snowyfox/Nibbles/wled/README.md

# Nibbles WLED integration

The shark's other lights run stock **WLED**, not a fork. Nibbles adds one
usermod, `usermod_nibbles/`, built into WLED through PlatformIO's
`custom_usermods` from this folder. It uses the same protocol library as the
eyes and base (`shared/nibbles_link`).

## What the usermod does
- **Turns ESP-NOW on** at startup (WLED defaults it off) and acts as the
  **channel anchor**: it broadcasts anchor heartbeats 4 times a second on
  whatever channel WLED is on (a phone hotspot at home, its own AP at a
  festival). The eyes and base scan until they hear one and move to the
  channel it advertises.
- Takes Nibbles **commands aimed at WLED** (`NL_TARGET_WLED`: preset set,
  next, previous; brightness set 0..255 or step by a signed amount) and acks
  them. A retry with the same id is acked but applied once.
  The ack goes out before the preset is applied. Which presets exist is cached
  from `/presets.json` (re-read when WLED saves presets), so next/previous skip
  gaps and wrap, and a missing preset is refused (status 2).
- Plays **bumps** (`NL_MSG_BUMP`, broadcast): flash (all segments solid white),
  blackout, or a preset, held while the sender keeps sending HOLD every 100 ms.
  On STOP, or 300 ms without a message, it restores the state (and current
  preset) saved at the start. A new bump replaces the one playing and keeps the
  original saved state. Preset and brightness commands that arrive during a bump
  are applied when it ends (instead of the saved preset), so the release
  doesn't undo them (verified: preset and brightness sent mid-flash took effect
  on release). With the 2D map, flash and blackout use the bump slot instead
  (see "Layer slots"): nothing is saved, and preset commands apply at once.
- Broadcasts **WLED telemetry** twice a second (on, brightness, preset and its
  name, effect, palette, channel, fps, LED count). Preset names come from the
  same cached read of `/presets.json` as the preset list.
- Shows the radio status and the **eyes' telemetry on WLED's Info page**.
- Leaves other ESP-NOW traffic (e.g. WiZ remotes) to WLED.
- With the `audio` setting on, publishes **AudioReactive's analysis** of the
  controller's mic as Nibbles audio features every 32 ms (`nl_ar_update`), for
  eyes built with `EYES_AUDIO_FROM_WLED 1`. The Info page shows whether it is
  sending. Untested on real music so far.
- **Mirrors the lights to the simulator** (`tools/sim`) on request: a JSON
  state post `{"nibbles":{"mirror":{"ip":"a.b.c.d","port":4050,"s":6}}}`
  starts it for `s` seconds (at most 30; `s: 0` stops it), and `server.py`
  renews it every 2 s while the page shows the live shark. Each shown frame
  goes to `ip:port` as DDP (gamma and brightness applied; the current
  limiter's extra dimming is not), at most 50 a second, and a small JSON
  packet to `port + 1` with WLED's brightness and preset, the audio features
  it last sent the eyes, and the eyes' telemetry. It works even with the
  usermod disabled, and costs nothing when not asked for. Bench-tested on
  the WT32 build: identical to the bench's own network LED output, 44
  frames/s, WLED's frame rate unchanged (43 fps), 10-minute soak clean. On
  the real controller since 2026-09-26 (42 frames/s to the simulator).
- **Battery-aware current limit**: the base broadcasts the pack voltage at the
  pole base (`NL_MSG_BATTERY`, from an INA226 there), and WLED's global
  current limit follows it (`nl_power_limit_ma`): the most power that keeps
  the 5 V converter's input above `floor_mv` (11.2 V) after the pack's sag
  and the pole wiring's drop (`pack_mohm` 100, `wire_mohm` 200, estimates to
  replace with measurements). A lower limit applies at once, a higher one
  rises at 2 A/s; without new readings the last limit holds. The ceiling is
  the usermod's `power_max_ma` (17000), which takes over WLED's own limit
  field while `power` is on; until the first reading the limit is that
  ceiling. Test readings: `{"nibbles":{"battery":{"mv":13000,"ma":7700}}}`
  (`"mv":0` forgets). The Info page shows "Nibbles power". Bench-tested
  (2026-10-02): 14.0 V -> 17000 mA, 13.0 V -> 12096, 12.5 V -> 8735 at once,
  back to 14.0 V in ~5 s; on the bench board (network output only) WLED's
  limiter doesn't dim, so the dimming itself is untested.
- **2D map partners**: with the shark's 2D map (below) it copies each partner
  LED's colour from the LED it pairs with after every frame (the `"copy"`
  list in `/ledmap.json`). The Info page shows how many ("Nibbles 2D map").
- **Fin following on/off**: `NL_OP_FIN_FOLLOW` (the base's FINS switch on its
  preset page, or `fins on|off|toggle` on its serial port; also
  `{"nibbles":{"finfollow":false}}`) switches it off: the fins then stay at
  their modelled angle, ignoring the sensor and any sweep. Saved in WLED's
  config (`fin_follow`). WLED broadcasts `NL_MSG_FIN_STATE` twice a second
  (on/off, the angle in use per fin and where it comes from) for the base.
- **Fins that follow their real angle** (2D): with a fin sensor node sending
  the fin's hinge angle (`NL_MSG_FIN_POSE`, `firmware/fins`), each of that
  fin's LEDs shows the side view's colour at the spot it is really over, so
  a wave across the body sweeps over the fin wherever it points. The fin
  geometry (rest positions, hinge lines, the grid's scale) is the `"fingeo"`
  list in `/ledmap.json`; a fin without a live angle keeps its partner copy.
  On the shark since 2026-10-21 (port fin): 112 of 114 port fin LEDs showed
  exactly the colour of the cell they were over.
- **Streamed pictures** (since 2026-10-23): while this WLED shows another
  WLED's stream instead of its own effects (WLED's realtime mode: DDP,
  E1.31, Art-Net), it times the gaps between incoming packets
  (`nl_stream_gaps`): "slow" gaps of 50 ms or more, "stalls" of 100 ms or
  more, and the longest, over the last minute, plus stalls since boot. A gap
  of 2 s or more is the stream restarting and isn't counted. Shown on the
  Info page ("Nibbles stream") and broadcast once a second
  (`NL_MSG_WLED_STREAM`); the base's WLED card then says "Streamed", where
  from, and the stalls per minute. See "Main board and display" below.
- **ES7210 mic** (builds with `NIBBLES_ES7210`, the 3.49 dev node): sets up
  the board's ES7210 mic chip over I2C (SDA 47, SCL 48) once AudioReactive's
  I2S clocks run, so AudioReactive can use the board's own mic as "Generic
  I2S with MCLK" (SD 6, WS 46, SCK 15, MCLK 7). Mics 1 and 2 at 30 dB; the
  board's mic is input 1, the left channel, so that build also sets
  `I2S_USE_RIGHT_CHANNEL`, which undoes AudioReactive's IDF 4.4 channel-swap
  work-around (meant for the classic ESP32; on the S3 it made AudioReactive
  read the empty input). The Info page shows "Nibbles mic (ES7210)". Checked
  by tapping the board: the level rose from 4-14% to 40-72% with automatic
  gain off. The level from music is low (about 10% before the automatic
  gain); squelch 3 and AGC "vivid" work.
- **Wire link** (`wire_pin`, `wire_baud`): the brain sends every LED down a
  UART wire to the controller, which shows it like a stream; see "Wire link"
  under "Main board and display".
- **Preview stream** (`preview`, default off; `preview_fps`, default 12; or
  state `{"nibbles":{"preview":true}}` until the next reboot): broadcasts the
  LEDs as RGB332 before master brightness for `firmware/preview`
  (`NL_MSG_PREVIEW`, 5 packets a frame for 1064 LEDs, one packet per loop).
  WLED's ESP-IDF only sends 250-byte ESP-NOW packets, so `NL_MAX_PAYLOAD` is now
  232. Tested 2026-11-01 on the bench brain: it stays at 43 fps. Most frames
  were lost there, but the brain was hopping channels looking for the
  controller's network (seen on 1-14 within a minute); not yet measured on a
  stable channel.
- Settings (WLED Usermods page, `Nibbles`): `enabled`, `anchor`, `audio`
  (default off), `wire_pin` (default -1, off), `wire_baud` (default 2000000),
  `preview` and `preview_fps`.

## 2D map
`wled/ledmap/ledmap.json` (made by `tools/sim/make_ledmap.py` from the
simulator's layout; preview in `ledmap_preview.svg`) makes WLED treat the
shark as a 68 x 33 matrix (cells of 11.3 mm; a 55 x 33 side view plus the fin
panel), seen from starboard with the nose to the right, for WLED's 2D effects.
It was 95 x 41 (8.9 mm cells) until 2026-10-29; the coarser grid makes every
effect and segment layer about 1.5x cheaper (`wled/bench/README.md`). Seen from the side, LEDs overlap: the two strips back to
back in the main tube, and the two fins. So only the outward strip (channel 1)
and the starboard fin (channel 5) are mapped where they are (90% within 1.7
cells of their real spot); the inward strip and the port fin sit in spare
cells nearby, and the usermod copies each one's colour from its partner, so
both sides match. The fins stick out sideways, so from the side each is a compact patch.

To use it: upload the file as `/ledmap.json` (WLED's file editor, or
`curl -F "data=@wled/ledmap/ledmap.json;filename=/ledmap.json" http://IP/upload`)
and reboot. **WLED then runs as a 2D matrix for every preset**: 1D presets
(segments by strip position) need redoing for 2D; a 2D segment covering the
body is `{"start":0,"stop":55,"startY":0,"stopY":33}` (the bottom five rows
are where a fin swung down reaches). On 2026-10-29 every 2D preset was
converted from the 95 x 41 grid (body 0-70 x 0-41 to 0-55 x 0-33, fin panel
70-95 x 0-34 to 55-68 x 0-18; backup in `wled/backup/`), and the one-segment
body presets now also remove segments 2-8, so layers left by another preset
don't stay on under them (segment 1, the fins, is left alone).
WLED keeps `presets.json` in memory and, with no clock (NTP off), may not
notice an uploaded file: restart it after uploading presets. Then reload
WLED's web page in every browser that has it open: clicking a preset there
sends the preset's whole content from the page's own copy (kept in the
browser's local storage), so a stale page keeps applying the old presets. Delete the
file and reboot to go back.

Bench (2026-09-26, same firmware and map): the partner copies match exactly
(0 of 531 differ), the eye rings stay dark; most 2D effects run at 43 fps
(Octopus, Noise2D, Waverly, Black Hole), Plasma Ball 40, Distortion Waves 24;
the matrix costs 4-9 KB of RAM. **On the shark's controller since
2026-09-26** (with the lean build): 42 fps, 83 KB free; while the simulator
mirrors it, 33 fps and 25-30 frames/s to the simulator. Its 1D presets don't
work in 2D (see above); to go back to 1D, follow
`wled/backup/20260926-1850-pre-2d/REVERT.md` (delete `/ledmap.json`, reboot;
tested on the bench).

## Fin presets (2026-10-28; tested on the bench as main board)

The fins can run their own effect while the body keeps its preset. The map
(`tools/sim/make_ledmap.py`) has a **fin panel**, 13 x 18 cells of 20 mm, to
the right of the side view (columns 55-67). The body's segment stays on
columns 0-54. (Until 2026-10-29: 25 x 34 cells of 10 mm at columns 70-94.)

- **The panel's first cell is mapped to a real LED** (LED 863 on the 68 x 33
  map, 866 on the old one; its own
  cell comes much later, so it always shows its own colour). WLED works out
  what a segment can do from the LEDs under it: a segment over no LEDs at
  all is on/off only, ignores palettes and draws most effects black (seen
  2026-10-28: Plasma black, `"lc":0`, palette stuck at 0). With the
  anchor, the fin segment shows `"lc":1` and keeps its palette.
- **Body presets should use only segment 0.** Presets 3 and 5 are older
  multi-segment presets from the 1D controller (segments 1-4 are stretches
  of the strip); they barely light the fins, and "follow the body" (80,
  which removes segment 1) takes part of their body away.

- **Fin presets** are WLED presets **81-96** (fin preset 1-16 on the
  base's keypad; `NL_FIN_PRESET_BASE` in `shared/nibbles_link`). Each one
  is a segment on the fin panel, saved with **only that segment checked**
  ("Checked segments only" in WLED's save dialog, segment bounds on,
  brightness off), so it leaves the body alone. Bounds:
  `{"id":1,"start":55,"stop":68,"startY":0,"stopY":18}`.
- **Preset 80** = the fins follow the body: a preset that only switches
  that segment off (`{"seg":[{"id":1,"stop":0}]}`).
- **Body presets** saved the normal way (all segments) switch the fin
  segment off, so they put the fins back to following the body; save them
  with only the body segment checked to keep the fins' preset.
- **Projection**, per fin preset: add `"nibbles":{"finproj":"side"}` or
  `"top"` to the preset's JSON (WLED's preset editor, API mode).
  - **Side:** the panel is the fins seen from starboard, like the side
    view; at equal angles both fins land on the same cells.
  - **Top:** seen from above, nose to the right, port in the upper half and
    starboard in the lower.

  Either way each fin LED's spot moves with the fin's hinge angle (or sits
  at the modelled angle while FIN SENSOR has it locked).
- **The usermod:**
  - reports the body's preset in its telemetry and the fins' in
    `NL_MSG_FIN_STATE` (`fin_preset`, `fin_proj`);
  - runs fin bumps (`NL_TARGET_FINS`) beside body bumps;
  - puts the fins' preset back after a body bump;
  - queues its own preset applies (WLED keeps only one waiting).
- **Where:** on the main board (see "Main board and display"); the display
  stays 1D.

## Layer slots (2026-10-29; tested on the bench as main board)

WLED 16 stacks segments that overlap: each one is blended over the ones with
lower numbers (blend mode `bm`, opacity `bri`). The usermod uses five fixed
segments as layers:

| Slot = segment | Name | Covers | Default blend |
|---|---|---|---|
| 0 | body | the side view (0-55 x 0-33) | top |
| 1 | fins | the fin panel (fin presets) | top |
| 2 | body+ | the side view | screen |
| 3 | fins+ | the fin panel | screen |
| 4 | bump | the whole grid | add (flash and blackout set top) |

Set one with `{"nibbles":{"slot":{...}}}` in a JSON state request (or a list of
them):

- `"id"`: the slot.
- `"look"`: a preset's effect, speed, sliders, palette and colours (its
  main segment) go into the slot. Its position, blend and on/off don't.
- `"fx"`, `"pal"`, `"col"`, `"sx"`, `"ix"`, `"c1"`-`"c3"`, `"o1"`-`"o3"`:
  set directly. These go on top of a `look` in the same request.
- `"bm"` blend mode, `"o"` opacity (1-255), `"tt"` transition (ms),
  `"on"`. Setting a look or effect switches the slot on unless `"on":false`
  says otherwise.
- **A slot that's off is frozen**, so it costs nothing. `"warm":true` keeps
  its effect running while it's off: it then shows at once, already in
  motion, but costs a full render every frame (`wled/bench/README.md`).

Asking for a slot creates any missing slots below it, off and frozen, so slot
n is always segment n. The state reports the slots as
`"nibbles":{"slots":[...]}` (on, effect, palette, blend, opacity, the preset
whose look it took). The Info page shows them under "Nibbles layers", with
the outcome of the last request.

**Presets and slots:**
- A full preset is a scene: it sets the whole stack.
- The one-segment body presets switch slots 2-8 off and leave the fins
  (slot 1) alone, as fin presets need.
- Old 1D presets with several segments use segments 1-7 for stretches of
  the strip, so slots don't fit on top of them.
- Slot changes made by request count as manual changes, so WLED shows no
  current preset after one.

**From the base** (radio, `shared/nibbles_link`):
- **Commands:** `NL_OP_SLOT_LOOK` (`nl_slot_arg(slot, preset)`; preset 0
  switches the slot off) and `NL_OP_SLOT_PALETTE` (`nl_slot_arg(slot,
  palette)`).
- **Bumps:** `NL_BUMP_PALETTE` and `NL_BUMP_LAYER` show a palette or a layer
  look while held. On release the slot goes back exactly as it was: every
  look field, the blend, opacity, on/off, and the look's preset number.
  - Body slots use `NL_TARGET_WLED` bumps, the fin slots `NL_TARGET_FINS`,
    so the two can be held together.
  - A slot command for a slot that a bump holds becomes what the slot goes
    back to. That's how the base's LATCH keeps one: it sends the command,
    then lets the bump go.
  - If a body preset lands during a palette or layer bump, the slot goes
    back to that preset's version instead.
  - `NL_BUMP_SCENE` (2026-10-30; the base's TAKE preview of a Standby with
    a palette or layer look cued): a preset, a palette and a layer look
    together. `arg = nl_scene_arg(preset, layer)` (preset 0 leaves it;
    layer 1-16 a layer look, `NL_SCENE_LAYER_OFF` off), `intensity` =
    palette + 1 (0 leaves it). On `NL_TARGET_WLED` it's the body: saved like
    a preset bump (plus the overlay slot, which a state restore wouldn't
    remove), the preset, then slot 0's palette and slot 2's look. On
    `NL_TARGET_FINS` it's the fins: slots 1 and 3 captured, the fin preset
    (as a preset), then their palette and look; both slots put back
    exactly. Commands during it (LATCH) are what it ends on.
  - Slot requests wait while a preset is queued or still landing, so a
    preset never wipes a palette or layer look sent after it.
- **Report:** `NL_MSG_WLED_LAYERS` reports every slot twice a second (on,
  look, effect, palette, blend, opacity). The mirror to the simulator
  carries the same as `"slots"`.
- **Layer looks** are WLED presets 101-116 (`NL_LAYER_PRESET_BASE` + n).
  Each is saved as one segment, id 2, with `"mainseg":2`. Its effect,
  sliders, palette and colours are the look. The bench has 101-108 (Twinkle,
  Sparkle, Fireworks, Crazy Bees, Lissajous, Drift Rose, Black Hole,
  Lightning): effects that are cheap and start at once (`wled/bench/`),
  each with its default sliders, white on black, blend screen.

**Bumps:**
- **Flash and blackout** use the bump slot: Solid white (or black) on top.
  A flash also raises WLED's master brightness to its intensity while
  held.
- Nothing is saved or restored, and commands during them apply at once. A
  brightness command during a flash takes effect when it ends.
- If a body preset lands during the bump, the bump slot comes straight back.
- **Preset bumps** still save and restore the whole state, as before.
- **Keys swapped quickly** (fixed 2026-11-09, on both brains, bench-tested):
  ending a bump could leave its look behind, as if LATCH had been pressed.
  - A preset bump's preset waits in the usermod's preset queue, and WLED
    applies a preset a loop after it's asked. If the bump ended first, the
    preset landed over the restore. Bump presets are now tagged in the
    queue and dropped when the bump ends. If one is already on its way, the
    restore is applied again once it has landed.
  - A palette or layer bump that replaced another on the same slot captured
    the slot while it still showed the old bump, because the old bump's
    restore was still queued. It now takes over that queued restore instead.
  - A preset bump replacing a palette or layer bump applies that bump's
    queued restore before it saves the state. The same now goes for a flash
    or blackout: holding FLASH, pressing a number, letting go of FLASH and
    then the number left the flash (or blackout) on, because the number's
    snapshot still held it. A flash that ends before it showed is also
    dropped from the slot queue.
  - Bench test (shark off, brains on USB): keys sent through the MIDI
    bridge's `/api/key`, each brain's state read back over its serial
    port with `{"v":true}`, and compared before and after each sequence.
    Fixed overlaps at 250, 100 and 40 ms plus 30 random sequences of 24
    presses over numbers, palettes, layers, flash and blackout: 51 of 51
    came back to the starting state. Opening a brain's USB serial port
    restarts it, so hold the ports open for the whole run.
  - The base's key logic was checked with 5,000 random overlapping key
    sequences (`test_overlapping_keys_never_latch`): it always ends every
    bump and never latches.

## Eye settings in presets (2026-10-28; the usermod part not yet built or tested)

A WLED preset can carry the eyes' settings, so the preset is the one place a
whole look is defined. Add to the preset's JSON (WLED's preset editor, API
mode) either:

- **Level 1**, pick the eyes' own settings:
  `"nibbles":{"eyes":{"preset":5,"react":"beats","auto":false}}`
  - `preset` is 1-based; `react` is `preset`, `beats` or `peaks`.
  - The usermod sends them to the leader eye as commands.
- **Level 2**, the whole eye look:
  `"nibbles":{"eyes":{"look":{"name":"Inferno","palette":[[140,0,0],...],"rings":7,...}}}`
  - The look carries every setting of an eye preset: palette, rings, bands,
    glow, flow, pupil, ripples and spiral.
  - `make -C firmware/eyes/test/host looks` prints all 18 built-in eye
    presets in this form, ready to paste and edit.
  - The usermod broadcasts the look (`NL_MSG_EYE_LOOK`, three times). The
    leader eye shows it behind its usual swap blink and passes it to the port
    eye over the cable.
  - Looks fill two slots after the built-in presets (indices 18 and 19,
    alternating), so the base sees eye presets 19 and 20 with the look's
    name.
  - Spirals snap to the nearest built-in spiral shape (3 or 5 arms), whose
    maps are built at boot.
- `react` and `auto` can go with either level.

When the eye settings apply:
- **Apply:** a preset applied from WLED's own UI, or from the base with
  **ALL** + number (the whole shark).
- **Skipped:**
  - **BODY** + number (the base sends `NL_PRESET_NO_EYES`);
  - bump presets, which the base bumps on the eyes separately;
  - fin presets.

## Main board and display (the plan since 2026-10-28; first tested 2026-10-23)
The controller (a classic ESP32 without PSRAM) renders the 2D map at only
~38 fps with ~70 KB free. So a faster **main board** renders everything and
streams every LED (DDP, physical LED order) to the controller, which only
displays them. **The main board is the brain**: everything Nibbles-specific
runs there; the controller is a display.

- **Main board** (first the bench 3.49: MAC 80:45:6b:35:d0:14,
  `nibbles_dev_s3_349`, at 4.3.2.2 on the controller's network; since
  2026-11-02 that board is the base, its WLED flash saved in
  `wled/backup/20261102-bench349-pre-base/`, and the brains do this job):
  - the shark's config and presets, the 2D map with the fin panel, fin
    presets, and the presets' eye settings;
  - one network LED output of 1064 LEDs (DDP) to 4.3.2.1;
  - its own mic (ES7210 above);
  - the Nibbles usermod **on**, in its normal role: it anchors the radio
    and talks to the base, the eyes and the fin node; telemetry, commands,
    bumps, fin following, fin presets, eye looks, and the simulator mirror.
- **Display** (the real controller, 4.3.2.1, its own AP "Nibbles"):
  - no `/ledmap.json` (1D). WLED writes incoming realtime pixels into its
    frame buffer by cell and then through its own ledmap, so with a ledmap
    the stream comes out scrambled.
  - The usermod has **`display` on** (`{"um":{"Nibbles":{"display":true}}}`):
    it only listens for the base's battery readings, so the battery-aware
    current limit protects the LEDs it drives. It reports how steadily the
    stream arrives (`NL_MSG_WLED_STREAM`, and its Info page). No anchoring,
    telemetry, commands or bumps, so the base sees one WLED, the main board.
  - It falls back to its own effects 2.5 s after the stream stops (WLED's
    realtime timeout).
- **Brightness:** the base and the eyes follow the main board's
  brightness, which is applied before the stream. The display stays at its
  own brightness, with the current limit on top.
- **The base:** its WLED card shows the main board's preset. While the
  display reports a stream, the card's second line shows its stalls per
  minute and longest gap.
- **The simulator:** mirror the main board (4.3.2.2), which has the whole
  picture and the usermod's state.
- **Tested 2026-10-28:** with the bench as main board and the controller as
  display, the base's keys work end to end (fin presets, LATCH, ALL bumps,
  FLASH) and the display streams with 0 stalls a minute.
- **Back to the single board:** set `display` off on the controller, put its
  ledmap back, and stop the main board's stream.
  Backups: `wled/backup/20261028-pre-display-role/`.

Measured: the main renders the controller's preset 33 at 124 fps uncapped
(vs 38), with 194 KB free plus 8 MB PSRAM; the display shows 50-55 fps at a
50 fps cap, with 94 KB free (no ledmap). Over the home Wi-Fi (main -> router
-> controller, two hops): every frame arrived complete, but about 3 stalls
a minute of 100-200 ms, which the user saw as freezes. On the shark's own
network (the controller's AP "Nibbles", channel 1, the main joined to it,
one hop): the user noticed no stutter; the stall counter above gives the
numbers. A wired link (both boards in one box, a short Ethernet cable) would
take the stream off the air entirely; the main board then needs Ethernet
that WLED supports (classic ESP32 with RMII, e.g. Olimex ESP32-POE-ISO-WROVER;
WLED 16 has no W5500 support, so not the ESP32-S3-ETH).

Access point notes:
- The controller's AP is "Nibbles" with WLED's default password `wled1234`
  (to change before a festival). AP only: `ap.behav` 2 (always) and the
  Wi-Fi network set to "Your_Network", WLED's "none" (an empty name is
  ignored). Clients get 4.3.2.2 upwards in join order.
- WLED's captive portal makes phones and Macs treat the AP as a login
  network; choose "use without internet" to stay joined.
- OTA updates over the AP need `ota.same-subnet` off (set on the controller):
  with it on, WLED compares the client with its station address, which is
  empty in AP-only mode, and refuses ("Client is not on local subnet").
  Off, it still only accepts private networks, its AP included.
- Backups and how to go back: `wled/backup/20261023-2153-pre-main-stream/`
  (REVERT.md: ledmap back), `20261023-2323-pre-ap-test/` (both boards'
  Wi-Fi), `20261023-*-pre-stream-gaps/` (before the stall counter build).

### A/B brains (built 2026-11-01; running on real boards the same day)
Two brains each send the controller a full picture; TAKE on the keypad switches
which reaches the LEDs. Settings (`{"um":{"Nibbles":{...}}}`):

Tested on the bench over real wires, with no pull-ups fitted as far as known and
no LEDs confirmed attached: both wires 42-44 fps at once, take, hold, a 1.5 s fade
(accepted; not seen on LEDs), failover when the Live brain stopped (survivor still
42-44 fps), and the stopped brain rejoining as Standby. Lost-frame and CRC counts
(controller Info page): none new in a 9-minute soak, no LEDs attached as far as known.
Both brains send the preview (`NL_MSG_PREVIEW`, 12 fps), whatever `preview` says; the base
sorts them by role into its Live and Standby sharks.

| Board | Settings |
|---|---|
| Controller (`nibbles_shark`) | `display` on, `wire_pin` Right Brain's wire, `wire_pin_b` Left Brain's: 35 (H3) and 34 (H2) as now wired, which must match each brain's `ab_side`; the mic stays on H1 |
| Right Brain (`nibbles_brain_s3`) | `wire_pin` its TX pin, `ab_side` 0 |
| Left Brain (`nibbles_brain_s3`) | `wire_pin` its TX pin, `ab_side` 1 |

- **Wiring:** each brain's TX and a GND to the controller. Never 3.3 V or 5 V between
  boards. GPIO 34 and 35 are input only with no internal pull-up: each needs its own
  10 kOhm pull-up to the Bong69's 3.3 V (H1 has it). Pin order on H2 and H3 isn't
  documented, so measure before connecting; H4 carries 5 V.
- **The presets must match on both brains**, by number: copy `presets.json`, the
  ledmap and the settings across.
- **On the Info page:** "Nibbles wire" shows both wires, which brain is Live, takes and
  failovers on the controller, and "Right Brain, Live" or similar on a brain.
- **Testing without the base:** `{"nibbles":{"abtake":0}}` (a value in ms is a
  crossfade) and `{"nibbles":{"abhold":true}}` to the controller's `/json/state`.
  From the base's USB serial: `ab`, `ab take [MS]`, `ab hold on|off`.
- **Not carried across yet:**
  - eye settings in a preset on the Standby brain (the base sends it with
    `NL_PRESET_NO_EYES`; Standby's eye preset still changes with TAKE);
  - nothing else for now; audio is below.
- **Audio:** the controller's mic on H1 feeds both brains through AudioReactive's sound
  sync over the `Nibbles` Wi-Fi: `um.AudioReactive.sync.mode` 1 (send) on the controller,
  2 (receive) on each brain. The controller's usermod makes its access point lwIP's default
  route (`apDefaultRoute`), or the multicast goes nowhere. Both brains report "receiving";
  delay and reaction to music aren't measured yet.
- **Relay (built 2026-11-01):** each brain passes what the controller needs down its wire,
  between the picture's chunks (`nl_relay_*`): battery readings, A/B bumps, and takes, which
  the base now sends to the Live brain (then Standby, then the controller's own radio) as
  "make that brain Live" (`NL_OP_AB_TAKE_A`/`_B`), so a second route can't undo the first.
  The brain's ack means "on its way"; the result shows in `NL_MSG_AB`. The controller's
  `radio_off` setting ignores its radio input and only takes these. Its radio still sends
  `NL_MSG_AB` and the Wi-Fi network; turning those off needs a wire back to the brains.
- **Return wire (built 2026-11-02):** one wire from the controller's GPIO 17 (H1, freed by
  moving the mic's SD to GPIO 39: `digitalmic.pin` `[39, 32, 33, -1]`) to GPIO 14 on both
  brains, setting `ret_pin` (17 on the controller, 14 on each brain; GPIO 10 until 2026-11-09).
  It runs on the UART of the controller's first input, at the same baud, in the relay
  framing with the controller's MAC: `NL_MSG_AB` (2 Hz and on a change) and
  `NL_MSG_AR_SYNC` every 20 ms, AudioReactive's own v2 sync packet built from its
  analysis. A brain hands that to its own AudioReactive on 127.0.0.1:11988, so its sync
  mode stays 2 (receive). The controller's sync mode must stay 1 (send): in any other mode
  AudioReactive stops listening while the wires drive the LEDs. A `ret_pin` that can't
  start (pin taken, or wire A down) is not retried until the setting changes.
- **Changing settings with `/json/cfg`:** send the whole `um.Nibbles` block too. A POST with
  `um` but no `Nibbles` resets every Nibbles setting to its default, live and on flash.
- **With one brain** leave `wire_pin_b` at -1 and `ab_side` at -1: exactly as before.
- A controller reboot starts with Right Brain Live.
- **Controller radio off, Right Brain hosts `Nibbles` (built and tested 2026-11-02):**
  - **Controller** `wifi_off`: at boot the usermod hides its network to join (in RAM; the
    saved settings keep `Nibbles` and its password) and ESP-NOW stays off, and its own
    access point is "button only" (`ap.behav` 3; the Bong69 has no button), so after WLED's
    ~2 s boot scan the radio never starts. Everything comes through the wires. The base's
    `wled wifi on` (USB serial only), a brain's `{"nibbles":{"ctlwifi":true}}`, or the buttons
    on a brain's Info page send `NL_OP_CTL_WIFI` down a brain's wire: the controller joins
    `Nibbles` (web page, OTA) until it restarts or gets `wled wifi off`. Tested: it joined at
    4.3.2.3 with both wires running, and left again.
  - **Right Brain** hosts `Nibbles` on channel 1 (no network to join, `ap.behav` 2, the network's
    name and password as its access point) and anchors the channel.
  - **Left Brain** joins it; its own access point is `Nibbles` on channel 1 too, `ap.behav` 3, and
    `net_fallback` on: after 6 s without the network it hosts `Nibbles` itself (rather than
    search every channel), and joins again once it hears A's anchor heartbeat (at least
    10 s later). A brain sends the anchor flag only when joined or hosting, never while
    searching. Tested by pausing A: the controller failed over at once, B hosted after
    6 s, the base was off channel 1 for about 10 s in between, and B rejoined A within 10 s
    of A's restart, with A back as Standby.
  - **The brains rebroadcast `NL_MSG_AB`** from the return wire, so the base sees the switch
    without the controller's radio. TAKE, hold and fade tested this way.
  - While B hosts, its WLED settings show no network to join: don't save its Wi-Fi settings
    then.
  - **Network moves** (2026-11-09, on both brains, bench-tested): the base's survey page
    broadcasts `NL_HOP_MOVE` (channel, moment). At that moment the host (no network to join,
    or B standing in) sets `apChannel` and reconnects, so its access point and ESP-NOW restart
    on the new channel; a joined brain sets `apChannel` too and reconnects 1.5 s later. The
    channel is saved (B saves it only once its network to join is back in the settings), and
    for 20 s B doesn't stand in as host. Phones on `Nibbles` drop and rejoin.
    Bench: 1 -> 6 -> 1 with both brains and the base; A hosted on the new channel 1.1 s after
    the tap, the base kept hearing WLED throughout, B (restarted just before by its USB port
    opening, so it missed the hop) found A on the new channel by itself within 5 s.

### Wire link (built 2026-10-30; sending tested, receiving not yet)
The plan (`docs/architecture.md`, "Two brains and the Standby preview") puts
the brains in the controller's box on top of the pole, each wired to the
controller, so the picture never crosses the air.

- **Brain:** set `wire_pin` to its TX pin (`{"um":{"Nibbles":{"wire_pin":13}}}`
  on a `nibbles_brain_s3` board). Every frame WLED shows, the usermod sends
  what its **network LED output** would send (that output's buffer, at the
  brightness it applies) out of the pin, in `nl_pix_*` chunks (256 LEDs each,
  COBS + CRC-16; `shared/nibbles_link`), at 2 Mbaud. 1064 LEDs is 3,257 bytes
  a frame, 16 ms on the wire, so up to ~60 fps. While nothing new is shown
  (off, frozen) it resends every 200 ms, so the controller doesn't time out.
  The network output stays configured (it defines the LEDs): point it at
  `0.0.0.0` to send nothing over Wi-Fi (WLED skips the send), or leave it on
  the controller as a Wi-Fi backup (both arrive; the controller shows
  whichever came last, the same picture).
- **Controller:** with `display` on, `wire_pin` is its RX pin: GPIO 34 on the
  Bong69's H2 (input only, so a 10 kOhm pull-up to its 3.3 V;
  no internal pull-up). Chunks go into WLED's realtime path like DDP
  (`realtimeLock`, `setRealtimePixel`, shown on the last chunk), so the
  realtime timeout, the current limiter and the stall counter keep working.
  A corrupt chunk only costs its own LEDs for one frame.
- **Wiring:** data and GND only, never 3.3 V or 5 V between the boards.
- **Info page** ("Nibbles wire"): on the brain, fps, LEDs and the time
  sending takes; on the controller, fps and, since boot, frames, lost frames,
  partial frames, CRC errors and bad chunks.
- **Measured** on the bench brain (3.49, sending on GPIO 2, 1064 LEDs):
  - **Cost:** 1.0 ms a frame (0.3 gathering, 0.6 encoding, 0.15 handing to
    the UART driver). The frame rate stayed at 43 at the 42 cap, and the
    heavy DreamState Clouds went from 24 to 23 fps. With the bitwise CRC it
    was 1.8 ms, so `nl_crc16` now uses a table (same values; the eyes and base
    use it too).
  - **Receiving:** a temporary loopback test, with a second UART on the brain
    listening on the same pin. With the UART driver's default (an interrupt
    when the 128-byte FIFO holds 120 bytes, 40 us before it overflows at
    2 Mbaud), about 1 chunk in 1500 was lost to Wi-Fi interrupt delays. With
    the receiver emptying it from 32 bytes: 0 lost, partial or corrupt in
    7,200 frames, also at 22 fps on a heavy preset. The receiver uses 32.
  - **Not yet tested:** the controller (classic ESP32) receiving over a real
    wire. Needs a brain board with reachable pins (the DevKits are ordered).

## Lean build
`nibbles_shark` leaves out features the shark doesn't use: Ethernet (it runs
on Wi-Fi; Ethernet was already off in its config), Alexa, Hue sync, MQTT,
infrared, Loxone and the Pixel Forge tool. That saves 82 KB of program space
(1.25 MB of the 1.5 MB app slot used, ~318 KB free) but only ~1.3 KB of static
RAM and 1.5-3 KB of free heap on the bench: most RAM goes to Wi-Fi,
AudioReactive, WLED's JSON buffer and the LED buffers, which these flags
don't touch. The release name stays "ESP32_Ethernet": WLED 16 refuses an
over-the-air update whose release name differs from the installed one.

## Building
Tested with **WLED v16.0.1**, PlatformIO 6.2.0 and Node.js 20 (WLED's web UI
build needs a current Node; the system Node 8 is too old).

```sh
git clone --depth 1 --branch v16.0.1 https://github.com/wled/WLED.git WLED-16
cd WLED-16
ln -s /Volumes/Code/Nibbles/wled/platformio_override.ini platformio_override.ini
npm ci
NIBBLES_ROOT=/Volumes/Code/Nibbles pio run -e nibbles_dev_s3_349            # build
NIBBLES_ROOT=/Volumes/Code/Nibbles pio run -e nibbles_dev_s3_349 -t upload --upload-port /dev/cu.usbmodemNNN
```

`platformio_override.ini` defines:
- `nibbles_dev_s3_349`: a development node on a Waveshare
  ESP32-S3-Touch-LCD-3.49 (16 MB flash, 8 MB octal PSRAM). LED data on GPIO 2,
  button on BOOT (GPIO 0), no relay or IR, `NIBBLES_DEBUG` on (a status line
  over USB serial every 5 s, and one per command). AudioReactive is included
  (WLED's default for this env), with the board's own mic (`NIBBLES_ES7210`).
- `nibbles_brain_s3`: a brain on a Waveshare ESP32-S3-DEV-KIT-N16R8
  (16 MB flash, 8 MB octal PSRAM, on-board antenna): wire link TX on GPIO 13 and the return wire on GPIO 14 (17 and 10 until 2026-11-09),
  an I2S mic (e.g. INMP441) on SD 4, WS 5, SCK 6 as AudioReactive's default,
  the board's RGB LED (GPIO 38) as the default LED output. Built, not yet run
  (the boards are on order).
- `nibbles_shark`: the real controller (below).
- `nibbles_shark_eth`: `nibbles_shark` with Ethernet (the WT32-ETH01's
  LAN8720), for a wired stream from a main board. Built, not installed. WLED
  switches Wi-Fi off, and with it ESP-NOW, when Ethernet connects, unless its
  access point is running (`network.cpp`, `if (!apActive) WiFi.disconnect(true)`).

Build notes:
- The usermod's library name must start with `wled-` (`wled-nibbles`) or be
  given as `wled-nibbles = symlink://…`, or WLED's build script won't treat it
  as a usermod and `wled.h` won't be found.
- `shared/nibbles_link/library.json` makes the protocol a PlatformIO library;
  WLED builds with `lib_compat_mode = strict`, so it declares all frameworks
  and platforms.

## The shark's real controller
A **Bong69 8 Port LED Distro v3** (https://github.com/bobko69/8PortLEDDistro):
an ESP32 module soldered flat to the board, not a plug-in WT32-ETH01 as first assumed (seen in photos 2026-11-01; WLED's WT32-ETH01 Ethernet setting still applies. Classic ESP32, 4 MB flash, no PSRAM; LAN8720 clocked by an
external oscillator on GPIO 0, so ESP-NOW is safe; Ethernet is off in its
config anyway). Read on 2026-09-24 at 10.7.200.253: WLED 0.15.1
"ESP32_Ethernet" release, 1194 LEDs on 5 WS281x outputs (config pins 1-5, matching the board's silkscreen: channels 1-5 = GPIO 1-5, channels 6-8 = GPIO 12, 14, 15 (unused); all working;
**outputs changed 2026-09-27, see "LED outputs now" below**),
button on GPIO 0, AudioReactive with an I2S mic (SD 17, WS 32, SCK 33),
ESP-NOW on with a linked WiZmote, 42 presets (`presets.json` is 87 KB, so the
usermod reads it with a names-only filter), Wi-Fi channel 11 at home, AP
"Nibbles" on channel 1. A backup of its `cfg.json`, `presets.json` and the
0.15.1 release image for rolling back is in `wled/backup/` (not committed).

**LED outputs now (2026-09-27).** The fins moved from channels 3/4 to 4/5,
and last year's eye lights (130 LEDs, behind the new eye screens) were
removed, so channel 3 (GPIO 3, driven by the board's USB chip) is free and
the controller's USB can stay connected, e.g. to a hub in the box:

| Output | Pin | LEDs | What |
|---|---|---|---|
| 1 | GPIO 1 | 0-417 | main tube, outward strip |
| 2 | GPIO 2 | 418-834 | main tube, inward strip |
| 3 | - | - | unused (the CH340 drives GPIO 3) |
| 4 | GPIO 4 | 835-948 | port fin |
| 5 | GPIO 5 | 949-1063 | starboard fin |

1064 LEDs; the LED numbers didn't change, so presets, the 2D map and the
simulator layout still match. Of the spare channels 6-8, use 7 (GPIO 14) or
8 (GPIO 15) first: GPIO 12 (channel 6) sets the flash voltage at boot and
must not be pulled high then. Backup from before the change:
`wled/backup/20260927-0851-pre-channel-move/`.

**The shark's 24-pin connector** (from the build notebook, p. 36; photo
2026-11-09). The shark's LEDs plug into the top enclosure through one
24-pin connector: 8 LED channels of 3 pins each, in the order ground (−),
data (D), +5 V (+). The cable has 8 wire colours (the same cable as the
8-pin LEMO's, which uses the same order: pin 1 white to pin 8 orange), and they repeat every 8 pins in this order:
**white, brown, green, blue, red, yellow, black, orange**. So a wire's
colour alone doesn't say which pin it is: check its neighbours.

| Cable ch | Pin: − | Pin: D | Pin: + | Wired to now |
|---|---|---|---|---|
| 1 | 1 white | 2 brown | 3 green | output 1, main tube outward |
| 2 | 4 blue | 5 red | 6 yellow | output 2, main tube inward |
| 3 | 7 black | 8 orange | 9 white | output 4, port fin |
| 4 | 10 brown | 11 green | 12 blue | output 5, starboard fin |
| 5 | 13 red | 14 yellow | 15 black | spare |
| 6 | 16 orange | 17 white | 18 brown | spare |
| 7 | 19 green | 20 blue | 21 red | spare |
| 8 | 22 yellow | 23 black | 24 orange | spare |

Only cable channels 1-4 (pins 1-12) are in use. The controller's outputs
1, 2, 4 and 5 feed them because output 3 (GPIO 3) clashes with the board's
USB chip (above), so cable channel 3 is *not* controller output 3
(confirmed 2026-11-09).

**`nibbles_shark`** env: WLED 16's `esp32_eth` plus the usermod. It builds and
fits: 1.33 MB of the 1.5 MB app partition.

**First upgrade attempt, 2026-09-24: WLED 16 hung on boot. Rolled back.**
OTA to 16.0.1 + usermod went through, but on every boot the controller joined
Wi-Fi (answered pings) and then stalled: no web server, LEDs dark, no Nibbles
heartbeat. The release build prints nothing, and GPIO 1 (serial TX) carries
LED channel 1, so there is no log. Recovered over the board's own USB port
(CH340; `/dev/cu.wchusbserial*`, auto-reset into the bootloader works):
- full flash image saved first (`wled/backup/.../flash_after_wled16.bin`);
- app0 still held the official 0.15.1 image byte for byte (WLED 16 was in
  app1), so erasing `otadata` (0xe000, 8 KB) made it boot 0.15.1 again;
- WLED 16 had rewritten `cfg.json` on first boot (kept the old one as
  `bkp.cfg.json`): `linked_remote` became a list, `hw.led.prl` (parallel I2S
  output) and some transition keys were dropped. The original `cfg.json` was
  uploaded back through `/upload` and the controller rebooted: 0.15.1, 1194
  LEDs, 42 presets, remote linked.
- Power the board from its LED supply while USB is connected: with the LEDs
  attached, USB power alone tripped the Mac's port over-current protection.
- DHCP gave it a new address afterwards (10.7.200.136).
- While the USB cable is connected, LED channel 3 (GPIO 3, the UART RX pin
  that the CH340 drives) goes dark; it comes back when USB is unplugged.
  (Since 2026-09-27 nothing is on channel 3, so USB can stay connected.)

**Cause, found on a bench ESP32 (same chip, the controller's config and
storage image, joined to the same Wi-Fi): the usermod.** Stock WLED 16 and the
build with the usermod disabled both ran fine. WLED starts QuickEspNow in
synchronous mode, where `quickEspNow.send()` busy-waits in WLED's main loop for
the "sent" callback. A send that fails, as the usermod's first heartbeats do
while Wi-Fi is still connecting in station mode, never gets one, so the loop
spun forever. (The dev node always ran as an access point, where sends
succeed, so it never showed.) Fixed in commit 581aaeb: the usermod sends with
`esp_now_send()` directly. On the bench it then boots, anchors channel 11 and
the leader eye locks on. `nibbles_shark_debug` sends WLED's debug log over UDP
to `NIBBLES_DEBUG_HOST` port 7868 for this kind of bench work.

**Upgraded 2026-09-25 (second attempt, with the fix): working.** After a
clean 15-minute bench soak, OTA to 16.0.1 + usermod (image from commit
581aaeb). It came back at 10.7.200.253 with 1194 LEDs at 49 fps,
AudioReactive running, anchoring channel 11 and hearing the leader eye.
Presets, LED outputs, WiZmote, mic pins and Wi-Fi all survived. The boot preset
(230) applies about 15 s after boot, but WLED then reports `ps: -1` instead of
230 (cosmetic). Pre-upgrade backup: `wled/backup/*-pre-retry/`.
After the upgrade the lights toggled on/off every 0.5-3 s (dimming and coming
back over the 0.7 s transition). Cause: the pushbutton configured on GPIO 0.
On the WT32-ETH01, GPIO 0 is the Ethernet chip's 50 MHz clock input, and
WLED 16 read the noise there as button presses (0.15 didn't). The button was
removed from the config (`hw.btn.ins` now empty; nothing on the board uses
it) and the toggling stopped. Don't put a button on GPIO 0 on this board.

**Power and the flash bump.** A flash bump turns every LED (2020-size
WS281x) full white. The LEDs run from a 100 W 12-24 V to 5 V converter (rated
20 A; an older 50 W one was replaced in 2025), fed from the pole base: 20 V from a USB-PD trigger board (3-5 A) or a
4S 21700 pack. The bench board handled flash, blackout and preset bumps fine.

*Measured 2026-10-02* on a bench supply at the pole base (in place of the
PD/battery input), full white at full brightness with the limiter off:
**about 100 W in**. After the converter's losses (~85-92%) that is about
16.5-18 A at 5 V, or **15.5-17 mA per LED at full white**, not WLED's
default estimate of 55 mA. That is 85-90% of the converter's 20 A, so it can
run full white, but it is more than a 60 W (20 V x 3 A) PD source can give.

*WLED's limiter now* (since 2026-10-02): every output estimates **17 mA per
LED** (`ledma`, the top of the measured range, so it errs safe) and the
global limit (`hw.led.maxpwr`) is **17000 mA**, now in real milliamps: 85%
of the converter's 20 A, so full white runs at about 95%. That needs a
supply that can give ~100 W into the converter (the bench supply, the 4S
pack); 9000 mA (full white at about half) was the setting before.

*Earlier brownouts*: with the old 55 mA estimate, "8000" (~2.5 A real)
browned out the controller on a flash and "5000" (~1.5 A real) survived.
The USB-PD trigger board is rated 5 A (100 W at 20 V), so the limit was the
PD source it was plugged into: on a V-mount battery with 100 W USB-PD
output the shark runs full white without trouble, as on the bench supply.
**Match the limit to the source**: 17000 mA for a 100 W PD source (with a
5 A cable), about 9000 mA for a 60 W one, lower for anything weaker (test
with a flash bump). Keep the limiter on, and retest
flashes whenever the power hardware changes. Backups from before these
changes: `wled/backup/20261002-0731-pre-ledma/`, `20261002-0736-pre-17000/`.

Upgrade plan (for later upgrades):
1. Back up its config and presets (WLED → Config → Security & Updates →
   Backup). LED and mic pins are in that config, not in the build.
2. Build `nibbles_shark`; the image is `.pio/build/nibbles_shark/firmware.bin`.
3. Upload it on WLED's Update page (OTA; GPIO 1 and 3 drive LEDs, so there is
   no USB serial). 0.15 and 16.0.1 use the same partition table
   (`tools/WLED_ESP32_4MB_1MB_FS.csv`; its filesystem shows 983 KB), so the
   saved config and presets stay. To roll back, upload the 0.15.1 image.
4. Check the Info page for "Nibbles radio", then on the base screen that WLED
   is heard and anchors the channel.

Known WLED issue to watch (fixed only in 17.0.0-dev): "ESP-NOW remote with no
Wi-Fi reboots every 15–20 min". Soak test 2026-09-24: the dev node (16.0.1 +
usermod, no Wi-Fi network configured so on its own AP, ESP-NOW anchoring and
receiving eye telemetry) ran 35 min with no reboot. Repeat on the real
controller after upgrading.

## The time

Nothing in the shark has a network clock. Open `http://<brain>/time` on a phone
once after power-up (a bookmark; `http://4.3.2.2/time` on the bench): the page
tells that WLED the phone's time. A main board then broadcasts it every 10 s
(`NL_MSG_TIME`) and the base sets its clock from it, for its logs and charge graph.
Any change in WLED's own UI sends the time too. A controller in the `display`
role doesn't pass it on, so use the brain's address.
