snowyfox/Nibbles/docs/architecture.md

# Nibbles system architecture

How the boards in the shark work together, and the order they're being built
in. Agreed 2026-09-24; update this file as decisions change.

## Pieces
- **Two eyes**: Waveshare ESP32-S3-Touch-AMOLED-1.75, mounted back to back
  120 mm forward of the pole, screens facing out to each side. They are linked
  by a cable between their 8-pin headers.
- **WLED controller**: an existing ESP32 running WLED, which drives all the
  other lights and has an external digital mic. It joins a phone hotspot when
  testing (at home or in a hotel) and falls back to its own AP at a festival,
  so **its Wi-Fi channel varies**.
- **Base station** (prototype on an ESP32-S3-Touch-LCD-3.49): an ESP32 in the pole base with battery
  management, status screen(s), and buttons to change eye and WLED presets;
  later, DMX-style bump buttons for momentary effects. Its power system
  (internal pack, power board, battery dock) is designed in
  [power.md](power.md).
- **Pole**: a K-Tek **K-123** (Klassic series, six-section graphite boom
  pole; discontinued). Its bottom section is 551 mm long; the upper keypad
  goes near the top of that section, within arm's reach. The base enclosure
  attaches through a **modified K-Tek KFT** flow-through foot
  ([listing](https://wilcoxsound.com/product/k-tek-k-ft-straight-cable-flow-through-base-unit-with-standard-pole-base/),
  discontinued). The KFT was cut in two through its cable slot, and the
  side dimples were drilled and tapped for the enclosure's screws.
  Dimensions measured from the Fusion 360 STEP exports are in
  [pole.md](pole.md).

## Repository
One monorepo: a single shared protocol, used by every firmware, changes in one
commit with all its users. WLED is **not forked**: WLED 16.x builds usermods
as PlatformIO libraries through `custom_usermods`, and they can live outside
its tree (`symlink:///path`). A stock WLED checkout pinned to a release tag,
plus the `platformio_override.ini` from this repo, builds WLED with our usermod.

```
CLAUDE.md                 system overview and conventions
docs/                     this file; power.md (power system design); later protocol.md, wiring.md
shared/nibbles_link/      pure-C protocol, framing and CRC; ESP-IDF component and
                          PlatformIO library; host tests            (Phase 1)
firmware/eyes/            eye firmware (ESP-IDF)
firmware/base/            base station firmware (ESP-IDF)           (Phase 4)
wled/usermod_nibbles/     WLED usermod                              (Phase 3)
wled/platformio_override.ini                                        (Phase 3)
tools/                    capture, recording and replay helpers
```

## Roles
- **Starboard eye = leader.** It is the eyes' radio gateway (ESP-NOW) and runs
  the shared "brain": preset choice and timing, swap and random blinks,
  sleep/wake, hype, colour drift and tempo.
- **Port eye = ears.** It runs the mic and the audio analysis and sends the
  results to the leader. It does no radio work.
- Each eye renders its own screen and uses **its own IMU** for pupil look and
  twist (the mounts are mirror images). Roles come from the board's MAC, as the
  side does today.
- If the link is silent for more than 250 ms (`LINK_STATE_MAX_AGE_MS`), each
  eye runs standalone, so a broken cable never blanks an eye.

Spreading the jobs this way keeps each eye's frame budget: the render path
has only ~3–7 ms of slack per frame.

## Eye link (wired)
UART1 at 1 Mbaud on header GPIO 17 (TX) and GPIO 18 (RX), crossed between the
eyes, plus GND. That leaves GPIO 16, 43 and 44 free (UART0 is unused because
the console is on USB-JTAG), exactly enough for an optional I2S mic on one
eye. Framing: COBS with CRC-16, a message type and a sequence number.

| Direction | Rate | Content |
|---|---|---|
| port → starboard | ~31 Hz | audio features: level, average, loudness, warmth, beat count, beat period, rhythm, noise floor, gain (~32 B) |
| starboard → port | every frame | shared eye state: state, lid, blink/swap phase, swap + preset index, hype, hue, intensity, wobble, ring phase, tempo, ripples (~40 B) |
| both ways | 2 Hz | heartbeat: role, firmware version, fps, late frames, temperature |

## Radio (ESP-NOW)
- **WLED is the channel anchor.** Its usermod broadcasts a Nibbles heartbeat
  on whatever channel WLED is on. The leader eye and the base scan channels
  until they hear it, lock on, and rescan after ~3 s of silence. The same code
  works at home (hotspot) and at a festival (WLED's AP).
- **Searching together** (2026-11-09; replaced the fallback anchor): if the
  base hears no anchor for 12 s (brains off or restarting), it leads a search.
  It sweeps the channels at 0.8 s each (a little more, by MAC), sends
  `NL_HB_GROUP` heartbeats at 4 Hz and announces each move 120 ms ahead with
  `NL_MSG_HOP` (`NL_HOP_SEARCH`). The eyes and the preview screen sweep twice
  as fast, so they catch up with it and then move with it. The boards keep
  talking while they search, and all lock onto a brain as soon as the group
  reaches its channel (about 10 s for a full sweep). Of two leaders, the
  higher MAC follows. The old fallback anchor parked the base on channel 6,
  and its peeks at other channels were put off by every send the base made,
  so with the brains back on another channel it stayed on 6 for good.
- **Moving the network** (`NL_HOP_MOVE`): the base's survey page listens to
  every channel (other networks' airtime and access points, ours left out),
  scores each channel with its neighbours' overlap, and a held button sends
  the move 5 times over 0.6 s, naming a moment 1 s ahead. Everyone moves then;
  the brains restart their access point on the new channel and save it, a
  joined brain reconnects 1.5 s later and doesn't stand in as host for 20 s.
  Scanners keep their lock for 8 s more while the brain comes back, and for
  6 s ignore anchors still advertising another channel. A board that missed
  the move loses the brain and finds it on the new channel by scanning.
- State that can be sent again safely (heartbeats, telemetry, audio features)
  is broadcast at a fixed rate.
- Commands are unicast to known peers with an ack and retries.
- Momentary "bump" actions send start, then a keepalive every 100 ms, then
  stop. The receiver releases automatically after 300 ms without keepalives,
  so a lost stop can't leave an effect stuck on.
- Every message carries a network ID, protocol version and sequence number.
  ESP-NOW encryption can be added later.
- Messages (`shared/nibbles_link/include/nibbles_link.h`, protocol version 3):

  | Message | From → to | When |
  |---|---|---|
  | `HEARTBEAT` | everyone → broadcast | 2 Hz; anchors 4 Hz with `NL_HB_ANCHOR` and their channel |
  | `EYE_TELEMETRY` | leader eye → broadcast | 2 Hz: preset and name, state, link, both fps, bpm, brightness, auto-cycle |
  | `WLED_TELEMETRY` | WLED → broadcast | 2 Hz: on, brightness, preset and name, effect, palette, fps, LEDs |
  | `CMD` / `ACK` | base → eyes or WLED, unicast | on demand: preset set/next/prev, brightness set/step, eyes' auto-cycle; up to 3 tries of 60 ms |
  | `BUMP` | base → broadcast (target mask) | START, HOLD every 100 ms, STOP: flash, blackout, preset while held |
  | `AUDIO` | WLED → broadcast | every 32 ms when its `audio` setting is on |
- The WLED usermod receives messages through
  `Usermod::onEspNowMessage(sender, payload, len)`, so WLED's own ESP-NOW
  handling is untouched.

## Audio source ("the system's ears")
A single "audio features" message, whatever the source. Later, the WLED usermod
can publish WLED AudioReactive's analysis of its external mic (through AR's
`um_data`), and the eyes can use that instead of their own mics if it detects
beats better. Raw audio over ESP-NOW isn't worth it.

Built (not yet tried on real music): the usermod's `audio` setting broadcasts
`nl_audio_t` every 32 ms from AudioReactive's smoothed volume, FFT bands and
beat peaks (`nl_ar_update`: warmth from bass vs treble bands, tempo from the
median peak interval, folded to 100–200 bpm like the eyes'). The leader eye
uses it instead of the eyes' mics when built with `EYES_AUDIO_FROM_WLED 1`,
falling back to the port eye, then its own mic, when it stops. First live run (2026-09-25):
the leader switched to "audio from WLED" with 0 late frames, but
AudioReactive's peak flag fired about 9 times a second. The converter now
counts at most one beat per 250 ms, and needs 75% of intervals within 8% of
the median before it reports a tempo. Loudness reads 0.6-0.8 after
AudioReactive's gain control; still to be compared on real music. The raw
peaks looked great on the eyes, so `nl_audio_t` (protocol version 4) carries
both `beat_count` (steady beats) and `peak_count` (every peak), and each eye
preset picks which one it reacts to (`peak_beats`).

## Roadmap
| Phase | Work | Status |
|---|---|---|
| 0 | Restructure into this layout | done |
| 1 | Eye-to-eye link: protocol + framing with host tests; UART link task; leader/ears roles; shared-state vs local-state split; standalone fallback; link stats in the status log | done: both boards linked (0 CRC errors, 0 late frames); visual sync confirmed; unplugging either data wire falls back to standalone at once and re-links on reconnect |
| 2 | ESP-NOW on the leader eye: channel scan and lock, heartbeat, telemetry; measure Wi-Fi's cost to the frame rate (keep Wi-Fi on core 0) | done: `shared/nibbles_espnow`; leader eye locks onto the anchor, sends telemetry, takes preset commands (acked in ~2 ms); 0 late frames with Wi-Fi on. Base prototype (`firmware/base` on an ESP32-S3-Touch-LCD-3.49) anchors channel 6 until the WLED usermod exists |
| 3 | WLED 16.x upgrade (back up config and presets first) + usermod: channel-anchor heartbeat, preset commands, bump effects, optional AudioReactive features. Watch for: "ESP-NOW remote with no Wi-Fi reboots every 15–20 min" (fixed only in 17.0.0-dev) | in progress: `wled/usermod_nibbles` builds into WLED 16.0.1 (see `wled/README.md`); on a 3.49 dev node it anchors the channel, the eyes lock onto it and their telemetry reaches WLED. Scanners now jump to the anchor's advertised channel (channels overlap). WLED preset and brightness commands verified from the base (acked in 3–15 ms; next/previous wrap over existing presets; a missing preset is refused; preset names reach the base screen; commands during a bump apply on release). The base hands the channel over to WLED's anchor. Real controller not upgraded; AudioReactive features not started |
| 4 | Base station: choose hardware (display, battery chemistry/BMS, how battery state is read, buttons); firmware for status screens and preset buttons | prototype firmware on a 3.49: scans for WLED, logs eye and WLED telemetry, eye and WLED preset commands from buttons and USB serial, LVGL status screen (eyes, WLED, radio, events). Power system designed in [power.md](power.md), not built; BMS/gauge and buttons still open |
| 5 | Bump / DMX-style control: momentary effects, preset while held, flashes; under 20 ms from button to light | protocol (`nl_bump.c`, host tested) and WLED side done: flash, blackout and preset-while-held with state restore, verified from the base. Eyes: flash (startle: full glow, small pupil, ripple), blackout (lids shut, master level 0, outline included) and preset while held, verified on both linked eyes. Latency (leader eye, radio arrival → frame sent; the log prints it per bump): 35–68 ms, median 54 ms over 12 flashes; the radio adds ~1–2 ms (command round trips are 2–4 ms). The eyes can't meet 20 ms: a frame is 34 ms at 29.5 fps and takes ~26 ms to send over QSPI, and the eye task takes input once per frame. WLED not measured yet |

## Open decisions
- Base station hardware and battery system (Phase 4): see [power.md](power.md)
  and its own open decisions.
- WLED controller board type (sets the PlatformIO env) and LED count (Phase 3).
- Whether the eyes switch to WLED's mic features (after Phase 3, compared on
  real music).
- Eye cable: GND, TX and RX. Power stays separate unless the boards share a
  supply.
- **Main board + display controller** (tested 2026-10-23, see
  `wled/README.md`, "Main board and display"): a faster WLED with PSRAM
  renders and streams every LED to the Bong69 controller, which only
  displays them. Clearly smoother (124 fps of rendering headroom vs 38) and
  much more memory. Decided since: the main board ("brain") is an ESP32-S3
  in the controller's box, wired to the controller, and a second brain is planned (see
  "Two brains and the Standby preview" below). Still open: which board runs
  the access point and the radio anchor.

## Two brains and the Standby preview (agreed 2026-10-30)
The brain (an S3 at 42 fps on the 68 x 33 grid) is near its limit, and the
base's Standby only shows names. Plan:
- **Two identical brains, both in the controller's box** on top of the
  pole, each wired to it (the one-way UART link: controller RX on GPIO 39 for Right Brain,
  32 or 33 for Left Brain once the mic moves to a brain). Live frames never
  cross the radio. The pole cable can't take a data pair (only room for the
  two power conductors), so the brains can't sit in the base: Live would
  have to go up the pole over Wi-Fi.
- **Left Brain renders Standby.** The base sends Standby preset, palette and
  layer commands to it the same way it sends Live ones to Right Brain.
- **The preview comes down over the radio, reduced**: one byte per LED
  (8-bit colour, ~1 KB a frame), 10-15 fps, about 15 KB/s; dropped frames
  don't matter for a preview. WLED's ESP-IDF only has ESP-NOW v1, so 5 packets
  of 250 bytes a frame. A separate preview screen draws it
  (`firmware/preview`, a 1.91 AMOLED, about 446 x 224 px for the shark). The
  base's Standby panel could draw the same stream at about 172 x 85 px. A live
  side view isn't wanted (look up).
- **Later, A/B handover**: TAKE makes the controller switch (or crossfade)
  from one brain's stream to the other's, and the roles swap. The next look
  is already running, so effects that grow from black (fire) start warm, and
  each brain runs one look instead of WLED running both during a transition.
  The controller mixes two 1,064-LED streams, which is cheap. Presets must
  stay in sync on both brains. Audio: one brain has the mic and sends WLED's
  audio sync to the other (or each has its own mic).
- **Built 2026-11-01, not yet on real boards** (`wled/README.md`, "A/B brains"):
  the controller takes both wires and keeps each brain's latest frame (`nl_ab_*`):
  a cut or crossfade on a take, Standby shown while TAKE is held, and failover if
  the Live brain's stream stops for 500 ms. The brain not on the LEDs sends as
  `NL_ROLE_WLED_STANDBY`, so the eyes (which filter on `NL_ROLE_WLED`) need no
  change. It keeps its eye settings until taken and ignores bumps. Both brains
  send the preview, and the base shows **Live on the top shark and Standby on a
  second one under the eyes**. The base keeps the Standby
  brain matching its Standby scene (`ctl_standby_sync`, once a second). With one
  brain up, everything works as before.
- **Order**: (1) the wired brain-to-controller link (usermod and protocol
  built 2026-10-30, `wled/README.md` "Wire link"; sending and decoding tested
  on the bench, the controller receiving over a real wire not yet),
  (2) Left Brain in the controller's box with the radio preview and the Standby
  side view, (3) the A/B handover, probably after the festival.
- **Brain board**: an ESP32-S3 with 16 MB flash and 8 MB octal PSRAM
  (S3R8 or N16R8), the same memory as the 3.49, so the same WLED build runs
  with only pin changes. They sit with the controller in the 3D-printed box
  at the top of the pole (the shark plugs into it with a 24-pin connector; pinout and wire colours in `wled/README.md`),
  about 3 m from the base through plastic, so an on-board antenna is enough
  (the controller's is, today); keep its end clear of wires and metal.
  Ordered 2026-10-30: 3 Waveshare ESP32-S3-DEV-KIT-N16R8 (no headers),
  WLED env `nibbles_brain_s3`. Not the ESP32-P4: no radio of its own, and
  WLED 16.0.1 doesn't build for it (assessed 2026-10-29).

## Top-of-pole wiring (planned 2026-09-27)
The WLED controller sits in a weatherproof box on top of the pole; the eyes
are sealed in small weatherproof domes on the shark, with no access to their
boards or ports once installed. Plan for programming and powering them:
- **USB hub in the controller box**, powered from the box's 5 V (not from
  the computer). Its upstream USB-C socket sits inside the box (the box is
  weatherproof and opens easily, so the socket needs no sealing of its own);
  add 5.1 kOhm from CC1 and CC2 to GND if the hub board lacks them, and a
  small USB TVS array. One cable from a computer then reaches every board:
  - **each eye**: a 4-wire harness (5 V, GND, D+, D-; under 1 m; twist the
    data pair) ending in a USB-C plug in the eye's own port, inside its
    dome (no cable gland: the plug and the harness end are sealed in the
    dome). Flashing and the once-a-second status logs work as over a
    normal USB cable, and even a crashing build can be re-flashed (the
    ESP32-S3's USB programming is in hardware). The eyes are told apart by
    their serial numbers (MACs);
  - **the WLED controller's own USB port** (CH340), permanently: nothing is
    on its channel 3 any more (see the WLED outputs in `wled/README.md`), so
    the USB chip driving GPIO 3 no longer blanks LEDs. Opening its serial
    port may reset WLED; only done deliberately at the bench;
  - a spare port for later (the base station, a fin-sensor board).
- **Eye power**: a separate 5 V feed from the box's supply, not from the LED
  distribution (full-white flashes sag that rail; it browned out the
  controller before), with a few hundred uF at the eyes or the hub outputs.
  Both eyes are loads on one supply here; the old "never link VBUS" rule was
  about two eyes each on their own USB supply being joined, so never also
  plug an eye into a separate supply while it is wired in.
- **Hub hardware**: start with an off-the-shelf FE1.1s or CH334/CH335 USB 2.0
  hub module (a few dollars; one whose downstream ports take their 5 V from
  a supply input you feed). Fold it into a custom box PCB later (hub, USB-C
  with ESD, locking harness connectors, per-eye fuse and bulk capacitors),
  alongside the planned custom base boards.
- Over-the-air updates for the eyes (below) become optional with this.

## Ideas for later
- **Over-the-air updates for the eyes** (2026-09-26; not started). Today each
  eye has one 8 MB app partition (`firmware/eyes/partitions.csv`) and no
  update code, so every update needs USB; the base is the same. Plan:
  1. One last USB flash per eye to a partition table with `otadata` and two
     OTA app slots (16 MB flash, the image is ~0.8 MB, so e.g. 2 x 4 MB);
     NVS stays where it is.
  2. Leader eye: only when asked (a base command or a button), join the same
     Wi-Fi as WLED (hotspot or its AP; same channel as ESP-NOW, so the radio
     keeps working) and take an upload from the Mac over HTTP, like WLED's
     update page. Off the network otherwise, so the frame rate is untouched;
     measure it while connected.
  3. Port eye: the leader passes the image on over the eye cable (1 Mbaud,
     roughly 10-20 s), so the port eye needs no radio.
  4. Rollback: a new image is marked good only after it boots and renders
     normally; otherwise the bootloader goes back to the previous one, so a
     bad update can't leave an eye dead on the pole.
  The base has it now (2026-11-02, `firmware/base/CLAUDE.md`, "Updates
  without USB"): two slots, rollback, Wi-Fi upload, and a mirror board fed
  over a cable, with the same text protocol the eyes could reuse.
- **Fins: independent effects and following the real fin angle** (2026-09-26;
  not started). The shark's WLED is a 2D matrix (side view, `wled/README.md`
  "2D map"); the usermod already copies partner LEDs each frame.
  - *Fins on their own matrix for some presets*: grow the grid (70 x 35 side
    view plus fin panels below it, each fin face-on, ~20 x 12 cells, and
    optionally a one-row strip per fin, 115 cells, for 1D effects along a
    fin). The fin LEDs live in the fin panels; their spots in the side view
    become empty cells. Every frame the usermod picks each fin's source from
    which segments the preset has switched on: only the side view on ->
    fins take the side view's colour at their spot (as now); a fin panel or
    strip segment on -> the fins show that effect; port and starboard can be
    separate segments or copy each other. Plain WLED presets, no special flag.
    Cost ~7 KB more RAM (~3,100 cells). The body could get the same one-row
    treatment (channel 1 as two rows of ~209; rows max 255) so 1D-style
    presets work in 2D.
  - *Fins that follow their real position*: each fin hangs on one hinge (the
    FinMount, axis along the fin root, tilted ~44 degrees nose-up), so one angle per
    fin says where it is. Sense it with a magnetic angle sensor on the hinge
    (AS5600 + magnet; absolute, no drift, analog out) rather than an IMU (an
    IMU needs the body's own motion subtracted, e.g. from the eyes' IMUs). A
    small ESP32-C3 near the fins, powered from the fin LEDs' 5 V, broadcasts
    the angles over ESP-NOW (a new "fin pose" message in the shared
    protocol) at 50-100 Hz; the Bong69's spare outputs are probably
    output-only buffers, so wiring into the controller is unlikely (unchecked).
    The usermod rotates each fin LED's rest position about the hinge axis by
    the angle, projects it onto the side view and samples the colour there
    (~0.2 ms/frame, ~3 KB for the rest positions, written into the map file
    by `make_ledmap.py` from the Fusion geometry). In fin-panel mode the angle
    could drive the fin effect instead (e.g. flap strength -> brightness).
  - *Range* (the user, 2026-09-30): close to 180 degrees, from straight up
    to straight down. The model's fin rests drooping down and out, not
    level, and the hinge axis is tilted ~44 degrees nose-up, so "up" is
    up-and-back and "down" down-and-forward. A rough rotation of the model
    suggests the fin reaches 30-40 mm below the belly, past the 2D grid's
    bottom edge, in the lower part of the swing: add ~5 rows to the grid
    (~3.5 KB RAM) or let fin LEDs outside the grid go dark. The simulator
    sliders should show the real sweep before any hardware.
  - *Sensor choice*: either an AS5600 (12-bit; I2C at a fixed address 0x36,
    analog and PWM outputs; everywhere, lots of examples; the AS5600L has a
    settable address) or an MT6701 (14-bit; SSI with a chip-select per
    sensor, plus I2C, analog, PWM; less noisy; fewer examples) is far finer
    than needed. With one small board reading both fins, prefer the MT6701
    over SSI (two sensors share clock and data; robust digital next to the
    LED wiring); the ESP32-C3 has one I2C bus, so two AS5600s would need the
    analog outputs (with an RC filter) or an AS5600L. With a board per fin,
    the AS5600 over I2C is simplest. Mount the sensor on the body side and
    the magnet (diametric disc) on the fin side of the hinge so no wires
    flex; centre it on the axis within ~0.5 mm, 1-3 mm gap; keep steel and
    LED power wires away. Keep the 0/360 wrap in the unreachable half or
    unwrap in software; calibrate both limits (straight up and down) in
    software rather than burning a zero into the chip.
  - Order: simulator first (per-fin hinge sliders; the 3D view rotates the
    fins), then the usermod on the bench fed a test angle through JSON, then
    hardware. Unknowns: room at the hinge for a magnet and sensor, whether a
    wire can reach the fins.
