snowyfox/Nibbles/hardware/inventory/inventory.csv

LCSC | MPN | Maker | Description | Package | Kind | Ordered | Received | Reserved for Nibbles | Free | Unit USD | Supplier | Order date | Status | Notes
C133062 | BM08B-GHS-TBT(LF)(SN) | JST | CONN HEADER SMD 8POS 1.25mm | SMD,P=1.25mm | connector | 60 | 0 | 40 | 20 | 0.2487 | LCSC | 2026-11-01 | Ordered
C133065 | SM06B-GHS-TB(LF)(SN) | JST | CONN HEADER SMD R/A 6POS 1.25mm | SMD,P=1.25mm,Surface Mount,Right Angle | connector | 5 | 0 | 0 | 5 | 0.3599 | LCSC | 2026-11-01 | Ordered | side-entry option, not on a board yet; see hardware/fab/README.md for the pin order
C161690 | BM02B-GHS-TBT(LF)(SN) | JST | CONN HEADER SMD 2POS 1.25mm | SMD,P=1.25mm | connector | 25 | 0 | 15 | 10 | 0.1748 | LCSC | 2026-11-01 | Ordered
C189892 | BM06B-GHS-TBT(LF)(SN) | JST | CONN HEADER SMD 6POS 1.25mm | SMD,P=1.25mm | connector | 15 | 0 | 10 | 5 | 0.7799 | LCSC | 2026-11-01 | Ordered
C189893 | SM02B-GHS-TB(LF)(SN) | JST | CONN HEADER SMD R/A 2POS 1.25mm | SMD,P=1.25mm,Surface Mount,Right Angle | connector | 10 | 0 | 0 | 10 | 0.5110 | LCSC | 2026-11-01 | Ordered | side-entry option, not on a board yet; see hardware/fab/README.md for the pin order
C265111 | SM08B-GHS-TB(LF)(SN) | JST | CONN HEADER SMD R/A 8POS 1.25mm | SMD,P=1.25mm,Surface Mount,Right Angle | connector | 10 | 0 | 0 | 10 | 0.2979 | LCSC | 2026-11-01 | Ordered | side-entry option, not on a board yet; see hardware/fab/README.md for the pin order
C2932674 | KH-2.54FH-1X11P-H8.5 | kinghelm | CONN SOCKET 11POS 2.54mm SINGLE ROW TH | Through Hole,P=2.54mm | connector | 15 | 0 | 10 | 5 | 0.1486 | LCSC | 2026-11-01 | Ordered
C431092 | XT30PW-M30.G.Y | Changzhou Amass Elec | Connector XT30PW30-M.G.* Male Plug Right Angle for RC ESC | - | connector | 23 | 0 | 15 | 8 | 0.3281 | LCSC | 2026-11-01 | Ordered
C206010 | TCA9534APWR | TI | Low Voltage 8-Bit I²C and SMBUS Low-Power I/O Expander With Interrupt Output and Configuration Registers | TSSOP-16 | ic | 13 | 0 | 10 | 3 | 1.0466 | LCSC | 2026-11-01 | Ordered
C2155765 | TPS259827ONRGET | TI | TPS259827ONRGET | VQFN-24(4x4) | ic | 7 | 0 | 5 | 2 | 4.8936 | LCSC | 2026-11-01 | Ordered
C2876593 | BQ25798RQMR | TI | IC control with dual-input selector, 1-cell to 4-cell, buck/boost battery charger for MPPT of solar panels and fast backup mode | QFN-29(4x4) | ic | 7 | 0 | 5 | 2 | 2.8553 | LCSC | 2026-11-01 | Ordered
C2941042 | LM74700QDBVRQ1 | TI | Low IQ Battery Reverse Protection Ideal Diode Controller | SOT-23-6 | ic | 20 | 0 | 15 | 5 | 2.2795 | LCSC | 2026-11-01 | Ordered
C3200405 | TPS62933DRLR | TI | 3.8V to 30V, 2A/3A synchronous buck converters | SOT-583 | ic | 7 | 0 | 5 | 2 | 0.4828 | LCSC | 2026-11-01 | Ordered
C49851 | INA226AIDGSR | TI | High-or Low-Side Measurement, Bi-Directional CURRENT/POWER MONITOR with I2C Interface | VSSOP-10 | ic | 7 | 0 | 5 | 2 | 0.6650 | LCSC | 2026-11-01 | Ordered
C7484 | SN74AHCT1G125DBVR | TI | Single Bus Buffer Gate with 3-State Output | SOT-23-5 | ic | 10 | 0 | 5 | 5 | 0.1011 | LCSC | 2026-11-01 | Ordered
C783615 | TCA9534PWR | TI | Low-voltage 8-bit I²C and SMBUS low-power I/O expander with interrupt output and configuration register | TSSOP-16 | ic | 7 | 0 | 5 | 2 | 0.9384 | LCSC | 2026-11-01 | Ordered
C5149201 | SK6812MINI-E | OPSCO Optoelectronics | 3.2x2.8x1.78 mm, 0.2 W intelligent externally controlled surface-mount device (SMD) LED | SMD | led | 85 | 0 | 55 | 30 | 0.0651 | LCSC | 2026-11-01 | Ordered
C106205 | CC0402KRX7R9BB102 | YAGEO | CAP CER 1nF 50V X7R 0402 | 0402 | passive | 100 | 0 | 5 | 95 | 0.0024 | LCSC | 2026-11-01 | Ordered
C131394 | CC0402KRX7R9BB104 | YAGEO | CAP CER 100nF 50V X7R 0402 | 0402 | passive | 50 | 0 | 15 | 35 | 0.0107 | LCSC | 2026-11-01 | Ordered
C14663 | CC0603KRX7R9BB104 | YAGEO | CAP CER 100nF 50V X7R 0603 | 0603 | passive | 200 | 0 | 110 | 90 | 0.0068 | LCSC | 2026-11-01 | Ordered | free count includes 10 for eFuse timing trials
C154685 | LR2512-23R002F4 | RALEC | RES 2mΩ ±1% 3W 2512 | 2512 | passive | 15 | 0 | 5 | 10 | 0.1898 | LCSC | 2026-11-01 | Ordered
C15850 | CL21A106KAYNNNE | Samsung Electro-Mechanics | CAP CER 10uF 25V X5R 0805 | 0805 | passive | 120 | 0 | 75 | 45 | 0.0441 | LCSC | 2026-11-01 | Ordered
C1589 | CL10B103KB8NNNC | Samsung Electro-Mechanics | CAP CER 10nF 50V X7R 0603 | 0603 | passive | 50 | 0 | 5 | 45 | 0.0075 | LCSC | 2026-11-01 | Ordered | free count includes 10 for eFuse timing trials
C1622 | CL10B473KB8NNNC | Samsung Electro-Mechanics | CAP CER 47nF 50V X7R 0603 | 0603 | passive | 100 | 0 | 15 | 85 | 0.0058 | LCSC | 2026-11-01 | Ordered | free count includes 10 for eFuse timing trials
C19666 | CL10A475KO8NNNC | Samsung Electro-Mechanics | CAP CER 4.7uF 16V X5R 0603 | 0603 | passive | 20 | 0 | 5 | 15 | 0.0171 | LCSC | 2026-11-01 | Ordered
C21122 | CL10B223KB8NNNC | Samsung Electro-Mechanics | CAP CER 22nF 50V X7R 0603 | 0603 | passive | 50 | 0 | 10 | 40 | 0.0058 | LCSC | 2026-11-01 | Ordered | free count includes 10 for eFuse timing trials
C21190 | 0603WAF1001T5E | UNI-ROYAL | RES 1kΩ ±1% 100mW 0603 | 0603 | passive | 100 | 0 | 15 | 85 | 0.0017 | LCSC | 2026-11-01 | Ordered
C22775 | 0603WAF1000T5E | UNI-ROYAL | RES 100Ω ±1% 100mW 0603 | 0603 | passive | 100 | 0 | 15 | 85 | 0.0024 | LCSC | 2026-11-01 | Ordered
C22796 | 0603WAF1300T5E | UNI-ROYAL | RES 130Ω ±1% 100mW 0603 | 0603 | passive | 100 | 0 | 5 | 95 | 0.0014 | LCSC | 2026-11-01 | Ordered
C22857 | 0603WAF1072T5E | UNI-ROYAL | RES 10.7kΩ ±1% 100mW 0603 | 0603 | passive | 100 | 0 | 5 | 95 | 0.0017 | LCSC | 2026-11-01 | Ordered
C22935 | 0603WAF1004T5E | UNI-ROYAL | RES 1MΩ ±1% 100mW 0603 | 0603 | passive | 100 | 0 | 15 | 85 | 0.0018 | LCSC | 2026-11-01 | Ordered
C22977 | 0603WAF200KT5E | UNI-ROYAL | RES 2Ω ±1% 100mW 0603 | 0603 | passive | 100 | 0 | 5 | 95 | 0.0022 | LCSC | 2026-11-01 | Ordered
C23121 | 0603WAF8662T5E | UNI-ROYAL | RES 86.6kΩ ±1% 100mW 0603 | 0603 | passive | 100 | 0 | 5 | 95 | 0.0028 | LCSC | 2026-11-01 | Ordered
C23162 | 0603WAF4701T5E | UNI-ROYAL | RES 4.7kΩ ±1% 100mW 0603 | 0603 | passive | 100 | 0 | 10 | 90 | 0.0028 | LCSC | 2026-11-01 | Ordered
C23234 | 0603WAF7501T5E | UNI-ROYAL | RES 7.5kΩ ±1% 100mW 0603 | 0603 | passive | 100 | 0 | 5 | 95 | 0.0018 | LCSC | 2026-11-01 | Ordered
C25076 | 0402WGF1000TCE | UNI-ROYAL | RES 100Ω ±1% 62.5mW 0402 | 0402 | passive | 100 | 0 | 5 | 95 | 0.0013 | LCSC | 2026-11-01 | Ordered
C25771 | 0402WGF2702TCE | UNI-ROYAL | RES 27kΩ ±1% 62.5mW 0402 | 0402 | passive | 100 | 0 | 5 | 95 | 0.0010 | LCSC | 2026-11-01 | Ordered
C25803 | 0603WAF1003T5E | UNI-ROYAL | RES 100kΩ ±1% 100mW 0603 | 0603 | passive | 100 | 0 | 20 | 80 | 0.0030 | LCSC | 2026-11-01 | Ordered
C2933105 | FRC0402F5231TS | FOJAN | RES 5.23kΩ ±1% 62.5mW 0402 | 0402 | passive | 100 | 0 | 5 | 95 | 0.0014 | LCSC | 2026-11-01 | Ordered
C2933235 | FRC0603F5232TS | FOJAN | RES 52.3kΩ ±1% 100mW 0603 | 0603 | passive | 100 | 0 | 5 | 95 | 0.0021 | LCSC | 2026-11-01 | Ordered
C29718 | 4D03WGJ0103T5E | UNI-ROYAL | RES ARRAY 4 RES 10kΩ 0603x4 | 0603x4 | passive | 100 | 0 | 20 | 80 | 0.0076 | LCSC | 2026-11-01 | Ordered
C2981459 | KNM2220UF25V149EC0051 | KNSCHA | CAP ALUM POLY 220uF ±20% 25V SMD | SMD,D6.3xL9mm | passive | 20 | 0 | 10 | 10 | 0.2730 | LCSC | 2026-11-01 | Ordered
C2998131 | FRC0402F3012TS | FOJAN | RES 30.1kΩ ±1% 62.5mW 0402 | 0402 | passive | 100 | 0 | 5 | 95 | 0.0013 | LCSC | 2026-11-01 | Ordered
C4190 | 0603WAF2201T5E | UNI-ROYAL | RES 2.2kΩ ±1% 100mW 0603 | 0603 | passive | 100 | 0 | 5 | 95 | 0.0018 | LCSC | 2026-11-01 | Ordered
C45783 | CL21A226MAQNNNE | Samsung Electro-Mechanics | CAP CER 22uF 25V X5R 0805 | 0805 | passive | 40 | 0 | 20 | 20 | 0.1915 | LCSC | 2026-11-01 | Ordered
C77386 | GRM188R61H105KAALD | muRata | CAP CER 1uF 50V X5R 0603 | 0603 | passive | 20 | 0 | 10 | 10 | 0.0764 | LCSC | 2026-11-01 | Ordered | substitute for C15849 on the power board (C49, C50)
C89632 | CL31B106KBHNNNE | Samsung Electro-Mechanics | CAP CER 10uF 50V X7R 1206 | 1206 | passive | 20 | 0 | 10 | 10 | 0.2556 | LCSC | 2026-11-01 | Ordered
C98220 | RC0603FR-0710KL | YAGEO | RES 10kΩ ±1% 100mW 0603 | 0603 | passive | 100 | 0 | 30 | 70 | 0.0027 | LCSC | 2026-11-01 | Ordered
C10212 | SMBJ18A | RUILON | TVS DIODE 18VWM 29.2VC DO-214AA(SMB) | DO-214AA(SMB) | power | 10 | 0 | 5 | 5 | 0.0760 | LCSC | 2026-11-01 | Ordered
C179623 | NTMFS4C022NT1G | onsemi | MOSFET N-CH 30V 136A SO-8FL | SO-8FL | power | 23 | 0 | 15 | 8 | 0.3376 | LCSC | 2026-11-01 | Ordered
C2286 | KT-0603R | Hubei KENTO Elec | LED RED WATER CLEAR 0603 SMD | 0603 | power | 100 | 0 | 5 | 95 | 0.0077 | LCSC | 2026-11-01 | Ordered
C2443310 | CC12H15A-TR | EATON | 15A | 1206 | power | 10 | 0 | 5 | 5 | 0.1153 | LCSC | 2026-11-01 | Ordered
C285805 | MHCB06030-6R8M-C1 | Chilisin | FIXED IND 6.8uH 4.5A 60mΩ SMD | SMD,7x6.6mm | power | 10 | 0 | 5 | 5 | 0.2323 | LCSC | 2026-11-01 | Ordered
C285810 | MHCB06030-2R2M-C1 | Chilisin | FIXED IND 2.2uH 8A 20mΩ SMD | SMD,7x6.6mm | power | 10 | 0 | 5 | 5 | 0.1657 | LCSC | 2026-11-01 | Ordered
C48260 | TPD1E10B06DPYR | TI | TPD1E10B06DPYR | X1-SON-2(0.6x1) | power | 20 | 0 | 10 | 10 | 0.0451 | LCSC | 2026-11-01 | Ordered
C8545 | 2N7002 | JSCJ | MOSFET N-CH 60V 115mA SOT-23 | SOT-23 | power | 50 | 0 | 10 | 40 | 0.0167 | LCSC | 2026-11-01 | Ordered
C8678 | SS34 | MDD(Microdiode Semiconductor) | DIODE SCHOTTKY 40V SMA(DO-214AC) | SMA(DO-214AC) | power | 20 | 0 | 5 | 15 | 0.0354 | LCSC | 2026-11-01 | Ordered
C41430893 | CPG151101S11-16 | HanElectricity | Kailh CPG151101S11 hotswap socket (for the Box Navy switches) | SMD,14.5x5.9mm | socket | 90 | 0 | 55 | 35 | 0.0450 | LCSC | 2026-11-01 | Ordered
 | NC191AX50 | Chip Quik | Solder paste Sn63/Pb37 no-clean (ROL0), T4, 90% metal, 50 g jar | 50 g jar | consumable | 1 | 0 | 1 | 0 |  | Amazon | 2026-11-04 | Ordered | Top side of every board (stencil, hot plate); melts 183 C. Fridge 3-8 C, don't freeze, 4 h to warm before use; >12 months refrigerated, >6 months not
 | SMDLTLFPT4 | Chip Quik | Low-temp solder paste Sn42/Bi57.6/Ag0.4 no-clean (REL0), T4, 87% metal, 15 g syringe | 5 cc syringe | consumable | 1 | 0 | 1 | 0 |  | Amazon | 2026-11-04 | Ordered | Power board underside small passives (hot air, after the top); melts 138 C; never mix with leaded joints. Fridge 3-8 C, 4 h to warm; >6 months refrigerated, only >2 months not
 | SMBJ22A | (kit) | TVS diode 22 V standoff, unidirectional (breakdown 24.4 V min, clamp 35.5 V) | DO-214AA(SMB) | power | 10 | 0 | 5 | 5 |  | Amazon | 2026-11-04 | Ordered | D2 on DOCK_RAW in place of the SMBJ18A, for a 20 V dongle; from a TVS kit
 | NTC 10k B3435 | (kit) | NTC thermistor 10k 1% B3435, epoxy bead, 50 mm leads | bead | sensor | 5 | 0 | 5 | 0 |  | Amazon | 2026-11-04 | Ordered | Pack temperature on J4 (1 per pack), matches the 103AT-2 the TS divider was sized for; solder to half a GH lead and heat-shrink
 | NTC 100k B3950 | (kit) | NTC thermistor 100k 1% B3950, epoxy bead, 60 mm leads | bead | sensor | 5 | 0 | 0 | 5 |  | Amazon | 2026-11-04 | Ordered | Same kit as the 10k; not usable on J4 (wrong value for the TS divider)
