snowyfox/Nibbles/hardware/power_charger_board/fab/nibbles_power_charger-DigiKey-order.csv

Manufacturer Part Number | Manufacturer | Quantity | Customer Reference | Description | Note
KGM21AR51E106KU | KYOCERA AVX | 26 | C10,C11,C13,C14,C15,C17,C18,C19,C20,C21,C23,C24,C34 | 10uF 25V | 10uF 25V X5R 0805 (Samsung CL21A106KAYNNNE: backordered, 61 wk)
CC0402KRX7R9BB104 | YAGEO | 6 | C12,C16,C22 | 0.1uF 25V
CL10A475KO8NNNC | Samsung Electro-Mechanics | 2 | C25 | 4.7uF 10V
CL10B473KB8NNNC | Samsung Electro-Mechanics | 16 | C26,C27,C37 | 47nF 25V + trial: ITIMER 22 ms, RETRY_DLY 2.2 s
CC0402KRX7R9BB102 | YAGEO | 2 | C28 | 1nF 50V
CC0603KRX7R9BB104 | YAGEO | 24 | C30,C31,C38,C42,C43,C47,C48 | 0.1uF + trial: dVdt 365 ms, RETRY_DLY 4.7 s
EEH-ZK1E151XP | Panasonic | 4 | C32,C33 | 220uF 25V polymer | 150uF 25V hybrid polymer 6.3 x 8 mm, fits the 6.3 mm footprint (no 220uF 25V 6.3 mm in stock); 300 uF on EFUSE_OUT instead of 440
CL10B223KB8NNNC | Samsung Electro-Mechanics | 14 | C35,C36 | 22nF + trial: dVdt 80 ms ramp
CL10B103KB8NNNC | Samsung Electro-Mechanics | 12 | C46 | 10nF + trial: ITIMER 4.7 ms
CC0603KRX5R9BB105 | YAGEO | 4 | C49,C50 | 1uF 50V | 1uF 50V X5R 0603 (Samsung CL10A105KB8NNNC: backordered)
SMBJ18A | Littelfuse | 2 | D2 | SMBJ18A
TPD1E10B06DPYR | Texas Instruments | 4 | D3,D4 | TPD1E10B06DPYR
SS34-E3/57T | Vishay | 2 | D5 | SS34
CC12H15A-TR | Eaton | 2 | F1 | 15A
BM02B-GHS-TBT | JST | 6 | J4,J7,J8 | NTC 103AT on the cells (JST-GH 2, vertical)
PPTC111LFBN-RC | Sullins | 4 | J6 | To the 3.49 (stacked headers) | 1x11 female, 8.5 mm (same height as the Kinghelm)
BM06B-GHS-TBT | JST | 4 | J9,J11 | JST-GH 6 vertical (keypad port: I2C)
BM08B-GHS-TBT | JST | 2 | J10 | JST-GH 8 vertical (cable to the 3.49, instead of J6)
HCM0703-2R2-R | Eaton | 2 | L1 | 2.2uH Isat>=7A | 7.1 x 6.6 x 3.0 mm, Isat 14 A, 20 mohm (same specs as the Chilisin)
HCM0703-6R8-R | Eaton | 2 | L2 | 6.8uH Isat>=4A | 7.1 x 6.6 x 3.0 mm, Isat 8 A, 60 mohm
LTST-C191KRKT | Lite-On | 2 | LED1 | LED (charging) | red 0603
2N7002LT1G | onsemi | 4 | Q7,Q8 | 2N7002
RC0603FR-071KL | YAGEO | 6 | R3,R4,R27 | 1k
RC0603FR-07100KL | YAGEO | 6 | R5,R22,R25 | 100k
RC0402FR-0727KL | YAGEO | 2 | R10 | 27.0k 1%
RC0402FR-07100RL | YAGEO | 2 | R11 | 100
RC0402FR-075K23L | YAGEO | 2 | R12 | 5.23k 1%
RC0402FR-0730K1L | YAGEO | 2 | R13 | 30.1k 1%
RC0603FR-0710KL | YAGEO | 12 | R14,R16,R24,R28,R31,R37 | 10k
RC0603FR-072K2L | YAGEO | 2 | R15 | 2.2k
RC0603FR-071ML | YAGEO | 6 | R20,R21,R35 | 1M
RC0603FR-0786K6L | YAGEO | 2 | R23 | 86.6k 1%
RC0603FR-07130RL | YAGEO | 2 | R26 | 130 1%
WSL25122L000FEA | Vishay Dale | 2 | R29 | 2 mOhm 2512 3W | 2 mohm 2512, 1 W (0.26 W at the 11.3 A limit)
RC0603FR-0752K3L | YAGEO | 2 | R30 | 52.3k 1%
RC0603FR-074K7L | YAGEO | 4 | R32,R33 | 4.7k
RC0603FR-077K5L | YAGEO | 2 | R36 | 7.5k
RC0603FR-0710K7L | YAGEO | 2 | R38 | 10.7k 1%
RC0603FR-072RL | YAGEO | 2 | R39 | 2 (input snubber)
BQ25798RQMR | Texas Instruments | 2 | U2 | BQ25798RQMR
INA226AIDGSR | Texas Instruments | 2 | U6 | INA226AIDGSR
TPS62933DRLR | Texas Instruments | 2 | U7 | TPS62933DRLR
TCA9534PWR | Texas Instruments | 2 | U8 | TCA9534PWR
