snowyfox/Nibbles/hardware/keypad/fab/key_hub/key_hub-BOM-JLCPCB.csv

Comment | Designator | Footprint | LCSC Part #
100nF | C1,C4 | C_0603_1608Metric | C14663
22uF | C2,C3 | C_0805_2012Metric | C45783
From the power board (J9 + GPIO 43) | J1,J2,J3,J4,J5 | JST_GH_BM08B-GHS-TBT_1x08-1MP_P1.25mm_Vertical | C133062
100k | R1 | R_0603_1608Metric | C25803
100R | R2 | R_0603_1608Metric | C22775
SN74AHCT1G125DBVR | U1 | SOT-23-5 | C7484
