snowyfox/Nibbles/hardware/pole/K-Tek K123 Boompole.step

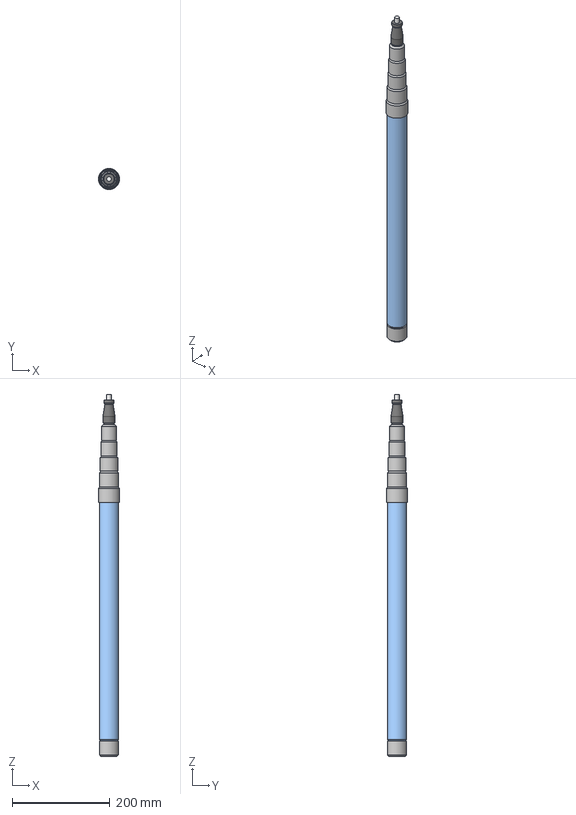
[picture p1: CAD file, 2026-10-30]
hardware/pole/K-Tek K123 Boompole.step
43.3 x 43.3 x 739.2 mm
Section 5
Section 4
Section 3
Section 2
Section 1
