snowyfox/Nibbles/tools/sim/web/shark.obj

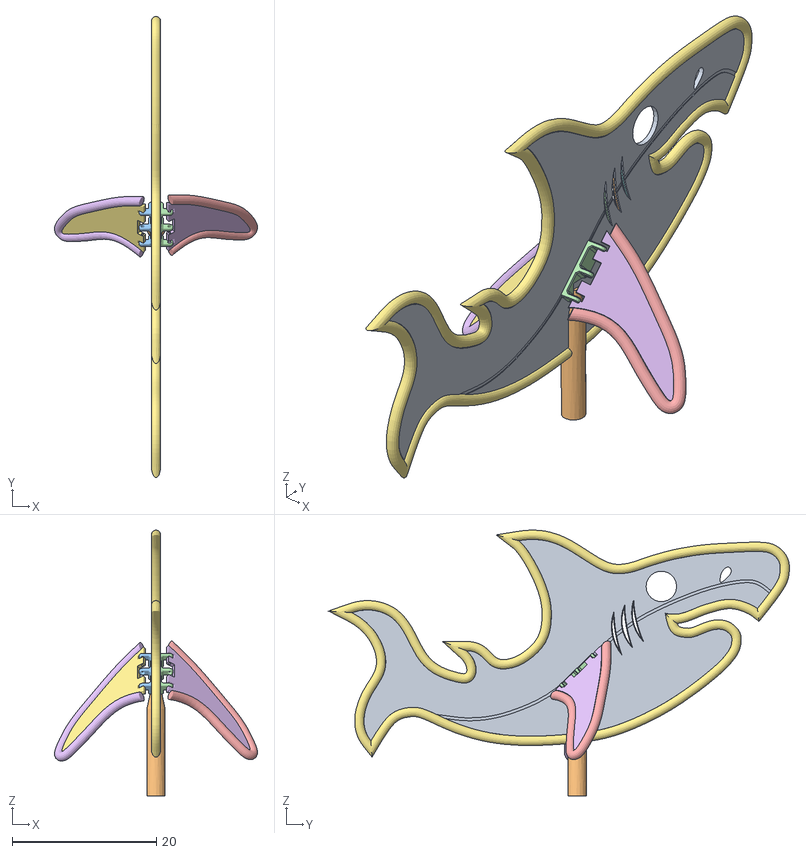
[picture p2: CAD file, 2026-09-26]
tools/sim/web/shark.obj
28.1 x 63.8 x 36.8
