snowyfox/Nibbles/hardware/pole/KFT.step

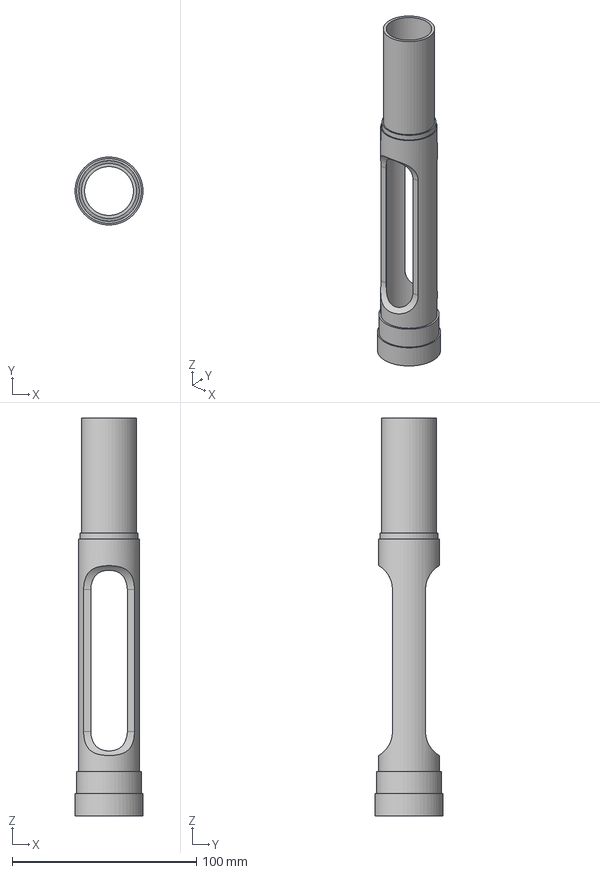
[picture p3: CAD file, 2026-10-30]
hardware/pole/KFT.step
36.9 x 36.9 x 215.9 mm
