snowyfox/Nibbles/hardware/pole/KTEKFT Lower.step

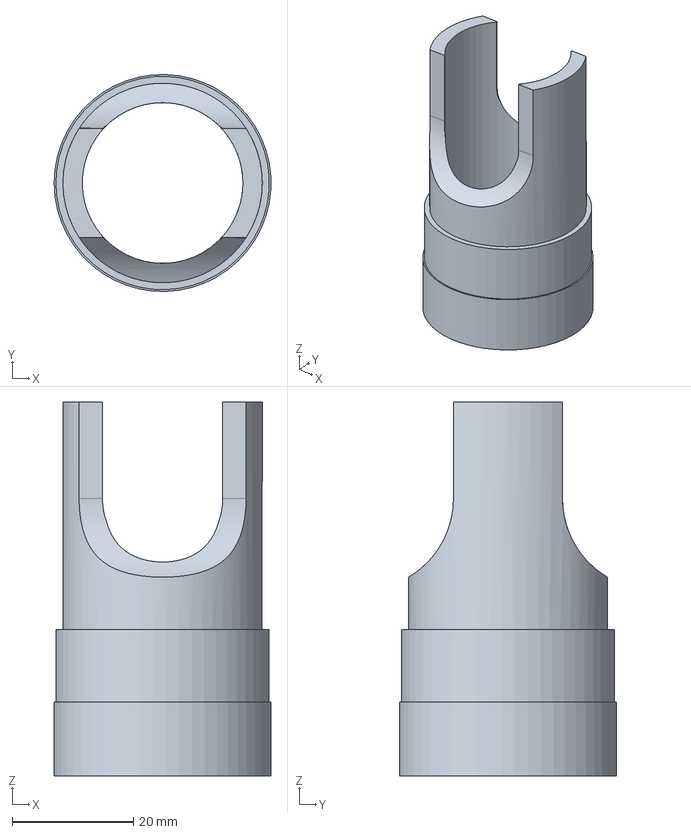
[picture p4: CAD file, 2026-10-30]
hardware/pole/KTEKFT Lower.step
35.8 x 35.8 x 61.7 mm
