snowyfox/Nibbles/hardware/pole/KTEKFT Upper.step

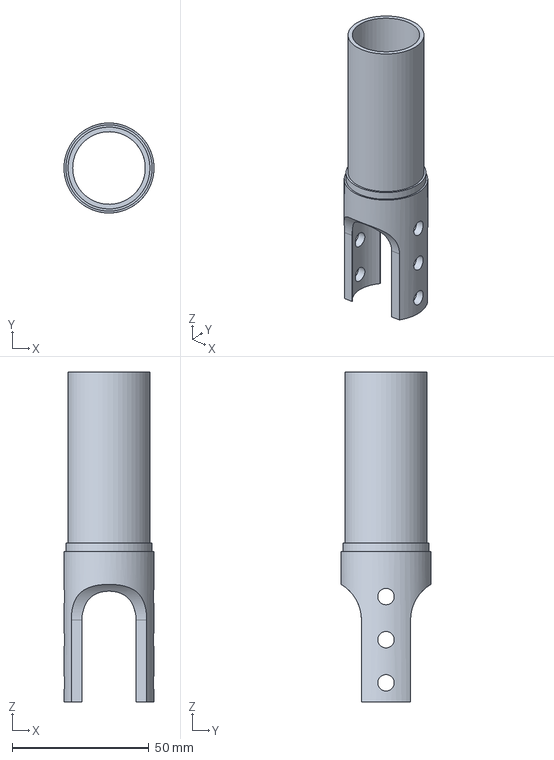
[picture p5: CAD file, 2026-10-30]
hardware/pole/KTEKFT Upper.step
32.9 x 32.9 x 120.5 mm
