snowyfox/Nibbles/hardware/keypad/key_dual2/key_dual2.kicad_pcb

## KiCad design hardware/keypad/key_dual2/key_dual2.kicad_pcb (2026-11-09)

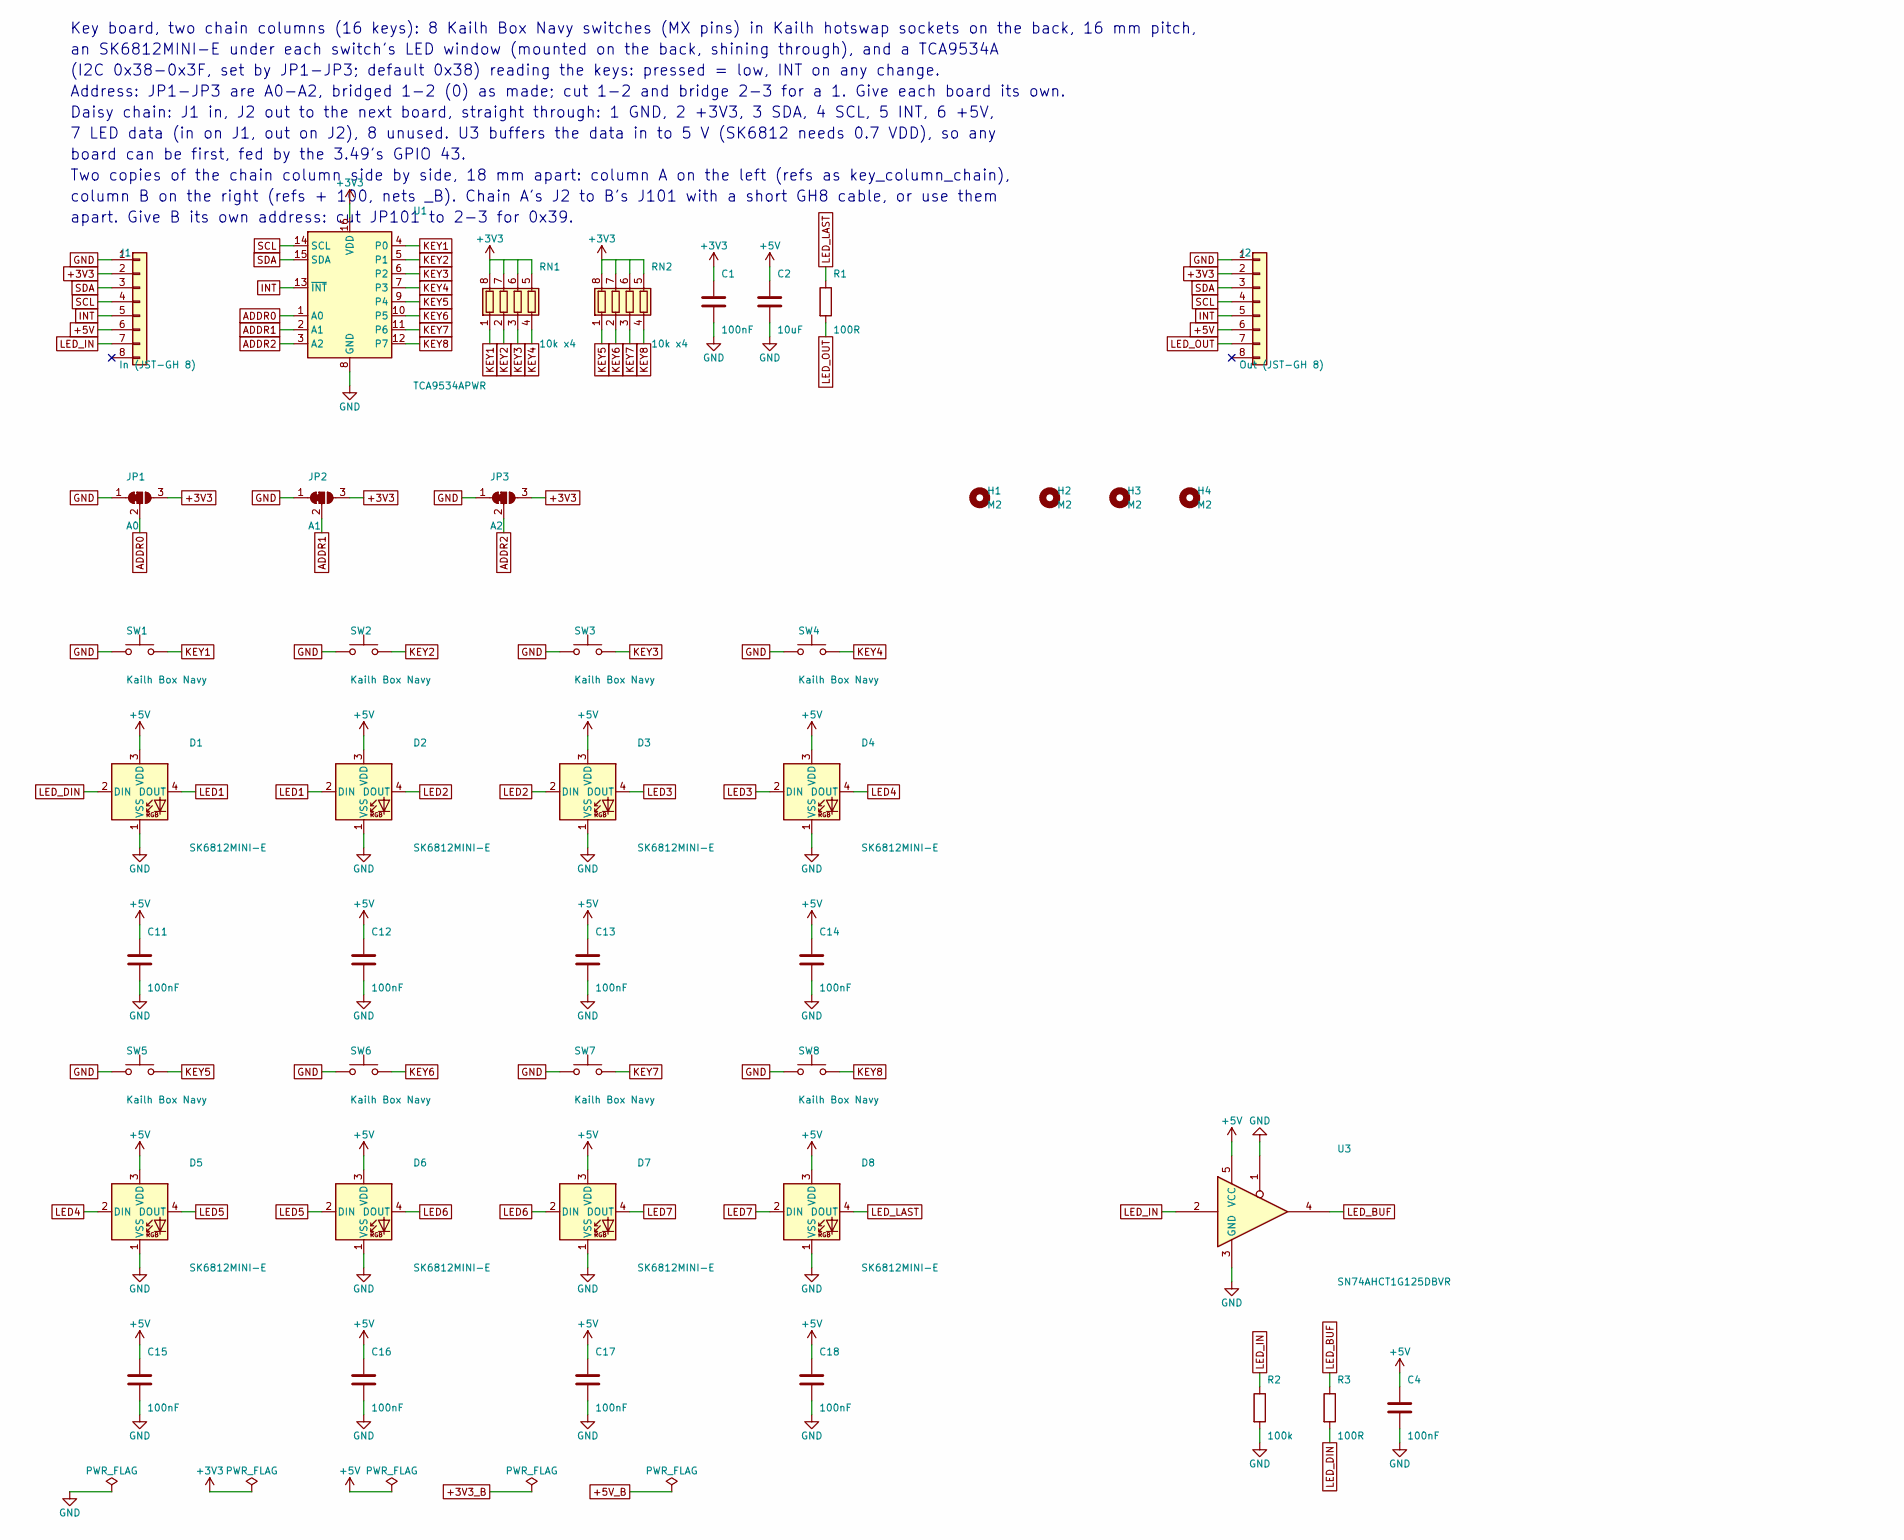
[picture p6: schematic key_dual2.kicad_sch, Key board, two chain columns (16 keys), part in row 1, column 1]

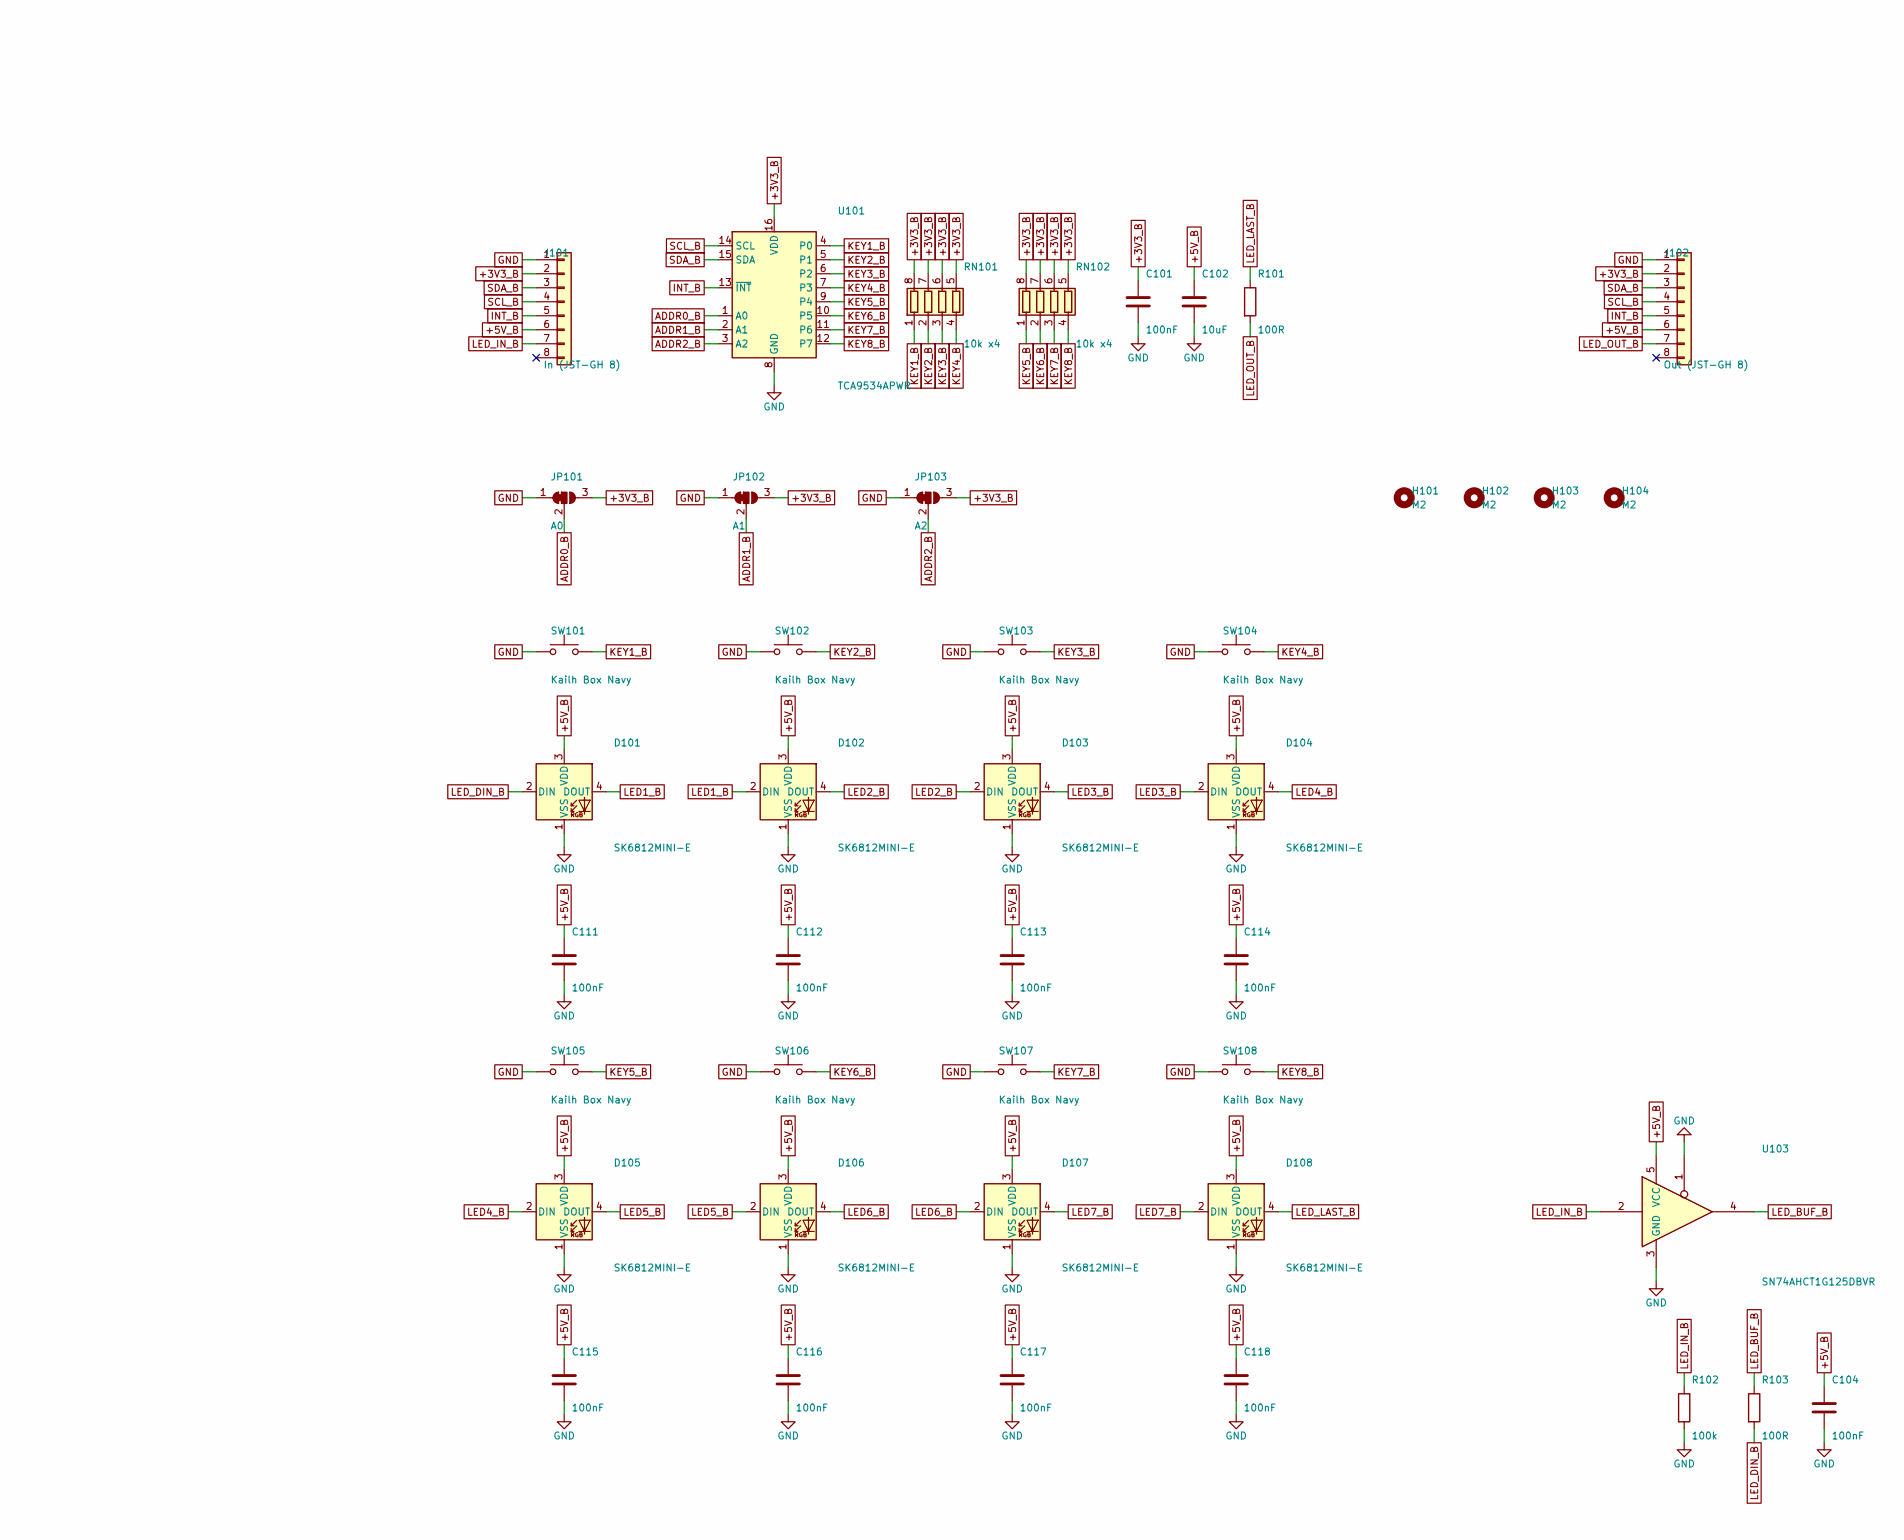
[picture p7: schematic key_dual2.kicad_sch, Key board, two chain columns (16 keys), part in row 1, column 2]

Parts:
C1, C4, C11, C12, C13, C14, C15, C16, C17, C18, C101, C104, C111, C112, C113, C114, C115, C116, C117, C118: 100nF; C_0603_1608Metric; LCSC C14663
C2, C102: 10uF; C_0805_2012Metric; LCSC C15850
D1, D2, D3, D4, D5, D6, D7, D8, D101, D102, D103, D104, D105, D106, D107, D108: SK6812MINI-E; LED_SK6812MINI-E_3.2x2.8mm_P1.5mm_ReverseMount; MPN SK6812MINI-E; LCSC C5149201
H1, H2, H3, H4, H101, H102, H103, H104: M2; MountingHole_2.2mm_M2
J1, J101: In (JST-GH 8); JST_GH_BM08B-GHS-TBT_1x08-1MP_P1.25mm_Vertical; MPN BM08B-GHS-TBT; LCSC C133062
J2, J102: Out (JST-GH 8); JST_GH_BM08B-GHS-TBT_1x08-1MP_P1.25mm_Vertical; MPN BM08B-GHS-TBT; LCSC C133062
JP1, JP101: A0; SolderJumper-3_P1.3mm_Bridged12_RoundedPad1.0x1.5mm_NumberL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
JP2, JP102: A1; SolderJumper-3_P1.3mm_Bridged12_RoundedPad1.0x1.5mm_NumberL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
JP3, JP103: A2; SolderJumper-3_P1.3mm_Bridged12_RoundedPad1.0x1.5mm_NumberL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
R1, R3, R101, R103: 100R; R_0603_1608Metric; LCSC C22775
R2, R102: 100k; R_0603_1608Metric; LCSC C25803
RN1, RN2, RN101, RN102: 10k x4; R_Array_Convex_4x0603; MPN 4D03WGJ0103T5E; LCSC C29718
SW1, SW2, SW3, SW4, SW5, SW6, SW7, SW8, SW101, SW102, SW103, SW104, SW105, SW106, SW107, SW108: Kailh Box Navy; SW_Kailh_MX_Hotswap; MPN Kailh CPG151101S11 socket; LCSC C41430893
U1, U101: TCA9534APWR; TSSOP-16_4.4x5mm_P0.65mm; MPN TCA9534APWR; LCSC C206010
U3, U103: SN74AHCT1G125DBVR; SOT-23-5; MPN SN74AHCT1G125DBVR; LCSC C7484

Connections:
+3V3: C1.1, J1.2, J2.2, JP1.3 (B), JP2.3 (B), JP3.3 (B), RN1.5 (R4.2), RN1.6 (R3.2), RN1.7 (R2.2), RN1.8 (R1.2), RN2.5 (R4.2), RN2.6 (R3.2), RN2.7 (R2.2), RN2.8 (R1.2), U1.16 (VDD)
+3V3_B: C101.1, J101.2, J102.2, JP101.3 (B), JP102.3 (B), JP103.3 (B), RN101.5 (R4.2), RN101.6 (R3.2), RN101.7 (R2.2), RN101.8 (R1.2), RN102.5 (R4.2), RN102.6 (R3.2), RN102.7 (R2.2), RN102.8 (R1.2), U101.16 (VDD)
+5V: C2.1, C4.1, C11.1, C12.1, C13.1, C14.1, C15.1, C16.1, C17.1, C18.1, D1.3 (VDD), D2.3 (VDD), D3.3 (VDD), D4.3 (VDD), D5.3 (VDD), D6.3 (VDD), D7.3 (VDD), D8.3 (VDD), J1.6, J2.6, U3.5 (VCC)
+5V_B: C102.1, C104.1, C111.1, C112.1, C113.1, C114.1, C115.1, C116.1, C117.1, C118.1, D101.3 (VDD), D102.3 (VDD), D103.3 (VDD), D104.3 (VDD), D105.3 (VDD), D106.3 (VDD), D107.3 (VDD), D108.3 (VDD), J101.6, J102.6, U103.5 (VCC)
ADDR0: JP1.2 (C), U1.1 (A0)
ADDR0_B: JP101.2 (C), U101.1 (A0)
ADDR1: JP2.2 (C), U1.2 (A1)
ADDR1_B: JP102.2 (C), U101.2 (A1)
ADDR2: JP3.2 (C), U1.3 (A2)
ADDR2_B: JP103.2 (C), U101.3 (A2)
GND: C1.2, C2.2, C4.2, C11.2, C12.2, C13.2, C14.2, C15.2, C16.2, C17.2, C18.2, C101.2, C102.2, C104.2, C111.2, C112.2, C113.2, C114.2, C115.2, C116.2, C117.2, C118.2, D1.1 (VSS), D2.1 (VSS), D3.1 (VSS), D4.1 (VSS), D5.1 (VSS), D6.1 (VSS), D7.1 (VSS), D8.1 (VSS), D101.1 (VSS), D102.1 (VSS), D103.1 (VSS), D104.1 (VSS), D105.1 (VSS), D106.1 (VSS), D107.1 (VSS), D108.1 (VSS), J1.1, J2.1, J101.1, J102.1, JP1.1 (A), JP2.1 (A), JP3.1 (A), JP101.1 (A), JP102.1 (A), JP103.1 (A), R2.2, R102.2, SW1.1, SW2.1, SW3.1, SW4.1, SW5.1, SW6.1, SW7.1, SW8.1, SW101.1, SW102.1, SW103.1, SW104.1, SW105.1, SW106.1, SW107.1, SW108.1, U1.8 (GND), U3.1, U3.3 (GND), U101.8 (GND), U103.1, U103.3 (GND)
INT: J1.5, J2.5, U1.13 (~INT)
INT_B: J101.5, J102.5, U101.13 (~INT)
KEY1: RN1.1 (R1.1), SW1.2, U1.4 (P0)
KEY1_B: RN101.1 (R1.1), SW101.2, U101.4 (P0)
KEY2: RN1.2 (R2.1), SW2.2, U1.5 (P1)
KEY2_B: RN101.2 (R2.1), SW102.2, U101.5 (P1)
KEY3: RN1.3 (R3.1), SW3.2, U1.6 (P2)
KEY3_B: RN101.3 (R3.1), SW103.2, U101.6 (P2)
KEY4: RN1.4 (R4.1), SW4.2, U1.7 (P3)
KEY4_B: RN101.4 (R4.1), SW104.2, U101.7 (P3)
KEY5: RN2.1 (R1.1), SW5.2, U1.9 (P4)
KEY5_B: RN102.1 (R1.1), SW105.2, U101.9 (P4)
KEY6: RN2.2 (R2.1), SW6.2, U1.10 (P5)
KEY6_B: RN102.2 (R2.1), SW106.2, U101.10 (P5)
KEY7: RN2.3 (R3.1), SW7.2, U1.11 (P6)
KEY7_B: RN102.3 (R3.1), SW107.2, U101.11 (P6)
KEY8: RN2.4 (R4.1), SW8.2, U1.12 (P7)
KEY8_B: RN102.4 (R4.1), SW108.2, U101.12 (P7)
LED1: D1.4 (DOUT), D2.2 (DIN)
LED1_B: D101.4 (DOUT), D102.2 (DIN)
LED2: D2.4 (DOUT), D3.2 (DIN)
LED2_B: D102.4 (DOUT), D103.2 (DIN)
LED3: D3.4 (DOUT), D4.2 (DIN)
LED3_B: D103.4 (DOUT), D104.2 (DIN)
LED4: D4.4 (DOUT), D5.2 (DIN)
LED4_B: D104.4 (DOUT), D105.2 (DIN)
LED5: D5.4 (DOUT), D6.2 (DIN)
LED5_B: D105.4 (DOUT), D106.2 (DIN)
LED6: D6.4 (DOUT), D7.2 (DIN)
LED6_B: D106.4 (DOUT), D107.2 (DIN)
LED7: D7.4 (DOUT), D8.2 (DIN)
LED7_B: D107.4 (DOUT), D108.2 (DIN)
LED_BUF: R3.1, U3.4
LED_BUF_B: R103.1, U103.4
LED_DIN: D1.2 (DIN), R3.2
LED_DIN_B: D101.2 (DIN), R103.2
LED_IN: J1.7, R2.1, U3.2
LED_IN_B: J101.7, R102.1, U103.2
LED_LAST: D8.4 (DOUT), R1.1
LED_LAST_B: D108.4 (DOUT), R101.1
LED_OUT: J2.7, R1.2
LED_OUT_B: J102.7, R101.2
SCL: J1.4, J2.4, U1.14 (SCL)
SCL_B: J101.4, J102.4, U101.14 (SCL)
SDA: J1.3, J2.3, U1.15 (SDA)
SDA_B: J101.3, J102.3, U101.15 (SDA)

Notes on the sheet:
Key board, two chain columns (16 keys): 8 Kailh Box Navy switches (MX pins) in Kailh hotswap sockets on the back, 16 mm pitch,
an SK6812MINI-E under each switch's LED window (mounted on the back, shining through), and a TCA9534A
(I2C 0x38-0x3F, set by JP1-JP3; default 0x38) reading the keys: pressed = low, INT on any change.
Address: JP1-JP3 are A0-A2, bridged 1-2 (0) as made; cut 1-2 and bridge 2-3 for a 1. Give each board its own.
Daisy chain: J1 in, J2 out to the next board, straight through: 1 GND, 2 +3V3, 3 SDA, 4 SCL, 5 INT, 6 +5V,
7 LED data (in on J1, out on J2), 8 unused. U3 buffers the data in to 5 V (SK6812 needs 0.7 VDD), so any
board can be first, fed by the 3.49's GPIO 43.
Two copies of the chain column side by side, 18 mm apart: column A on the left (refs as key_column_chain),
column B on the right (refs + 100, nets _B). Chain A's J2 to B's J101 with a short GH8 cable, or use them
apart. Give B its own address: cut JP101 to 2-3 for 0x39.

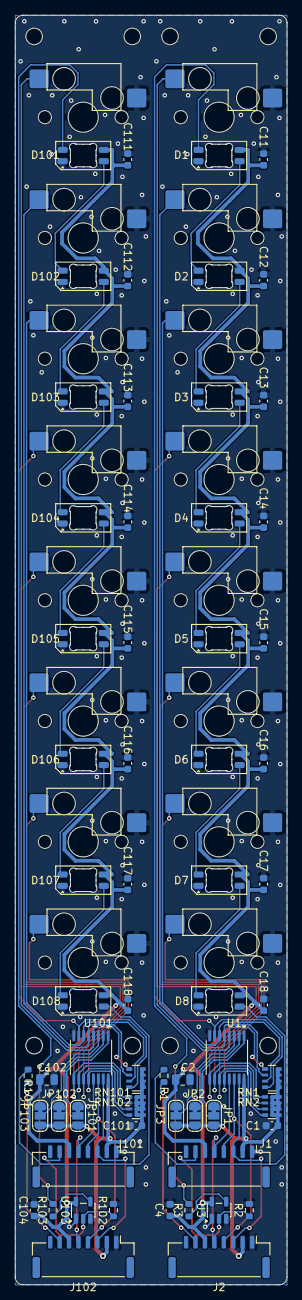
[picture p8: board key_dual2.kicad_pcb from below]

Board: 2 copper layers, 36.0 x 168.2 mm, 86 parts (62 on the bottom side), 57 nets.
