snowyfox/Nibbles/hardware/keypad/key_hub/key_hub.kicad_pcb

## KiCad design hardware/keypad/key_hub/key_hub.kicad_pcb (2026-11-04)

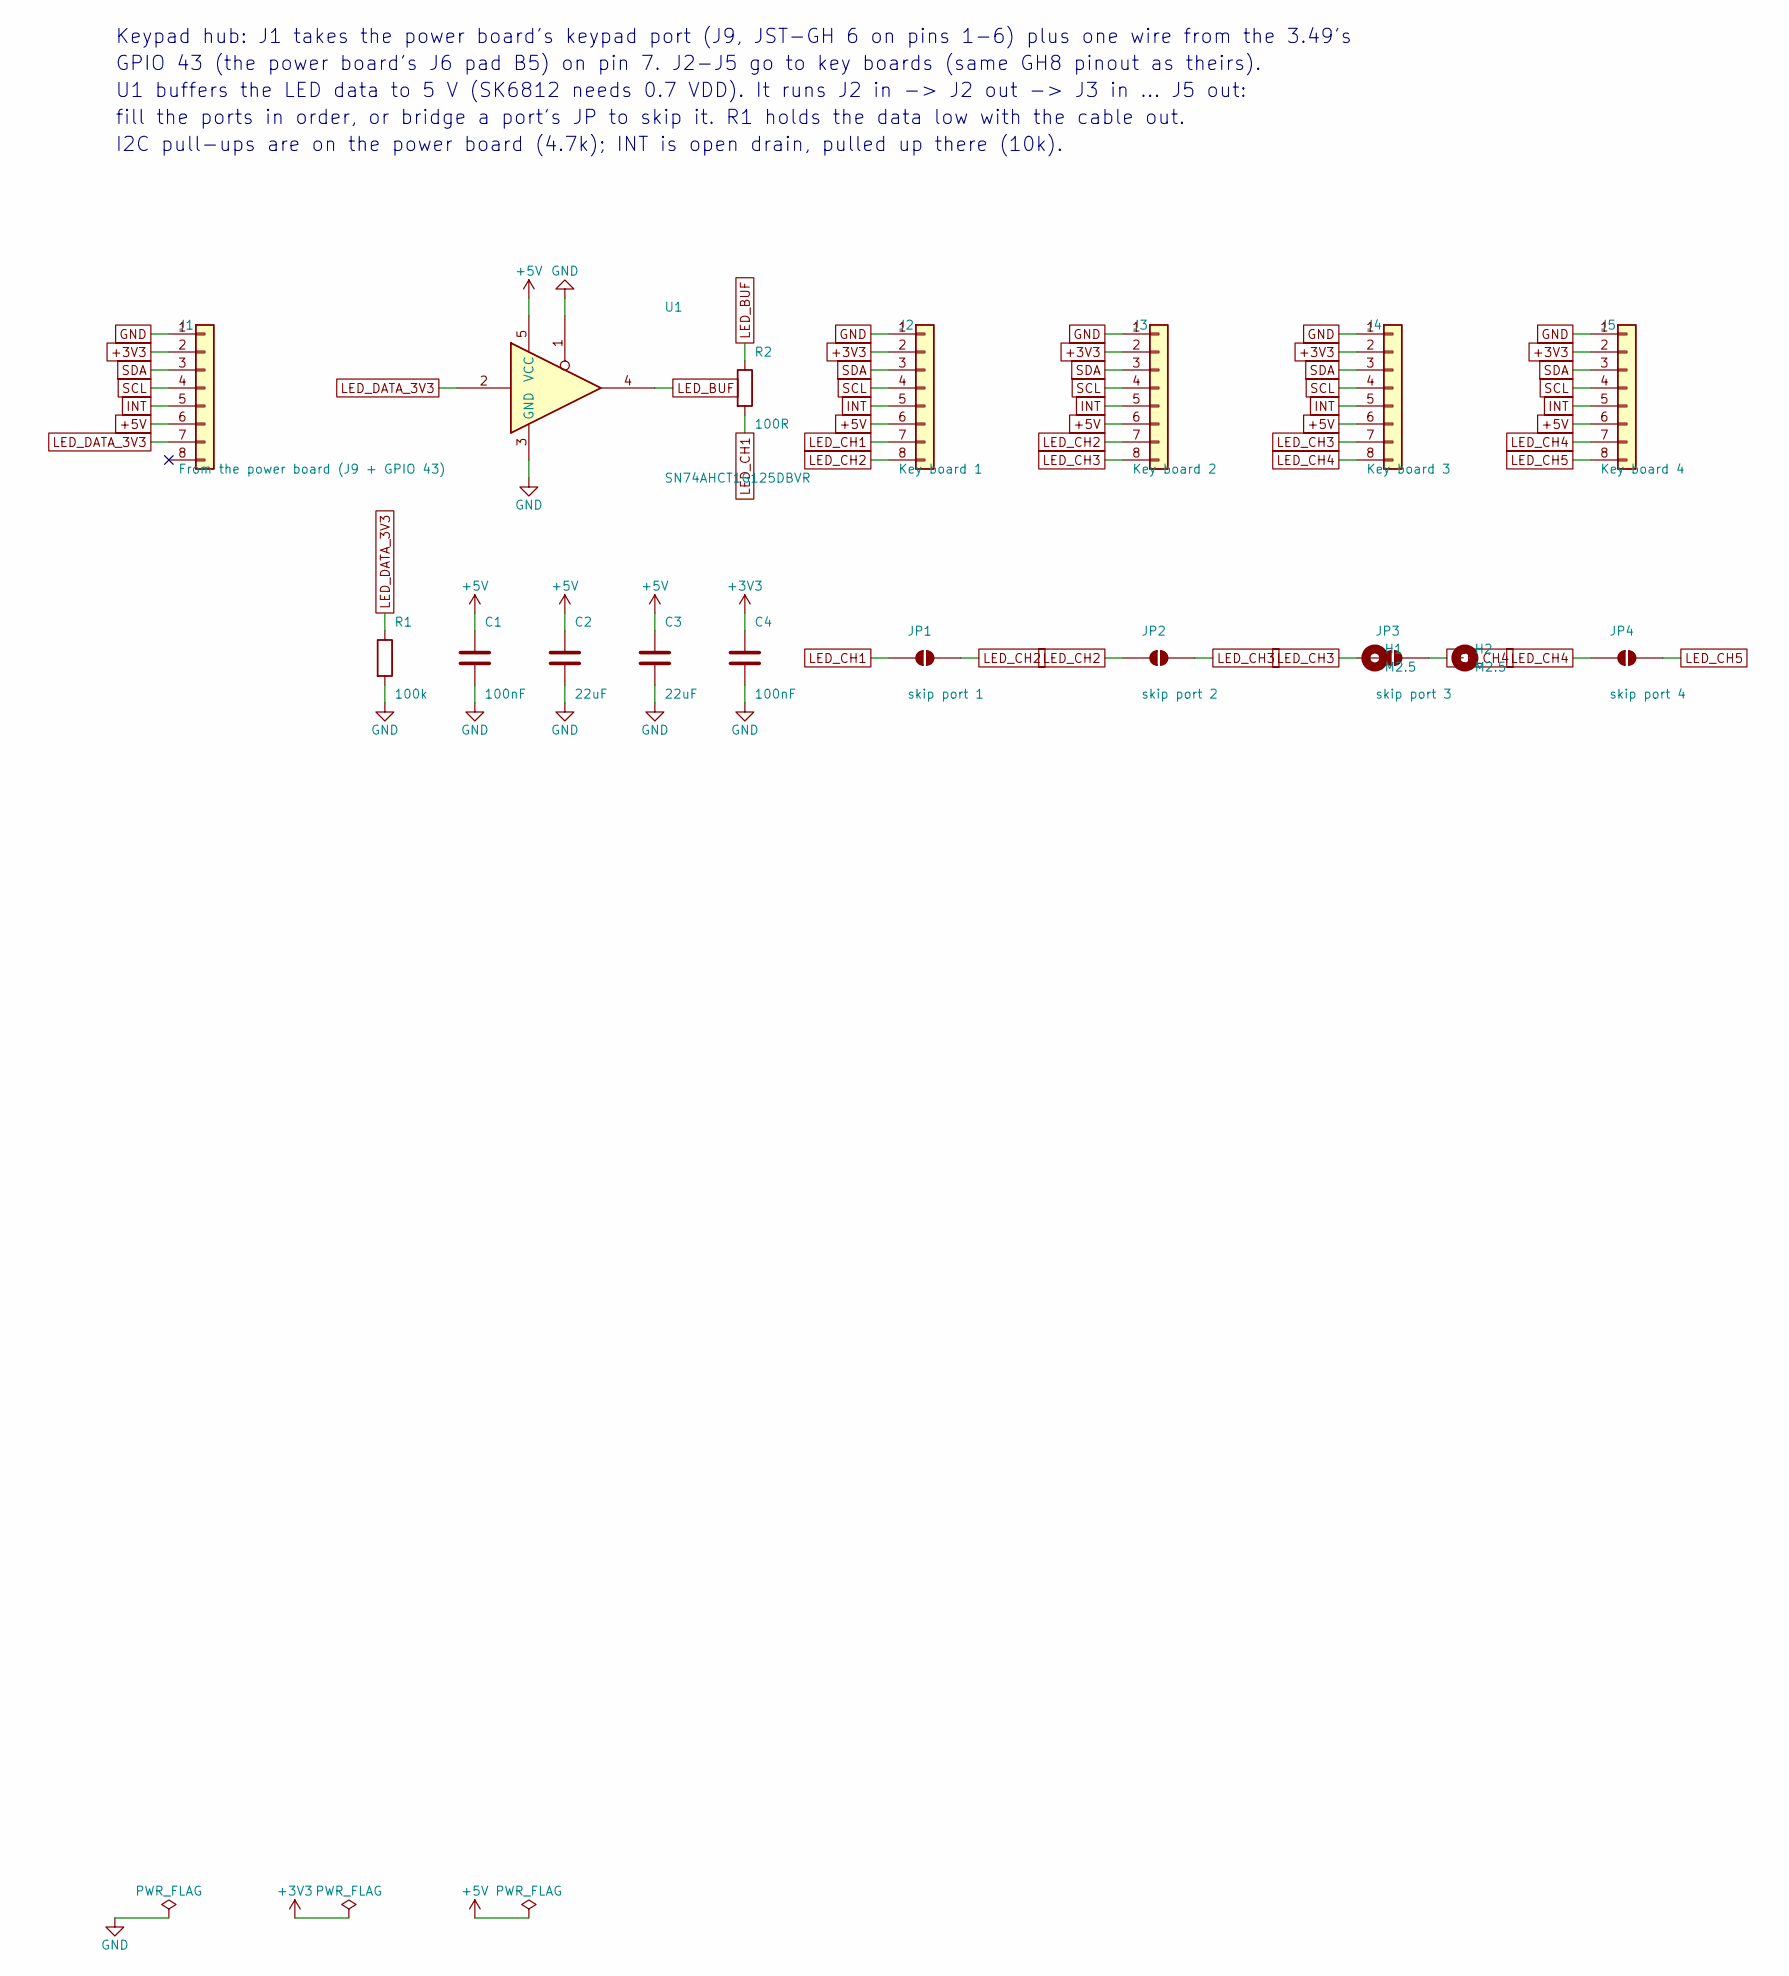
[picture p9: schematic key_hub.kicad_sch, Keypad hub]

Parts:
C1, C4: 100nF; C_0603_1608Metric; LCSC C14663
C2, C3: 22uF; C_0805_2012Metric; LCSC C45783
H1, H2: M2.5; MountingHole_2.7mm_M2.5
J1: From the power board (J9 + GPIO 43); JST_GH_BM08B-GHS-TBT_1x08-1MP_P1.25mm_Vertical; MPN BM08B-GHS-TBT; LCSC C133062
J2: Key board 1; JST_GH_BM08B-GHS-TBT_1x08-1MP_P1.25mm_Vertical; MPN BM08B-GHS-TBT; LCSC C133062
J3: Key board 2; JST_GH_BM08B-GHS-TBT_1x08-1MP_P1.25mm_Vertical; MPN BM08B-GHS-TBT; LCSC C133062
J4: Key board 3; JST_GH_BM08B-GHS-TBT_1x08-1MP_P1.25mm_Vertical; MPN BM08B-GHS-TBT; LCSC C133062
J5: Key board 4; JST_GH_BM08B-GHS-TBT_1x08-1MP_P1.25mm_Vertical; MPN BM08B-GHS-TBT; LCSC C133062
JP1: skip port 1; SolderJumper-2_P1.3mm_Open_RoundedPad1.0x1.5mm
JP2: skip port 2; SolderJumper-2_P1.3mm_Open_RoundedPad1.0x1.5mm
JP3: skip port 3; SolderJumper-2_P1.3mm_Open_RoundedPad1.0x1.5mm
JP4: skip port 4; SolderJumper-2_P1.3mm_Open_RoundedPad1.0x1.5mm
R1: 100k; R_0603_1608Metric; LCSC C25803
R2: 100R; R_0603_1608Metric; LCSC C22775
U1: SN74AHCT1G125DBVR; SOT-23-5; MPN SN74AHCT1G125DBVR; LCSC C7484

Connections:
+3V3: C4.1, J1.2, J2.2, J3.2, J4.2, J5.2
+5V: C1.1, C2.1, C3.1, J1.6, J2.6, J3.6, J4.6, J5.6, U1.5 (VCC)
GND: C1.2, C2.2, C3.2, C4.2, J1.1, J2.1, J3.1, J4.1, J5.1, R1.2, U1.1, U1.3 (GND)
INT: J1.5, J2.5, J3.5, J4.5, J5.5
LED_BUF: R2.1, U1.4
LED_CH1: J2.7, JP1.1 (A), R2.2
LED_CH2: J2.8, J3.7, JP1.2 (B), JP2.1 (A)
LED_CH3: J3.8, J4.7, JP2.2 (B), JP3.1 (A)
LED_CH4: J4.8, J5.7, JP3.2 (B), JP4.1 (A)
LED_CH5: J5.8, JP4.2 (B)
LED_DATA_3V3: J1.7, R1.1, U1.2
SCL: J1.4, J2.4, J3.4, J4.4, J5.4
SDA: J1.3, J2.3, J3.3, J4.3, J5.3

Notes on the sheet:
Keypad hub: J1 takes the power board's keypad port (J9, JST-GH 6 on pins 1-6) plus one wire from the 3.49's
GPIO 43 (the power board's J6 pad B5) on pin 7. J2-J5 go to key boards (same GH8 pinout as theirs).
U1 buffers the LED data to 5 V (SK6812 needs 0.7 VDD). It runs J2 in -> J2 out -> J3 in ... J5 out:
fill the ports in order, or bridge a port's JP to skip it. R1 holds the data low with the cable out.
I2C pull-ups are on the power board (4.7k); INT is open drain, pulled up there (10k).

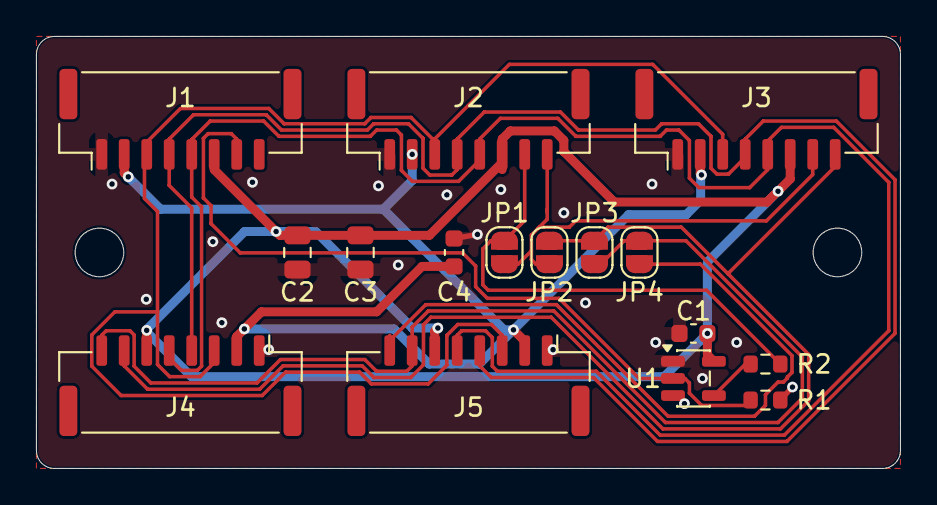
[picture p10: board key_hub.kicad_pcb from above]

Board: 2 copper layers, 48.0 x 24.0 mm, 18 parts (0 on the bottom side), 13 nets.
