snowyfox/Nibbles/hardware/power_charger_board/kicad/nibbles_power_charger.kicad_pcb

## KiCad design hardware/power_charger_board/kicad/nibbles_power_charger.kicad_pcb (2026-10-28)

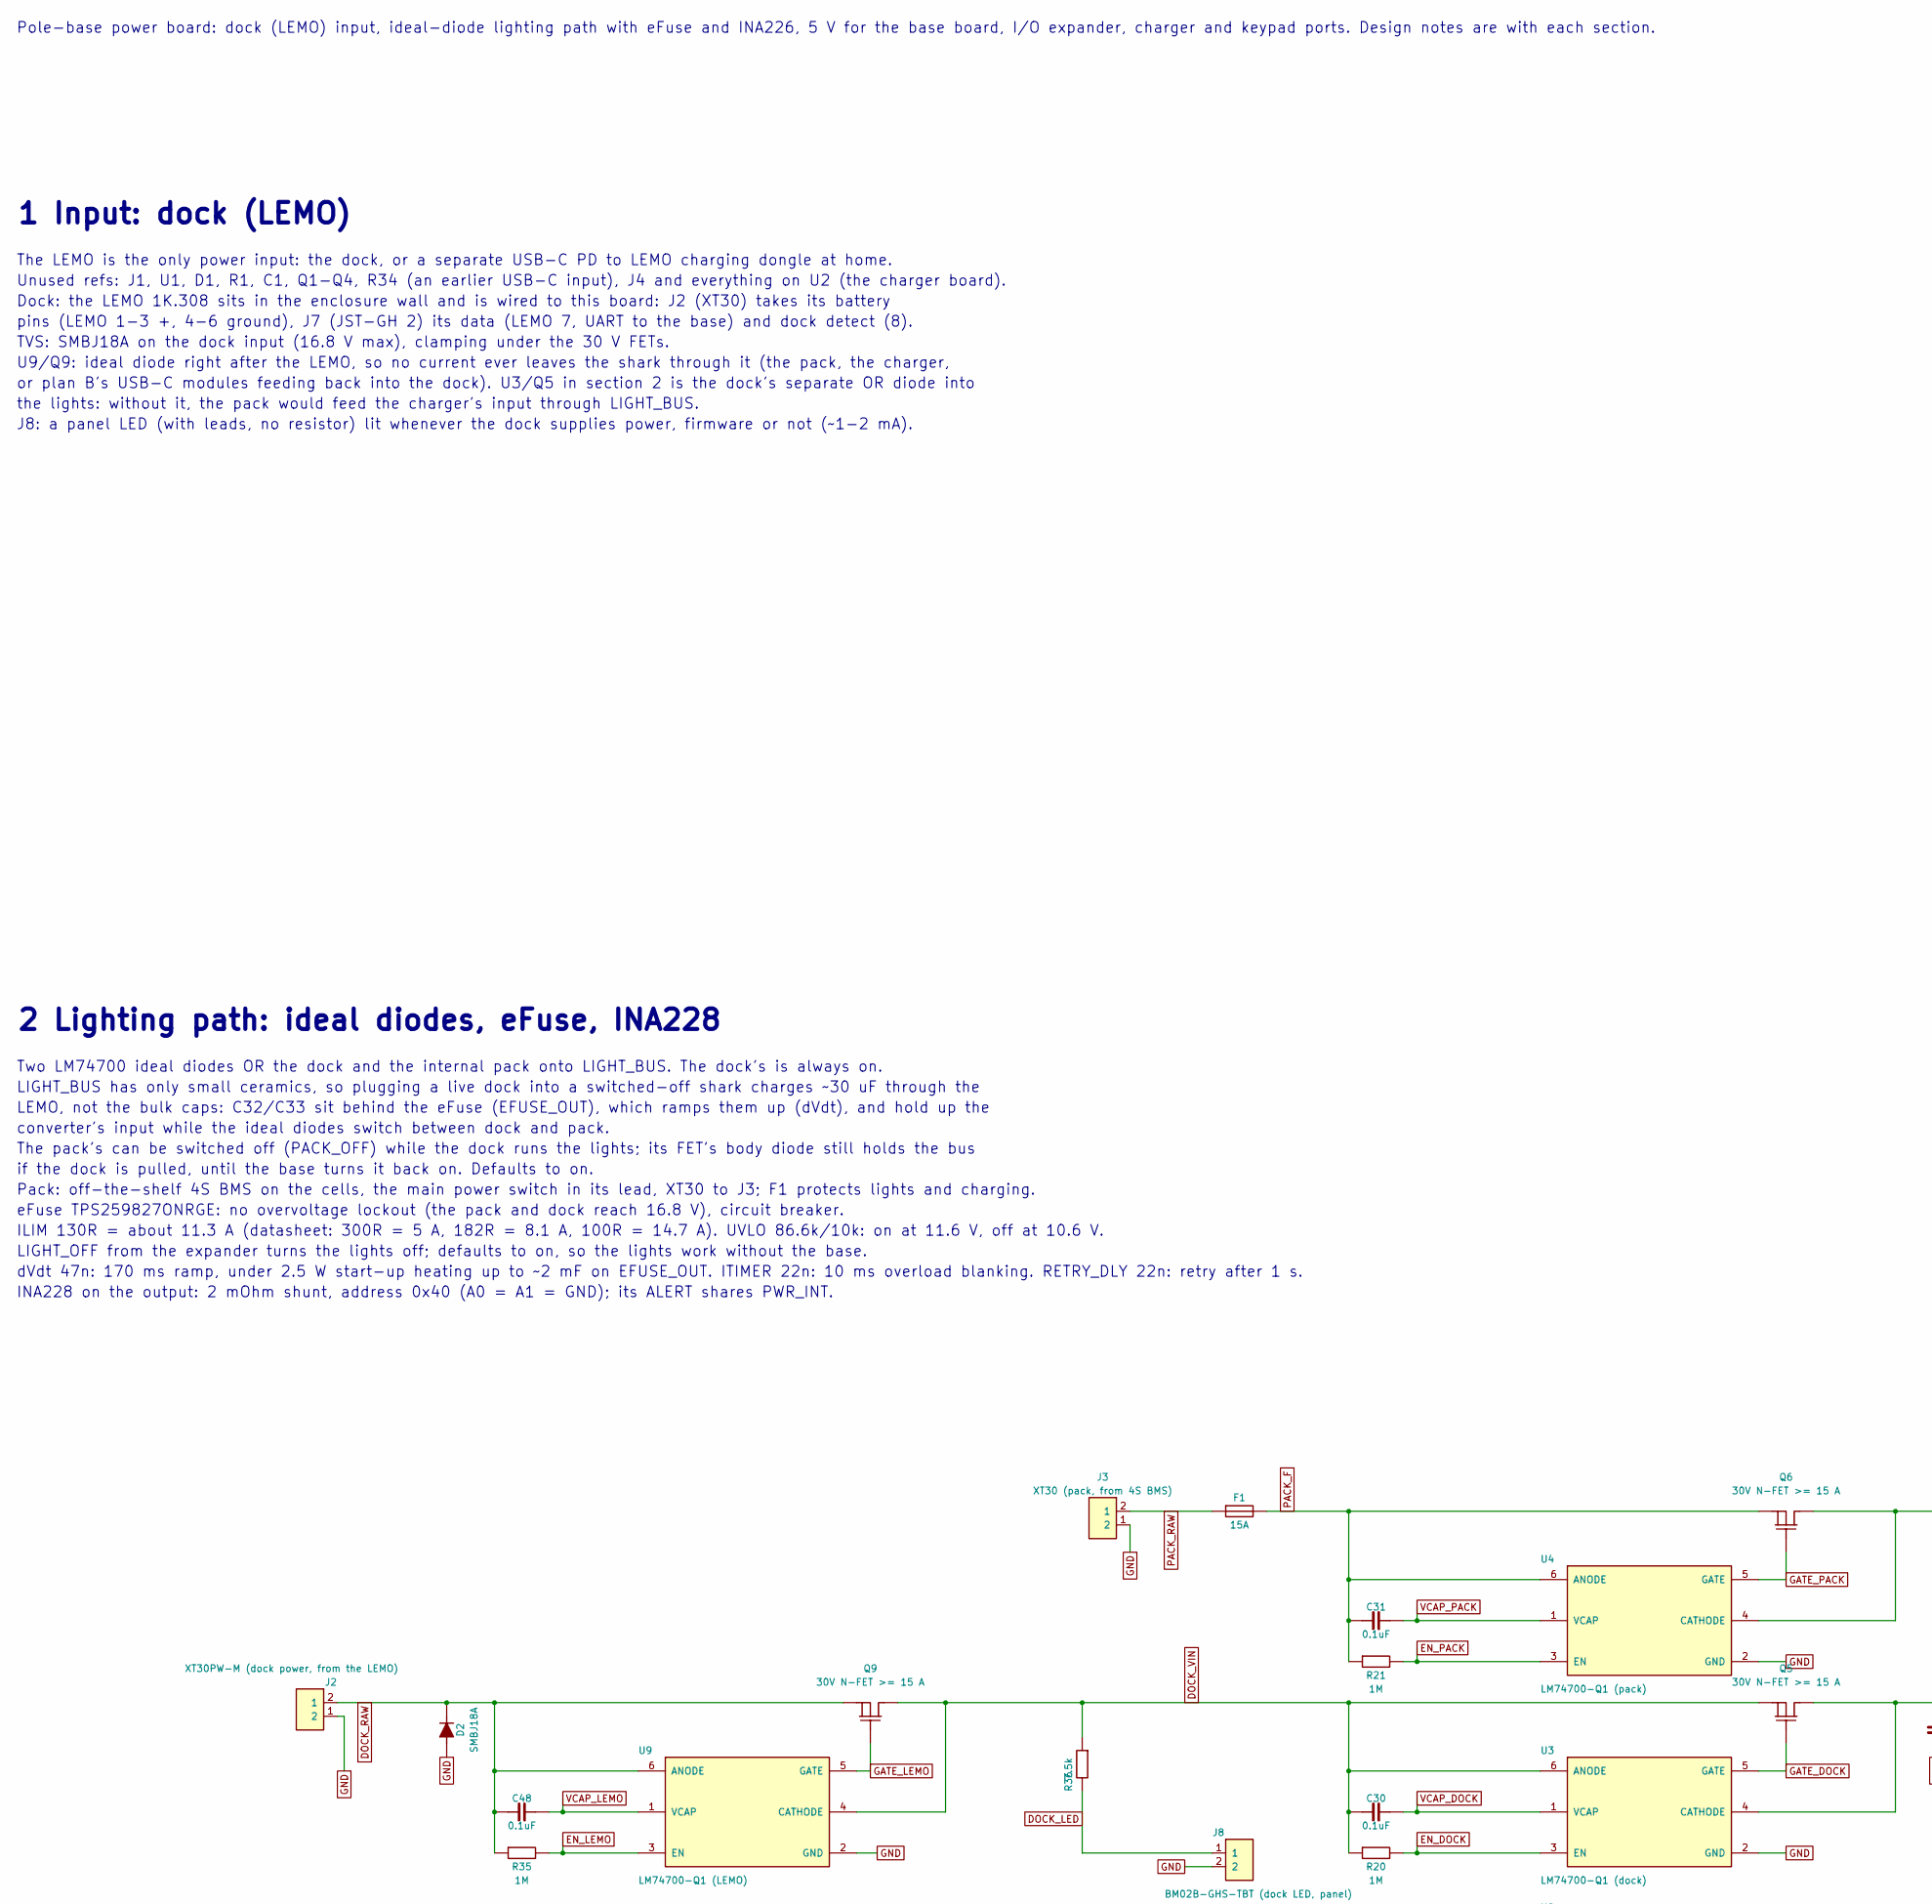
[picture p11: schematic nibbles_power_charger.kicad_sch, Nibbles power board + charger, part in row 1, column 1]

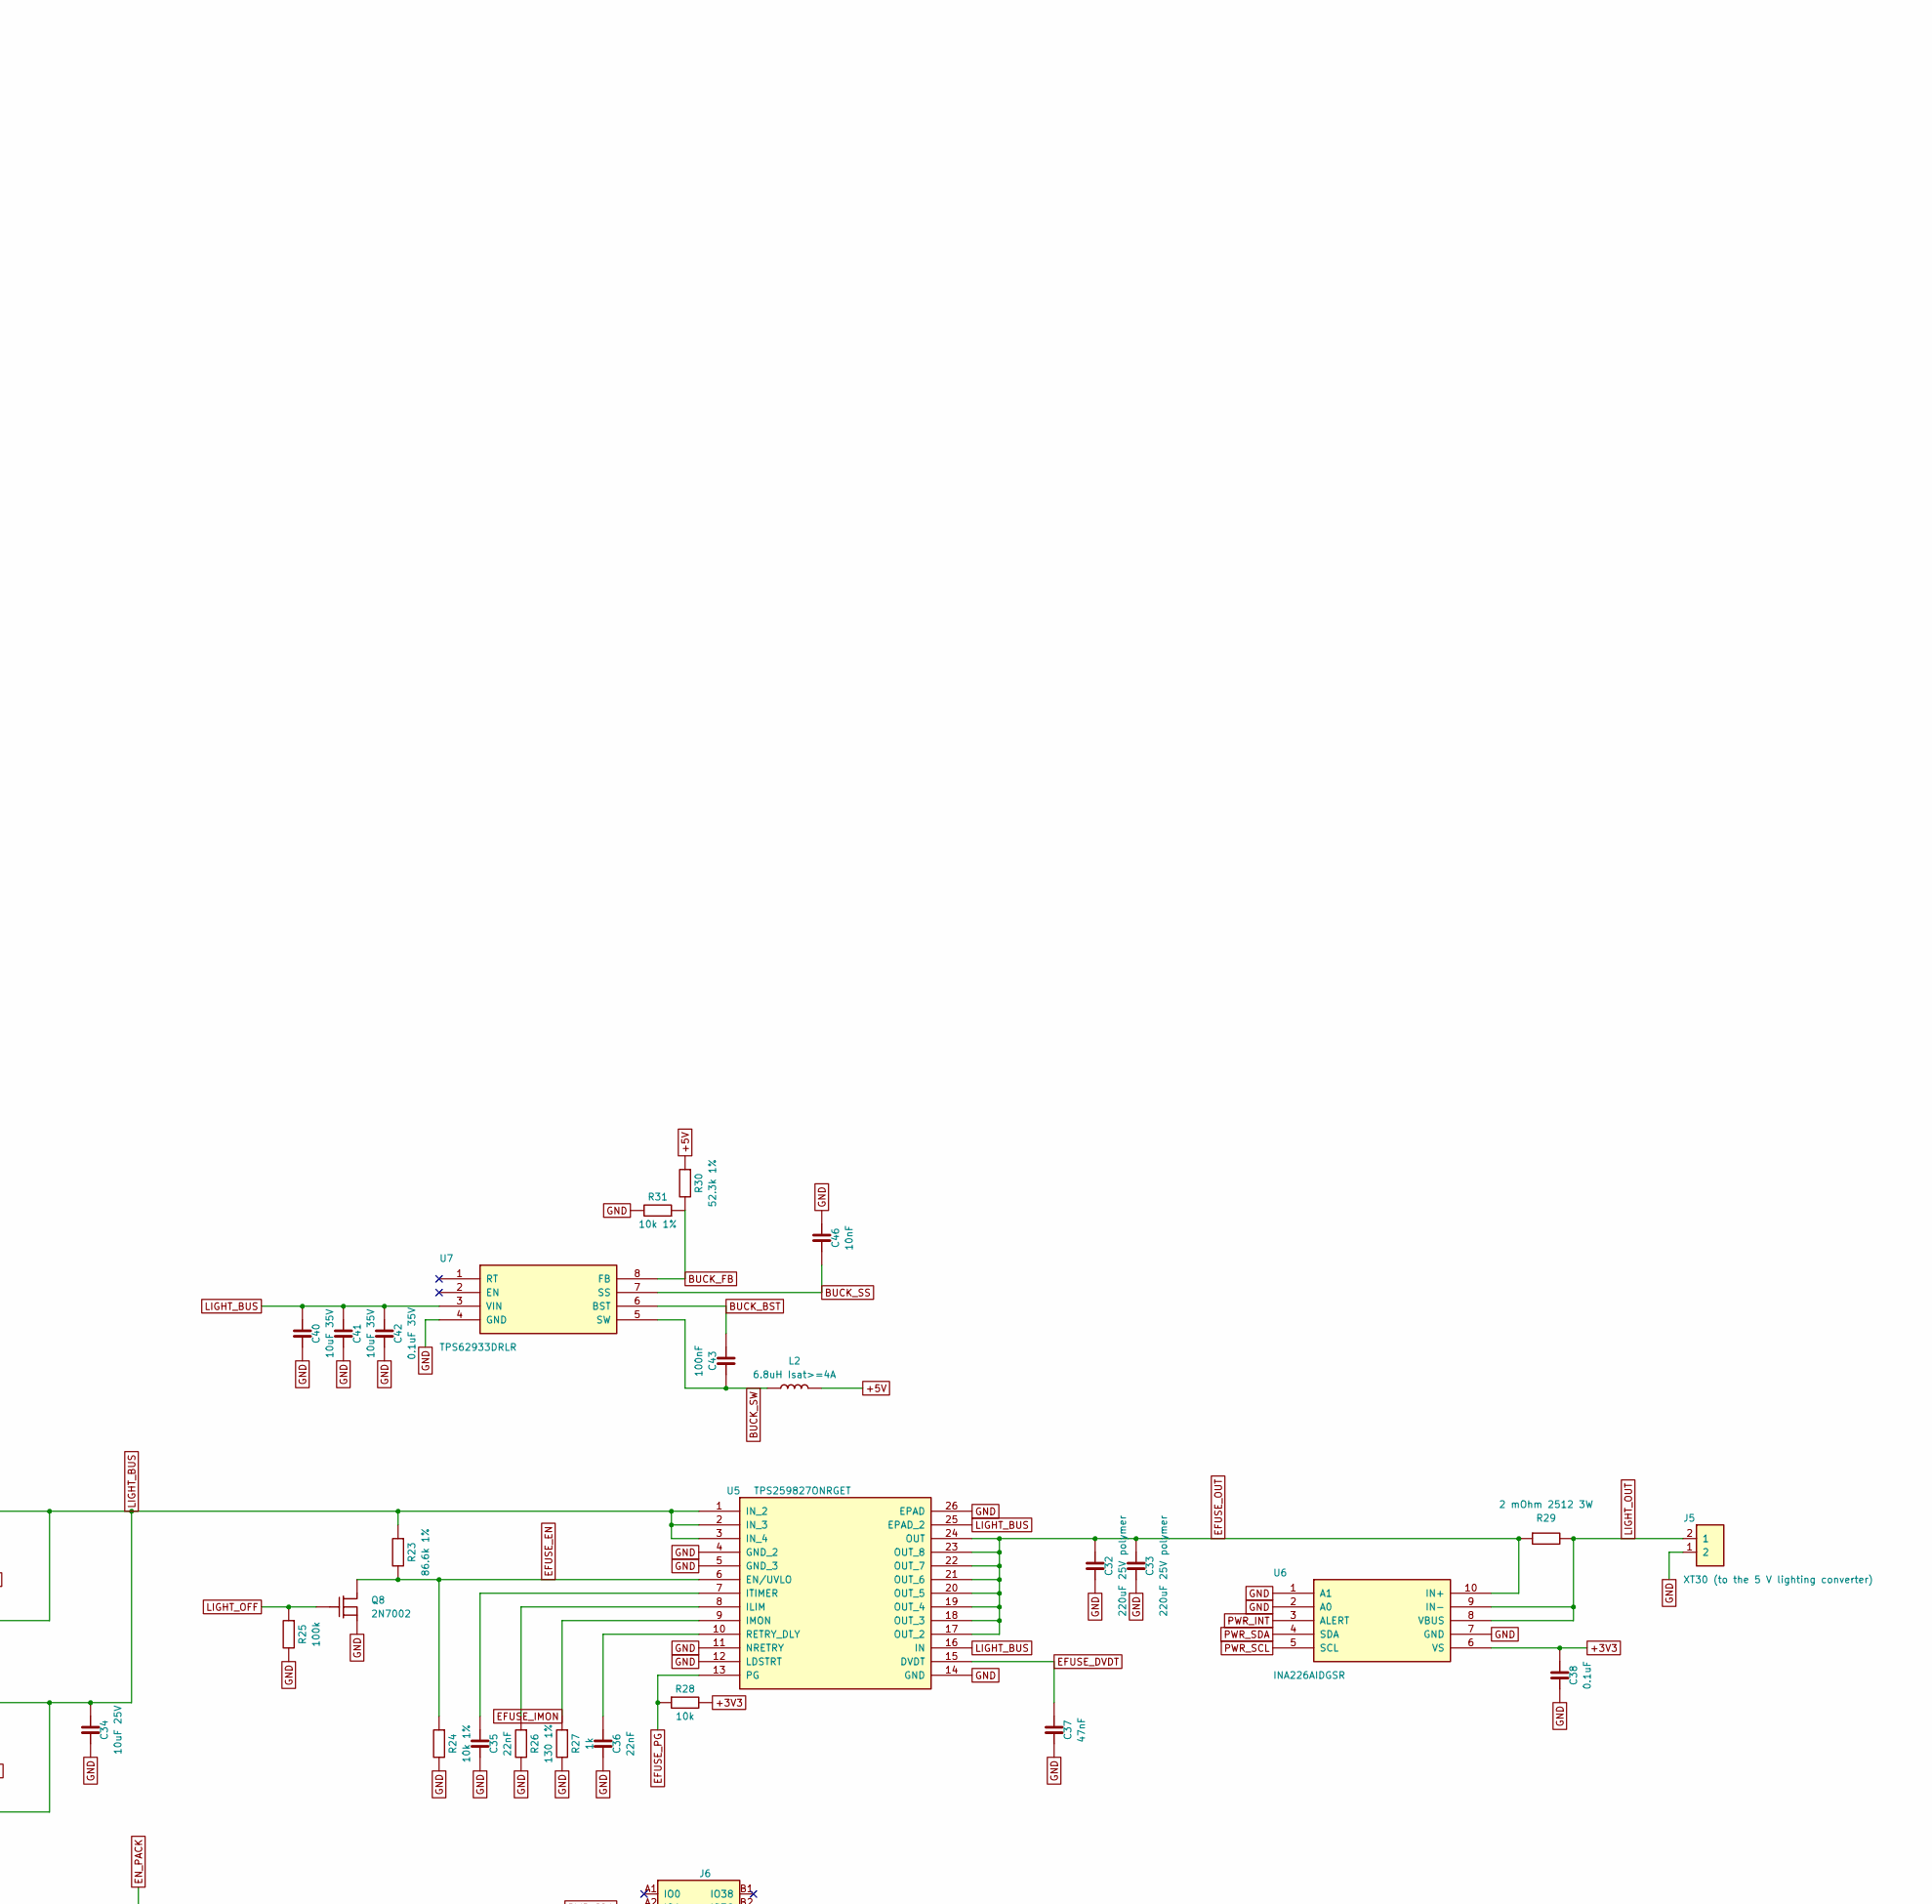
[picture p12: schematic nibbles_power_charger.kicad_sch, Nibbles power board + charger, part in row 1, column 2]

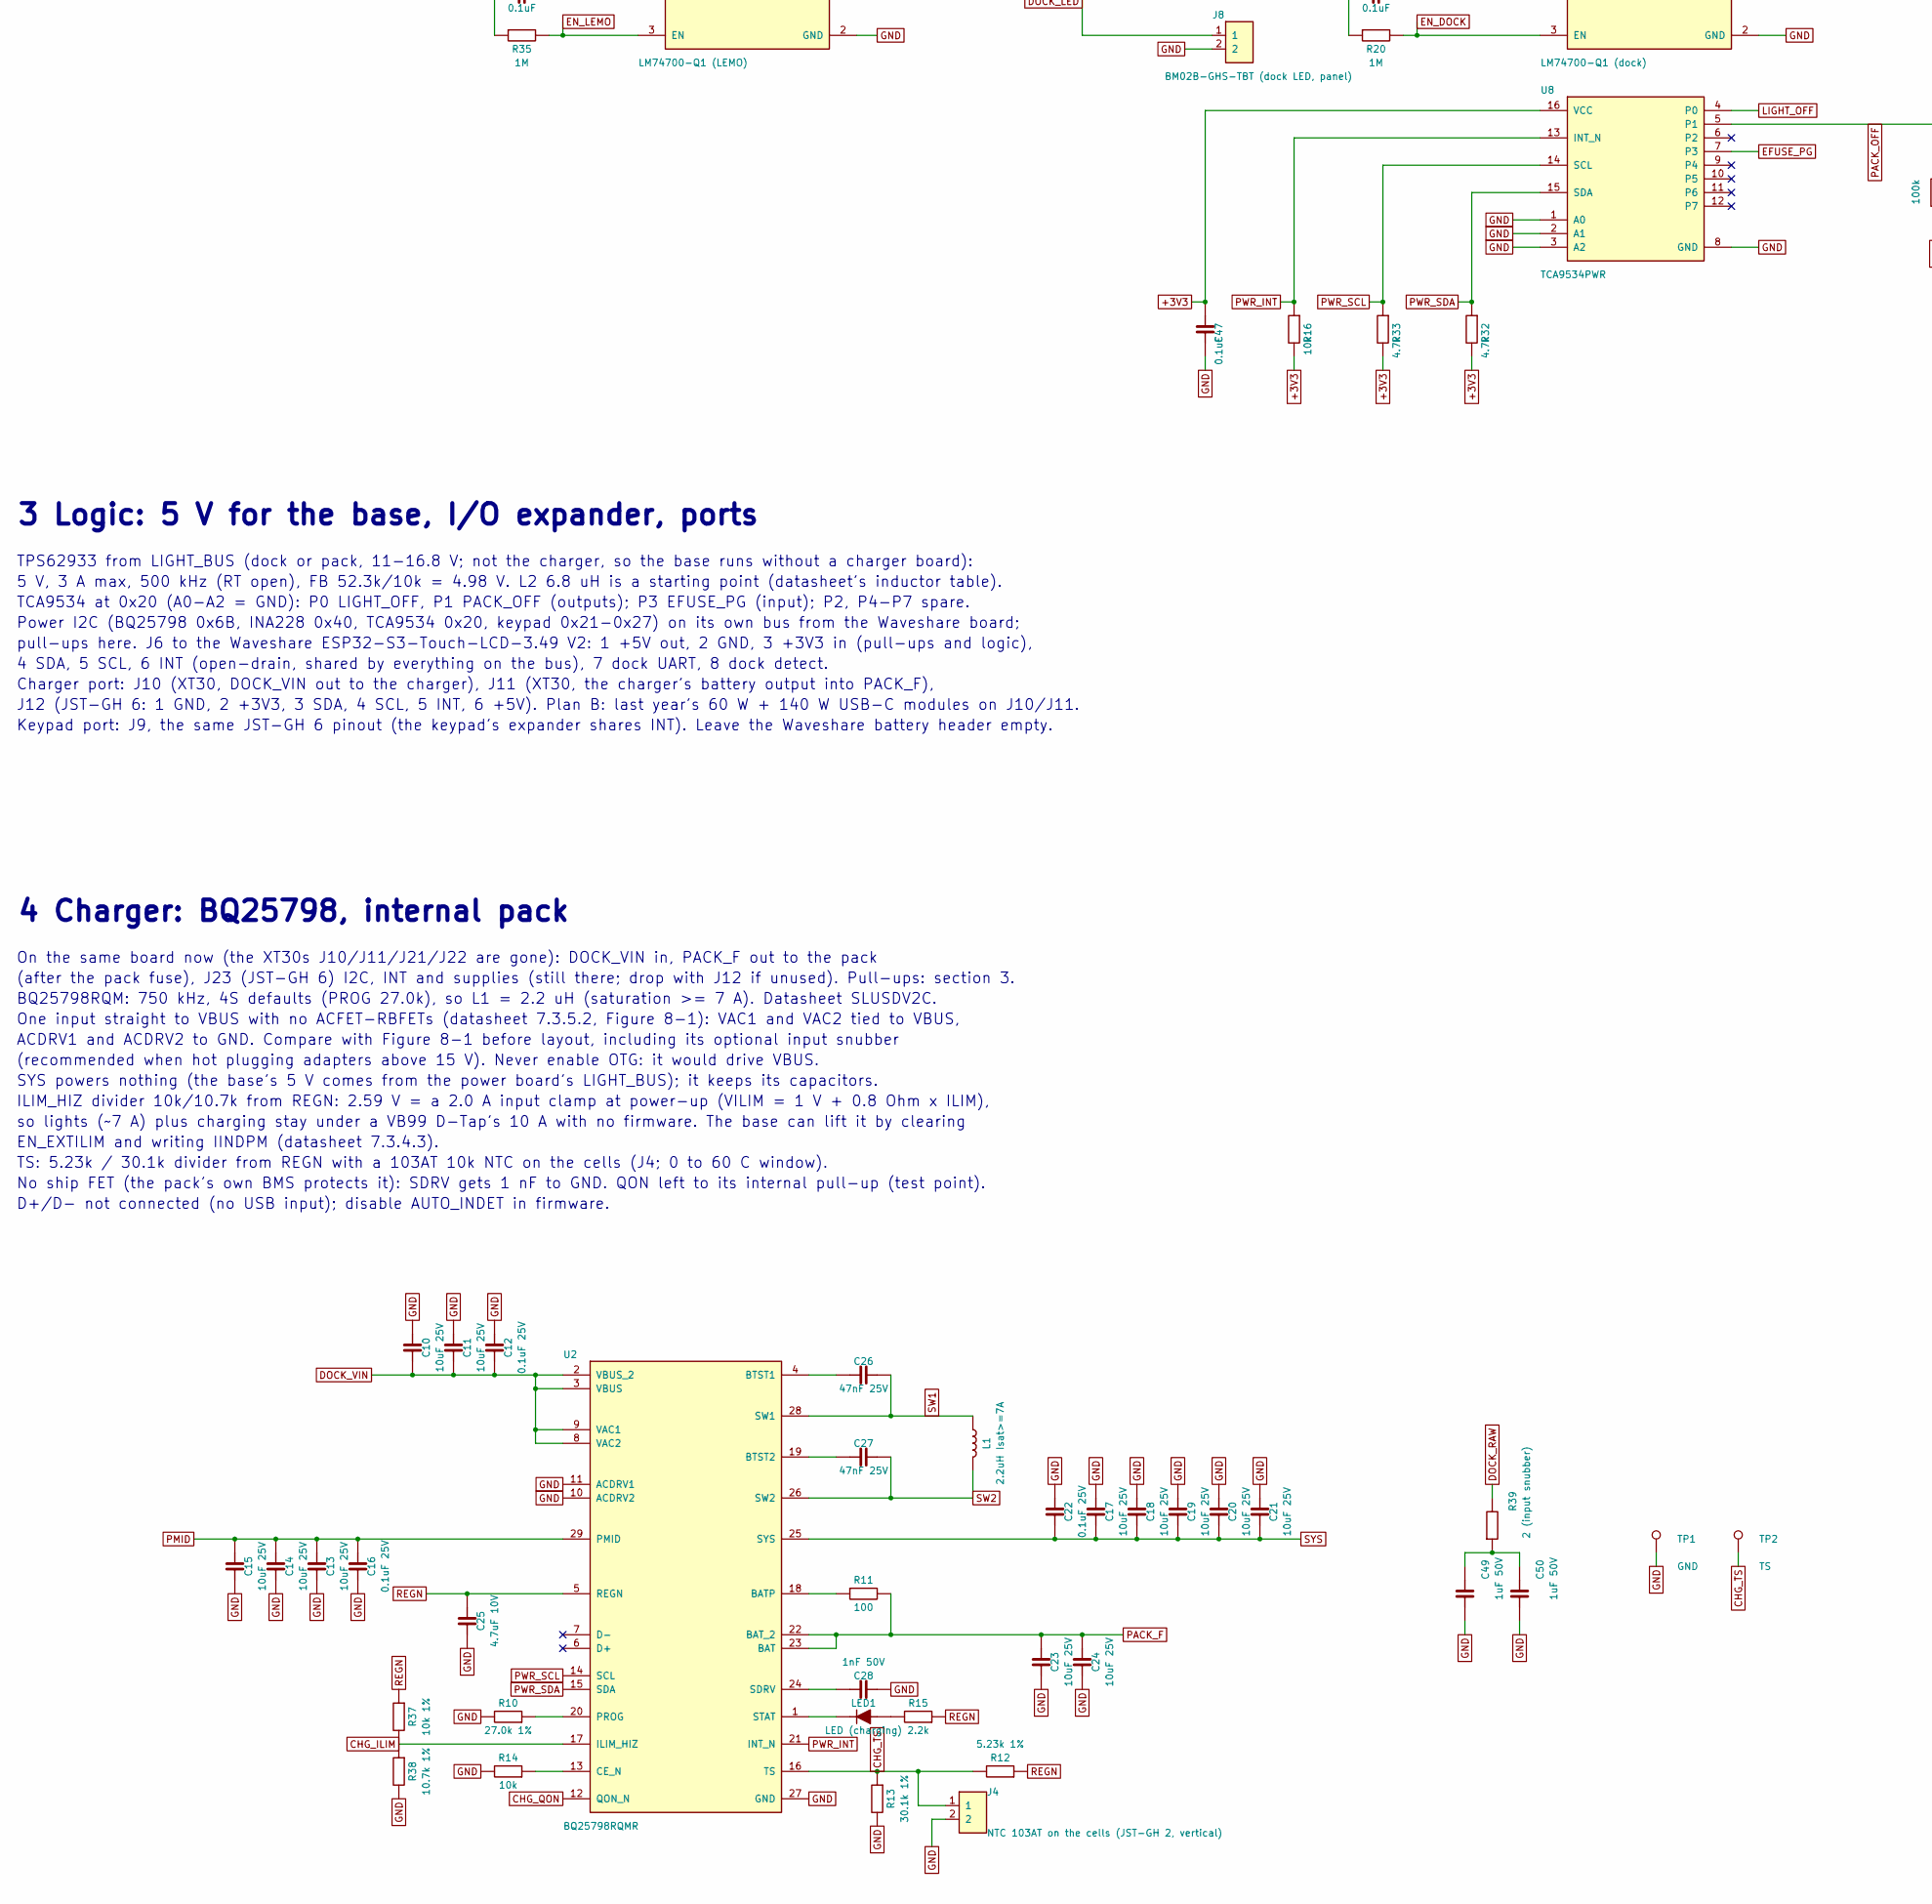
[picture p13: schematic nibbles_power_charger.kicad_sch, Nibbles power board + charger, part in row 2, column 1]

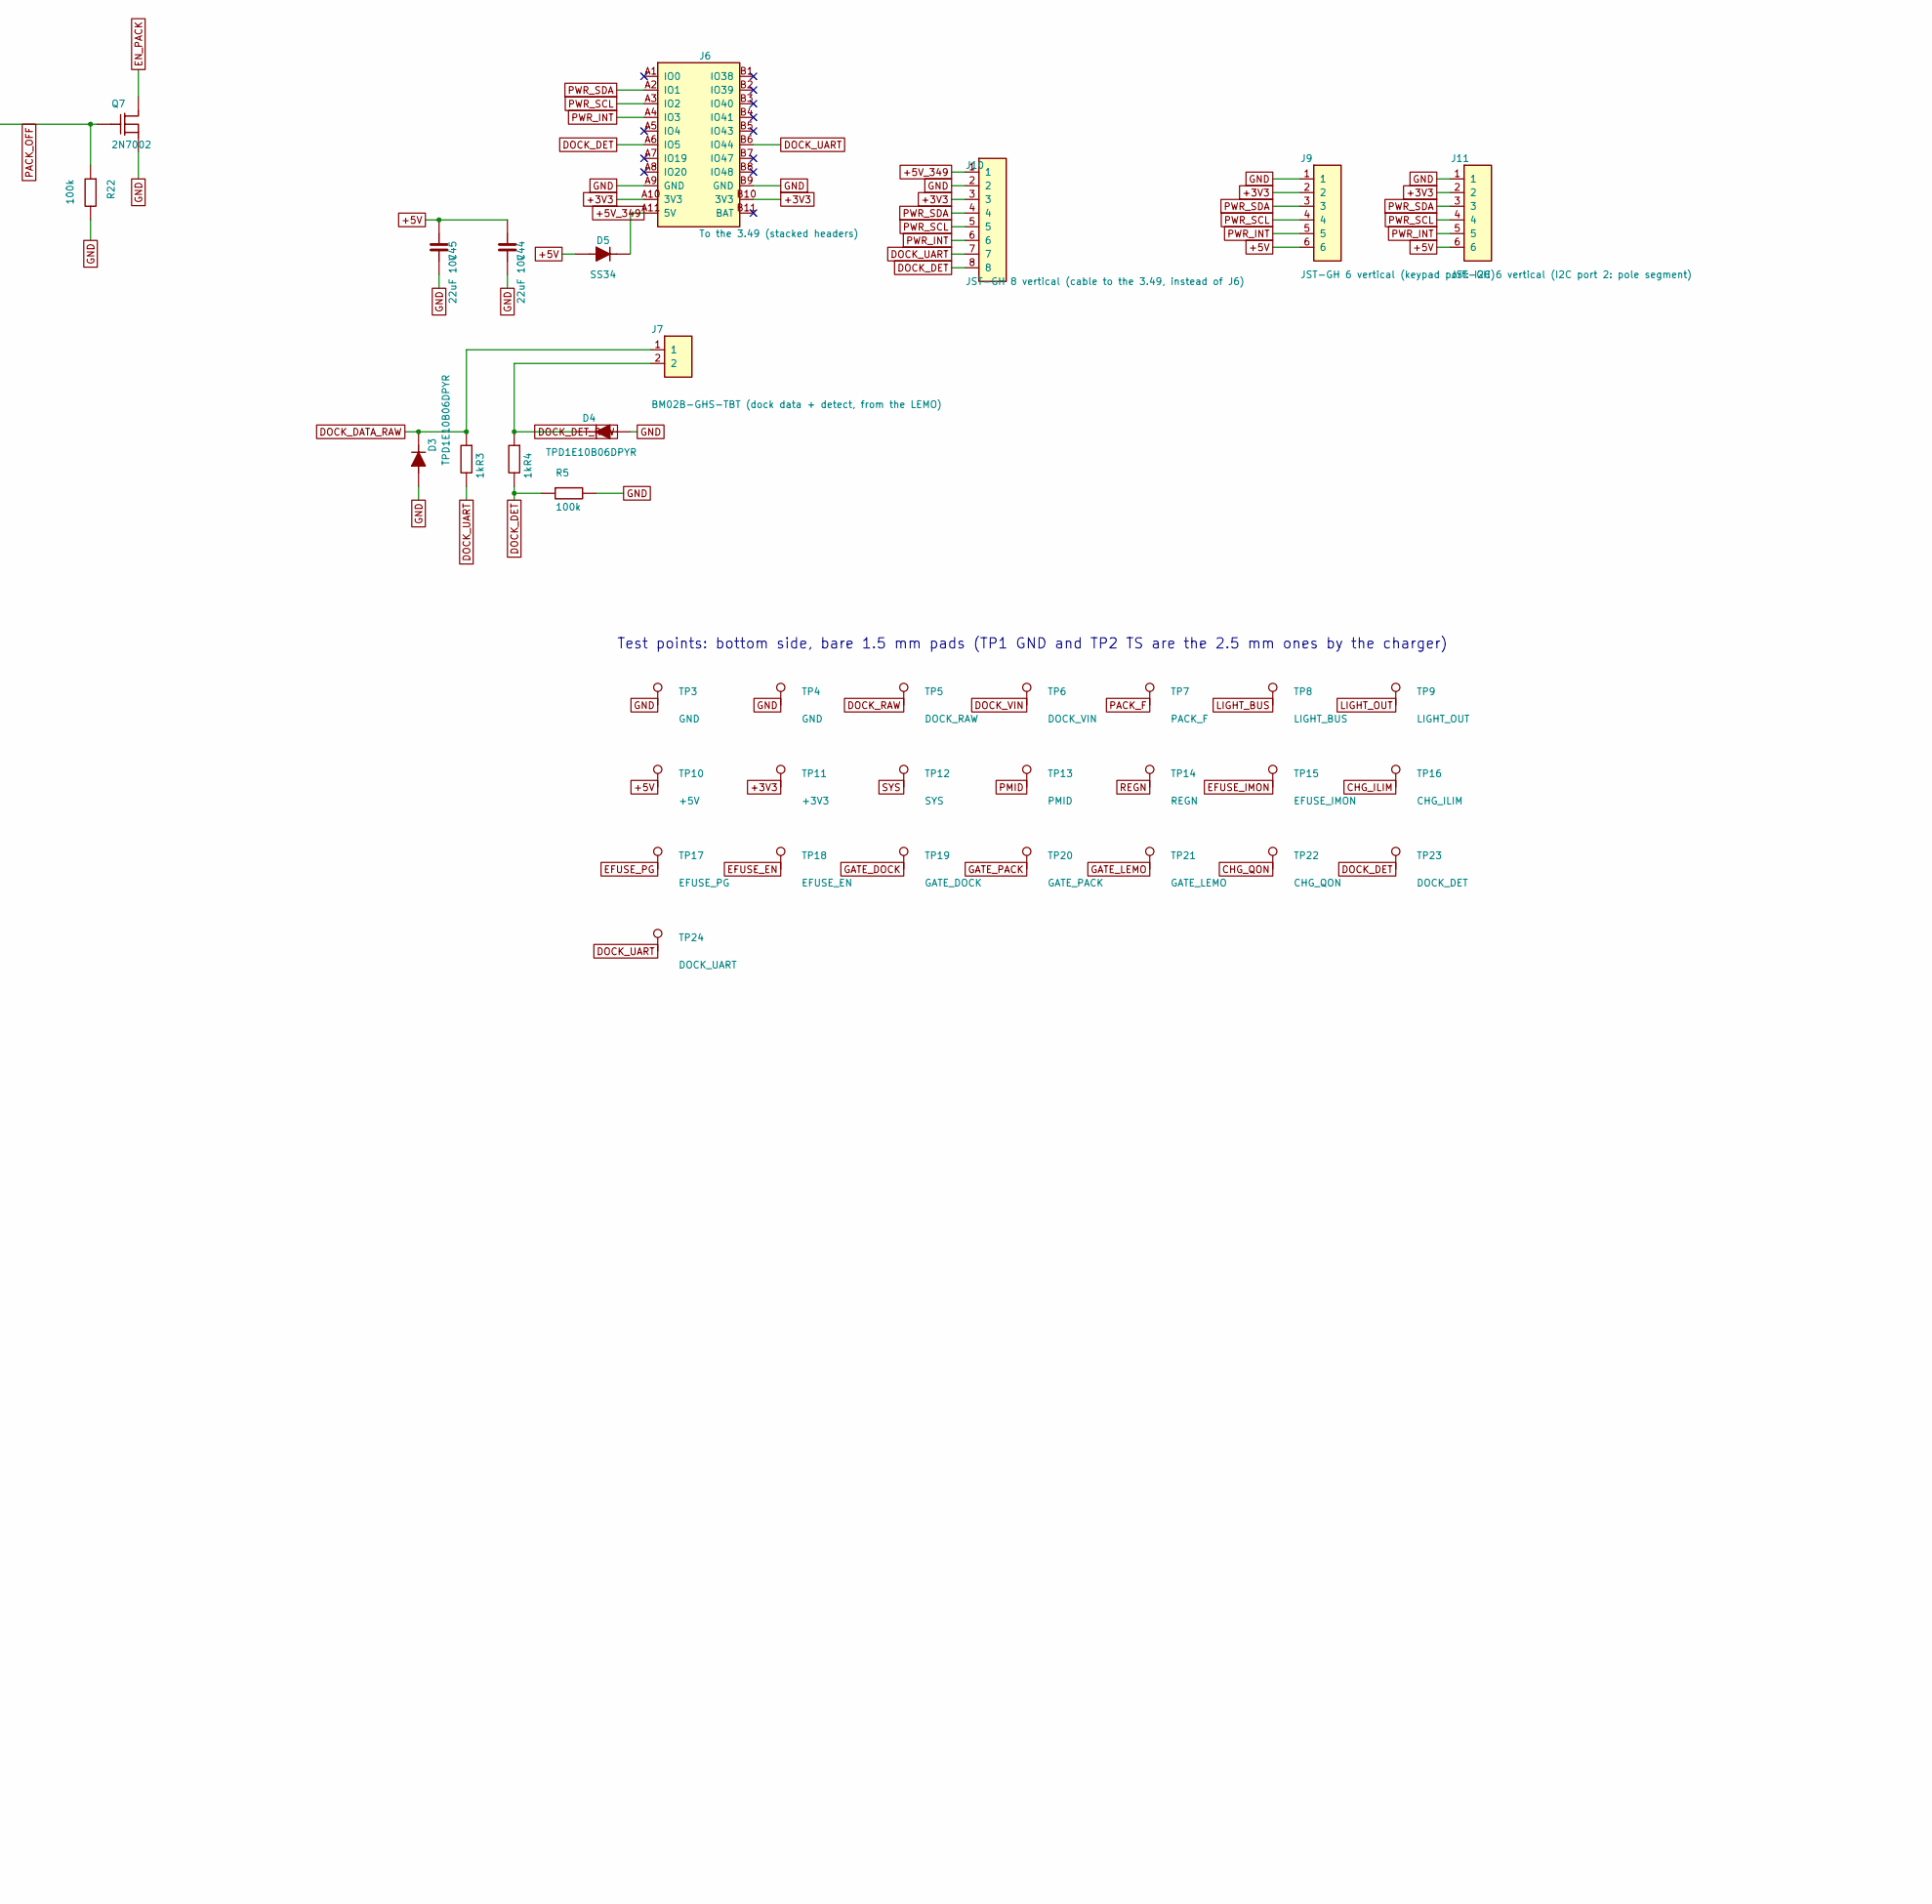
[picture p14: schematic nibbles_power_charger.kicad_sch, Nibbles power board + charger, part in row 2, column 2]

Parts:
C10, C11, C13, C14, C15, C17, C18, C19, C20, C21, C23, C24, C34: 10uF 25V; C_0805_2012Metric; MPN CL21A106KAYNNNE; LCSC C15850
C12, C16, C22: 0.1uF 25V; C_0402_1005Metric; LCSC C131394
C25: 4.7uF 10V; C_0603_1608Metric; LCSC C19666
C26, C27: 47nF 25V; C_0603_1608Metric; LCSC C1622
C28: 1nF 50V; C_0402_1005Metric; LCSC C106205
C30, C31, C38, C47, C48: 0.1uF; C_0603_1608Metric; LCSC C14663
C32, C33: 220uF 25V polymer; CP_Elec_6.3x9.9; MPN KNM2220UF149EC0051; LCSC C2981459
C35, C36: 22nF; C_0603_1608Metric; LCSC C21122
C37: 47nF; C_0603_1608Metric; LCSC C1622
C40, C41: 10uF 35V; C_1206_3216Metric; LCSC C89632
C42: 0.1uF 35V; C_0603_1608Metric; LCSC C14663
C43: 100nF; C_0603_1608Metric; LCSC C14663
C44, C45: 22uF 10V; C_0805_2012Metric; LCSC C45783
C46: 10nF; C_0603_1608Metric; LCSC C1589
C49, C50: 1uF 50V; C_0603_1608Metric; LCSC C15849
D2: SMBJ18A; D_SMB; MPN SMBJ18A; LCSC C10212
D3, D4: TPD1E10B06DPYR; D_0402_1005Metric; MPN TPD1E10B06DPYR; LCSC C48260
D5: SS34; D_SMA; MPN SS34; LCSC C8678
F1: 15A; Fuse_1206_3216Metric; MPN CC12H15A-TR; LCSC C2443310
J2: XT30PW-M (dock power, from the LEMO); AMASS_XT30PW-M_1x02_P2.50mm_Horizontal; MPN XT30PW-M; LCSC C431092
J3: XT30 (pack, from 4S BMS); AMASS_XT30PW-M_1x02_P2.50mm_Horizontal; MPN XT30PW-M; LCSC C431092
J4: NTC 103AT on the cells (JST-GH 2, vertical); JST_GH_BM02B-GHS-TBT_1x02-1MP_P1.25mm_Vertical; MPN BM02B-GHS-TBT; LCSC C161690
J5: XT30 (to the 5 V lighting converter); AMASS_XT30PW-M_1x02_P2.50mm_Horizontal; MPN XT30PW-M; LCSC C431092
J6: To the 3.49 (stacked headers); Waveshare_ESP32-S3-Touch-LCD-3.49_Headers; MPN 2x 1x11 female header, 2.54 mm; LCSC C2932674
J7: BM02B-GHS-TBT (dock data + detect, from the LEMO); JST_GH_BM02B-GHS-TBT_1x02-1MP_P1.25mm_Vertical; MPN BM02B-GHS-TBT; LCSC C161690
J8: BM02B-GHS-TBT (dock LED, panel); JST_GH_BM02B-GHS-TBT_1x02-1MP_P1.25mm_Vertical; MPN BM02B-GHS-TBT; LCSC C161690
J9: JST-GH 6 vertical (keypad port: I2C); JST_GH_BM06B-GHS-TBT_1x06-1MP_P1.25mm_Vertical; MPN BM06B-GHS-TBT; LCSC C189892
J10: JST-GH 8 vertical (cable to the 3.49, instead of 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; JST_GH_BM08B-GHS-TBT_1x08-1MP_P1.25mm_Vertical; MPN BM08B-GHS-TBT; LCSC C133062
J11: JST-GH 6 vertical (I2C port 2: pole segment); JST_GH_BM06B-GHS-TBT_1x06-1MP_P1.25mm_Vertical; MPN BM06B-GHS-TBT; LCSC C189892
L1: 2.2uH Isat>=7A; L_Sunlord_MWSA0603S; MPN MWSA0603S-2R2MT; LCSC C285810
L2: 6.8uH Isat>=4A; L_Sunlord_MWSA0603S; MPN MWSA0603S-6R8MT; LCSC C285805
LED1: LED (charging); LED_0603_1608Metric; MPN KT-0603R; LCSC C2286
Q5, Q6, Q9: 30V N-FET >= 15 A; ONSemi_SO-8FL_488AA; MPN NTMFS4C022NT1G; LCSC C179623
Q7, Q8: 2N7002; SOT-23; MPN 2N7002; LCSC C8545
R3, R4, R27: 1k; R_0603_1608Metric; LCSC C21190
R5, R22, R25: 100k; R_0603_1608Metric; LCSC C25803
R10: 27.0k 1%; R_0402_1005Metric; LCSC C25771
R11: 100; R_0402_1005Metric; LCSC C25076
R12: 5.23k 1%; R_0402_1005Metric; LCSC C2933105
R13: 30.1k 1%; R_0402_1005Metric; LCSC C2998131
R14, R16, R28: 10k; R_0603_1608Metric; LCSC C98220
R15: 2.2k; R_0603_1608Metric; LCSC C4190
R20, R21, R35: 1M; R_0603_1608Metric; LCSC C22935
R23: 86.6k 1%; R_0603_1608Metric; LCSC C23121
R24, R31, R37: 10k 1%; R_0603_1608Metric; LCSC C98220
R26: 130 1%; R_0603_1608Metric; LCSC C22796
R29: 2 mOhm 2512 3W; R_2512_6332Metric; MPN LR2512-23R002F4; LCSC C154685
R30: 52.3k 1%; R_0603_1608Metric; LCSC C2933235
R32, R33: 4.7k; R_0603_1608Metric; LCSC C23162
R36: 7.5k; R_0603_1608Metric; LCSC C23234
R38: 10.7k 1%; R_0603_1608Metric; LCSC C22857
R39: 2 (input snubber); R_0603_1608Metric; LCSC C22977
TP1: GND; TestPoint_Pad_2.5x2.5mm
TP2: TS; TestPoint_Pad_2.5x2.5mm
TP3, TP4: GND; TestPoint_Pad_D1.5mm
TP5: DOCK_RAW; TestPoint_Pad_D1.5mm
TP6: DOCK_VIN; TestPoint_Pad_D1.5mm
TP7: PACK_F; TestPoint_Pad_D1.5mm
TP8: LIGHT_BUS; TestPoint_Pad_D1.5mm
TP9: LIGHT_OUT; TestPoint_Pad_D1.5mm
TP10: +5V; TestPoint_Pad_D1.5mm
TP11: +3V3; TestPoint_Pad_D1.5mm
TP12: SYS; TestPoint_Pad_D1.5mm
TP13: PMID; TestPoint_Pad_D1.5mm
TP14: REGN; TestPoint_Pad_D1.5mm
TP15: EFUSE_IMON; TestPoint_Pad_D1.5mm
TP16: CHG_ILIM; TestPoint_Pad_D1.5mm
TP17: EFUSE_PG; TestPoint_Pad_D1.5mm
TP18: EFUSE_EN; TestPoint_Pad_D1.5mm
TP19: GATE_DOCK; TestPoint_Pad_D1.5mm
TP20: GATE_PACK; TestPoint_Pad_D1.5mm
TP21: GATE_LEMO; TestPoint_Pad_D1.5mm
TP22: CHG_QON; TestPoint_Pad_D1.5mm
TP23: DOCK_DET; TestPoint_Pad_D1.5mm
TP24: DOCK_UART; TestPoint_Pad_D1.5mm
U2: BQ25798RQMR; RQM0029A-MFG; MPN BQ25798RQMR; LCSC C2876593
U3: LM74700-Q1 (dock); DBV0006A_N; MPN LM74700QDBVRQ1; LCSC C2941042
U4: LM74700-Q1 (pack); DBV0006A_N; MPN LM74700QDBVRQ1; LCSC C2941042
U5: TPS259827ONRGET; RGE24_2P5XP85X1P45_TEX; MPN TPS259827ONRGET; LCSC C2155765
U6: INA226AIDGSR; VSSOP10_DGS_TEX; MPN INA226AIDGSR; LCSC C49851
U7: TPS62933DRLR; SOT_33DRLR_TEX; MPN TPS62933DRLR; LCSC C3200405
U8: TCA9534PWR; PW0016A-MFG; MPN TCA9534PWR; LCSC C783615
U9: LM74700-Q1 (LEMO); DBV0006A_N; MPN LM74700QDBVRQ1; LCSC C2941042

Connections:
+3V3: C38.1, C47.1, J6.A10 (3V3), J6.B10 (3V3), J9.2, J10.3, J11.2, R16.2, R28.2, R32.2, R33.2, TP11.1, U6.6 (VS), U8.16 (VCC)
+5V: C44.1, C45.1, D5.2 (A), J9.6, J11.6, L2.2, R30.1, TP10.1
+5V_349: D5.1 (C), J6.A11 (5V), J10.1
BUCK_BST: C43.1, U7.6 (BST)
BUCK_FB: R30.2, R31.1, U7.8 (FB)
BUCK_SS: C46.1, U7.7 (SS)
BUCK_SW: C43.2, L2.1, U7.5 (SW)
CHG_ILIM: R37.2, R38.1, TP16.1, U2.17 (ILIM_HIZ)
CHG_QON: TP22.1, U2.12 (QON_N)
CHG_TS: J4.1, R12.2, R13.1, TP2.1, U2.16 (TS)
DOCK_DATA_RAW: D3.1 (C), J7.1, R3.1
DOCK_DET: J6.A6 (IO5), J10.8, R4.2, R5.1, TP23.1
DOCK_DET_RAW: D4.1 (C), J7.2, R4.1
DOCK_LED: J8.1, R36.2
DOCK_RAW: C48.2, D2.1 (C), J2.2 (1), Q9.1 (S), Q9.2 (S), Q9.3 (S), R35.1, R39.2, TP5.1, U9.6 (ANODE)
DOCK_UART: J6.B6 (IO44), J10.7, R3.2, TP24.1
DOCK_VIN: C10.1, C11.1, C12.1, C30.2, Q5.1 (S), Q5.2 (S), Q5.3 (S), Q9.5 (D), R20.1, R36.1, TP6.1, U2.2 (VBUS_2), U2.3 (VBUS), U2.8 (VAC2), U2.9 (VAC1), U3.6 (ANODE), U9.4 (CATHODE)
EFUSE_DVDT: C37.1, U5.15 (DVDT)
EFUSE_EN: Q8.3 (D), R23.2, R24.1, TP18.1, U5.6 (EN/UVLO)
EFUSE_IMON: R27.1, TP15.1, U5.9 (IMON)
EFUSE_OUT: C32.1, C33.1, R29.1, U5.17 (OUT_2), U5.18 (OUT_3), U5.19 (OUT_4), U5.20 (OUT_5), U5.21 (OUT_6), U5.22 (OUT_7), U5.23 (OUT_8), U5.24 (OUT), U6.10 (IN+)
EFUSE_PG: R28.1, TP17.1, U5.13 (PG), U8.7 (P3)
EN_DOCK: R20.2, U3.3 (EN)
EN_LEMO: R35.2, U9.3 (EN)
EN_PACK: Q7.3 (D), R21.2, U4.3 (EN)
GATE_DOCK: Q5.4 (G), TP19.1, U3.5 (GATE)
GATE_LEMO: Q9.4 (G), TP21.1, U9.5 (GATE)
GATE_PACK: Q6.4 (G), TP20.1, U4.5 (GATE)
GND: C10.2, C11.2, C12.2, C13.2, C14.2, C15.2, C16.2, C17.2, C18.2, C19.2, C20.2, C21.2, C22.2, C23.2, C24.2, C25.2, C28.2, C32.2, C33.2, C34.2, C35.2, C36.2, C37.2, C38.2, C40.2, C41.2, C42.2, C44.2, C45.2, C46.2, C47.2, C49.1, C50.1, D2.2 (A), D3.2 (A), D4.2 (A), J2.1 (2), J3.1 (2), J4.2, J5.1 (2), J6.A9 (GND), J6.B9 (GND), J8.2, J9.1, J10.2, J11.1, Q7.2 (S), Q8.2 (S), R5.2, R10.2, R13.2, R14.2, R22.2, R24.2, R25.2, R26.2, R27.2, R31.2, R38.2, TP1.1, TP3.1, TP4.1, U2.10 (ACDRV2), U2.11 (ACDRV1), U2.27 (GND), U3.2 (GND), U4.2 (GND), U5.4 (GND_2), U5.5 (GND_3), U5.11 (NRETRY), U5.12 (LDSTRT), U5.14 (GND), U5.26 (EPAD), U6.1 (A1), U6.2 (A0), U6.7 (GND), U7.4 (GND), U8.1 (A0), U8.2 (A1), U8.3 (A2), U8.8 (GND), U9.2 (GND)
LIGHT_BUS: C34.1, C40.1, C41.1, C42.1, Q5.5 (D), Q6.5 (D), R23.1, TP8.1, U3.4 (CATHODE), U4.4 (CATHODE), U5.1 (IN_2), U5.2 (IN_3), U5.3 (IN_4), U5.16 (IN), U5.25 (EPAD_2), U7.3 (VIN)
LIGHT_OFF: Q8.1 (G), R25.1, U8.4 (P0)
LIGHT_OUT: J5.2 (1), R29.2, TP9.1, U6.8 (VBUS), U6.9 (IN-)
unnamed: C49.2, C50.2, R39.1
unnamed: LED1.2 (A), R15.2
unnamed: LED1.1 (C), U2.1 (STAT)
unnamed: R11.1, U2.18 (BATP)
unnamed: C26.1, U2.4 (BTST1)
unnamed: C27.1, U2.19 (BTST2)
unnamed: R14.1, U2.13 (CE_N)
unnamed: R10.1, U2.20 (PROG)
unnamed: C28.1, U2.24 (SDRV)
unnamed: R26.1, U5.8 (ILIM)
unnamed: C35.1, U5.7 (ITIMER)
unnamed: C36.1, U5.10 (RETRY_DLY)
PACK_F: C23.1, C24.1, C31.2, F1.2, Q6.1 (S), Q6.2 (S), Q6.3 (S), R11.2, R21.1, TP7.1, U2.22 (BAT_2), U2.23 (BAT), U4.6 (ANODE)
PACK_OFF: Q7.1 (G), R22.1, U8.5 (P1)
PACK_RAW: F1.1, J3.2 (1)
PMID: C13.1, C14.1, C15.1, C16.1, TP13.1, U2.29 (PMID)
PWR_INT: J6.A4 (IO3), J9.5, J10.6, J11.5, R16.1, U2.21 (INT_N), U6.3 (ALERT), U8.13 (INT_N)
PWR_SCL: J6.A3 (IO2), J9.4, J10.5, J11.4, R33.1, U2.14 (SCL), U6.5 (SCL), U8.14 (SCL)
PWR_SDA: J6.A2 (IO1), J9.3, J10.4, J11.3, R32.1, U2.15 (SDA), U6.4 (SDA), U8.15 (SDA)
REGN: C25.1, R12.1, R15.1, R37.1, TP14.1, U2.5 (REGN)
SW1: C26.2, L1.1, U2.28 (SW1)
SW2: C27.2, L1.2, U2.26 (SW2)
SYS: C17.1, C18.1, C19.1, C20.1, C21.1, C22.1, TP12.1, U2.25 (SYS)
VCAP_DOCK: C30.1, U3.1 (VCAP)
VCAP_LEMO: C48.1, U9.1 (VCAP)
VCAP_PACK: C31.1, U4.1 (VCAP)

Notes on the sheet:
LEMO, not the bulk caps: C32/C33 sit behind the eFuse (EFUSE_OUT), which ramps them up (dVdt), and hold up the
Pack: off-the-shelf 4S BMS on the cells, the main power switch in its lead, XT30 to J3; F1 protects lights and charging.
Pole-base power board: dock (LEMO) input, ideal-diode lighting path with eFuse and INA226, 5 V for the base board, I/O expander, charger and keypad ports. Design notes are with each section.
EN_EXTILIM and writing IINDPM (datasheet 7.3.4.3).
Power I2C (BQ25798 0x6B, INA228 0x40, TCA9534 0x20, keypad 0x21-0x27) on its own bus from the Waveshare board;
TS: 5.23k / 30.1k divider from REGN with a 103AT 10k NTC on the cells (J4; 0 to 60 C window).
eFuse TPS259827ONRGE: no overvoltage lockout (the pack and dock reach 16.8 V), circuit breaker.
or plan B's USB-C modules feeding back into the dock). U3/Q5 in section 2 is the dock's separate OR diode into
SYS powers nothing (the base's 5 V comes from the power board's LIGHT_BUS); it keeps its capacitors.
TPS62933 from LIGHT_BUS (dock or pack, 11-16.8 V; not the charger, so the base runs without a charger board):
if the dock is pulled, until the base turns it back on. Defaults to on.
U9/Q9: ideal diode right after the LEMO, so no current ever leaves the shark through it (the pack, the charger,
(recommended when hot plugging adapters above 15 V). Never enable OTG: it would drive VBUS.
5 V, 3 A max, 500 kHz (RT open), FB 52.3k/10k = 4.98 V. L2 6.8 uH is a starting point (datasheet's inductor table).
LIGHT_OFF from the expander turns the lights off; defaults to on, so the lights work without the base.
LIGHT_BUS has only small ceramics, so plugging a live dock into a switched-off shark charges ~30 uF through the
INA228 on the output: 2 mOhm shunt, address 0x40 (A0 = A1 = GND); its ALERT shares PWR_INT.
pull-ups here. J6 to the Waveshare ESP32-S3-Touch-LCD-3.49 V2: 1 +5V out, 2 GND, 3 +3V3 in (pull-ups and logic),
Test points: bottom side, bare 1.5 mm pads (TP1 GND and TP2 TS are the 2.5 mm ones by the charger)
D+/D- not connected (no USB input); disable AUTO_INDET in firmware.
2 Lighting path: ideal diodes, eFuse, INA228
1 Input: dock (LEMO)
4 Charger: BQ25798, internal pack
The LEMO is the only power input: the dock, or a separate USB-C PD to LEMO charging dongle at home.
On the same board now (the XT30s J10/J11/J21/J22 are gone): DOCK_VIN in, PACK_F out to the pack
Unused refs: J1, U1, D1, R1, C1, Q1-Q4, R34 (an earlier USB-C input), J4 and everything on U2 (the charger board).
(after the pack fuse), J23 (JST-GH 6) I2C, INT and supplies (still there; drop with J12 if unused). Pull-ups: section 3.
Two LM74700 ideal diodes OR the dock and the internal pack onto LIGHT_BUS. The dock's is always on.
J12 (JST-GH 6: 1 GND, 2 +3V3, 3 SDA, 4 SCL, 5 INT, 6 +5V). Plan B: last year's 60 W + 140 W USB-C modules on J10/J11.
Keypad port: J9, the same JST-GH 6 pinout (the keypad's expander shares INT). Leave the Waveshare battery header empty.
TVS: SMBJ18A on the dock input (16.8 V max), clamping under the 30 V FETs.
ACDRV1 and ACDRV2 to GND. Compare with Figure 8-1 before layout, including its optional input snubber
dVdt 47n: 170 ms ramp, under 2.5 W start-up heating up to ~2 mF on EFUSE_OUT. ITIMER 22n: 10 ms overload blanking. RETRY_DLY 22n: retry after 1 s.
J8: a panel LED (with leads, no resistor) lit whenever the dock supplies power, firmware or not (~1-2 mA).
so lights (~7 A) plus charging stay under a VB99 D-Tap's 10 A with no firmware. The base can lift it by clearing
3 Logic: 5 V for the base, I/O expander, ports
4 SDA, 5 SCL, 6 INT (open-drain, shared by everything on the bus), 7 dock UART, 8 dock detect.
Dock: the LEMO 1K.308 sits in the enclosure wall and is wired to this board: J2 (XT30) takes its battery
BQ25798RQM: 750 kHz, 4S defaults (PROG 27.0k), so L1 = 2.2 uH (saturation >= 7 A). Datasheet SLUSDV2C.
ILIM 130R = about 11.3 A (datasheet: 300R = 5 A, 182R = 8.1 A, 100R = 14.7 A). UVLO 86.6k/10k: on at 11.6 V, off at 10.6 V.
pins (LEMO 1-3 +, 4-6 ground), J7 (JST-GH 2) its data (LEMO 7, UART to the base) and dock detect (8).
One input straight to VBUS with no ACFET-RBFETs (datasheet 7.3.5.2, Figure 8-1): VAC1 and VAC2 tied to VBUS,
The pack's can be switched off (PACK_OFF) while the dock runs the lights; its FET's body diode still holds the bus
Charger port: J10 (XT30, DOCK_VIN out to the charger), J11 (XT30, the charger's battery output into PACK_F),
TCA9534 at 0x20 (A0-A2 = GND): P0 LIGHT_OFF, P1 PACK_OFF (outputs); P3 EFUSE_PG (input); P2, P4-P7 spare.
the lights: without it, the pack would feed the charger's input through LIGHT_BUS.
ILIM_HIZ divider 10k/10.7k from REGN: 2.59 V = a 2.0 A input clamp at power-up (VILIM = 1 V + 0.8 Ohm x ILIM),
No ship FET (the pack's own BMS protects it): SDRV gets 1 nF to GND. QON left to its internal pull-up (test point).
converter's input while the ideal diodes switch between dock and pack.

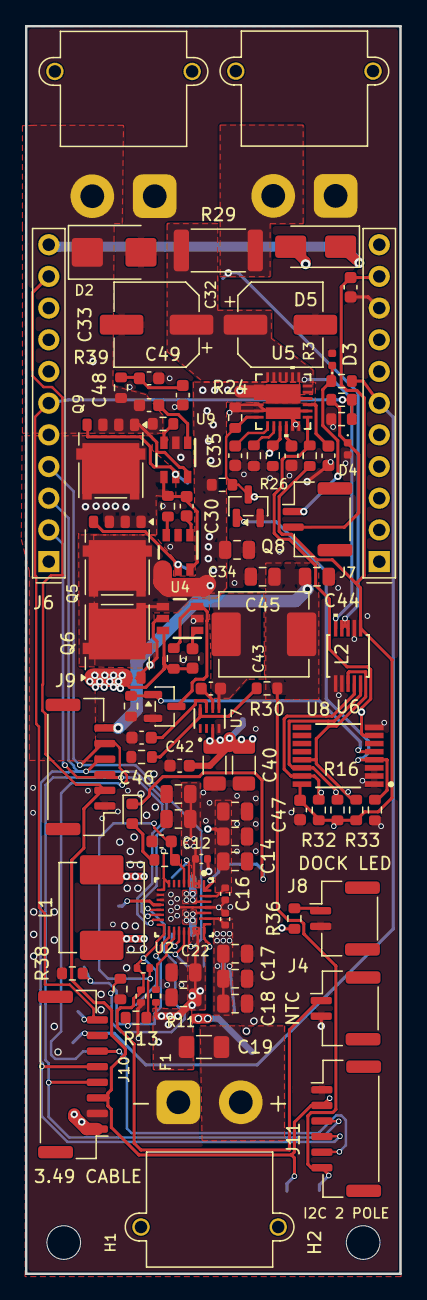
[picture p15: board nibbles_power_charger.kicad_pcb from above]

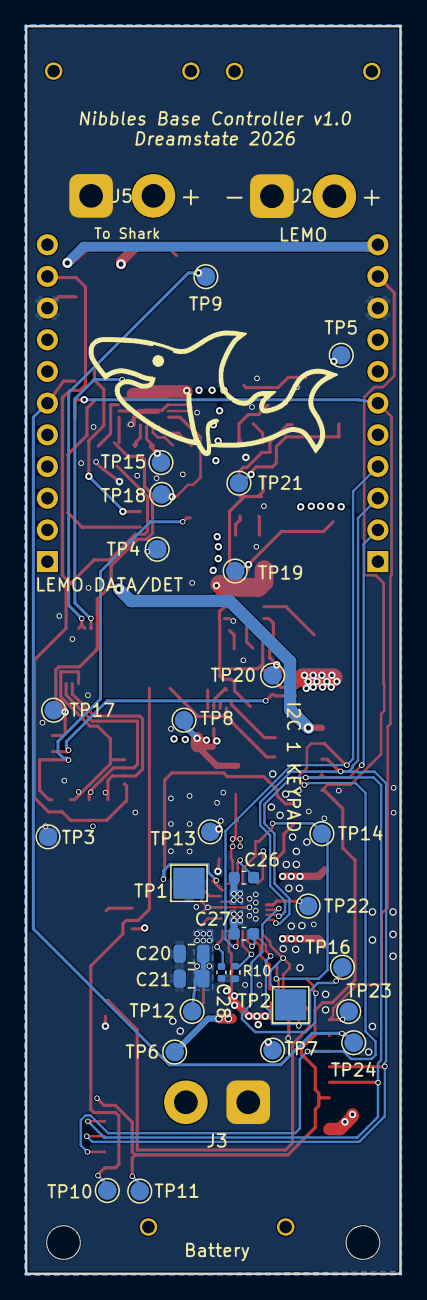
[picture p16: board nibbles_power_charger.kicad_pcb from below]

Board: 4 copper layers, 30.0 x 100.0 mm, 126 parts (31 on the bottom side), 58 nets.

Other parts of the board:
H1, H2: M2.5; MountingHole_2.7mm_M2.5
LOGO: Nibbles_Shark_Logo_20mm
