snowyfox/Nibbles/wled/usermod_nibbles/usermod_nibbles.cpp

// Nibbles usermod for WLED: ties the shark's lights into the Nibbles system.
//
// - Turns ESP-NOW on and acts as the channel anchor: broadcasts anchor
//   heartbeats on whatever channel WLED is on (a phone hotspot at home, its own
//   AP at a festival). The eyes and base station scan until they hear one.
// - Takes Nibbles commands aimed at WLED (preset set / next / previous) and
//   acks them.
// - Broadcasts WLED telemetry, and shows the eyes' telemetry on the Info page.
// - Bumps: momentary effects (flash, blackout, preset) while a base-station
//   button is held; WLED's previous state is restored exactly afterwards.
// - 2D map partners: with the shark's 2D map (/ledmap.json, made by
//   tools/sim/make_ledmap.py) only one of each overlapping pair is mapped
//   (the outward body strip, the starboard fin); after every frame the LEDs
//   in the file's "copy" list take the colour of the LED they pair with.
// - Battery-aware current limit: the base broadcasts the pack voltage at the
//   pole base (NL_MSG_BATTERY); WLED's global current limit follows it so a
//   full-white flash can't pull the 5 V converter's input below the voltage
//   where it stutters (nl_power_limit_ma; docs/power.md). The ceiling is this
//   usermod's power_max_ma setting, which takes over WLED's own limit field.
// - Fin following can be switched off (NL_OP_FIN_FOLLOW from the base, or
//   {"nibbles":{"finfollow":false}}; saved in the config): the fins then stay
//   at their modelled angle, as before following existed. NL_MSG_FIN_STATE
//   (2 Hz) tells the base whether it is on and which angles are in use.
// - Fin sweep for testing (the simulator asks, {"nibbles":{"finsweep":{"port":
//   period_s,"starboard":period_s,"s":seconds}}}): the fin's angle swings
//   smoothly through -90..+90 deg, in place of the sensor, until the request
//   runs out (renewed every 2 s while the simulator wants it).
// - Fin hinge angles from the fin sensor node (NL_MSG_FIN_POSE): shown on the
//   Info page and passed to the simulator. With the 2D map, a fin whose angle
//   is known follows it: each of its LEDs shows the side view's colour at the
//   spot it is really over ("fingeo" in /ledmap.json, from make_ledmap.py).
// - Fin presets (the fins' own segment): the 2D map has a fin panel beside the
//   side view ("finpanel" in /ledmap.json). While a segment is on there, each
//   fin LED shows the panel's colour where it sits by its hinge angle (or the
//   modelled angle), seen from the side or from above ({"nibbles":{"finproj":
//   "side"|"top"}}, usually stored in the fin preset). WLED presets
//   NL_FIN_PRESET_BASE + n are fin presets (saved with only the fin segment);
//   NL_FIN_PRESET_BASE switches the segment off. The body's preset and the
//   fins' are tracked apart: telemetry reports the body's, NL_MSG_FIN_STATE
//   the fins'. Fin bumps (NL_TARGET_FINS) run beside body bumps, and this
//   usermod's preset applies go through a queue (WLED keeps one waiting).
// - Eye settings in presets: a preset's "nibbles":{"eyes":{...}} goes to the
//   eyes when the preset is applied: "preset" (1-based), "react"
//   ("preset"|"beats"|"peaks") and "auto" as commands to the leader eye, or a
//   whole "look" (every preset_t setting; nl_eye_look_t) broadcast as
//   NL_MSG_EYE_LOOK. Skipped for presets applied with NL_PRESET_NO_EYES (the
//   base's BODY target), bump presets and fin presets.
// - Segment layer slots (2D map only): fixed segments that WLED 16 stacks by
//   segment number, slot n being segment n: 0 body, 1 fins (the fin panel; fin
//   presets use it), 2 body overlay, 3 fin overlay, 4 bump (the whole grid).
//   {"nibbles":{"slot":{"id":2,"look":7,"bm":10,"o":200,"on":true}}} (or an
//   array of them): "look" takes a preset's effect, speed, sliders, palette and
//   colours (its main segment, without its position) into the slot; "fx",
//   "pal", "col" etc. set them directly; "bm" blend mode, "o" opacity, "tt"
//   transition. A slot that's off is frozen (it costs nothing) unless "warm":
//   true keeps its effect running. Slots below a new one are created off, so
//   the numbering holds. Requests run from loop() (WLED's JSON buffer is busy
//   while it hands them to us). The state reports them as "nibbles":{"slots"}.
//   Flash and blackout bumps use the bump slot, so nothing is saved or
//   restored and commands during them apply at once. Radio: NL_OP_SLOT_LOOK
//   and NL_OP_SLOT_PALETTE set a slot; NL_BUMP_PALETTE and NL_BUMP_LAYER show a
//   palette or a layer look while held and put the slot back exactly after (a
//   slot command for that slot meanwhile becomes what it goes back to, which is
//   how the base's LATCH keeps one); NL_BUMP_SCENE shows a preset, a palette
//   and a layer look together (TAKE's preview of Standby) and puts all of it
//   back; NL_MSG_WLED_LAYERS (2 Hz) reports them.
// - Mirror for the lighting simulator (tools/sim): while asked to (JSON state
//   {"nibbles":{"mirror":{"ip":..,"port":..,"s":..}}}, renewed every few
//   seconds), streams every LED as it is shown (DDP, to port) and the eyes'
//   audio features and telemetry (JSON text, to port + 1).
// - Streamed pictures: while this WLED shows another WLED's stream (DDP etc.,
//   e.g. from a faster main board), it times the gaps between packets and
//   reports stalls on the Info page and to the base (NL_MSG_WLED_STREAM, 1 Hz).
// - Wire link (setting "wire_pin"): the brain sends every LED, as its network
//   LED output would send it, out of a UART pin (nl_pix_* chunks, 2 Mbaud);
//   the display receives on its pin and shows the frames as a realtime
//   stream, so the picture doesn't cross the air. The brain's network output
//   can point at 0.0.0.0 (nothing sent) or stay on the display as a Wi-Fi
//   backup. Counters on the Info page ("Nibbles wire").
// - Preview stream (setting "preview", or state {"nibbles":{"preview":true}}):
// - A/B brains (settings "wire_pin_b" on the display, "ab_side" on each brain): the
//   display has a wire from each and switches between them (shared nl_ab_*). The
//   brain not on the LEDs sends as NL_ROLE_WLED_STANDBY, so the eyes ignore it, keeps
//   its eye settings until it's taken and ignores bumps. Both send the preview.
// - The time: /time on a phone sets WLED's clock; it broadcasts that every 10 s
//   (NL_MSG_TIME) for the base's logs.
//   broadcasts a reduced copy of the LEDs for a preview screen (NL_MSG_PREVIEW,
//   firmware/preview), RGB332 before master brightness, "preview_fps" a second,
//   one packet per loop so it doesn't hold up rendering.
// - ES7210 mic chip (builds with NIBBLES_ES7210, e.g. the Waveshare 3.49 dev
//   node): AudioReactive can't set this chip up, so the usermod does, over
//   I2C, once AudioReactive's I2S clocks run. Then AudioReactive reads it as
//   "Generic I2S with MCLK" (see wled/README.md for the pins).
//
// Main board and display (two WLEDs, the main one streaming every LED to the
// controller that drives them; wled/README.md): the main board runs all of the
// above. The display sets "display" in this usermod's settings: it only
// listens for the base's battery readings (its current limit protects the
// LEDs it drives) and reports how steadily the stream arrives. No anchoring,
// telemetry, commands or bumps, so the base, eyes and fin node only ever see
// the main board.
//
// Messages come from shared/nibbles_link (the same protocol code as the eyes
// and base). See docs/architecture.md in the Nibbles repo.
#include "wled.h"
#include "nibbles_link.h"
#include <esp_now.h>
#include <driver/uart.h>
#include <driver/gpio.h>
#include <lwip/netif.h>
#include <lwip/sockets.h>
#include <map>
#ifdef NIBBLES_ES7210
#include <Wire.h>
#endif

#ifdef WLED_DISABLE_ESPNOW
#error "usermod_nibbles needs ESP-NOW"
#endif

#define NIBBLES_WLED_FW        1
#define ANCHOR_HEARTBEAT_MS    250   // 4 Hz: a scanning node dwells 400 ms per channel
#define TELEMETRY_MS           500
#define AUDIO_MS               32     // audio features, like the port eye sends them
#define RX_QUEUE               8
#define JSON_LOCK_NIBBLES      240
#define MIRROR_MIN_MS          20     // at most 50 frames a second to the simulator
#define MIRROR_MAX_S           30     // a mirror request lasts at most this long
#define DDP_MAX_LEDS           480    // LEDs per DDP packet (1440 bytes of RGB)
#define WIRE_UART              UART_NUM_1
#define WIRE_UART_B            UART_NUM_2   // the display's second brain
#define WIRE_TX_BUF            8192   // a whole frame of 1064 LEDs is ~3.3 KB encoded
#define WIRE_RX_BUF            8192   // ~40 ms at 2 Mbaud, for loop() hiccups
#define WIRE_READ              512
#define RET_TX_BUF             2048   // the return wire: A/B state and sound sync, ~3 KB/s
#define NET_FALLBACK_MS        6000   // a brain without its network this long hosts it
#define NET_REJOIN_MS          10000  // and hosts at least this long before trying the host again
#define RET_RX_BUF             4096   // on a brain: ~20 ms of the return wire at 2 Mbaud
#define WIRE_KEEPALIVE_MS      200    // resend while WLED shows nothing new (off, frozen)

#ifdef NIBBLES_ES7210
// The ES7210 4-channel mic ADC, as a slave to the ESP32's I2S clocks (MCLK =
// 256 x sample rate), 32-bit standard I2S, mics 1 and 2 on SDOUT1 (left and
// right), 30 dB gain. The register sequence is Espressif's esp_codec_dev
// driver's (es7210_open, es7210_set_fs, es7210_start), as the eyes use it.
#ifndef NIBBLES_ES7210_ADDR
#define NIBBLES_ES7210_ADDR 0x40
#endif
#ifndef NIBBLES_ES7210_SDA
#define NIBBLES_ES7210_SDA 47
#endif
#ifndef NIBBLES_ES7210_SCL
#define NIBBLES_ES7210_SCL 48
#endif
#ifndef NIBBLES_ES7210_GAIN
#define NIBBLES_ES7210_GAIN 10   // 3 dB steps: 10 = 30 dB
#endif
static bool es7210Write(uint8_t reg, uint8_t val) {
  Wire.beginTransmission(NIBBLES_ES7210_ADDR);
  Wire.write(reg);
  Wire.write(val);
  return Wire.endTransmission() == 0;
}
static int es7210Read(uint8_t reg) {
  Wire.beginTransmission(NIBBLES_ES7210_ADDR);
  Wire.write(reg);
  if (Wire.endTransmission(false) != 0 || Wire.requestFrom((uint8_t)NIBBLES_ES7210_ADDR, (uint8_t)1) != 1) return -1;
  return Wire.read();
}
static bool es7210Setup() {
  static const uint8_t seq[][2] = {
    // es7210_open: reset, clocks off, state cycles, high-pass filters, slave mode
    {0x00, 0xff}, {0x00, 0x41}, {0x01, 0x3f}, {0x09, 0x30}, {0x0a, 0x30},
    {0x23, 0x2a}, {0x22, 0x0a}, {0x20, 0x0a}, {0x21, 0x2a}, {0x08, 0x00},
    {0x40, 0x43}, {0x41, 0x70}, {0x42, 0x70}, {0x07, 0x20}, {0x02, 0xc1},
    // mics 1 and 2 on, 3 and 4 off; gain; no TDM
    {0x43, 0x10 | NIBBLES_ES7210_GAIN}, {0x44, 0x10 | NIBBLES_ES7210_GAIN}, {0x45, 0x00}, {0x46, 0x00},
    {0x4b, 0x00}, {0x4c, 0xff}, {0x12, 0x00},
    // es7210_set_fs: 32-bit words, standard I2S
    {0x11, 0x80},
    // es7210_start (clock register: mics 1 and 2's clocks on)
    {0x01, 0x34}, {0x06, 0x00}, {0x40, 0x43},
    {0x47, 0x08}, {0x48, 0x08}, {0x49, 0x08}, {0x4a, 0x08},
    {0x40, 0x43}, {0x00, 0x71}, {0x00, 0x41},
  };
  for (const auto &w : seq)
    if (!es7210Write(w[0], w[1])) return false;
  return true;
}
#endif

// The segment fields that make a look (not where it is, how it blends or whether it's on).
static const char *const LOOK_KEYS[] = { "fx", "sx", "ix", "c1", "c2", "c3", "o1", "o2", "o3", "pal", "col",
                                         "si", "m12", "rev", "mi", "rY", "mY", "tp", "cct", "set" };

class NibblesUsermod : public Usermod {
  private:
    bool enabled = true;
    bool anchor = true;
    bool display = false;   // the display of a main board / display pair: battery readings in, stream reports out
    bool audio = false;  // publish AudioReactive's analysis for the eyes
    unsigned long lastTime = 0;
    unsigned long lastHeartbeat = 0, lastTelemetry = 0, lastDebug = 0, lastAudio = 0, lastStream = 0;
    nl_stream_gaps_t streamGaps;
    unsigned long seenRealtimeTimeout = 0;  // WLED moves realtimeTimeout on every stream packet
    nl_ar_state_t arState;
    uint32_t audioSent = 0;
    uint16_t seq = 0;

    // Packets arrive on the ESP-NOW callback; handle them in loop().
    struct RxItem { uint8_t mac[6]; uint8_t len; uint8_t data[NL_RADIO_MAX]; };
    RxItem rx[RX_QUEUE];
    volatile uint8_t rxHead = 0, rxTail = 0;
    portMUX_TYPE rxLock = portMUX_INITIALIZER_UNLOCKED;

    // Last command, so a retry (same id) is acked but applied once.
    uint16_t lastCmdId = 0;
    uint8_t lastCmdMac[6] = { 0 };

    // What we know about the eyes.
    nl_eye_telemetry_t eyes = {};
    unsigned long eyesAt = 0;
    bool haveEyes = false;
    uint32_t rxCount = 0, cmdCount = 0, bumpCount = 0;

    // Which preset ids exist, read from presets.json once and again only when
    // presets change (reading the file per id is far too slow for a command).
    uint8_t presetBits[32] = { 0 };
    std::map<uint8_t, String> presetNames;  // for telemetry, filled with presetBits
    bool presetBitsValid = false;
    unsigned long presetBitsTime = 0;

    // Bumps: WLED's state is saved as JSON when one begins and put back when it ends.
    nl_bump_rx_t bumps;
    String savedState;
    bool haveSaved = false;
    // Fin presets and fin bumps (NL_TARGET_FINS), beside the body's.
    nl_bump_rx_t finBumps;
    bool finBumpOn = false;
    uint8_t finBumpRestore = 0;   // the fin preset to go back to (NL_FIN_PRESET_BASE: following the body)
    uint8_t finPreset = 0;        // 1..16 showing, 0 = following the body
    uint8_t finAtBump = 0;        // finPreset when the body bump began
    uint8_t bodyPreset = 0;       // the last preset outside the fin presets
    int lastSeenPreset = -1;
    unsigned long panelOffSince = 0;
    // WLED holds one waiting preset; ours queue here, the next once the last has landed.
    // Entries with bit 8 set apply without their eye settings; bit 9 marks a body
    // bump's own preset (a bump that ends drops those still queued, see bumpEnd).
    uint16_t presetQueue[4] = { 0 };
    uint8_t presetQueueLen = 0;
    uint8_t presetWaiting = 0;
    bool presetWaitingBump = false;   // the preset on its way is a bump's
    unsigned long presetIssuedAt = 0;
    // A bump that ended while its preset was still on its way: WLED applies a
    // preset a loop later, so it would land over the restore. Restored again once
    // it has (2026-11-09: keys swapped quickly left a bump's preset behind).
    String lateRestore;
    uint8_t lateRestorePreset = 0;
    bool eyesMuted = false;       // the preset being applied mustn't touch the eyes
    bool cmdNoEyes = false;       // the command being resolved had NL_PRESET_NO_EYES
    // Eye settings from a preset, on their way to the eyes.
    uint8_t eyesMac[6] = { 0 };
    bool haveEyesMac = false;
    nl_eye_look_t eyeLook = {};
    uint8_t eyeLookSends = 0;
    nl_cmd_t eyeCmds[3] = {};
    uint8_t eyeCmdCount = 0, eyeCmdSends = 0;
    uint16_t eyeCmdId = 0x8000;   // apart from the base's ids
    unsigned long eyeSendNext = 0;
    char eyeNote[64] = "";        // the last preset's eye settings, for the Info page
    static bool isFinPreset(int id) { return id >= NL_FIN_PRESET_BASE && id <= NL_FIN_PRESET_BASE + NL_FIN_PRESET_COUNT; }
    uint8_t savedPreset = 0;
    int pendingPreset = 0, pendingBri = -1;  // commands received during a bump
    bool pendingNoEyes = false;

    // Mirror to the simulator.
    WiFiUDP mirrorUdp;
    IPAddress mirrorIp;
    uint16_t mirrorPort = 0;
    unsigned long mirrorUntil = 0, lastMirror = 0;
    uint8_t ddpSeq = 0;
    uint32_t mirrorFrames = 0;
    nl_audio_t lastAudioOut = {};
    unsigned long lastAudioOutAt = 0;
    uint8_t ddpBuf[10 + DDP_MAX_LEDS * 3];
    uint8_t *mirrorRgb = nullptr;  // one frame by physical LED (in 2D, cells are not LEDs)
    unsigned mirrorRgbLeds = 0;

    // Preview stream for a preview screen.
    bool previewOn = false;              // setting
    uint8_t previewFps = 12;             // setting
    uint8_t previewFrame = 0;
    unsigned previewNext = 0, previewChunks = 0;
    unsigned long previewFrameAt = 0, previewChunkAt = 0;
    uint32_t previewFrames = 0;

    // Wire link: TX on the brain, RX on the display (wireRx), on one UART.
    int8_t wirePin = -1;                 // setting; -1 = off
    int8_t wirePinB = -1;                // setting, on the display: the second brain's wire
    struct WireIn {                      // one wire coming in, on the display
      int8_t pinUp = -1;
      uart_port_t uart = WIRE_UART;
      const char *note = "off";
      nl_pix_parser_t *parser = nullptr;
      uint8_t *frame = nullptr;          // with two wires: the latest frame from this brain
      int prevFrame = -1, curFrame = -1;
      unsigned curLeds = 0, leds = 0;
      uint32_t frames = 0, lost = 0, partial = 0, fpsCount = 0;
      uint16_t fps = 0;
      unsigned long lastAt = 0;
    };
    WireIn wireIn[2];
    unsigned long wireRetryAt = 0;
    // A/B: the display's switch between two brains, and a brain's side of it
    bool abOn = false, abDirty = false;
    nl_ab_t ab;
    nl_bump_rx_t abBumps;
    unsigned abLeds = 0;
    unsigned long lastAbState = 0;
    int8_t abSide = -1;                  // setting, on a brain: 0 Right Brain, 1 Left Brain, -1 no A/B
    nl_ab_state_t abHeard = {};
    bool abHeardAny = false;
    uint32_t wireBaud = NL_PIX_BAUD;     // setting
    int8_t wirePinUp = -1;               // the pin the UART runs on now
    uint32_t wireBaudUp = 0;
    bool wireRx = false, wireRecheck = true;
    bool radioOff = false;               // setting, on the display: take nothing from the radio, only from the wires
    uint32_t relayRx = 0, relayTx = 0;
    // Return wire (setting "ret_pin"): TX on the display, on the first wire's UART;
    // RX on a brain, on its wire UART. Carries NL_MSG_AB and the sound sync.
    int8_t retPin = -1;                  // setting; -1 = off
    int8_t retPinUp = -1;
    int8_t retPinSet = -1;               // the setting when the wires last started (a pin that fails is not retried)
    nl_pix_parser_t *retParser = nullptr;
    uint32_t retTx = 0, retRx = 0, arOut = 0, arIn = 0;
    unsigned long lastArAt = 0, abWireAt = 0, retRxAt = 0;
    bool lastArPeak = false;
    float arLevel = 0, arLevelMax = 0;   // on a brain: the sound from the wire, for the Info page
    uint32_t arBeats = 0;
    int arSock = -1;
    // Network without the controller: one brain hosts "Nibbles" (WLED: no network to join, its own
    // network always on), the other joins it. The controller's radio stays off ("wifi_off").
    bool wifiOff = false;                // setting, on the display: no radio; NL_OP_CTL_WIFI joins the network until restart
    bool netFallback = false;            // setting, on a brain that joins the network: host it while the host is gone
    bool ssidHidden = false, fallbackOn = false, ctlWifiOn = false;
    char savedSsid[33] = "";
    uint8_t savedApBehavior = AP_BEHAVIOR_BOOT_NO_CONN;
    unsigned long netLostAt = 0, fallbackAt = 0, hostHeardAt = 0;
    // A network move from the base (NL_HOP_MOVE, 2026-11-09): at hopAt the access point
    // (the host's, or the stand-in's) restarts on hopChannel and a joined brain reconnects
    // a moment later; the channel is saved. No hosting in its place for a while meanwhile.
    uint8_t hopChannel = 0;
    unsigned long hopAt = 0, hopReconnectAt = 0, hopGraceUntil = 0;
    bool hopPersist = false;      // saved once the network to join is back in the settings
    uint32_t hopsDone = 0;
    uint32_t fallbacks = 0;
    uint8_t ownMac[6] = {};
    const char *wireNote = "";           // why it isn't running, for the Info page
    volatile bool frameShown = false;    // WLED showed a frame since we last sent one
    uint8_t *wireBuf = nullptr;          // one encoded chunk (TX) or a read block (RX)
    uint8_t wireFrame = 0;
    unsigned wireLeds = 0;
    uint32_t wireFrames = 0, wireFpsCount = 0;
    uint16_t wireFps = 0;
    uint32_t wireUs = 0, wireUsN = 0;    // time spent sending, for the Info page
    unsigned long wireLastAt = 0, wireFpsAt = 0;

    // 2D map partners: "copy" ranges from /ledmap.json ([dst, dst count,
    // src, src count], physical LED numbers), turned into matrix cell pairs.
    struct CopyRange { uint16_t dst, dstN, src, srcN; };
    CopyRange copyRanges[4];
    uint8_t copyRangeCount = 0;
    bool copyRead = false;
#ifdef NIBBLES_ES7210
    int es7210State = 0;            // 0 not yet, 1 set up, -1 no answer (retried every 5 s)
    unsigned long es7210TriedAt = 0;
#endif
    uint16_t *copyPairs = nullptr;  // cell to paint, cell to copy from, ...
    uint16_t copyPairCount = 0, copyBuiltFor = 0;
    int copyBuiltMap = -1;
    bool copyBuiltMatrix = false;
    unsigned long copyBuiltAt = 0;

    // Fin hinge angles, as last heard.
    nl_fin_pose_t fins = { { NL_FIN_NONE, NL_FIN_NONE }, { NL_FIN_RAW_NONE, NL_FIN_RAW_NONE } };
    unsigned long finsAt[2] = { 0, 0 };
    uint32_t finRx = 0;

    // Battery-aware current limit.
    bool powerEnabled = true;
    nl_power_model_t powerModel = NL_POWER_MODEL_DEFAULT;
    nl_power_limiter_t power;
    uint32_t powerApplied = 0;    // limit we last set, 0 = not yet (WLED's own until then)
    unsigned long lastPowerTick = 0;
    uint32_t batteryRx = 0;

    static const char _name[];

    // Keep WLED's global limit at the limiter's value (or the ceiling while no
    // battery reading has arrived). Leaves WLED alone when its limiter is off.
    void powerLoop(unsigned long now) {
      if (now - lastPowerTick < 100) return;
      lastPowerTick = now;
      const uint32_t lim = nl_power_limiter_tick(&power, now);
      if (!powerEnabled || BusManager::ablMilliampsMax() == 0) return;
      const uint32_t want = lim ? lim : powerModel.max_ma;
      if (want != powerApplied || BusManager::ablMilliampsMax() != want) {
        BusManager::setMilliampsMax(want > 65535 ? 65535 : want);
        powerApplied = want;
      }
    }

    void batteryReading(const nl_battery_t &b) {
      batteryRx++;
      nl_power_limiter_reading(&power, &b, millis());
    }

    // Fin LEDs follow the fins' angle (off: they stay at the modelled angle).
    bool finFollowOn = true;
    static constexpr int NO_ACTION = INT32_MIN;  // a command with nothing for applyCommand to do

    void setFinFollow(bool on) {
      if (on == finFollowOn) return;
      finFollowOn = on;
      configNeedsWrite = true;  // remembered across restarts
    }

    // Test sweep of the fins (from the simulator), in place of the sensor.
    float finSweepPeriod[2] = { 0, 0 };   // seconds per full swing, 0 = off
    unsigned long finSweepUntil = 0, finSweepStart = 0;

    bool finSweeping(int side, unsigned long now) const {
      return finSweepPeriod[side] > 0 && (long)(finSweepUntil - now) > 0;
    }

    // The angle a fin has now: the test sweep, else a fresh calibrated sensor reading.
    bool finAngle(int side, unsigned long now, float &deg) const {
      if (!finFollowOn) return false;  // locked: the fins keep their modelled angle (the static map)
      if (finSweeping(side, now)) {
        deg = 90.0f * sinf(2.0f * (float)M_PI * ((now - finSweepStart) / 1000.0f) / finSweepPeriod[side]);
        return true;
      }
      if (!finsAt[side] || now - finsAt[side] > 2000 || fins.angle_cdeg[side] == NL_FIN_NONE) return false;
      deg = fins.angle_cdeg[side] / 100.0f;
      return true;
    }

    // Fins following their real angle in 2D ("fingeo" in /ledmap.json).
    struct FinFollow {
      uint8_t side;               // NL_FIN_PORT / NL_FIN_STARBOARD
      uint16_t start, count;      // physical LEDs
      float hinge[3], turn[3], modelDeg;
      float *rest;                // count x (x, y, z), design mm
      uint16_t *dst;              // the matrix cell that drives each LED
      uint16_t *src;              // the cell each LED is over at srcDeg
      float srcDeg;               // NAN: not worked out yet
      uint8_t srcMode;            // 0 the side view, 1 + nl_fin_proj_t the fin panel
    };
    FinFollow finFollow[2] = {};
    uint8_t finFollowCount = 0;
    float finGrid[5] = { 0 };     // cell size, u0, v1, ox, oy (see make_ledmap.py)
    uint32_t *finColors = nullptr;
    uint16_t finColorsLen = 0;
    uint8_t finFollowing = 0;     // bit per fin following its angle on the last frame
    // The fin panel: px, py, pw, ph, mm per cell, side_y0, side_z1, top_y0, top_x0 (see make_ledmap.py).
    float finPanel[9] = { 0 };
    bool haveFinPanel = false;
    bool finPanelOn = false;      // a segment is on in the panel
    uint8_t finProj = NL_FIN_PROJ_SIDE;

    // Segment layer slots (see the header): slot n is segment n.
    enum : uint8_t { AREA_BODY, AREA_FINS, AREA_ALL };
    struct SlotDef { uint8_t area, bm; const char *name; };
    static constexpr unsigned SLOT_COUNT = 5;
    static constexpr unsigned SLOT_BUMP = 4;
    static const SlotDef slotDefs[SLOT_COUNT];
    uint16_t slotLook[SLOT_COUNT] = { 0 };   // the preset whose look a slot took last (0: none, or set directly)
    String slotQueue[12];
    uint8_t slotQueueLen = 0;
    uint32_t slotApplied = 0;
    char slotNote[80] = "";                  // the last request's outcome, for the Info page
    // Bumps shown in a slot (flash, blackout, palette, layer): the request that
    // shows one and the one that puts its slot back. One for the body's bumps
    // (NL_TARGET_WLED), one for the fins' (NL_TARGET_FINS).
    struct SlotBump { bool on = false; uint8_t action = 0, slot = 0; String apply, restore; };
    // A slot bump's restore that's queued but not applied yet: a bump that
    // replaces it on the same slot goes back to that, not to the slot as it is
    // now (still the old bump's look; 2026-11-09).
    String slotRestoreQueued[SLOT_COUNT];
    SlotBump bodySlotBump, finSlotBump;
    uint8_t bumpBri = 0;                     // the master brightness to go back to after a flash
    String pendingSlots[4];                  // slot commands during a preset bump, for its end
    uint8_t pendingSlotCount = 0;
    // Scene bumps (NL_BUMP_SCENE): the body's is saved like a preset bump, plus
    // its overlay slot and the slots' looks; the fins' as their two slots.
    bool sceneOn = false, finSceneOn = false;
    String sceneOverRestore, finSceneRestore[2];
    String sceneQueued[2], finSceneQueued[2];   // its palette and look requests, until they apply
    uint16_t sceneLooks[SLOT_COUNT] = { 0 };
    uint8_t finScenePreset = 0;              // a fin preset command during the fins' scene, for its end
    String finScenePending[4];               // fin slot commands during it
    uint8_t finScenePendingCount = 0;

    // A slot's cells: [x0, x1) x [y0, y1). The body is the side view, left of the fin panel.
    bool slotArea(unsigned slot, unsigned &x0, unsigned &x1, unsigned &y0, unsigned &y1) const {
      if (!strip.isMatrix || slot >= SLOT_COUNT) return false;
      const unsigned W = Segment::maxWidth, H = Segment::maxHeight;
      x0 = 0; x1 = W; y0 = 0; y1 = H;
      switch (slotDefs[slot].area) {
        case AREA_BODY:
          if (haveFinPanel) x1 = min((unsigned)finPanel[0], W);
          break;
        case AREA_FINS:
          if (!haveFinPanel) return false;
          x0 = (unsigned)finPanel[0]; x1 = min(x0 + (unsigned)finPanel[2], W);
          y0 = (unsigned)finPanel[1]; y1 = min(y0 + (unsigned)finPanel[3], H);
          break;
        default: break;
      }
      return x1 > x0 && y1 > y0;
    }

    void queueSlot(JsonVariant v) {
      if (!v.is<JsonObject>() || slotQueueLen >= sizeof(slotQueue) / sizeof(slotQueue[0])) return;
      String s;
      serializeJson(v, s);
      if (s.length() < 600) slotQueue[slotQueueLen++] = s;
    }

    // One slot request; false if WLED's JSON buffer was busy (try again next loop).
    bool applySlot(const String &req) {
      StaticJsonDocument<768> rq;
      if (deserializeJson(rq, req)) { snprintf(slotNote, sizeof(slotNote), "bad request"); return true; }
      const int slot = rq[F("id")] | -1;
      unsigned x0, x1, y0, y1;
      if (slot < 0 || slot >= (int)SLOT_COUNT || !slotArea(slot, x0, x1, y0, y1)) {
        snprintf(slotNote, sizeof(slotNote), "slot %d: no such slot here%s", slot, strip.isMatrix ? "" : " (needs the 2D map)");
        return true;
      }
      JSONBufferGuard guard(JSON_LOCK_NIBBLES);
      if (!guard) return false;
      StaticJsonDocument<1024> look;
      const int lookId = rq[F("look")] | 0;
      if (lookId) {
        StaticJsonDocument<64> filter;
        filter[F("seg")] = true;
        filter[F("mainseg")] = true;
        pDoc->clear();
        if (!readObjectFromFileUsingId(getPresetsFileName(), lookId, pDoc, &filter)) {
          snprintf(slotNote, sizeof(slotNote), "slot %d: preset %d not found", slot, lookId);
          return true;
        }
        JsonVariant sg = (*pDoc)[F("seg")];
        JsonObject src;
        if (sg.is<JsonObject>()) src = sg.as<JsonObject>();
        else if (sg.is<JsonArray>()) {
          const int main = (*pDoc)[F("mainseg")] | 0;
          for (JsonObject s : sg.as<JsonArray>()) {
            if ((s[F("stop")] | 1) == 0) continue;   // a "delete this segment" entry
            if (src.isNull() || (s[F("id")] | -1) == main) src = s;
            if ((s[F("id")] | -1) == main) break;
          }
        }
        if (src.isNull()) {
          snprintf(slotNote, sizeof(slotNote), "slot %d: preset %d has no segment", slot, lookId);
          return true;
        }
        for (const char *k : LOOK_KEYS)
          if (!src[k].isNull()) look[k] = src[k];
      }
      const unsigned have = strip.getSegmentsNum();
      const bool fresh = (unsigned)slot >= have || !strip.getSegment(slot).isActive();
      bool setsLook = lookId != 0;
      for (const char *k : LOOK_KEYS) if (!rq[k].isNull()) setsLook = true;
      const bool wasOn = !fresh && strip.getSegment(slot).on;
      const bool turnsOn = lookId != 0 || !rq[F("fx")].isNull();   // a new effect shows; a new palette alone doesn't
      const bool on = rq[F("on")].isNull() ? (turnsOn || wasOn) : rq[F("on")].as<bool>();

      pDoc->clear();
      JsonObject st = pDoc->to<JsonObject>();
      if (!rq[F("tt")].isNull()) st[F("tt")] = rq[F("tt")];
      if (!rq[F("master")].isNull()) st[F("bri")] = rq[F("master")];   // WLED's master brightness (flash bumps)
      JsonArray segs = st.createNestedArray(F("seg"));
      for (unsigned s = have; s < (unsigned)slot; s++) {   // fill the stack below: those slots off and frozen
        unsigned a0 = 0, a1 = 1, b0 = 0, b1 = 1;
        if (!slotArea(s, a0, a1, b0, b1)) slotArea(0, a0, a1, b0, b1);
        JsonObject p = segs.createNestedObject();
        p[F("id")] = s; p[F("start")] = a0; p[F("stop")] = a1; p[F("startY")] = b0; p[F("stopY")] = b1;
        p[F("on")] = false; p[F("frz")] = true; p[F("bm")] = slotDefs[s].bm; p[F("n")] = slotDefs[s].name;
      }
      JsonObject o = segs.createNestedObject();
      o[F("id")] = slot; o[F("start")] = x0; o[F("stop")] = x1; o[F("startY")] = y0; o[F("stopY")] = y1;
      for (JsonPair kv : look.as<JsonObject>()) o[kv.key()] = kv.value();
      for (const char *k : LOOK_KEYS) if (!rq[k].isNull()) o[k] = rq[k];
      if (!rq[F("bm")].isNull()) o[F("bm")] = rq[F("bm")];
      else if (fresh) o[F("bm")] = slotDefs[slot].bm;
      if (!rq[F("o")].isNull()) o[F("bri")] = constrain(rq[F("o")].as<int>(), 1, 255);   // opacity; 0 would switch it off
      if (fresh) o[F("n")] = slotDefs[slot].name;
      o[F("on")] = on;
      o[F("frz")] = !on && !(rq[F("warm")] | false);
      const auto keepPreset = currentPreset;
      deserializeState(st, CALL_MODE_DIRECT_CHANGE);
      if (rq[F("bump")] | false) currentPreset = keepPreset;   // a bump is momentary: the preset is still the one showing
      if (lookId) slotLook[slot] = lookId;
      else if (!rq[F("lookid")].isNull()) slotLook[slot] = rq[F("lookid")] | 0;   // a restore puts the look's preset back too
      else if (turnsOn) slotLook[slot] = 0;
      if (slot == 1 && isFinPreset(lookId) && !finBumpOn && !finSceneOn) finPreset = lookId - NL_FIN_PRESET_BASE;   // the base sees it as that fin preset
      slotApplied++;
      snprintf(slotNote, sizeof(slotNote), "slot %d (%s): %s%s%s", slot, slotDefs[slot].name, on ? "on" : "off",
               lookId ? ", look of preset " : "", lookId ? String(lookId).c_str() : "");
#ifdef NIBBLES_DEBUG
      Serial.printf("nibbles: %s\n", slotNote);
#endif
      return true;
    }

    void slotLoop() {
      if (!slotQueueLen) return;
      // A preset still on its way would replace what the slot request sets
      // (a scene bump, or slot commands after a preset), so it goes first.
      if (presetQueueLen || presetWaiting) return;
      if (!applySlot(slotQueue[0])) return;   // JSON buffer busy: next time
      for (unsigned i = 0; i < SLOT_COUNT; i++)
        if (slotRestoreQueued[i].length() && slotRestoreQueued[i] == slotQueue[0]) slotRestoreQueued[i] = String();
      for (unsigned i = 1; i < slotQueueLen; i++) slotQueue[i - 1] = slotQueue[i];
      slotQueue[--slotQueueLen] = String();
    }

    void queueSlotString(const String &r) {
      if (slotQueueLen < sizeof(slotQueue) / sizeof(slotQueue[0])) slotQueue[slotQueueLen++] = r;
    }

    // A slot as it is now, as a request that puts it back (the end of a bump).
    String captureSlot(unsigned sl) const {
      StaticJsonDocument<768> d;
      d[F("id")] = sl; d[F("tt")] = 0; d[F("bump")] = true;
      if (sl >= strip.getSegmentsNum() || !strip.getSegment(sl).isActive()) {
        d[F("on")] = false;
      } else {
        const Segment &g = strip.getSegment(sl);
        d[F("fx")] = g.mode; d[F("sx")] = g.speed; d[F("ix")] = g.intensity;
        d[F("c1")] = g.custom1; d[F("c2")] = g.custom2; d[F("c3")] = g.custom3;
        d[F("o1")] = g.check1; d[F("o2")] = g.check2; d[F("o3")] = g.check3;
        d[F("pal")] = g.palette; d[F("si")] = g.soundSim; d[F("m12")] = g.map1D2D;
        d[F("rev")] = g.reverse; d[F("mi")] = g.mirror; d[F("rY")] = g.reverse_y; d[F("mY")] = g.mirror_y; d[F("tp")] = g.transpose;
        JsonArray col = d.createNestedArray(F("col"));
        for (int i = 0; i < 3; i++) {
          JsonArray c = col.createNestedArray();
          c.add(R(g.colors[i])); c.add(G(g.colors[i])); c.add(B(g.colors[i]));
          if (W(g.colors[i])) c.add(W(g.colors[i]));
        }
        d[F("bm")] = g.blendMode; d[F("o")] = g.opacity ? g.opacity : 1;
        d[F("on")] = g.on;
        if (!g.on && !g.freeze) d[F("warm")] = true;
        d[F("lookid")] = slotLook[sl];
      }
      String r;
      serializeJson(d, r);
      return r;
    }

    // Starts a bump that lives in a slot: false if it doesn't apply here (no
    // 2D map, no such slot or preset). Flash and blackout: the bump slot over
    // everything; a palette on a slot; a layer look in a slot.
    bool slotBumpStart(const nl_bump_t &b, SlotBump &sb) {
      StaticJsonDocument<384> d;
      unsigned a0, a1, b0, b1;
      if (b.action == NL_BUMP_FLASH || b.action == NL_BUMP_BLACKOUT) {
        if (!slotArea(SLOT_BUMP, a0, a1, b0, b1)) return false;
        const bool flash = b.action == NL_BUMP_FLASH;
        const uint8_t c = flash ? 255 : 0;
        sb.slot = SLOT_BUMP;
        d[F("fx")] = 0;
        JsonArray col = d.createNestedArray(F("col")).createNestedArray();
        col.add(c); col.add(c); col.add(c);
        d[F("bm")] = 0;                                 // top: covers everything below
        d[F("on")] = true;
        if (flash) d[F("master")] = b.intensity ? b.intensity : 255;   // as bright as asked, whatever the master is
        sb.restore = String();                          // made at the end (the master brightness may change meanwhile)
      } else if (b.action == NL_BUMP_PALETTE || b.action == NL_BUMP_LAYER) {
        const unsigned sl = nl_slot_arg_slot(b.arg), v = nl_slot_arg_value(b.arg);
        if (!slotArea(sl, a0, a1, b0, b1)) return false;
        if (b.action == NL_BUMP_PALETTE) {
          if (sl >= strip.getSegmentsNum() || !strip.getSegment(sl).isActive()) return false;   // nothing showing to recolour
          d[F("pal")] = v;
        } else if (v) {
          refreshPresets();
          if (!presetExists(v)) return false;
          d[F("look")] = v;
          d[F("on")] = true;
        } else {
          d[F("on")] = false;
        }
        sb.slot = sl;
        sb.restore = slotRestoreQueued[sl].length() ? slotRestoreQueued[sl] : captureSlot(sl);
      } else {
        return false;
      }
      d[F("id")] = sb.slot; d[F("tt")] = 0; d[F("bump")] = true;
      sb.apply = String();
      serializeJson(d, sb.apply);
      sb.action = b.action;
      sb.on = true;
      queueSlotString(sb.apply);
      return true;
    }

    void slotBumpEnd(SlotBump &sb) {
      if (!sb.on) return;
      sb.on = false;
      if (sb.action == NL_BUMP_FLASH || sb.action == NL_BUMP_BLACKOUT) {
        String r = String(F("{\"id\":")) + SLOT_BUMP + F(",\"tt\":0,\"bump\":true,\"on\":false");
        if (sb.action == NL_BUMP_FLASH) r += String(F(",\"master\":")) + bumpBri;
        r += "}";
        unqueueSlotString(sb.apply);   // it never showed: only the off (and master) is left to do
        queueSlotString(r);
        // Marked like a slot restore, so a preset bump starting next applies it
        // before its snapshot: else the snapshot holds the flash or blackout and
        // the preset bump's release brings it back (stuck on; 2026-11-09 bench).
        slotRestoreQueued[SLOT_BUMP] = r;
      } else {
        unqueueSlotString(sb.apply);   // it never showed: nothing to undo but the restore
        queueSlotString(sb.restore);
        if (sb.slot < SLOT_COUNT) slotRestoreQueued[sb.slot] = sb.restore;
      }
    }

    // Applies, now, the slot restores still queued (slot bumps that ended), so a
    // state snapshot taken next doesn't keep their look (a palette bump replaced
    // by a preset bump would otherwise come back on its release; 2026-11-09).
    void flushSlotRestores() {
      for (unsigned sl = 0; sl < SLOT_COUNT; sl++) {
        if (!slotRestoreQueued[sl].length()) continue;
        const String r = slotRestoreQueued[sl];
        if (!applySlot(r)) continue;   // JSON buffer busy: it stays queued
        unqueueSlotString(r);
        slotRestoreQueued[sl] = String();
      }
    }

    void unqueueSlotString(const String &r) {
      if (!r.length()) return;
      for (unsigned i = 0; i < slotQueueLen; i++) {
        if (slotQueue[i] != r) continue;
        for (unsigned j = i + 1; j < slotQueueLen; j++) slotQueue[j - 1] = slotQueue[j];
        slotQueue[--slotQueueLen] = String();
        return;
      }
    }

    // A slot command while a bump holds that slot: what the slot goes back to.
    bool slotCommandUnderBump(unsigned sl, const String &r) {
      for (SlotBump *sb : { &bodySlotBump, &finSlotBump })
        if (sb->on && sb->slot == sl && sb->action != NL_BUMP_FLASH && sb->action != NL_BUMP_BLACKOUT) {
          sb->restore = r;
          return true;
        }
      return false;
    }

    // WLED's layer slots, for the base (NL_MSG_WLED_LAYERS).
    void sendLayers() {
      nl_wled_layers_t m = {};
      if (strip.isMatrix) {
        m.count = NL_SLOT_COUNT;
        for (unsigned i = 0; i < NL_SLOT_COUNT && i < SLOT_COUNT; i++) {
          nl_slot_state_t &st = m.slot[i];
          if (i >= strip.getSegmentsNum() || !strip.getSegment(i).isActive()) continue;
          const Segment &g = strip.getSegment(i);
          st.on = g.on; st.look = (uint8_t)slotLook[i]; st.fx = g.mode; st.palette = g.palette;
          st.blend = g.blendMode; st.opacity = g.opacity;
        }
      }
      send(ESPNOW_BROADCAST_ADDRESS, NL_MSG_WLED_LAYERS, &m, sizeof(m));
    }

    // One number from a JSON array; false at its closing bracket or the end.
    static bool nextNumber(File &f, float &out) {
      char buf[24];
      int n = 0;
      while (f.available()) {
        const char c = f.read();
        if ((c >= '0' && c <= '9') || c == '-' || c == '.' || c == 'e' || c == 'E' || c == '+') {
          if (n < (int)sizeof(buf) - 1) buf[n++] = c;
          continue;
        }
        if (n) { buf[n] = 0; out = strtof(buf, nullptr); return true; }
        if (c == ']') return false;
      }
      return false;
    }

    void freeFinFollow() {
      for (int k = 0; k < 2; k++) {
        free(finFollow[k].rest); free(finFollow[k].dst); free(finFollow[k].src);
        finFollow[k] = {};
      }
      finFollowCount = 0;
      free(finColors); finColors = nullptr; finColorsLen = 0;
    }

    void readFinGeo() {
      freeFinFollow();
      File f = WLED_FS.open(F("/ledmap.json"), "r");
      if (!f) return;
      if (f.find("\"fingeo\":[")) {
        bool ok = true;
        for (int i = 0; i < 5 && ok; i++) ok = nextNumber(f, finGrid[i]);
        float nf = 0;
        ok = ok && nextNumber(f, nf) && nf >= 0 && nf <= 2;
        const int n = ok ? (int)nf : 0;
        for (int k = 0; k < n && ok; k++) {
          FinFollow &ff = finFollow[k];
          float side = 0, start = 0, count = 0;
          ok = nextNumber(f, side) && nextNumber(f, start) && nextNumber(f, count);
          for (int j = 0; j < 3 && ok; j++) ok = nextNumber(f, ff.hinge[j]);
          for (int j = 0; j < 3 && ok; j++) ok = nextNumber(f, ff.turn[j]);
          ok = ok && nextNumber(f, ff.modelDeg) && count > 0 && count < 1000;
          ff.side = (uint8_t)side; ff.start = (uint16_t)start; ff.count = (uint16_t)count;
          ff.srcDeg = NAN;
        }
        for (int k = 0; k < n && ok; k++) {
          FinFollow &ff = finFollow[k];
          ff.rest = (float *)malloc(ff.count * 3 * sizeof(float));
          ok = ff.rest != nullptr;
          for (unsigned i = 0; i < ff.count * 3u && ok; i++) ok = nextNumber(f, ff.rest[i]);
        }
        if (ok) finFollowCount = n;
        else freeFinFollow();
      }
      f.close();
      haveFinPanel = false;
      f = WLED_FS.open(F("/ledmap.json"), "r");
      if (!f) return;
      if (f.find("\"finpanel\":[")) {
        bool ok = true;
        for (int i = 0; i < 9 && ok; i++) ok = nextNumber(f, finPanel[i]);
        haveFinPanel = ok && finPanel[2] >= 1 && finPanel[3] >= 1 && finPanel[4] > 0;
      }
      f.close();
    }

    // Whether a segment is on in the fin panel (the fins then show it).
    bool panelSegmentOn() const {
      if (!haveFinPanel) return false;
      for (unsigned i = 0; i < strip.getSegmentsNum(); i++) {
        const Segment &sg = strip.getSegment(i);
        if (sg.isActive() && sg.on && sg.start >= (unsigned)finPanel[0]) return true;
      }
      return false;
    }

    // Swing a fin to deg and find the cell each of its LEDs is over now: in the
    // side view (mode 0), or in the fin panel seen from the side or from above.
    void placeFin(FinFollow &f, float deg, unsigned W, unsigned H, uint8_t mode) {
      const float a = (f.modelDeg - deg) * (float)M_PI / 180.0f, cs = cosf(a), sn = sinf(a);
      const float *k = f.turn, *c = f.hinge;
      const float cell = finGrid[0], u0 = finGrid[1], v1 = finGrid[2], ox = finGrid[3], oy = finGrid[4];
      for (unsigned i = 0; i < f.count; i++) {
        const float *p = f.rest + i * 3;
        const float v[3] = { p[0] - c[0], p[1] - c[1], p[2] - c[2] };
        const float kv = k[0] * v[0] + k[1] * v[1] + k[2] * v[2];
        const float kx[3] = { k[1] * v[2] - k[2] * v[1], k[2] * v[0] - k[0] * v[2], k[0] * v[1] - k[1] * v[0] };
        float q[3];
        for (int j = 0; j < 3; j++) q[j] = c[j] + v[j] * cs + kx[j] * sn + k[j] * kv * (1 - cs);
        long x, y, x0 = 0, y0 = 0, x1 = W - 1, y1 = H - 1;
        if (mode == 0) {
          x = lroundf((q[1] - u0 + ox) / cell - 0.5f);
          y = lroundf((v1 - q[2] + oy) / cell - 0.5f);
        } else {
          const float *P = finPanel;
          x0 = (long)P[0]; y0 = (long)P[1]; x1 = x0 + (long)P[2] - 1; y1 = y0 + (long)P[3] - 1;
          if (mode == 1 + NL_FIN_PROJ_TOP) {   // from above, nose right, starboard down
            x = x0 + lroundf((q[1] - P[7]) / P[4] - 0.5f);
            y = y0 + lroundf((q[0] - P[8]) / P[4] - 0.5f);
          } else {                             // from starboard, like the side view
            x = x0 + lroundf((q[1] - P[5]) / P[4] - 0.5f);
            y = y0 + lroundf((P[6] - q[2]) / P[4] - 0.5f);
          }
        }
        x = x < x0 ? x0 : x > x1 ? x1 : x;
        y = y < y0 ? y0 : y > y1 ? y1 : y;
        x = x >= (long)W ? (long)W - 1 : x;
        y = y >= (long)H ? (long)H - 1 : y;
        f.src[i] = (uint16_t)(y * W + x);
      }
      f.srcDeg = deg;
      f.srcMode = mode;
    }

    // Fins whose angle is known: gather the colours under each LED (from the
    // effect's own picture, before anything is copied over it).
    void gatherFinColors() {
      finFollowing = 0;
      if (!finFollowCount || !finColors) return;
      const unsigned long now = millis();
      const unsigned W = Segment::maxWidth, H = Segment::maxHeight;
      unsigned n = 0;
      const uint8_t mode = finPanelOn ? 1 + finProj : 0;
      for (int k = 0; k < finFollowCount; k++) {
        FinFollow &f = finFollow[k];
        float deg;
        if (!f.dst || !f.src || f.side > 1) continue;
        if (!finAngle(f.side, now, deg)) {
          if (!mode) continue;    // the side view: the static map already has the fin at its modelled angle
          deg = f.modelDeg;       // the panel: locked, or no sensor
        }
        if (isnan(f.srcDeg) || f.srcMode != mode || fabsf(deg - f.srcDeg) >= 0.2f) placeFin(f, deg, W, H, mode);
        // NoMap: most cells have no LED of their own, and getPixelColor() reads those as black.
        for (unsigned i = 0; i < f.count && n < finColorsLen; i++) finColors[n++] = strip.getPixelColorNoMap(f.src[i]);
        finFollowing |= 1 << k;
      }
    }

    void writeFinColors() {
      unsigned n = 0;
      for (int k = 0; k < finFollowCount; k++) {
        if (!(finFollowing & (1 << k))) continue;
        const FinFollow &f = finFollow[k];
        for (unsigned i = 0; i < f.count && n < finColorsLen; i++, n++)
          if (f.dst[i] != 0xFFFF) strip.setPixelColor(f.dst[i], finColors[n]);
      }
    }

    void readCopyRanges() {
      copyRangeCount = 0;
      File f = WLED_FS.open(F("/ledmap.json"), "r");
      if (!f) return;
      if (f.find("\"copy\":[")) {
        uint32_t vals[16];
        int n = 0, depth = 1;
        long num = -1;
        while (f.available() && depth > 0 && n < 16) {
          const char c = f.read();
          if (c >= '0' && c <= '9') { num = (num < 0 ? 0 : num * 10) + (c - '0'); continue; }
          if (num >= 0) { vals[n++] = num; num = -1; }
          if (c == '[') depth++;
          else if (c == ']') depth--;
        }
        for (int i = 0; i + 3 < n && copyRangeCount < 4; i += 4)
          if (vals[i + 1] && vals[i + 3]) copyRanges[copyRangeCount++] = { (uint16_t)vals[i], (uint16_t)vals[i + 1], (uint16_t)vals[i + 2], (uint16_t)vals[i + 3] };
      }
      f.close();
    }

    // Matrix cell of each physical LED, from WLED's map; then the pairs.
    void buildCopyPairs() {
      free(copyPairs);
      copyPairs = nullptr;
      copyPairCount = 0;
      copyBuiltFor = strip.getLengthTotal();
      copyBuiltMap = currentLedmap;
      copyBuiltMatrix = strip.isMatrix;
      copyBuiltAt = millis();
      // every output, network ones included (the simulator bench sends its LEDs over the network)
      const unsigned phys = BusManager::getTotalLength(false), total = strip.getLengthTotal();
      if (!strip.isMatrix || (!copyRangeCount && !finFollowCount) || !phys) return;
      uint16_t *cellOf = (uint16_t *)malloc(phys * sizeof(uint16_t));
      if (!cellOf) return;
      for (unsigned p = 0; p < phys; p++) cellOf[p] = 0xFFFF;
      for (unsigned i = 0; i < total; i++) {
        const uint16_t p = strip.getMappedPixelIndex(i);
        if (p < phys) cellOf[p] = i;
      }
      unsigned count = 0;
      for (int r = 0; r < copyRangeCount; r++) count += copyRanges[r].dstN;
      copyPairs = (uint16_t *)malloc(count * 2 * sizeof(uint16_t));
      if (copyPairs) {
        for (int r = 0; r < copyRangeCount; r++) {
          const CopyRange &c = copyRanges[r];
          for (unsigned k = 0; k < c.dstN; k++) {
            // the partner at the same fraction along its own range
            const unsigned d = c.dst + k, sidx = c.src + (c.dstN > 1 ? (k * (c.srcN - 1) + (c.dstN - 1) / 2) / (c.dstN - 1) : 0);
            if (d >= phys || sidx >= phys || cellOf[d] == 0xFFFF || cellOf[sidx] == 0xFFFF) continue;
            copyPairs[copyPairCount * 2] = cellOf[d];
            copyPairs[copyPairCount * 2 + 1] = cellOf[sidx];
            copyPairCount++;
          }
        }
      }
      // The cells that drive each fin LED, for following the fins' angle.
      unsigned finLeds = 0;
      for (int k = 0; k < finFollowCount; k++) {
        FinFollow &f = finFollow[k];
        free(f.dst); free(f.src);
        f.dst = (uint16_t *)malloc(f.count * sizeof(uint16_t));
        f.src = (uint16_t *)malloc(f.count * sizeof(uint16_t));
        f.srcDeg = NAN;
        if (!f.dst || !f.src) { free(f.dst); free(f.src); f.dst = f.src = nullptr; continue; }
        for (unsigned i = 0; i < f.count; i++) f.dst[i] = f.start + i < phys ? cellOf[f.start + i] : 0xFFFF;
        finLeds += f.count;
      }
      free(finColors);
      finColors = finLeds ? (uint32_t *)malloc(finLeds * sizeof(uint32_t)) : nullptr;
      finColorsLen = finColors ? finLeds : 0;
      free(cellOf);
    }

    bool mirroring(unsigned long now) const { return mirrorPort && (long)(mirrorUntil - now) > 0; }

    // One frame as the LEDs show it (gamma and brightness applied; the
    // current limiter's extra dimming is not included), as DDP packets.
    void sendMirrorFrame() {
      // Every LED's colour, put where WLED sends it (through the LED map, so
      // 2D matrix cells land on their LEDs), with gamma and brightness.
      const unsigned phys = BusManager::getTotalLength(false), total = strip.getLengthTotal();
      if (mirrorRgbLeds != phys) {
        free(mirrorRgb);
        mirrorRgb = (uint8_t *)malloc(phys * 3);
        mirrorRgbLeds = mirrorRgb ? phys : 0;
        if (!mirrorRgb) return;
      }
      memset(mirrorRgb, 0, phys * 3);
      const uint8_t bri = strip.getBrightness();
      if (bri) {
        for (unsigned i = 0; i < total; i++) {
          const unsigned p = strip.getMappedPixelIndex(i);
          if (p >= phys) continue;
          uint32_t c = strip.getPixelColor(i);
          if (!c) continue;
          c = gamma32(c);
          const uint8_t w = W(c);
          uint8_t *d = mirrorRgb + p * 3;
          d[0] = scale8(qadd8(w, R(c)), bri);  // white folded into RGB, like the live view
          d[1] = scale8(qadd8(w, G(c)), bri);
          d[2] = scale8(qadd8(w, B(c)), bri);
        }
      }
      for (unsigned start = 0; start < phys; start += DDP_MAX_LEDS) {
        const unsigned n = min((unsigned)DDP_MAX_LEDS, phys - start);
        const bool last = start + n >= phys;
        const uint32_t offset = start * 3;
        ddpBuf[0] = 0x40 | (last ? 0x01 : 0x00);  // version 1, push on the last packet
        ddpBuf[1] = ddpSeq & 0x0f;
        ddpBuf[2] = 0x0b;                          // RGB, 8 bits per channel
        ddpBuf[3] = 1;                             // output device
        ddpBuf[4] = offset >> 24; ddpBuf[5] = offset >> 16; ddpBuf[6] = offset >> 8; ddpBuf[7] = offset;
        ddpBuf[8] = (n * 3) >> 8; ddpBuf[9] = (n * 3) & 0xff;
        memcpy(ddpBuf + 10, mirrorRgb + offset, n * 3);
        mirrorUdp.beginPacket(mirrorIp, mirrorPort);
        mirrorUdp.write(ddpBuf, 10 + n * 3);
        mirrorUdp.endPacket();
      }
      ddpSeq++;
      mirrorFrames++;
    }

    // What the eyes get from us (audio features) and tell us (telemetry), so
    // the simulator's eyes can follow the real ones.
    void sendMirrorState(unsigned long now) {
      char buf[640];
      const nl_audio_t &a = lastAudioOut;
      const nl_eye_telemetry_t &e = eyes;
      int len = snprintf(buf, sizeof(buf),
        "{\"wled\":{\"bri\":%u,\"ps\":%d,\"finps\":%d,\"finproj\":%d,\"on\":%s,\"limit_ma\":%u,\"pack_mv\":%u", bri, bodyPreset, finPreset, finProj,
        bri ? "true" : "false", (unsigned)BusManager::ablMilliampsMax(), power.heard ? (unsigned)power.pack_mv : 0u);
      if (strip.isMatrix) {   // the layer slots: [on, look, fx, palette, blend, opacity] each
        len += snprintf(buf + len, sizeof(buf) - len, ",\"slots\":[");
        for (unsigned i = 0; i < SLOT_COUNT; i++) {
          const bool exists = i < strip.getSegmentsNum() && strip.getSegment(i).isActive();
          const Segment &g = strip.getSegment(exists ? i : 0);
          len += snprintf(buf + len, sizeof(buf) - len, "%s[%d,%u,%u,%u,%u,%u]", i ? "," : "", exists && g.on ? 1 : 0, slotLook[i],
                          exists ? g.mode : 0, exists ? g.palette : 0, exists ? g.blendMode : 0, exists ? g.opacity : 0);
        }
        len += snprintf(buf + len, sizeof(buf) - len, "]");
      }
      len += snprintf(buf + len, sizeof(buf) - len, "}");
      if (lastAudioOutAt && now - lastAudioOutAt < 1000)
        len += snprintf(buf + len, sizeof(buf) - len,
          ",\"audio\":[%.2f,%.2f,%.2f,%.2f,%.3f,%.3f,%.4f,%.3f,%lu,%lu]",
          a.level_db, a.avg_db, a.noise_floor_db, a.gain_db, a.loudness, a.warmth, a.beat_period_s,
          a.beat_confidence, (unsigned long)a.beat_count, (unsigned long)a.peak_count);
      {
        char fbuf[96];
        int fn = 0;
        for (int f = 0; f < 2; f++) {
          const bool fresh = finsAt[f] && now - finsAt[f] < 2000;
          float deg;
          if (finSweeping(f, now) && finAngle(f, now, deg))
            fn += snprintf(fbuf + fn, sizeof(fbuf) - fn, "%s{\"deg\":%.2f,\"sweep\":%.1f}", f ? "," : "", deg, finSweepPeriod[f]);
          else if (!fresh) fn += snprintf(fbuf + fn, sizeof(fbuf) - fn, "%snull", f ? "," : "");
          else if (fins.angle_cdeg[f] == NL_FIN_NONE) fn += snprintf(fbuf + fn, sizeof(fbuf) - fn, "%s{\"raw\":%u}", f ? "," : "", fins.raw[f]);
          else fn += snprintf(fbuf + fn, sizeof(fbuf) - fn, "%s{\"deg\":%.2f,\"raw\":%u}", f ? "," : "", fins.angle_cdeg[f] / 100.0f, fins.raw[f]);
        }
        len += snprintf(buf + len, sizeof(buf) - len, ",\"fins\":[%s],\"finfollow\":%s", fbuf, finFollowOn ? "true" : "false");
      }
      if (haveEyes && now - eyesAt < 2000) {
        char name[NL_NAME_LEN + 1] = { 0 };
        for (int i = 0; i < NL_NAME_LEN && e.name[i]; i++) name[i] = (e.name[i] == '"' || e.name[i] == '\\') ? ' ' : e.name[i];
        len += snprintf(buf + len, sizeof(buf) - len,
          ",\"eyes\":{\"preset\":%u,\"count\":%u,\"state\":%u,\"linked\":%u,\"bri\":%u,\"flags\":%u,"
          "\"tempo\":%.1f,\"hype\":%.2f,\"name\":\"%s\"}",
          e.preset, e.preset_count, e.state, e.linked, e.brightness, e.flags, e.tempo_bpm, e.hype, name);
      }
      if (len > 0 && len < (int)sizeof(buf) - 1) {
        buf[len++] = '}';
        mirrorUdp.beginPacket(mirrorIp, mirrorPort + 1);
        mirrorUdp.write((const uint8_t *)buf, len);
        mirrorUdp.endPacket();
      }
    }

    void mirrorLoop() {
      const unsigned long now = millis();
      if (!mirroring(now)) {
        if (mirrorRgb) { free(mirrorRgb); mirrorRgb = nullptr; mirrorRgbLeds = 0; }  // only while streaming
        return;
      }
      if (now - lastMirror < MIRROR_MIN_MS) return;
      lastMirror = now;
      sendMirrorFrame();
      sendMirrorState(now);
    }

    // ---- preview stream
    void previewLoop(unsigned long now) {
      if (display || (abSide < 0 && !previewOn)) return;   // two brains: always, for the base's Live and Standby sharks
      Bus *bus = wireSourceBus();
      if (!bus) return;
      const unsigned total = bus->getLength();
      if (previewNext == 0 && now - previewFrameAt < 1000UL / max((uint8_t)1, previewFps)) return;
      if (now - previewChunkAt < 2) return;
      nl_preview_t m;
      const unsigned n = min((unsigned)NL_PREVIEW_CHUNK_LEDS, total - previewNext);
      const bool last = previewNext + n >= total;
      if (previewNext == 0) previewFrameAt = now;
      m.frame = previewFrame;
      m.flags = last ? NL_PREVIEW_LAST : 0;
      m.start = previewNext;
      m.total = total;
      for (unsigned i = 0; i < n; i++) {
        const uint32_t c = bus->getPixelColor(previewNext + i);
        m.rgb332[i] = (R(c) & 0xE0) | ((G(c) & 0xE0) >> 3) | (B(c) >> 6);
      }
      send(ESPNOW_BROADCAST_ADDRESS, NL_MSG_PREVIEW, &m, NL_PREVIEW_HEADER_LEN + n);
      previewChunkAt = now;
      previewChunks++;
      previewNext = last ? 0 : previewNext + n;
      if (last) { previewFrame++; previewFrames++; }
    }

    // ---- wire link
    void wireStop() {
      if (wirePinUp >= 0) {
        uart_driver_delete(WIRE_UART);
        PinManager::deallocatePin(wirePinUp, PinOwner::UM_Unspecified);
      }
      if (retPinUp >= 0) PinManager::deallocatePin(retPinUp, PinOwner::UM_Unspecified);
      retPinUp = -1;
      free(retParser); retParser = nullptr;
      free(wireBuf); wireBuf = nullptr;
      wirePinUp = -1;
      for (int i = 0; i < 2; i++) {
        WireIn &w = wireIn[i];
        if (w.pinUp >= 0) {
          uart_driver_delete(w.uart);
          PinManager::deallocatePin(w.pinUp, PinOwner::UM_Unspecified);
        }
        free(w.parser); w.parser = nullptr;
        free(w.frame); w.frame = nullptr;
        w.pinUp = -1;
      }
    }

    void wireStartTx() {
      wireNote = "";
      if (wirePin < 0) { wireNote = "off"; return; }
      if (!PinManager::allocatePin(wirePin, true, PinOwner::UM_Unspecified)) { wireNote = "pin in use or not usable"; return; }
      uart_config_t cfg = {};
      cfg.baud_rate = (int)wireBaud;
      cfg.data_bits = UART_DATA_8_BITS;
      cfg.parity = UART_PARITY_DISABLE;
      cfg.stop_bits = UART_STOP_BITS_1;
      cfg.flow_ctrl = UART_HW_FLOWCTRL_DISABLE;
      cfg.source_clk = UART_SCLK_APB;
      wireBuf = (uint8_t *)malloc(NL_PIX_FRAME_MAX);
      if (!wireBuf || uart_driver_install(WIRE_UART, retPin >= 0 ? RET_RX_BUF : 256, WIRE_TX_BUF, 0, nullptr, 0) != ESP_OK) {
        PinManager::deallocatePin(wirePin, PinOwner::UM_Unspecified);
        free(wireBuf); wireBuf = nullptr;
        wireNote = "no memory or UART";
        return;
      }
      uart_param_config(WIRE_UART, &cfg);
      uart_set_pin(WIRE_UART, wirePin, UART_PIN_NO_CHANGE, UART_PIN_NO_CHANGE, UART_PIN_NO_CHANGE);
      wirePinUp = wirePin;
      wireBaudUp = wireBaud;
      wireLastAt = 0;
      retStartRx();
    }

    // On a brain: the return wire comes in on the same UART as the picture goes out.
    void retStartRx() {
      if (retPin < 0 || wirePinUp < 0) return;
      if (!PinManager::allocatePin(retPin, false, PinOwner::UM_Unspecified)) return;
      retParser = (nl_pix_parser_t *)malloc(sizeof(nl_pix_parser_t));
      if (!retParser) { PinManager::deallocatePin(retPin, PinOwner::UM_Unspecified); return; }
      nl_pix_parser_init(retParser);
      uart_set_pin(WIRE_UART, UART_PIN_NO_CHANGE, retPin, UART_PIN_NO_CHANGE, UART_PIN_NO_CHANGE);
      uart_set_rx_full_threshold(WIRE_UART, 32);
      if (GPIO_IS_VALID_OUTPUT_GPIO(retPin)) gpio_pullup_en((gpio_num_t)retPin);  // idle high with the controller off
      retPinUp = retPin;
    }

    // On the display: out on the first wire's UART, which was installed with a TX buffer for it.
    void retStartTx() {
      if (retPin < 0 || wireIn[0].pinUp < 0) return;
      if (!PinManager::allocatePin(retPin, true, PinOwner::UM_Unspecified)) return;
      uart_set_pin(WIRE_UART, retPin, UART_PIN_NO_CHANGE, UART_PIN_NO_CHANGE, UART_PIN_NO_CHANGE);
      esp_read_mac(ownMac, ESP_MAC_WIFI_STA);
      retPinUp = retPin;
    }

    // Input i on the display: wire_pin (Right Brain) or wire_pin_b (Left Brain).
    void wireStartRx(int i, int8_t pin, bool ab_on) {
      WireIn &w = wireIn[i];
      w.uart = i ? WIRE_UART_B : WIRE_UART;
      w.note = "";
      w.prevFrame = w.curFrame = -1;
      w.curLeds = 0;
      w.lastAt = 0;
      if (pin < 0) { w.note = "off"; return; }
      if (!PinManager::allocatePin(pin, false, PinOwner::UM_Unspecified)) { w.note = "pin in use or not usable"; return; }
      uart_config_t cfg = {};
      cfg.baud_rate = (int)wireBaud;
      cfg.data_bits = UART_DATA_8_BITS;
      cfg.parity = UART_PARITY_DISABLE;
      cfg.stop_bits = UART_STOP_BITS_1;
      cfg.flow_ctrl = UART_HW_FLOWCTRL_DISABLE;
      cfg.source_clk = UART_SCLK_APB;
      if (!wireBuf) wireBuf = (uint8_t *)malloc(WIRE_READ);
      w.parser = (nl_pix_parser_t *)malloc(sizeof(nl_pix_parser_t));
      if (ab_on) w.frame = (uint8_t *)calloc(abLeds, 3);
      if (!wireBuf || !w.parser || (ab_on && !w.frame) ||
          uart_driver_install(w.uart, WIRE_RX_BUF, (i == 0 && retPin >= 0) ? RET_TX_BUF : 0, 0, nullptr, 0) != ESP_OK) {
        PinManager::deallocatePin(pin, PinOwner::UM_Unspecified);
        free(w.parser); w.parser = nullptr;
        free(w.frame); w.frame = nullptr;
        w.note = "no memory or UART";
        return;
      }
      uart_param_config(w.uart, &cfg);
      uart_set_pin(w.uart, UART_PIN_NO_CHANGE, pin, UART_PIN_NO_CHANGE, UART_PIN_NO_CHANGE);
      // Empty the 128-byte FIFO from 32 bytes, not the driver's 120: at 2 Mbaud
      // 8 bytes is 40 us, and Wi-Fi interrupts held it up longer than that
      // (~1 chunk in 1500 lost on a bench loopback; none at 32).
      uart_set_rx_full_threshold(w.uart, 32);
      // An idle line is high; hold it there while the brain is unplugged
      // (input-only pins like the controller's GPIO 39 need a resistor instead).
      if (GPIO_IS_VALID_OUTPUT_GPIO(pin)) gpio_pullup_en((gpio_num_t)pin);
      nl_pix_parser_init(w.parser);
      w.pinUp = pin;
      wireBaudUp = wireBaud;
    }

    void wireStart() {
      retPinSet = retPin;
      wireRx = display;
      if (!wireRx) { wireStartTx(); return; }
      abOn = wirePin >= 0 && wirePinB >= 0;
      abLeds = max(1u, (unsigned)strip.getLengthTotal());
      nl_ab_init(&ab);
      nl_bump_rx_init(&abBumps);
      wireStartRx(0, wirePin, abOn);
      wireStartRx(1, wirePinB, abOn);
      retStartTx();
      if (abOn && (wireIn[0].pinUp < 0 || wireIn[1].pinUp < 0)) abOn = false;  // the note says why
    }

    // The LEDs as WLED's network output sends them: its buffer, scaled by
    // the brightness it applies when sending.
    Bus *wireSourceBus() {
      for (size_t i = 0; i < BusManager::getNumBusses(); i++) {
        Bus *b = BusManager::getBus(i);
        if (b && b->isOk() && b->isVirtual()) return b;
      }
      return nullptr;
    }

    void wireSend(unsigned long now) {
      if (!frameShown && now - wireLastAt < WIRE_KEEPALIVE_MS) return;
      if (uart_wait_tx_done(WIRE_UART, 0) != ESP_OK) return;  // the last frame is still going out; send the newest when it's free
      Bus *bus = wireSourceBus();
      if (!bus) { wireNote = "no network LED output to copy"; wireLeds = 0; return; }
      wireNote = "";
      frameShown = false;
      wireLastAt = now;
      const uint32_t t0 = micros();
      const unsigned total = min((unsigned)bus->getLength(), 65535u);
      const uint8_t b = scaledBri(strip.getBrightness());
      uint8_t rgb[NL_PIX_CHUNK_LEDS * 3];
      for (unsigned start = 0; start < total; start += NL_PIX_CHUNK_LEDS) {
        const unsigned n = min((unsigned)NL_PIX_CHUNK_LEDS, total - start);
        for (unsigned i = 0; i < n; i++) {
          const uint32_t c = bus->getPixelColor(start + i);
          rgb[i * 3] = scale8(R(c), b);
          rgb[i * 3 + 1] = scale8(G(c), b);
          rgb[i * 3 + 2] = scale8(B(c), b);
        }
        const size_t len = nl_pix_encode(wireFrame, start, total, start + n >= total, rgb, n, wireBuf, NL_PIX_FRAME_MAX);
        if (len) uart_write_bytes(WIRE_UART, (const char *)wireBuf, len);
      }
      wireUs += micros() - t0;
      wireUsN++;
      wireFrame++;
      wireFrames++;
      wireFpsCount++;
      wireLeds = total;
    }

    // Both brains' latest frames are kept; what reaches the LEDs is the A/B switch's choice.
    void abDraw(const nl_ab_output_t &o, unsigned total) {
      realtimeLock(realtimeTimeoutMs, REALTIME_MODE_DDP);
      if (!realtimeOverride) {
        const unsigned n = min(total, abLeds);
        const uint8_t *to = wireIn[o.show].frame, *from = wireIn[o.from].frame;
        if (o.weight == 255) {
          for (unsigned i = 0; i < n; i++) setRealtimePixel(i, to[i * 3], to[i * 3 + 1], to[i * 3 + 2], 0);
        } else {
          for (unsigned i = 0; i < n; i++) {
            uint8_t c[3];
            nl_ab_mix(c, from + i * 3, to + i * 3, 3, o.weight);
            setRealtimePixel(i, c[0], c[1], c[2], 0);
          }
        }
      }
      e131NewData = true;  // WLED shows it from handleNotifications(), as for a DDP push
    }

    void wireChunk(int input, const nl_pix_chunk_t &ch, unsigned long now) {
      WireIn &w = wireIn[input];
      if (w.lastAt && now - w.lastAt > 1000) w.prevFrame = -1;  // the brain restarted or was unplugged: start counting
      w.lastAt = now;
      if (ch.frame != w.curFrame) { w.curFrame = ch.frame; w.curLeds = 0; }
      w.curLeds += ch.count;
      if (abOn) {
        if (ch.start < abLeds) memcpy(w.frame + ch.start * 3, ch.rgb, min((unsigned)ch.count, abLeds - ch.start) * 3);
      } else {
        realtimeLock(realtimeTimeoutMs, REALTIME_MODE_DDP);
        if (!realtimeOverride)
          for (unsigned i = 0; i < ch.count; i++)
            setRealtimePixel(ch.start + i, ch.rgb[i * 3], ch.rgb[i * 3 + 1], ch.rgb[i * 3 + 2], 0);
      }
      if (!(ch.flags & NL_PIX_LAST)) return;
      if (w.curLeds < ch.total) w.partial++;
      if (w.prevFrame >= 0) w.lost += (uint8_t)(ch.frame - w.prevFrame - 1);
      w.prevFrame = ch.frame;
      w.curFrame = -1;
      w.leds = ch.total;
      w.frames++;
      w.fpsCount++;
      if (abOn) {
        nl_ab_frame(&ab, input, now);
        const nl_ab_output_t o = nl_ab_output(&ab, now);
        if (input == o.show) abDraw(o, ch.total);
      } else {
        e131NewData = true;  // WLED shows it from handleNotifications(), as for a DDP push
      }
    }

    void wireReceive(int input, unsigned long now) {
      WireIn &w = wireIn[input];
      size_t avail = 0;
      uart_get_buffered_data_len(w.uart, &avail);
      while (avail) {
        const int n = uart_read_bytes(w.uart, wireBuf, min(avail, (size_t)WIRE_READ), 0);
        if (n <= 0) break;
        avail -= min(avail, (size_t)n);
        for (int i = 0; i < n; i++) {
          nl_pix_chunk_t ch;
          nl_relay_t relay;
          const nl_wire_event_t ev = nl_wire_parse_byte(w.parser, wireBuf[i], &ch, &relay);
          if (ev == NL_WIRE_CHUNK) wireChunk(input, ch, now);
          else if (ev == NL_WIRE_RELAY && relay.len <= sizeof(RxItem::data)) {
            RxItem it;
            memcpy(it.mac, relay.mac, 6);
            it.len = relay.len;
            memcpy(it.data, relay.pkt, relay.len);
            relayRx++;
            handleFrom(it, true);
          }
        }
      }
    }

    void wireLoop() {
      if (wireRecheck || display != wireRx || retPin != retPinSet || (display ? wirePin != wireIn[0].pinUp || wirePinB != wireIn[1].pinUp : wirePin != wirePinUp) ||
          ((wirePinUp >= 0 || wireIn[0].pinUp >= 0 || wireIn[1].pinUp >= 0) && wireBaud != wireBaudUp)) {
        if (!wireRetryAt || millis() >= wireRetryAt) {   // a pin that won't start is only retried now and then
          wireRecheck = false;
          wireStop();
          wireStart();
          wireRetryAt = millis() + 5000;
        }
      }
      const unsigned long now = millis();
      if (now - wireFpsAt >= 1000) {
        const unsigned long dt = max(1UL, now - wireFpsAt);
        wireFps = wireFpsCount * 1000 / dt;
        wireFpsCount = 0;
        for (int i = 0; i < 2; i++) {
          wireIn[i].fps = wireIn[i].fpsCount * 1000 / dt;
          wireIn[i].fpsCount = 0;
        }
        wireFpsAt = now;
      }
      if (wireRx) {
        for (int i = 0; i < 2; i++) if (wireIn[i].pinUp >= 0) wireReceive(i, now);
      } else if (wirePinUp >= 0) {
        retReceive(now);
        wireSend(now);
      }
    }

    // ---- return wire
    // On the display: a packet as if broadcast, in the relay framing with our own MAC.
    void retSend(uint8_t type, const void *payload, size_t len) {
      if (retPinUp < 0) return;
      uint8_t pkt[NL_RADIO_MAX];
      const size_t n = nl_radio_build(pkt, sizeof(pkt), type, seq++, NL_ROLE_WLED, NL_SIDE_NONE, payload, len);
      if (!n) return;
      uint8_t out[NL_RELAY_FRAME_MAX];
      const size_t k = nl_relay_encode(ownMac, pkt, n, out, sizeof(out));
      if (k && uart_write_bytes(WIRE_UART, (const char *)out, k) == (int)k) retTx++;
    }

    // On the display: AudioReactive's analysis of the controller's mic, as its own sync packet.
    // Its sync mode stays "send": in any other mode it stops listening while the wires drive the LEDs.
    void retAudio(unsigned long now) {
      if (retPinUp < 0 || now - lastArAt < NL_AR_SYNC_MS) return;
      lastArAt = now;
      um_data_t *um = nullptr;
      if (!UsermodManager::getUMData(&um, USERMOD_ID_AUDIOREACTIVE) || !um) return;
      nl_ar_sync_t a = {};
      memcpy(a.header, NL_AR_SYNC_HEADER, sizeof(NL_AR_SYNC_HEADER));
      a.sample_smooth = *(float *)um->u_data[0];
      a.sample_raw = *(int16_t *)um->u_data[1];
      memcpy(a.fft, um->u_data[2], sizeof(a.fft));
      const bool peak = *(bool *)um->u_data[3];
      a.sample_peak = peak && !lastArPeak;   // once per beat: AudioReactive holds it a while
      lastArPeak = peak;
      a.fft_major_peak = *(float *)um->u_data[4];
      a.fft_magnitude = *(float *)um->u_data[5];
      retSend(NL_MSG_AR_SYNC, &a, sizeof(a));
      arOut++;
    }

    // On a brain.
    void retReceive(unsigned long now) {
      if (retPinUp < 0) return;
      size_t avail = 0;
      uart_get_buffered_data_len(WIRE_UART, &avail);
      uint8_t buf[256];
      while (avail) {
        const int n = uart_read_bytes(WIRE_UART, buf, min(avail, sizeof(buf)), 0);
        if (n <= 0) break;
        avail -= min(avail, (size_t)n);
        for (int i = 0; i < n; i++) {
          nl_pix_chunk_t ch;
          nl_relay_t relay;
          if (nl_wire_parse_byte(retParser, buf[i], &ch, &relay) != NL_WIRE_RELAY || relay.len > sizeof(RxItem::data)) continue;
          RxItem it;
          memcpy(it.mac, relay.mac, 6);
          it.len = relay.len;
          memcpy(it.data, relay.pkt, relay.len);
          retRx++;
          retRxAt = now;
          handleFrom(it, true);
        }
      }
    }

    // On a brain: the controller's sound, handed to our AudioReactive as if it came over the network.
    void arInject(const uint8_t *pl, size_t len) {
      if (arSock < 0) {
        arSock = socket(AF_INET, SOCK_DGRAM, 0);
        if (arSock < 0) return;
        fcntl(arSock, F_SETFL, O_NONBLOCK);
      }
      sockaddr_in to = {};
      to.sin_family = AF_INET;
      to.sin_port = htons(NL_AR_SYNC_PORT);
      to.sin_addr.s_addr = htonl(INADDR_LOOPBACK);
      if (sendto(arSock, pl, len, 0, (const sockaddr *)&to, sizeof(to)) == (int)len) arIn++;
      nl_ar_sync_t a;
      memcpy(&a, pl, sizeof(a));
      arLevel = a.sample_smooth;
      arLevelMax = max(arLevelMax, a.sample_smooth);
      if (a.sample_peak) arBeats++;
    }

    // On a brain: what the controller needs goes down the wire too, so it can do without its radio.
    void wireRelay(const RxItem &it) {
      if (wirePinUp < 0) return;
      uint8_t out[NL_RELAY_FRAME_MAX];
      const size_t n = nl_relay_encode(it.mac, it.data, it.len, out, sizeof(out));
      if (n) {
        uart_write_bytes(WIRE_UART, (const char *)out, n);
        relayTx++;
      }
    }

    // On a brain: NL_OP_CTL_WIFI down our wire, as if relayed from the base.
    void sendCtlWifi(bool on) {
      if (wirePinUp < 0) return;
      nl_cmd_t cmd = {};
      cmd.id = (uint16_t)(esp_random() | 1);
      cmd.target = NL_TARGET_AB;
      cmd.op = NL_OP_CTL_WIFI;
      cmd.arg = on ? 1 : 0;
      RxItem it;
      esp_read_mac(it.mac, ESP_MAC_WIFI_STA);
      it.len = nl_radio_build(it.data, sizeof(it.data), NL_MSG_CMD, seq++, NL_ROLE_WLED, NL_SIDE_NONE, &cmd, sizeof(cmd));
      if (it.len) wireRelay(it);
    }

    // ---- A/B brains
    bool abStandby() const { return abSide >= 0 && nl_ab_is_standby(abSide, abHeardAny, &abHeard); }

    void abSendState() {
      const uint8_t fps[2] = { (uint8_t)min(wireIn[0].fps, (uint16_t)255), (uint8_t)min(wireIn[1].fps, (uint16_t)255) };
      nl_ab_state_t st;
      nl_ab_state(&ab, millis(), fps, &st);
      send(ESPNOW_BROADCAST_ADDRESS, NL_MSG_AB, &st, sizeof(st));
      retSend(NL_MSG_AB, &st, sizeof(st));
    }

    // With only its access point up, lwIP has no route for multicast, so AudioReactive's
    // sound sync to the brains goes nowhere. Make the access point the default.
    void apDefaultRoute() {
      static unsigned long lastCheck = 0;
      if (millis() - lastCheck < 5000) return;
      lastCheck = millis();
      if (!apActive || WLED_CONNECTED) return;
      const uint32_t ip = (uint32_t)WiFi.softAPIP();
      for (netif *n = netif_list; n; n = n->next) {
        if (netif_ip4_addr(n)->addr == ip) {
          if (netif_default != n) netif_set_default(n);
          return;
        }
      }
    }

    // On the display, with both wires up.
    void abLoop() {
      if (!abOn) return;
      const unsigned long now = millis();
      const nl_bump_event_t ev = nl_bump_rx_tick(&abBumps, now);
      if (ev == NL_BUMP_EV_END) { nl_ab_hold(&ab, false, now); abDirty = true; }
      if (nl_ab_tick(&ab, now)) abDirty = true;
      if (abDirty || now - lastAbState >= NL_AB_STATE_MS) {
        abDirty = false;
        lastAbState = now;
        abSendState();
      }
    }

    void abBump(const nl_bump_t &b) {
      const nl_bump_event_t ev = nl_bump_rx_message(&abBumps, &b, millis());
      if (ev == NL_BUMP_EV_BEGIN || ev == NL_BUMP_EV_REPLACE) nl_ab_hold(&ab, true, millis());
      else if (ev == NL_BUMP_EV_END) nl_ab_hold(&ab, false, millis());
      if (ev != NL_BUMP_EV_NONE) abDirty = true;
    }

    uint8_t abTake(int fade_ms) {
      if (!abOn) return NL_ACK_UNSUPPORTED;
      if (!nl_ab_take(&ab, fade_ms > 0 ? (uint32_t)fade_ms : 0, millis())) return NL_ACK_BUSY;
      abDirty = true;
      return NL_ACK_OK;
    }

    uint8_t abTakeTo(int brain, int fade_ms) {
      if (!abOn) return NL_ACK_UNSUPPORTED;
      const bool was = ab.live;
      if (!nl_ab_take_to(&ab, brain, fade_ms > 0 ? (uint32_t)fade_ms : 0, millis())) return NL_ACK_BUSY;
      if ((bool)ab.live != was) abDirty = true;
      return NL_ACK_OK;
    }

    void wireInfoIn(JsonArray &wa, int i) {
      const WireIn &w = wireIn[i];
      char buf[170];
      const int8_t pin = i ? wirePinB : wirePin;
      if (w.pinUp < 0) {
        if (pin < 0) return;
        snprintf(buf, sizeof(buf), "%s's wire, GPIO %d: %s", brainName(i), pin, w.note);
      } else {
        const unsigned long ago = w.lastAt ? millis() - w.lastAt : 0;
        int n = snprintf(buf, sizeof(buf), "%s in on GPIO %d at %lu baud: ", brainName(i), w.pinUp, (unsigned long)wireBaudUp);
        if (!w.lastAt) n += snprintf(buf + n, sizeof(buf) - n, "nothing yet; ");
        else if (ago > 1000) n += snprintf(buf + n, sizeof(buf) - n, "nothing for %lu s; ", ago / 1000);
        else n += snprintf(buf + n, sizeof(buf) - n, "%u fps, %u LEDs; ", w.fps, w.leds);
        snprintf(buf + n, sizeof(buf) - n, "since boot %lu frames, %lu lost, %lu partial, %lu CRC errors, %lu bad",
                 (unsigned long)w.frames, (unsigned long)w.lost, (unsigned long)w.partial,
                 (unsigned long)w.parser->crc_errors, (unsigned long)w.parser->bad_chunks);
      }
      wa.add(buf);
    }

    // The brains by side: 0 (ab_side 0, wire_pin) is the Right Brain, 1 (wire_pin_b) the Left.
    static const char *brainName(int side) { return side ? "Left Brain" : "Right Brain"; }

    void wireInfo(JsonObject &user) {
      if (wirePin < 0 && wirePinUp < 0 && wirePinB < 0 && abSide < 0) return;
      JsonArray wa = user.createNestedArray(F("Nibbles wire"));
      char buf[220];
      if (wireRx) {
        wireInfoIn(wa, 0);
        wireInfoIn(wa, 1);
        if (abOn) {
          snprintf(buf, sizeof(buf), "A/B: %s Live, %s on the LEDs; %u takes, %u failovers", brainName(ab.live), brainName(ab.hold ? !ab.live : ab.live),
                   ab.takes, ab.failovers);
          wa.add(buf);
        }
        {
          snprintf(buf, sizeof(buf), "relayed from the brains: %lu messages%s", (unsigned long)relayRx, radioOff ? "; radio input off" : "");
          wa.add(buf);
        }
        if (wifiOff) {
          snprintf(buf, sizeof(buf), "radio %s", ctlWifiOn ? (WLED_CONNECTED ? "on until restart: joined the network" : "on until restart: joining the network") : "off");
          wa.add(buf);
        }
        if (retPin >= 0) {
          if (retPinUp < 0) snprintf(buf, sizeof(buf), "return wire GPIO %d: not running (pin in use, or the Right Brain's wire not up)", retPin);
          else snprintf(buf, sizeof(buf), "return wire out on GPIO %d: %lu messages, %lu of them sound", retPinUp, (unsigned long)retTx, (unsigned long)arOut);
          wa.add(buf);
        }
        return;
      }
      if (abSide >= 0) {
        snprintf(buf, sizeof(buf), "%s, %s%s; %lu messages relayed", brainName(abSide), abStandby() ? "Standby" : "Live", abHeardAny ? "" : " (the controller not heard yet)", (unsigned long)relayTx);
        wa.add(buf);
      }
      if (netFallback) {
        snprintf(buf, sizeof(buf), "network: %s; hosted it %lu times", fallbackOn ? "hosting it (the host is gone)" : WLED_CONNECTED ? "joined" : "joining",
                 (unsigned long)fallbacks);
        wa.add(buf);
      }
      if (wirePinUp >= 0 && retPinUp >= 0)
        wa.add(F("controller's radio: <button class=\"btn btn-xs\" onclick=\"requestJson({nibbles:{ctlwifi:true}});\">join the network</button> "
                 "<button class=\"btn btn-xs\" onclick=\"requestJson({nibbles:{ctlwifi:false}});\">off</button> (until it restarts)"));
      if (retPin >= 0) {
        if (retPinUp < 0) snprintf(buf, sizeof(buf), "return wire GPIO %d: not running", retPin);
        else {
          const unsigned long ago = retRxAt ? millis() - retRxAt : 0;
          snprintf(buf, sizeof(buf), "return wire in on GPIO %d: %s; %lu messages, %lu sound (level %.0f, highest %.0f since last look, %lu beats), %lu CRC errors, %lu bad", retPinUp,
                   !retRxAt ? "nothing yet" : ago > 1000 ? "silent" : "receiving",
                   (unsigned long)retRx, (unsigned long)arIn, arLevel, arLevelMax, (unsigned long)arBeats,
                   (unsigned long)retParser->crc_errors, (unsigned long)retParser->bad_chunks);
          arLevelMax = 0;
        }
        wa.add(buf);
      }
      if (wirePinUp < 0) {
        snprintf(buf, sizeof(buf), "GPIO %d: %s", wirePin, wireNote);
      } else if (wireNote[0]) {
        snprintf(buf, sizeof(buf), "out on GPIO %d: %s", wirePinUp, wireNote);
      } else {
        snprintf(buf, sizeof(buf), "out on GPIO %d at %lu baud: %u fps, %u LEDs, %.2f ms a frame (%lu frames since boot)", wirePinUp,
                 (unsigned long)wireBaudUp, wireFps, wireLeds, wireUsN ? wireUs / 1000.0f / wireUsN : 0.0f, (unsigned long)wireFrames);
        wireUs = wireUsN = 0;
      }
      wa.add(buf);
    }

    bool radioUp() const { return enabled && enableESPNow && statusESPNow == ESP_NOW_STATE_ON; }

    // Sent straight through ESP-IDF, not quickEspNow.send(): WLED starts
    // QuickEspNow in synchronous mode, where send() spins in WLED's loop until
    // the "sent" callback, and a send that fails (e.g. while Wi-Fi is still
    // connecting in station mode) never gets one. That hung WLED on the shark.
    void send(const uint8_t *mac, uint8_t type, const void *payload, size_t len) {
      if (!radioUp()) return;
      uint8_t pkt[NL_RADIO_MAX];
      const size_t n = nl_radio_build(pkt, sizeof(pkt), type, seq++, abStandby() ? NL_ROLE_WLED_STANDBY : NL_ROLE_WLED, NL_SIDE_NONE, payload, len);
      if (!n) return;
      esp_now_peer_info_t peer = {};
      memcpy(peer.peer_addr, mac, 6);
      peer.channel = 0;  // the current channel
      peer.ifidx = (apActive && !WLED_CONNECTED) ? WIFI_IF_AP : WIFI_IF_STA;
      esp_now_peer_info_t have;
      if (esp_now_get_peer(mac, &have) != ESP_OK) esp_now_add_peer(&peer);
      else if (have.ifidx != peer.ifidx) esp_now_mod_peer(&peer);
      esp_now_send(mac, pkt, n);  // returns at once; failures are simply dropped
    }

    void sendHeartbeat() {
      nl_heartbeat_t hb = {};
      hb.role = NL_ROLE_WLED;
      hb.side = NL_SIDE_NONE;
      hb.fw = NIBBLES_WLED_FW;
      hb.uptime_ms = millis();
      hb.fps_x10 = strip.getFps() * 10;
      // Not while searching for a network: that moves the radio across channels, and the
      // base and eyes would follow it.
      hb.flags = anchor && (WLED_CONNECTED || !isWiFiConfigured()) ? NL_HB_ANCHOR : 0;
      hb.channel = WiFi.channel();
      send(ESPNOW_BROADCAST_ADDRESS, NL_MSG_HEARTBEAT, &hb, sizeof(hb));
    }

    // AudioReactive's analysis as Nibbles audio features (see nl_ar_update).
    void sendAudio() {
      um_data_t *um = nullptr;
      if (!UsermodManager::getUMData(&um, USERMOD_ID_AUDIOREACTIVE) || !um) return;
      const float volume = *(float *)um->u_data[0];
      const uint8_t *fft = (const uint8_t *)um->u_data[2];
      const bool peak = *(uint8_t *)um->u_data[3];
      nl_audio_t a;
      nl_ar_update(&arState, volume, fft, peak, millis(), &a);
      lastAudioOut = a;
      lastAudioOutAt = millis();
      send(ESPNOW_BROADCAST_ADDRESS, NL_MSG_AUDIO, &a, sizeof(a));
      audioSent++;
    }

    // A new stream packet moves WLED's realtime timeout on.
    void streamLoop() {
      if (realtimeMode == REALTIME_MODE_INACTIVE || realtimeTimeout == seenRealtimeTimeout) return;
      seenRealtimeTimeout = realtimeTimeout;
      nl_stream_gaps_packet(&streamGaps, millis());
    }

    void streamSummary(nl_wled_stream_t &st) {
      st = {};
      st.active = realtimeMode != REALTIME_MODE_INACTIVE;
      if (st.active)
        for (int i = 0; i < 4; i++) st.source_ip[i] = realtimeIP[i];
      nl_stream_gaps_summary(&streamGaps, millis(), &st);
    }

    void sendStream() {
      nl_wled_stream_t st;
      streamSummary(st);
      send(ESPNOW_BROADCAST_ADDRESS, NL_MSG_WLED_STREAM, &st, sizeof(st));
    }

    // Whether the fins are followed, and the angle in use per fin, for the base.
    void sendFinState() {
      const unsigned long now = millis();
      nl_fin_state_t st = {};
      st.follow = finFollowOn;
      for (int f = 0; f < 2; f++) {
        float deg;
        if (!finFollowOn) {
          st.source[f] = NL_FIN_SRC_LOCKED;
          st.angle_cdeg[f] = NL_FIN_NONE;
          for (int k = 0; k < finFollowCount; k++)
            if (finFollow[k].side == f) st.angle_cdeg[f] = (int16_t)lroundf(finFollow[k].modelDeg * 100);
        } else if (finAngle(f, now, deg)) {
          st.source[f] = finSweeping(f, now) ? NL_FIN_SRC_SWEEP : NL_FIN_SRC_SENSOR;
          st.angle_cdeg[f] = (int16_t)lroundf(deg * 100);
        } else {
          st.source[f] = NL_FIN_SRC_NONE;
          st.angle_cdeg[f] = NL_FIN_NONE;
        }
      }
      st.fin_preset = finPreset;
      st.fin_proj = finProj;
      send(ESPNOW_BROADCAST_ADDRESS, NL_MSG_FIN_STATE, &st, sizeof(st));
    }

    void sendTelemetry() {
      nl_wled_telemetry_t t = {};
      t.on = bri > 0;
      t.bri = bri ? bri : briLast;
      t.preset = bodyPreset;   // the fins' preset goes in NL_MSG_FIN_STATE
      t.fx = strip.getMainSegment().mode;
      t.palette = strip.getMainSegment().palette;
      t.channel = WiFi.channel();
      t.fps = strip.getFps();
      t.leds = strip.getLengthTotal();
      refreshPresets();  // only reads the file after presets change
      auto it = presetNames.find(bodyPreset);
      if (bodyPreset && it != presetNames.end()) strlcpy(t.name, it->second.c_str(), sizeof(t.name));
      send(ESPNOW_BROADCAST_ADDRESS, NL_MSG_WLED_TELEMETRY, &t, sizeof(t));
    }

    void refreshPresets() {
      if (presetBitsValid && presetBitsTime == presetsModifiedTime) return;
      JSONBufferGuard guard(JSON_LOCK_NIBBLES);
      if (!guard) return;
      memset(presetBits, 0, sizeof(presetBits));
      presetNames.clear();
      File f = WLED_FS.open(F("/presets.json"), "r");
      if (!f) {
        presetBitsValid = true;  // no presets file: no presets
        presetBitsTime = presetsModifiedTime;
        return;
      }
      // Only the ids and names: a real presets.json (87 KB on the shark) is
      // far bigger than WLED's JSON buffer.
      StaticJsonDocument<64> filter;
      filter["*"]["n"] = true;
      pDoc->clear();
      const DeserializationError err = deserializeJson(*pDoc, f, DeserializationOption::Filter(filter));
      f.close();
      if (err) return;  // leave invalid; try again next time
      for (JsonPair kv : pDoc->as<JsonObject>()) {
        const int id = atoi(kv.key().c_str());
        if (id < 1 || id > 250) continue;
        presetBits[id / 8] |= 1 << (id % 8);
        const char *name = kv.value()["n"] | "";
        if (*name) presetNames[id] = name;
      }
      presetBitsValid = true;
      presetBitsTime = presetsModifiedTime;
    }

    bool presetExists(int id) const {
      return id >= 1 && id <= 250 && (presetBits[id / 8] & (1 << (id % 8)));
    }

    // The next (or previous) preset id that exists, wrapping around; 0 if none.
    int stepPreset(int from, int dir) const {
      for (int i = 1; i <= 250; i++) {
        int id = from + dir * i;
        while (id < 1) id += 250;
        while (id > 250) id -= 250;
        if (presetExists(id)) return id;
      }
      return 0;
    }

    // Work out what a command means without doing it (fast, so the ack goes out at once).
    // Works out what a command will do: a preset id, or a brightness (id < 0
    // means -brightness). Returns the ack status.
    uint8_t resolveCommand(const nl_cmd_t &cmd, int &id) {
      if (cmd.target != NL_TARGET_WLED) return NL_ACK_UNSUPPORTED;
      switch (cmd.op) {
        case NL_OP_BRIGHTNESS_SET:
          if (cmd.arg < 0 || cmd.arg > 255) return NL_ACK_BAD_ARG;
          id = -cmd.arg;
          return NL_ACK_OK;
        case NL_OP_BRIGHTNESS_STEP:
          id = -constrain((int)bri + cmd.arg, 1, 255);
          return NL_ACK_OK;
        case NL_OP_SLOT_LOOK:
        case NL_OP_SLOT_PALETTE: {
          const unsigned sl = nl_slot_arg_slot(cmd.arg), v = nl_slot_arg_value(cmd.arg);
          unsigned a0, a1, b0, b1;
          if (!slotArea(sl, a0, a1, b0, b1)) return NL_ACK_UNSUPPORTED;
          if (cmd.op == NL_OP_SLOT_LOOK && v) { refreshPresets(); if (!presetExists(v)) return NL_ACK_BAD_ARG; }
          String r = String(F("{\"id\":")) + sl;
          if (cmd.op == NL_OP_SLOT_PALETTE) r += String(F(",\"pal\":")) + v;
          else if (v) r += String(F(",\"look\":")) + v + F(",\"on\":true");
          else r += F(",\"on\":false");
          r += "}";
          if (!slotCommandUnderBump(sl, r)) {
            if (finSceneOn && (sl == 1 || sl == 3)) { if (finScenePendingCount < 4) finScenePending[finScenePendingCount++] = r; }
            else if (haveSaved) { if (pendingSlotCount < 4) pendingSlots[pendingSlotCount++] = r; }   // a preset bump would undo it
            else queueSlotString(r);
          }
          id = NO_ACTION;
          return NL_ACK_OK;
        }
        case NL_OP_FIN_FOLLOW:
          if (cmd.arg < 0 || cmd.arg > 2) return NL_ACK_BAD_ARG;
          setFinFollow(cmd.arg == 2 ? !finFollowOn : cmd.arg == 1);
          id = NO_ACTION;
          return NL_ACK_OK;
        default: break;
      }
      refreshPresets();
      cmdNoEyes = false;
      switch (cmd.op) {
        case NL_OP_PRESET_SET:  id = cmd.arg & 0xFF; cmdNoEyes = cmd.arg & NL_PRESET_NO_EYES; break;
        case NL_OP_PRESET_NEXT: id = stepPreset(bodyPreset, +1); break;
        case NL_OP_PRESET_PREV: id = stepPreset(bodyPreset, -1); break;
        default: return NL_ACK_UNSUPPORTED;
      }
      return presetExists(id) ? NL_ACK_OK : NL_ACK_BAD_ARG;
    }

    void applyCommand(int id) {
      if (id > 0 && isFinPreset(id)) {   // the fins: their own bump, else at once
        // Record it now: under a fin bump the same preset may already be on
        // screen, and re-applying it doesn't change currentPreset for trackPresets.
        finPreset = id - NL_FIN_PRESET_BASE;
        if (finBumpOn) finBumpRestore = id;
        else if (finSceneOn) finScenePreset = id;
        else queuePreset(id);
        return;
      }
      // A flash puts the master brightness back when it ends: a new brightness is for then.
      if (bodySlotBump.on && id < 0 && bodySlotBump.action == NL_BUMP_FLASH) { bumpBri = -id; return; }
      // During a bump the saved state comes back on release, which would undo
      // the command: keep it for then instead.
      if (haveSaved) {
        if (id > 0) { pendingPreset = id; pendingNoEyes = cmdNoEyes; }
        else pendingBri = -id;
        return;
      }
      if (id > 0) {
        queuePreset(id, cmdNoEyes);
        bodyPreset = id;   // also when it's already showing (see bumpEnd)
      } else {
        bri = -id;
        stateUpdated(CALL_MODE_DIRECT_CHANGE);
      }
    }

    bool saveState() {
      JSONBufferGuard guard(JSON_LOCK_NIBBLES);
      if (!guard) return false;
      pDoc->clear();
      JsonObject st = pDoc->to<JsonObject>();
      serializeState(st, true);
      savedState = "";
      serializeJson(*pDoc, savedState);
      return true;
    }

    bool applyJson(const String &json) {
      JSONBufferGuard guard(JSON_LOCK_NIBBLES);
      if (!guard) return false;
      pDoc->clear();
      if (deserializeJson(*pDoc, json)) return false;
      deserializeState(pDoc->as<JsonObject>(), CALL_MODE_DIRECT_CHANGE);
      return true;
    }

    // A scene bump's palette and layer look, on top of its preset (slotLoop
    // waits for the preset to land).
    void sceneSlots(const nl_bump_t &b, unsigned palSlot, unsigned overSlot, String queued[2]) {
      const uint8_t layer = nl_scene_arg_layer(b.arg);
      queued[0] = queued[1] = String();
      if (b.intensity)
        queued[0] = String(F("{\"id\":")) + palSlot + F(",\"pal\":") + (b.intensity - 1) + F(",\"tt\":0,\"bump\":true}");
      if (layer == NL_SCENE_LAYER_OFF)
        queued[1] = String(F("{\"id\":")) + overSlot + F(",\"on\":false,\"tt\":0,\"bump\":true}");
      else if (layer && presetExists(NL_LAYER_PRESET_BASE + layer))
        queued[1] = String(F("{\"id\":")) + overSlot + F(",\"look\":") + (NL_LAYER_PRESET_BASE + layer) + F(",\"on\":true,\"tt\":0,\"bump\":true}");
      for (int i = 0; i < 2; i++) if (queued[i].length()) queueSlotString(queued[i]);
    }

    // A scene that ends before its requests applied (a quick tap of TAKE,
    // its preset still on the way) mustn't apply them after the restore.
    void unqueueSlots(const String queued[2]) {
      for (int k = 0; k < 2; k++) {
        if (!queued[k].length()) continue;
        for (unsigned i = 0; i < slotQueueLen; i++) {
          if (slotQueue[i] != queued[k]) continue;
          for (unsigned j = i + 1; j < slotQueueLen; j++) slotQueue[j - 1] = slotQueue[j];
          slotQueue[--slotQueueLen] = String();
          break;
        }
      }
    }

    // TAKE's preview of the body's Standby: saved like a preset bump (the
    // overlay slot too: a state restore doesn't remove a segment it added).
    void sceneBegin(const nl_bump_t &b) {
      if (!strip.isMatrix) return;   // no slots without the 2D map
      flushSlotRestores();
      haveSaved = saveState();
      savedPreset = currentPreset;
      finAtBump = finPreset;
      sceneOn = true;
      memcpy(sceneLooks, slotLook, sizeof(sceneLooks));
      sceneOverRestore = captureSlot(2);
      bumpCount++;
      refreshPresets();
      const uint8_t ps = nl_scene_arg_preset(b.arg);
      if (ps && presetExists(ps)) queuePreset(ps, true, true);
      sceneSlots(b, 0, 2, sceneQueued);
    }

    // The fins' Standby: their preset (a slot look of the fin panel), palette
    // and overlay; both slots go back exactly on release.
    void finSceneBegin(const nl_bump_t &b) {
      if (!strip.isMatrix || !haveFinPanel) return;
      finSceneOn = true;
      finScenePreset = 0;
      finScenePendingCount = 0;
      finSceneRestore[0] = captureSlot(1);
      finSceneRestore[1] = captureSlot(3);
      bumpCount++;
      refreshPresets();
      const uint8_t ps = nl_scene_arg_preset(b.arg);
      if (ps && (isFinPreset(ps) || ps == NL_FIN_PRESET_BASE) && presetExists(ps)) queuePreset(ps);
      sceneSlots(b, 1, 3, finSceneQueued);
    }

    void finSceneEnd() {
      if (!finSceneOn) return;
      finSceneOn = false;
      unqueueSlots(finSceneQueued);
      if (finScenePreset) queuePreset(finScenePreset);   // LATCH: the new fin preset, not the old slot
      else queueSlotString(finSceneRestore[0]);
      queueSlotString(finSceneRestore[1]);
      for (unsigned i = 0; i < finScenePendingCount; i++) queueSlotString(finScenePending[i]);
      finScenePendingCount = 0;
      finScenePreset = 0;
    }

    void bumpBegin(const nl_bump_t &b) {
      if (b.action == NL_BUMP_SCENE) { sceneBegin(b); return; }
      if (b.action != NL_BUMP_PRESET) {   // flash, blackout, palette, layer: in a slot, nothing to save
        if (b.action == NL_BUMP_FLASH) bumpBri = bri;
        if (slotBumpStart(b, bodySlotBump)) { bumpCount++; return; }
        if (b.action == NL_BUMP_PALETTE || b.action == NL_BUMP_LAYER) return;   // no slots here (1D)
      }
      flushSlotRestores();   // the snapshot mustn't hold a slot bump that just ended
      haveSaved = saveState();
      savedPreset = currentPreset;
      finAtBump = finPreset;
      bumpCount++;
      if (b.action == NL_BUMP_PRESET) {
        refreshPresets();
        if (presetExists(b.arg)) queuePreset(b.arg, true, true);
        return;
      }
      // Instant change (tt = transition 0 for this call only), every segment.
      String json = "{\"tt\":0,";
      if (b.action == NL_BUMP_BLACKOUT) {
        json += "\"on\":false}";
      } else {  // NL_BUMP_FLASH
        json += "\"on\":true,\"bri\":" + String(b.intensity ? b.intensity : 255) + ",\"seg\":[";
        for (unsigned i = 0; i < strip.getSegmentsNum(); i++) {
          if (i) json += ",";
          json += "{\"id\":" + String(i) + ",\"fx\":0,\"col\":[[255,255,255]]}";
        }
        json += "]}";
      }
      applyJson(json);
    }

    void bumpEnd() {
      if (bodySlotBump.on) {
        slotBumpEnd(bodySlotBump);
        return;
      }
      if (sceneOn) unqueueSlots(sceneQueued);
      dropBumpPresets();   // a bump's preset that never got to apply mustn't after the restore
      if (!haveSaved) { sceneOn = false; return; }
      haveSaved = false;
      bool refin = finPreset != finAtBump;   // the fins changed preset during the bump
      if (pendingPreset) {
        refin = true;                // the body's new preset leaves the fin segment as the bump left it
        queuePreset(pendingPreset, pendingNoEyes);  // a preset command came in during the bump
        if (sceneOn) {               // re-applying the scene's own preset doesn't land as a change: reset the looks here
          slotLook[0] = pendingPreset;
          for (unsigned i = 2; i < SLOT_COUNT; i++) slotLook[i] = 0;
        }
        // Record it now: a preset bump may already show this preset (LATCH
        // while holding its number), and re-applying it doesn't change
        // currentPreset for trackPresets.
        bodyPreset = pendingPreset;
      } else {
        // Put everything back instantly.
        String json = savedState;
        if (json.startsWith("{")) json = "{\"tt\":0," + json.substring(1);
        applyJson(json);
        currentPreset = savedPreset;  // restoring the state clears it; it's the same look
        lastSeenPreset = currentPreset;
        if (presetWaiting && presetWaitingBump) {   // the bump's preset may still land over this
          lateRestore = json;
          lateRestorePreset = savedPreset;
        }
        if (sceneOn) {
          memcpy(slotLook, sceneLooks, sizeof(sceneLooks));
          queueSlotString(sceneOverRestore);
        }
      }
      sceneOn = false;
      // Put the fins' own preset back over the restored state (not under a fin bump: that restores itself).
      if (haveFinPanel && refin && !finBumpOn && !finSceneOn) queuePreset(finPreset ? NL_FIN_PRESET_BASE + finPreset : NL_FIN_PRESET_BASE);
      if (pendingBri >= 0) {
        bri = pendingBri;
        stateUpdated(CALL_MODE_DIRECT_CHANGE);
      }
      pendingPreset = 0;
      pendingBri = -1;
      for (unsigned i = 0; i < pendingSlotCount; i++) queueSlotString(pendingSlots[i]);   // slot commands during it
      pendingSlotCount = 0;
    }

    void bumpEvent(nl_bump_event_t ev) {
      if (ev == NL_BUMP_EV_BEGIN) bumpBegin(bumps.bump);
      else if (ev == NL_BUMP_EV_END) bumpEnd();
      else if (ev == NL_BUMP_EV_REPLACE) {
        bumpEnd();
        bumpBegin(bumps.bump);
      }
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
    void loop() override {
#ifdef NIBBLES_ES7210
      // After AudioReactive has started I2S (its MCLK clocks the chip).
      if (es7210State != 1 && millis() > 2000 && millis() - es7210TriedAt > 5000) {
        es7210TriedAt = millis();
        if (i2c_sda < 0 || i2c_scl < 0) Wire.begin(NIBBLES_ES7210_SDA, NIBBLES_ES7210_SCL);  // WLED has no I2C pins set
        es7210State = es7210Setup() ? 1 : -1;
      }
#endif
      if (!copyRead) { readCopyRanges(); readFinGeo(); copyRead = true; }
      // (Re)build when the map changes; WLED loads it after we first run, so
      // also retry every 5 s while nothing pairs up.
      if ((copyRangeCount || finFollowCount) && (strip.getLengthTotal() != copyBuiltFor || currentLedmap != copyBuiltMap ||
                             strip.isMatrix != copyBuiltMatrix || (!copyPairCount && millis() - copyBuiltAt > 5000)))
        buildCopyPairs();
      streamLoop();  // also without the radio, for the Info page
      wireLoop();    // likewise
      mirrorLoop();  // on request only, and independent of the radio (works with the usermod disabled)
      powerLoop(millis());  // also without the radio, so it can be tried with test readings
      presetQueueLoop(millis());
      trackPresets(millis());
      if (!display) slotLoop();
      netLoop(millis());
      if (!display) hopLoop(millis());
      for (;;) {
        if (!radioUp()) break;
        RxItem it;
        bool got = false;
        portENTER_CRITICAL(&rxLock);
        if (rxTail != rxHead) {
          it = rx[rxTail];
          rxTail = (rxTail + 1) % RX_QUEUE;
          got = true;
        }
        portEXIT_CRITICAL(&rxLock);
        if (!got) break;
        handle(it);
      }
      if (display) {   // listening only (battery readings, in handle()); just the stream reports out
        abLoop();      // with the radio off too: the wires and the return wire carry it all
        retAudio(millis());
        if (!radioUp()) return;
        apDefaultRoute();
        if (millis() - lastStream >= 1000) {
          lastStream = millis();
          sendStream();
        }
        return;
      }
      if (!radioUp()) return;
      bumpEvent(nl_bump_rx_tick(&bumps, millis()));  // a lost STOP still releases
      finBumpEvent(nl_bump_rx_tick(&finBumps, millis()));
      eyeSendLoop(millis());
      previewLoop(millis());
      const unsigned long now = millis();
      if (now - lastHeartbeat >= ANCHOR_HEARTBEAT_MS) {
        lastHeartbeat = now;
        sendHeartbeat();
      }
      // The real time, for the base's logs, once a phone has told us (the /time page).
      if (now - lastTime >= NL_TIME_MS) {
        lastTime = now;
        const uint32_t t = toki.second();
        if (toki.getTimeSource() >= TOKI_TS_SEC && nl_time_valid(t)) {
          const nl_time_t m = { t };
          send(ESPNOW_BROADCAST_ADDRESS, NL_MSG_TIME, &m, sizeof(m));
        }
      }
      if (now - lastTelemetry >= TELEMETRY_MS) {
        lastTelemetry = now;
        sendTelemetry();
        sendFinState();
        sendLayers();
      }
      if (now - lastStream >= 1000) {
        lastStream = now;
        sendStream();
      }
      if (audio && !abStandby() && now - lastAudio >= AUDIO_MS) {
        lastAudio = now;
        sendAudio();
      }
#ifdef NIBBLES_DEBUG
      if (now - lastDebug >= 5000) {
        lastDebug = now;
        Serial.printf("nibbles: ch %d%s, rx %lu, cmds %lu, preset %d, fps %u | eyes %s preset %d/%d %s %.1f/%.1f fps\n",
                      WiFi.channel(), anchor ? " anchor" : "", (unsigned long)rxCount, (unsigned long)cmdCount,
                      currentPreset, strip.getFps(), haveEyes && now - eyesAt < 2000 ? "heard" : "NOT heard",
                      eyes.preset, eyes.preset_count, eyes.linked ? "linked" : "unlinked",
                      eyes.fps_x10[0] / 10.0f, eyes.fps_x10[1] / 10.0f);
      }
#endif
    }

    // Called by WLED after the frame is put together, before it goes to the LEDs.
    void handleOverlayDraw() override {
      frameShown = true;  // for the wire link
      if (!strip.isMatrix) return;
      finPanelOn = panelSegmentOn();
      gatherFinColors();
      if (copyPairs)
        for (unsigned i = 0; i < copyPairCount; i++)
          strip.setPixelColor(copyPairs[i * 2], strip.getPixelColor(copyPairs[i * 2 + 1]));
      writeFinColors();  // fins following their angle override the partner copies
    }

    bool onEspNowMessage(uint8_t *sender, uint8_t *payload, uint8_t len) override {
      if (!enabled || len < sizeof(nl_radio_hdr_t) || payload[0] != NL_RADIO_MAGIC0 || payload[1] != NL_RADIO_MAGIC1)
        return false;  // not ours: let WLED handle it (e.g. WiZ remotes)
      portENTER_CRITICAL(&rxLock);
      const uint8_t next = (rxHead + 1) % RX_QUEUE;
      if (next != rxTail && len <= NL_RADIO_MAX) {
        memcpy(rx[rxHead].mac, sender, 6);
        rx[rxHead].len = len;
        memcpy(rx[rxHead].data, payload, len);
        rxHead = next;
      }
      portEXIT_CRITICAL(&rxLock);
      return true;
    }

    void addToJsonInfo(JsonObject &root) override {
      JsonObject user = root["u"];
      if (user.isNull()) user = root.createNestedObject("u");
      if (eyeNote[0]) user.createNestedArray(F("Nibbles eye settings")).add(eyeNote);
      JsonArray radio = user.createNestedArray(F("Nibbles radio"));
      if (!radioUp()) {
        radio.add(F("off"));
      } else if (display) {
        char buf[80];
        snprintf(buf, sizeof(buf), "display: ch %d, battery readings only (rx %lu)", WiFi.channel(), (unsigned long)rxCount);
        radio.add(buf);
      } else {
        char buf[80];
        snprintf(buf, sizeof(buf), "ch %d%s, rx %lu, cmds %lu, bumps %lu, audio %s", WiFi.channel(),
                 anchor ? " (anchor)" : "", (unsigned long)rxCount, (unsigned long)cmdCount, (unsigned long)bumpCount,
                 !audio ? "off" : audioSent ? "sending" : "no AudioReactive");
        radio.add(buf);
      }
      {
        nl_wled_stream_t st;
        streamSummary(st);
        if (st.active || st.stalls_total || streamGaps.last_ms) {
          JsonArray sa = user.createNestedArray(F("Nibbles stream"));
          char buf[128];
          int n = st.active ? snprintf(buf, sizeof(buf), "from %u.%u.%u.%u; ", st.source_ip[0], st.source_ip[1], st.source_ip[2], st.source_ip[3])
                            : snprintf(buf, sizeof(buf), "not streaming; ");
          snprintf(buf + n, sizeof(buf) - n, "last minute: %u stalls (>= %d ms), %u slow (>= %d ms), longest %u ms; %lu stalls since boot",
                   st.stalls, NL_STREAM_STALL_MS, st.slow, NL_STREAM_SLOW_MS, st.max_gap_ms, (unsigned long)st.stalls_total);
          sa.add(buf);
        }
      }
      wireInfo(user);
      if (previewOn) {
        char buf[64];
        snprintf(buf, sizeof(buf), "sending at %u fps: %lu frames", previewFps, (unsigned long)previewFrames);
        user.createNestedArray(F("Nibbles preview")).add(buf);
      }
#ifdef NIBBLES_ES7210
      {
        JsonArray mic = user.createNestedArray(F("Nibbles mic (ES7210)"));
        int gain = es7210State == 1 ? es7210Read(0x43) : -1;
        if (es7210State == 1 && gain >= 0) {
          char buf[48];
          snprintf(buf, sizeof(buf), "set up, mics 1+2, %d dB", (gain & 0x0f) * 3);
          mic.add(buf);
        } else mic.add(es7210State == 0 ? F("starting") : F("no answer on I2C"));
      }
#endif
      {
        JsonArray fa = user.createNestedArray(F("Nibbles fins"));
        char buf[96];
        int n = 0;
        static const char *names[2] = { "port", "starboard" };
        for (int f = 0; f < 2; f++) {
          if (!finFollowOn) { if (!f) n += snprintf(buf + n, sizeof(buf) - n, "following off (fins locked at the modelled angle)"); }
          else if (finSweeping(f, millis())) n += snprintf(buf + n, sizeof(buf) - n, "%s%s sweeping (%.1f s)", f ? "; " : "", names[f], finSweepPeriod[f]);
          else if (!finsAt[f] || millis() - finsAt[f] > 2000) n += snprintf(buf + n, sizeof(buf) - n, "%s%s not heard", f ? "; " : "", names[f]);
          else if (fins.angle_cdeg[f] == NL_FIN_NONE) n += snprintf(buf + n, sizeof(buf) - n, "%s%s raw %u (uncalibrated)", f ? "; " : "", names[f], fins.raw[f]);
          else n += snprintf(buf + n, sizeof(buf) - n, "%s%s %+.1f deg", f ? "; " : "", names[f], fins.angle_cdeg[f] / 100.0f);
        }
        fa.add(buf);
      }
      {
        JsonArray pw = user.createNestedArray(F("Nibbles power"));
        char buf[80];
        if (!powerEnabled) snprintf(buf, sizeof(buf), "off");
        else if (BusManager::ablMilliampsMax() == 0) snprintf(buf, sizeof(buf), "WLED's current limiter is off");
        else if (!power.heard) snprintf(buf, sizeof(buf), "no battery readings; limit %u mA", (unsigned)BusManager::ablMilliampsMax());
        else snprintf(buf, sizeof(buf), "pack %.2f V; limit %u of %u mA (%lu readings)", power.pack_mv / 1000.0f,
                      (unsigned)BusManager::ablMilliampsMax(), (unsigned)powerModel.max_ma, (unsigned long)batteryRx);
        pw.add(buf);
      }
      if (strip.isMatrix && (copyRangeCount || finFollowCount)) {
        JsonArray m2 = user.createNestedArray(F("Nibbles 2D map"));
        char buf[96];
        snprintf(buf, sizeof(buf), "%u partner LEDs copied; fins following their angle: %s%s%s", copyPairCount,
                 !finFollowCount ? "no fin geometry" : finFollowing ? "" : "none",
                 finFollowing & 1 ? (finFollow[0].side == NL_FIN_PORT ? "port " : "starboard ") : "",
                 finFollowing & 2 ? (finFollow[1].side == NL_FIN_PORT ? "port" : "starboard") : "");
        m2.add(buf);
      }
      if (strip.isMatrix && !display) {
        JsonArray la = user.createNestedArray(F("Nibbles layers"));
        char buf[160];
        int n = 0;
        for (unsigned i = 0; i < SLOT_COUNT && n < (int)sizeof(buf) - 24; i++) {
          unsigned a, b, c, d;
          if (!slotArea(i, a, b, c, d)) continue;
          const bool on = i < strip.getSegmentsNum() && strip.getSegment(i).isActive() && strip.getSegment(i).on;
          if (on) n += snprintf(buf + n, sizeof(buf) - n, "%s%s fx %u bm %u", n ? "; " : "", slotDefs[i].name, strip.getSegment(i).mode, strip.getSegment(i).blendMode);
          else n += snprintf(buf + n, sizeof(buf) - n, "%s%s off", n ? "; " : "", slotDefs[i].name);
        }
        la.add(buf);
        if (slotNote[0]) la.add(slotNote);
      }
      if (mirroring(millis())) {
        JsonArray m = user.createNestedArray(F("Nibbles mirror"));
        char buf[48];
        snprintf(buf, sizeof(buf), "to %s:%u, %lu frames", mirrorIp.toString().c_str(), mirrorPort, (unsigned long)mirrorFrames);
        m.add(buf);
      }
      JsonArray e = user.createNestedArray(F("Nibbles eyes"));
      if (!haveEyes || millis() - eyesAt > 2000) {
        e.add(F("not heard"));
      } else {
        char buf[80];
        snprintf(buf, sizeof(buf), "preset %d/%d, %s, %.1f/%.1f fps, %.0f bpm", eyes.preset, eyes.preset_count,
                 eyes.linked ? "linked" : "not linked", eyes.fps_x10[0] / 10.0f, eyes.fps_x10[1] / 10.0f, eyes.tempo_bpm);
        e.add(buf);
      }
    }

    // The slots, in the state: {"nibbles":{"slots":[{"id":2,"name":"body+","on":true,"fx":17,"pal":0,"bm":10,"o":255,"look":7}, ...]}}
    void addToJsonState(JsonObject &root) override {
      if (display || !strip.isMatrix) return;
      JsonObject nb = root[F("nibbles")];
      if (nb.isNull()) nb = root.createNestedObject(F("nibbles"));
      JsonArray arr = nb.createNestedArray(F("slots"));
      for (unsigned i = 0; i < SLOT_COUNT; i++) {
        unsigned a, b, c, d;
        if (!slotArea(i, a, b, c, d)) continue;
        JsonObject o = arr.createNestedObject();
        o[F("id")] = i;
        o[F("name")] = slotDefs[i].name;
        const bool exists = i < strip.getSegmentsNum() && strip.getSegment(i).isActive();
        o[F("on")] = exists && strip.getSegment(i).on;
        if (!exists) continue;
        const Segment &sg = strip.getSegment(i);
        o[F("fx")] = sg.mode; o[F("pal")] = sg.palette; o[F("bm")] = sg.blendMode; o[F("o")] = sg.opacity;
        o[F("frz")] = sg.freeze;
        if (slotLook[i]) o[F("look")] = slotLook[i];
      }
    }

    // {"nibbles":{"mirror":{"ip":"a.b.c.d","port":4050,"s":5}}}: stream to the
    // simulator for s seconds (0 stops).
    void readFromJsonState(JsonObject &root) override {
      // {"nibbles":{"slot":{...}}} or a list of them: segment layer slots (see the header)
      JsonVariant sl = root[F("nibbles")][F("slot")];
      if (sl.is<JsonArray>()) { for (JsonVariant v : sl.as<JsonArray>()) queueSlot(v); }
      else if (!sl.isNull()) queueSlot(sl);
      // {"nibbles":{"battery":{"mv":13000,"ma":7700}}}: a test reading, as if
      // from the base ("mv":0 forgets: back to the ceiling).
      // {"nibbles":{"finfollow":true|false}}: fin LEDs follow the fins, or stay put
      if (!root[F("nibbles")][F("finfollow")].isNull()) setFinFollow(root[F("nibbles")][F("finfollow")].as<bool>());
      // {"nibbles":{"finproj":"side"|"top"}}: how the fin panel is laid over the fins (stored in fin presets)
      const char *proj = root[F("nibbles")][F("finproj")] | (const char *)nullptr;
      if (proj) finProj = !strcmp(proj, "top") ? NL_FIN_PROJ_TOP : NL_FIN_PROJ_SIDE;
      readEyeSettings(root[F("nibbles")][F("eyes")]);
      // {"nibbles":{"abtake":ms}}, {"nibbles":{"abhold":true|false}}: the A/B switch, on the display (tests)
      if (!root[F("nibbles")][F("abtake")].isNull()) abTake(root[F("nibbles")][F("abtake")].as<int>());
      if (!root[F("nibbles")][F("abhold")].isNull() && abOn) { nl_ab_hold(&ab, root[F("nibbles")][F("abhold")].as<bool>(), millis()); abDirty = true; }
      // {"nibbles":{"ctlwifi":true|false}}: on a brain, tell the controller (down our wire) to join the
      // network until it restarts, or to switch its radio off again; on the controller, directly.
      if (!root[F("nibbles")][F("ctlwifi")].isNull()) {
        const bool on = root[F("nibbles")][F("ctlwifi")].as<bool>();
        if (display) ctlWifi(on);
        else sendCtlWifi(on);
      }
      // {"nibbles":{"preview":true|false}}: the preview stream, until the next reboot
      if (!root[F("nibbles")][F("preview")].isNull()) previewOn = root[F("nibbles")][F("preview")].as<bool>();
      // {"nibbles":{"finsweep":{"port":4,"starboard":0,"s":6}}}: sweep test
      JsonObject sw = root[F("nibbles")][F("finsweep")];
      if (!sw.isNull()) {
        const float p0 = sw[F("port")] | 0.0f, p1 = sw[F("starboard")] | 0.0f;
        const int secs = sw[F("s")] | 6;
        if (!finSweeping(0, millis()) && !finSweeping(1, millis())) finSweepStart = millis();  // a fresh sweep starts level
        finSweepPeriod[0] = p0 > 0.2f ? p0 : 0;
        finSweepPeriod[1] = p1 > 0.2f ? p1 : 0;
        finSweepUntil = millis() + (unsigned long)min(max(secs, 0), 30) * 1000UL;
      }
      JsonObject bat = root[F("nibbles")][F("battery")];
      if (!bat.isNull()) {
        nl_battery_t b = {};
        b.pack_mv = bat[F("mv")] | 0;
        if (!bat[F("ma")].isNull()) { b.current_ma = bat[F("ma")] | 0; b.flags = NL_BATT_CURRENT; }
        batteryReading(b);
      }
      JsonObject m = root[F("nibbles")][F("mirror")];
      if (m.isNull()) return;
      IPAddress ip;
      const int secs = m[F("s")] | 0;
      const int port = m[F("port")] | 0;
      if (secs <= 0 || port <= 0 || port > 65534 || !ip.fromString((const char *)(m[F("ip")] | ""))) {
        mirrorPort = 0;
        return;
      }
      mirrorIp = ip;
      mirrorPort = port;
      mirrorUntil = millis() + min(secs, MIRROR_MAX_S) * 1000UL;
    }

    void addToConfig(JsonObject &root) override {
      JsonObject top = root.createNestedObject(FPSTR(_name));
      top[F("enabled")] = enabled;
      top[F("anchor")] = anchor;
      top[F("display")] = display;                 // the display of a main board / display pair
      top[F("audio")] = audio;
      top[F("power")] = powerEnabled;            // battery-aware current limit
      top[F("power_max_ma")] = powerModel.max_ma;  // its ceiling (replaces WLED's own limit field)
      top[F("power_min_ma")] = powerModel.min_ma;
      top[F("floor_mv")] = powerModel.floor_mv;    // lowest input the 5 V converter may see
      top[F("pack_mohm")] = powerModel.pack_mohm;  // pack, BMS, fuse
      top[F("wire_mohm")] = powerModel.wire_mohm;  // pole wiring, there and back
      top[F("conv_eff")] = powerModel.efficiency_pct;
      top[F("fin_follow")] = finFollowOn;          // fin LEDs follow the fins' angle
      top[F("wire_pin")] = wirePin;                // wire link: TX on the brain, RX on the display; -1 = off
      top[F("wire_baud")] = wireBaud;
      top[F("radio_off")] = radioOff;              // on the display: commands and battery only through the brains' wires
      top[F("wire_pin_b")] = wirePinB;             // on the display: the second brain's wire; -1 = one brain
      top[F("ab_side")] = abSide;                  // on a brain: 0 Right Brain, 1 Left Brain; -1 = no A/B
      top[F("ret_pin")] = retPin;
      top[F("wifi_off")] = wifiOff;                // on the display: radio off; NL_OP_CTL_WIFI joins the network until restart
      top[F("net_fallback")] = netFallback;        // on a brain that joins the network: host it while the host is gone                  // return wire: TX on the display (A/B state, sound), RX on a brain; -1 = off
      top[F("preview")] = previewOn;               // preview stream for a preview screen
      top[F("preview_fps")] = previewFps;
    }

    bool readFromConfig(JsonObject &root) override {
      JsonObject top = root[FPSTR(_name)];
      bool complete = !top.isNull();
      complete &= getJsonValue(top[F("enabled")], enabled, true);
      complete &= getJsonValue(top[F("anchor")], anchor, true);
      complete &= getJsonValue(top[F("display")], display, false);
      complete &= getJsonValue(top[F("audio")], audio, false);
      const nl_power_model_t def = NL_POWER_MODEL_DEFAULT;
      complete &= getJsonValue(top[F("power")], powerEnabled, true);
      complete &= getJsonValue(top[F("power_max_ma")], powerModel.max_ma, def.max_ma);
      complete &= getJsonValue(top[F("power_min_ma")], powerModel.min_ma, def.min_ma);
      complete &= getJsonValue(top[F("floor_mv")], powerModel.floor_mv, def.floor_mv);
      complete &= getJsonValue(top[F("pack_mohm")], powerModel.pack_mohm, def.pack_mohm);
      complete &= getJsonValue(top[F("wire_mohm")], powerModel.wire_mohm, def.wire_mohm);
      complete &= getJsonValue(top[F("conv_eff")], powerModel.efficiency_pct, def.efficiency_pct);
      complete &= getJsonValue(top[F("fin_follow")], finFollowOn, true);
      complete &= getJsonValue(top[F("wire_pin")], wirePin, (int8_t)-1);
      complete &= getJsonValue(top[F("wire_baud")], wireBaud, (uint32_t)NL_PIX_BAUD);
      complete &= getJsonValue(top[F("radio_off")], radioOff, false);
      complete &= getJsonValue(top[F("wire_pin_b")], wirePinB, (int8_t)-1);
      complete &= getJsonValue(top[F("ab_side")], abSide, (int8_t)-1);
      complete &= getJsonValue(top[F("ret_pin")], retPin, (int8_t)-1);
      complete &= getJsonValue(top[F("wifi_off")], wifiOff, false);
      complete &= getJsonValue(top[F("net_fallback")], netFallback, false);
      if (wireBaud < 9600 || wireBaud > 5000000) wireBaud = NL_PIX_BAUD;
      wireRecheck = true;
      complete &= getJsonValue(top[F("preview")], previewOn, false);
      complete &= getJsonValue(top[F("preview_fps")], previewFps, (uint8_t)12);
      nl_power_limiter_init(&power, &powerModel);  // new settings: start over (readings arrive several times a second)
      powerApplied = 0;
      return complete;
    }

    uint16_t getId() override { return USERMOD_ID_UNSPECIFIED; }
};

const char NibblesUsermod::_name[] PROGMEM = "Nibbles";
const NibblesUsermod::SlotDef NibblesUsermod::slotDefs[NibblesUsermod::SLOT_COUNT] = {
  { NibblesUsermod::AREA_BODY, 0, "body" },    // top
  { NibblesUsermod::AREA_FINS, 0, "fins" },    // top (fin presets)
  { NibblesUsermod::AREA_BODY, 10, "body+" },  // screen
  { NibblesUsermod::AREA_FINS, 10, "fins+" },  // screen
  { NibblesUsermod::AREA_ALL, 2, "bump" },     // add (flash and blackout bumps set top)
};

static NibblesUsermod nibbles_usermod;
REGISTER_USERMOD(nibbles_usermod);
