snowyfox/Nibbles/firmware/base/main/main.c

// Nibbles base station: reads the power board (power.c) and the keypads
// (keypad.c), runs Live / Standby from the keys (controls.c), shows it all on
// its screen, sends preset commands and bumps to the eyes and WLED (and from
// USB serial), tells WLED the pack voltage, and anchors the ESP-NOW channel
// when there is no WLED usermod.
#include <stdlib.h>
#include <string.h>
#include "config.h"
#include "controls.h"
#include "display.h"
#include "driver/gpio.h"
#include "driver/usb_serial_jtag.h"
#include "driver/usb_serial_jtag_vfs.h"
#include "esp_log.h"
#include "esp_timer.h"
#include "freertos/FreeRTOS.h"
#include "freertos/queue.h"
#include "freertos/semphr.h"
#include "freertos/task.h"
#include "keypad.h"
#include "logger.h"
#include "mirror_link.h"
#include "ota.h"
#include "rtc.h"
#include "nibbles_espnow.h"
#include "nvs_flash.h"
#include "power.h"
#include "power_math.h"

static const char *TAG = "base";

static portMUX_TYPE lock = portMUX_INITIALIZER_UNLOCKED;
static uint8_t eyes_mac[6];
static bool have_eyes;
static nl_eye_telemetry_t eyes;
static int64_t eyes_us;
static uint8_t wled_mac[6];
static bool have_wled;
static nl_wled_telemetry_t wled;
static int64_t wled_us;
static nl_wled_stream_t wled_stream;
static int64_t wled_stream_us;
static nl_fin_state_t fin_state;
static nl_wled_layers_t wled_layers;   // WLED's layer slots (NL_MSG_WLED_LAYERS)
static int64_t wled_layers_us;
static bool have_fins;
static int64_t fins_us;

static volatile uint32_t heard_time;

// Two brains: the controller's A/B switch, and the brain that's Standby just now.
static nl_ab_state_t ab_state;
static uint8_t ab_mac[6];
static int64_t ab_us;
static nl_wled_telemetry_t stby_wled;
static uint8_t stby_mac[6];
static int64_t stby_wled_us;
static nl_fin_state_t stby_fin;
static int64_t stby_fin_us;
static nl_wled_layers_t stby_layers;
static int64_t stby_layers_us;
static volatile int64_t stby_sync_after;   // not until the roles have settled after a swap
static volatile bool ab_in_use;            // both brains up: Standby runs on the other one

static void on_packet(const uint8_t mac[6], const nl_radio_hdr_t *h, const uint8_t *pl, size_t len)
{
    if (h->type == NL_MSG_AB && len == sizeof(nl_ab_state_t)) {
        nl_ab_state_t st;
        memcpy(&st, pl, sizeof(st));
        taskENTER_CRITICAL(&lock);
        if (ab_us && st.live != ab_state.live) {   // what we heard from Standby is out of date
            stby_wled_us = stby_fin_us = stby_layers_us = 0;
            stby_sync_after = esp_timer_get_time() + 2000000;
        }
        ab_state = st;
        memcpy(ab_mac, mac, 6);
        ab_us = esp_timer_get_time();
        taskEXIT_CRITICAL(&lock);
        return;
    }
    if (h->role == NL_ROLE_WLED_STANDBY) {
        const int64_t t = esp_timer_get_time();
        taskENTER_CRITICAL(&lock);
        if (h->type == NL_MSG_WLED_TELEMETRY && len == sizeof(stby_wled)) {
            memcpy(&stby_wled, pl, len);
            memcpy(stby_mac, mac, 6);
            stby_wled_us = t;
        } else if (h->type == NL_MSG_FIN_STATE && len == sizeof(stby_fin)) {
            memcpy(&stby_fin, pl, len);
            stby_fin_us = t;
        } else if (h->type == NL_MSG_WLED_LAYERS && len == sizeof(stby_layers)) {
            memcpy(&stby_layers, pl, len);
            stby_layers_us = t;
        }
        taskEXIT_CRITICAL(&lock);
        if (h->type != NL_MSG_PREVIEW && h->type != NL_MSG_TIME) return;
    }
    if (h->type == NL_MSG_PREVIEW) {   // about 60 packets a second from each brain: straight to the screen
        display_preview(h->role == NL_ROLE_WLED_STANDBY, pl, len);
        return;
    }
    if (h->type == NL_MSG_TIME && len == sizeof(nl_time_t)) {
        nl_time_t t;
        memcpy(&t, pl, sizeof(t));
        if (nl_time_valid(t.unix_time)) heard_time = t.unix_time;   // the main loop sets the clock
        return;
    }
    if (h->type == NL_MSG_EYE_TELEMETRY && len == sizeof(nl_eye_telemetry_t) && h->role == NL_ROLE_EYE_LEADER) {
        taskENTER_CRITICAL(&lock);
        memcpy(&eyes, pl, sizeof(eyes));
        memcpy(eyes_mac, mac, 6);
        have_eyes = true;
        eyes_us = esp_timer_get_time();
        taskEXIT_CRITICAL(&lock);
    } else if (h->type == NL_MSG_WLED_TELEMETRY && len == sizeof(nl_wled_telemetry_t) && h->role == NL_ROLE_WLED) {
        taskENTER_CRITICAL(&lock);
        memcpy(&wled, pl, sizeof(wled));
        memcpy(wled_mac, mac, 6);
        have_wled = true;
        wled_us = esp_timer_get_time();
        taskEXIT_CRITICAL(&lock);
    } else if (h->type == NL_MSG_WLED_STREAM && len == sizeof(nl_wled_stream_t) && h->role == NL_ROLE_WLED) {
        taskENTER_CRITICAL(&lock);
        memcpy(&wled_stream, pl, sizeof(wled_stream));
        wled_stream_us = esp_timer_get_time();
        taskEXIT_CRITICAL(&lock);
    } else if (h->type == NL_MSG_EYE_LOOK && len == sizeof(nl_eye_look_t) && h->role == NL_ROLE_WLED) {
        nl_eye_look_t look;
        memcpy(&look, pl, sizeof(look));
        display_eye_look(&look);
    } else if (h->type == NL_MSG_WLED_LAYERS && len == sizeof(nl_wled_layers_t) && h->role == NL_ROLE_WLED) {
        taskENTER_CRITICAL(&lock);
        memcpy(&wled_layers, pl, sizeof(wled_layers));
        wled_layers_us = esp_timer_get_time();
        taskEXIT_CRITICAL(&lock);
    } else if (h->type == NL_MSG_FIN_STATE && len == sizeof(nl_fin_state_t) && h->role == NL_ROLE_WLED) {
        taskENTER_CRITICAL(&lock);
        memcpy(&fin_state, pl, sizeof(fin_state));
        have_fins = true;
        fins_us = esp_timer_get_time();
        taskEXIT_CRITICAL(&lock);
    }
}

// True if it was answered.
static bool send_cmd_mac(const char *who, bool known, const uint8_t mac[6], nl_target_t target, nl_op_t op, int arg)
{
    if (!known) {
        ESP_LOGW(TAG, "%s not heard yet; command not sent", who);
        display_event("%s not heard yet", who);
        return false;
    }
    nl_cmd_t cmd = { .target = target, .op = op, .arg = (int16_t)arg };
    uint8_t status = 0xFF;
    const int64_t t0 = esp_timer_get_time();
    const esp_err_t err = nl_espnow_command(mac, &cmd, &status, CMD_TRIES, CMD_TIMEOUT_MS);
    const float ms = (esp_timer_get_time() - t0) / 1000.0f;
    static const char *ops[] = { "?", "set preset", "next preset", "previous preset", "set brightness", "step brightness",
                                 "auto presets", "reactivity", "fin following", "set layer", "set palette" };
    const char *what = op == NL_OP_AB_TAKE || op == NL_OP_AB_TAKE_A || op == NL_OP_AB_TAKE_B ? "take" : op == NL_OP_CTL_WIFI ? "controller wifi" : op <= NL_OP_SLOT_PALETTE ? ops[op] : "?";
    static const char *statuses[] = { "ok", "unsupported", "bad preset", "busy" };
    const char *st = status < 4 ? statuses[status] : "?";
    if (err == ESP_OK) {
        ESP_LOGI(TAG, "%s %s %d: acked in %.1f ms (status %d)", who, what, arg, ms, status);
        display_event("%s %s: %s, %.1f ms", who, what, st, ms);
        return status == NL_ACK_OK;
    }
    ESP_LOGW(TAG, "%s %s: no ack after %d tries", who, what, CMD_TRIES);
    display_event("%s %s: no answer", who, what);
    return false;
}

static void send_cmd_to(nl_target_t target, nl_op_t op, int arg)
{
    uint8_t mac[6];
    taskENTER_CRITICAL(&lock);
    const bool known = target == NL_TARGET_WLED ? have_wled : have_eyes;
    memcpy(mac, target == NL_TARGET_WLED ? wled_mac : eyes_mac, 6);
    taskEXIT_CRITICAL(&lock);
    send_cmd_mac(target == NL_TARGET_WLED ? "wled" : "eyes", known, mac, target, op, arg);
}

// To the brain that's Standby just now.
static void send_cmd_standby(nl_op_t op, int arg)
{
    uint8_t mac[6];
    taskENTER_CRITICAL(&lock);
    const bool known = stby_wled_us != 0;
    memcpy(mac, stby_mac, 6);
    taskEXIT_CRITICAL(&lock);
    send_cmd_mac("standby", known, mac, NL_TARGET_WLED, op, arg);
}

static void send_wled(bool standby, nl_op_t op, int arg)
{
    if (standby) send_cmd_standby(op, arg);
    else send_cmd_to(NL_TARGET_WLED, op, arg);
}

// Both brains: the same brightness and fin following, whichever is on the LEDs.
static void send_wled_both(nl_op_t op, int arg)
{
    send_cmd_to(NL_TARGET_WLED, op, arg);
    if (ab_in_use) send_cmd_standby(op, arg);
}

// Through a brain, which passes it down its wire: the Live one, or Standby if that doesn't
// answer, or the controller's own radio. "Make that brain Live", so a second route can't undo it.
static void ab_cmd(nl_op_t op, int arg, bool take)
{
    uint8_t live[6], stby[6], ctrl[6];
    taskENTER_CRITICAL(&lock);
    const bool known = ab_us != 0;
    const bool have_live = have_wled, have_stby = stby_wled_us != 0;
    if (take) op = ab_state.live ? NL_OP_AB_TAKE_A : NL_OP_AB_TAKE_B;
    memcpy(live, wled_mac, 6);
    memcpy(stby, stby_mac, 6);
    memcpy(ctrl, ab_mac, 6);
    if (take) stby_sync_after = esp_timer_get_time() + 2000000;
    taskEXIT_CRITICAL(&lock);
    if (!known) {
        ESP_LOGW(TAG, "controller not heard yet; command not sent");
        display_event("controller not heard yet");
        return;
    }
    if (have_live && send_cmd_mac("live brain", true, live, NL_TARGET_AB, op, arg)) return;
    if (have_stby && send_cmd_mac("standby brain", true, stby, NL_TARGET_AB, op, arg)) return;
    send_cmd_mac("controller", true, ctrl, NL_TARGET_AB, op, arg);
}

static void ab_take(int fade_ms) { ab_cmd(NL_OP_AB_TAKE, fade_ms, true); }

static void send_preset(nl_op_t op) { send_cmd_to(NL_TARGET_EYES, op, 0); }
static void send_preset_index(int index) { send_cmd_to(NL_TARGET_EYES, NL_OP_PRESET_SET, index); }

// ------------------------------------------------------------------ bumps
// Bumps are broadcast: START, HOLD every NL_BUMP_KEEPALIVE_MS while held,
// STOP. One slot per receiver (the eyes and WLED each filter on their own
// target bit), so the two can show different things at once, as TAKE's
// preview does. Keys, pads, the bump button and serial all use the slots.
enum { SLOT_EYES = 0, SLOT_WLED = 1, SLOT_FINS = 2, SLOT_AB = 3, SLOTS };
typedef struct {
    nl_bump_t b;
    bool on;
    int64_t next_hold;
} bump_slot_t;
static bump_slot_t slots[SLOTS];
static const uint8_t slot_target[SLOTS] = { NL_TARGET_EYES, NL_TARGET_WLED, NL_TARGET_FINS, NL_TARGET_AB };
static uint16_t bump_id;
static SemaphoreHandle_t bump_mutex;

// intensity: 255 (full) for flashes; a scene bump's palette + 1.
static void slot_start(int i, uint8_t action, int arg, uint8_t intensity)
{
    xSemaphoreTake(bump_mutex, portMAX_DELAY);
    slots[i].b = (nl_bump_t){ .id = ++bump_id, .target = slot_target[i],
                              .action = action, .phase = NL_BUMP_START, .intensity = intensity, .arg = (int16_t)arg };
    slots[i].on = true;
    slots[i].next_hold = esp_timer_get_time() + NL_BUMP_KEEPALIVE_MS * 1000LL;
    nl_espnow_broadcast(NL_MSG_BUMP, &slots[i].b, sizeof(nl_bump_t));
    xSemaphoreGive(bump_mutex);
}

static void slot_stop(int i)
{
    xSemaphoreTake(bump_mutex, portMAX_DELAY);
    if (slots[i].on) {
        slots[i].b.phase = NL_BUMP_STOP;
        slots[i].on = false;
        nl_espnow_broadcast(NL_MSG_BUMP, &slots[i].b, sizeof(nl_bump_t));
    }
    xSemaphoreGive(bump_mutex);
}

// target: NL_TARGET_* mask
static void bump_start(uint8_t target, uint8_t action, int arg)
{
    if (target & NL_TARGET_EYES) slot_start(SLOT_EYES, action, arg, 255);
    if (target & NL_TARGET_WLED) slot_start(SLOT_WLED, action, arg, 255);
}

static void bump_stop(uint8_t target)
{
    if (target & NL_TARGET_EYES) slot_stop(SLOT_EYES);
    if (target & NL_TARGET_WLED) slot_stop(SLOT_WLED);
}

static void bump_keepalive(void)
{
    const int64_t now = esp_timer_get_time();
    xSemaphoreTake(bump_mutex, portMAX_DELAY);
    for (int i = 0; i < SLOTS; i++) {
        if (!slots[i].on || now < slots[i].next_hold) continue;
        slots[i].b.phase = NL_BUMP_HOLD;
        slots[i].next_hold = now + NL_BUMP_KEEPALIVE_MS * 1000LL;
        nl_espnow_broadcast(NL_MSG_BUMP, &slots[i].b, sizeof(nl_bump_t));
    }
    xSemaphoreGive(bump_mutex);
}

static uint8_t bump_showing(void)  // for the screen
{
    return slots[SLOT_WLED].on ? slots[SLOT_WLED].b.action : slots[SLOT_EYES].on ? slots[SLOT_EYES].b.action : 0;
}

// ------------------------------------------------------------------ actions
// Touch taps, keypad actions and so on go to the actions task, in order:
// commands wait for their acks, which the display and keypad tasks mustn't.
static QueueHandle_t actions;
static volatile bool pad_flash, pad_black;
static volatile int pad_preset;  // preset being held from the grid (1-based), 0 = none

typedef struct {
    int kind;                     // display_action_t, or ACTION_CTL
    int value;
    ctl_action_t ctl;
} action_t;
#define ACTION_CTL 100

// The keypad's state; keys arrive from the keypad task, touch and serial.
static ctl_t ctl;
static SemaphoreHandle_t ctl_mutex;

static void run_ctl_actions(const ctl_action_t *a, int n)
{
    for (int i = 0; i < n; i++) {
        const action_t act = { ACTION_CTL, 0, a[i] };
        if (xQueueSend(actions, &act, pdMS_TO_TICKS(50)) != pdTRUE) ESP_LOGW(TAG, "actions queue full");
    }
}

static uint32_t now_ms(void) { return (uint32_t)(esp_timer_get_time() / 1000); }

// PAGE held 5 s while the keys are locked turns the Wi-Fi update on or off
// (locked, PAGE does nothing else). Set when it goes down; -1 once used.
static volatile int64_t page_locked_since;
#define WIFI_KEY_HOLD_US 5000000

// The palette viewer follows the keys: on while the numbers are palettes.
// Call with ctl_mutex held.
static void palettes_show(const ctl_t *c)
{
    uint32_t held = 0;
    for (int n = 1; n <= CTL_NUMBERS; n++) {
        const ctl_key_t k = n <= 8 ? (ctl_key_t)(KEY_NUM1 + n - 1) : (ctl_key_t)(KEY_NUM9 + n - 9);
        if (c->down[k]) held |= 1u << (n - 1);
    }
    display_palettes(!c->locked && ctl_mode(c) == PAGE_PALETTES, c->pal_first, held);
}

static void on_key(ctl_key_t key, bool down)
{
    ctl_action_t a[CTL_MAX_ACTIONS];
    if (key == KEY_FIN_SENSOR) display_fin_key(down);
    xSemaphoreTake(ctl_mutex, portMAX_DELAY);
    if (key == KEY_PAGE) page_locked_since = down && ctl.locked ? esp_timer_get_time() : 0;
    const int n = ctl_key(&ctl, key, down, now_ms(), a);
    palettes_show(&ctl);
    xSemaphoreGive(ctl_mutex);
    ESP_LOGI(TAG, "key %s %s", ctl_key_name(key), down ? "down" : "up");
    run_ctl_actions(a, n);
}

static void on_touch(display_action_t a, bool pressed, int value)
{
    const action_t act = { a, value, { 0 } };
    if (a == DISPLAY_PAD_FLASH) pad_flash = pressed;
    else if (a == DISPLAY_PAD_BLACKOUT) pad_black = pressed;
    else if (a == DISPLAY_HOLD_PRESET) {
        if (pressed) pad_preset = value;
        else if (pad_preset == value) pad_preset = 0;
    } else if (a == DISPLAY_KEY) {
        if (value == KEY_NONE) {   // the target box: step to the next target on release
            if (!pressed) {
                static const ctl_key_t order[] = { KEY_ALL, KEY_BODY, KEY_EYES, KEY_FINS };
                const ctl_key_t k = order[(ctl.target + 1) % 4];
                on_key(k, true);
                on_key(k, false);
            }
        } else {
            on_key((ctl_key_t)value, pressed);
        }
    }
    else if (pressed || a == DISPLAY_SLIDE_EYES || a == DISPLAY_SLIDE_WLED) xQueueSend(actions, &act, 0);
}

// Preset N (1-based) on both: WLED preset id N, eye preset index N - 1.
static void send_preset_both(int n)
{
    send_cmd_to(NL_TARGET_WLED, NL_OP_PRESET_SET, n);
    send_cmd_to(NL_TARGET_EYES, NL_OP_PRESET_SET, n - 1);
}

// Toggle the pole's power; it only goes off with a USB-C supply on the LEMO.
static void pole_power(void)
{
    power_status_t p;
    power_get(&p);
    if (power_set_pole(!p.pole_off)) display_event("pole power %s", p.pole_off ? "on" : "off");
    else display_event("pole stays on: no USB-C supply");
}

// WLED's slots as the keypad's logic sees them (-1: that slot is off).
static void layers_from(const nl_wled_layers_t *wl, ctl_layers_t *out)
{
    out->body_pal = wl->slot[NL_SLOT_BODY].on ? wl->slot[NL_SLOT_BODY].palette : -1;
    out->fins_pal = wl->slot[NL_SLOT_FINS].on ? wl->slot[NL_SLOT_FINS].palette : -1;
    out->body_layer = wl->slot[NL_SLOT_BODY_OVER].on ? wl->slot[NL_SLOT_BODY_OVER].look : 0;
    out->fins_layer = wl->slot[NL_SLOT_FINS_OVER].on ? wl->slot[NL_SLOT_FINS_OVER].look : 0;
}

static void do_ctl_action(const ctl_action_t *a)
{
    switch (a->type) {
        case ACT_PRESET:
            // BODY: the WLED preset without its eye settings; ALL lets them through
            if (a->target == TGT_BODY) send_wled(a->standby, NL_OP_PRESET_SET, a->value | (a->bump ? 0 : NL_PRESET_NO_EYES));
            else if (a->target == TGT_FINS) send_wled(a->standby, NL_OP_PRESET_SET, NL_FIN_PRESET_BASE + a->value);
            else send_cmd_to(NL_TARGET_EYES, NL_OP_PRESET_SET, a->value - 1);
            break;
        case ACT_FINS:       send_wled_both(NL_OP_FIN_FOLLOW, a->value); break;
        // Fin presets are WLED presets NL_FIN_PRESET_BASE + n (the base itself: follow the body).
        case ACT_BRIGHTNESS: send_wled_both(NL_OP_BRIGHTNESS_SET, a->value); break;
        case ACT_SLOT_LOOK:    send_wled(a->standby, NL_OP_SLOT_LOOK, nl_slot_arg(a->target, (uint8_t)a->value)); break;
        case ACT_SLOT_PALETTE: send_wled(a->standby, NL_OP_SLOT_PALETTE, nl_slot_arg(a->target, (uint8_t)a->value)); break;
        case ACT_AB_HOLD:
            if (a->value) slot_start(SLOT_AB, NL_BUMP_AB, 0, 255);
            else slot_stop(SLOT_AB);
            break;
        case ACT_AB_TAKE:    ab_take(TAKE_FADE_MS); break;
        case ACT_BRIGHTNESS_STANDBY: send_cmd_standby(NL_OP_BRIGHTNESS_SET, a->value); break;
        case ACT_BUMP:
            if (a->target == TGT_FINS && a->bump == NL_BUMP_PRESET) slot_start(SLOT_FINS, a->bump, NL_FIN_PRESET_BASE + a->value, 255);
            else if (a->bump == NL_BUMP_SCENE) slot_start(a->target == TGT_FINS ? SLOT_FINS : SLOT_WLED, a->bump, a->value, a->extra);
            else if (a->target == TGT_FINS) slot_start(SLOT_FINS, a->bump, a->value, 255);   // palette, layer: a slot arg
            else slot_start(a->target == TGT_EYES ? SLOT_EYES : SLOT_WLED, a->bump, a->value, 255);
            break;
        case ACT_BUMP_END:   slot_stop(a->target == TGT_EYES ? SLOT_EYES : a->target == TGT_FINS ? SLOT_FINS : SLOT_WLED); break;
        case ACT_POLE_POWER: pole_power(); break;
    }
}

static void survey_start(void);
static void radio_move(int ch);

static void actions_task(void *arg)
{
    action_t a;
    for (;;) {
        if (xQueueReceive(actions, &a, portMAX_DELAY) != pdTRUE) continue;
        switch (a.kind) {
            case ACTION_CTL:         do_ctl_action(&a.ctl); break;
            case DISPLAY_TAP_EYES:   send_cmd_to(NL_TARGET_EYES, NL_OP_PRESET_NEXT, 0); break;
            case DISPLAY_TAP_WLED:   send_cmd_to(NL_TARGET_WLED, NL_OP_PRESET_NEXT, 0); break;
            // The eyes are always at 100% (their slider is locked): nothing to send.
            case DISPLAY_SLIDE_EYES: break;
            case DISPLAY_SLIDE_WLED: send_cmd_to(NL_TARGET_WLED, NL_OP_BRIGHTNESS_SET, a.value); break;
            case DISPLAY_TAP_PRESET: send_preset_both(a.value); break;
            case DISPLAY_SET_AUTO:   send_cmd_to(NL_TARGET_EYES, NL_OP_AUTO_CYCLE, a.value); break;
            case DISPLAY_SET_REACT:  send_cmd_to(NL_TARGET_EYES, NL_OP_REACTIVITY, a.value); break;
            case DISPLAY_SET_FINS:   send_cmd_to(NL_TARGET_WLED, NL_OP_FIN_FOLLOW, a.value); break;
            case DISPLAY_SURVEY:     survey_start(); break;
            case DISPLAY_MOVE_CHANNEL: radio_move(a.value); break;
            case DISPLAY_HOLD_EYES: {
                taskENTER_CRITICAL(&lock);
                const bool on = eyes.flags & NL_EYE_AUTO_CYCLE;
                taskEXIT_CRITICAL(&lock);
                send_cmd_to(NL_TARGET_EYES, NL_OP_AUTO_CYCLE, !on);
                break;
            }
            default: break;
        }
    }
}

// Hold a bump for ms (used by the serial "bump" command, on its own task so
// the console can take commands while a bump is held).
typedef struct {
    uint8_t target, action;
    int arg, ms;
} timed_bump_t;
static QueueHandle_t timed_bumps;

static void bump_for(uint8_t target, uint8_t action, int arg, int ms)
{
    const timed_bump_t b = { target, action, arg, ms };
    if (xQueueSend(timed_bumps, &b, 0) != pdTRUE) ESP_LOGW(TAG, "a bump is already being held");
}

static void timed_bump_task(void *arg)
{
    timed_bump_t b;
    for (;;) {
        if (xQueueReceive(timed_bumps, &b, portMAX_DELAY) != pdTRUE) continue;
        bump_start(b.target, b.action, b.arg);
        vTaskDelay(pdMS_TO_TICKS(b.ms));
        bump_stop(b.target);
        ESP_LOGI(TAG, "bump %d held %d ms", b.action, b.ms);
        display_event("bump %d held %d ms", b.action, b.ms);
    }
}

// The board's own keys and the touch pads; also sends every bump's keepalives.
static void buttons_task(void *arg)
{
    // With the mirror cable on, GPIO 0 (BOOT) is its output, not a key.
    const bool next_key = !(mirror_link_enabled() && BTN_NEXT_GPIO == MIRROR_MAIN_TX_GPIO);
    const gpio_config_t io = {
        .pin_bit_mask = (next_key ? 1ULL << BTN_NEXT_GPIO : 0) | (1ULL << BTN_BUMP_GPIO),
        .mode = GPIO_MODE_INPUT,
        .pull_up_en = GPIO_PULLUP_ENABLE,
    };
    gpio_config(&io);
    int prev_next = 1;
    uint8_t held = 0, held_target = 0;  // bump this task started
    int held_arg = 0;
    for (;;) {
        vTaskDelay(pdMS_TO_TICKS(10));
        const int n = next_key ? gpio_get_level(BTN_NEXT_GPIO) : 1;
        if (n == 0 && prev_next == 1) {
            const action_t a = { DISPLAY_TAP_EYES, 0, { 0 } };
            xQueueSend(actions, &a, 0);
        }
        prev_next = n;
        // The bump key and the FLASH pad flash; the BLACKOUT pad wins over both;
        // a held preset-grid button bumps its preset on the eyes and WLED.
        const int preset = pad_preset;
        const uint8_t want = pad_black ? NL_BUMP_BLACKOUT
                           : (gpio_get_level(BTN_BUMP_GPIO) == 0 || pad_flash) ? NL_BUMP_FLASH
                           : preset ? NL_BUMP_PRESET : 0;
        const int want_arg = want == NL_BUMP_PRESET ? preset : 0;
        if (want != held || want_arg != held_arg) {
            if (held) bump_stop(held_target);
            held_target = want == NL_BUMP_PRESET ? (NL_TARGET_EYES | NL_TARGET_WLED) : BTN_BUMP_TARGET;
            if (want) bump_start(held_target, want, want_arg);
            held = want;
            held_arg = want_arg;
        }
        bump_keepalive();
    }
}

// ------------------------------------------------------------------ console
// Serial commands over USB, for testing without pressing buttons:
// "next" / "prev" / "set N" (eye presets), "wled next" / "wled set N",
// "bri N" / "wled bri N" (brightness 0..255; "+N" / "-N" steps),
// "[eyes|wled] bump flash|black|preset N ms" (hold a bump for ms; without a
// prefix it goes to both; preset numbers are 1-based on both),
// "wled slot look S N" / "wled slot pal S N" (WLED layer slot S: layer preset N, 0 off; palette N),
// "preset N" (preset N on both, as a grid tap), "page N" (0 main, 1 Live and Standby, 2 grid, 3 details),
// "key NAME [down|up]" (a keypad key; tapped without down/up), "keys" (list),
// "leds on|off" (print the key LED colours when they change),
// "lights on|off", "pole on|off" (off only on a USB-C supply), "power" (log the power board).
static void console_key(const char *args)
{
    char name[16] = "";
    char how[8] = "";
    sscanf(args, "%15s %7s", name, how);
    const ctl_key_t k = ctl_key_by_name(name);
    if (k == KEY_NONE) {
        ESP_LOGW(TAG, "no key '%s' (try: keys)", name);
        return;
    }
    if (!strcmp(how, "down")) on_key(k, true);
    else if (!strcmp(how, "up")) on_key(k, false);
    else {
        on_key(k, true);
        vTaskDelay(pdMS_TO_TICKS(60));
        on_key(k, false);
    }
}

static void log_power(void)
{
    power_status_t p;
    power_get(&p);
    ESP_LOGI(TAG, "power: charger %s%s, monitor %s, expander %s, %s; pack %d mV %d%% (%d mA), dock %d mV %d mA, "
             "%s; lights %d mV %d mA %d mW, eFuse %s%s; cells %d.%d C, die %d.%d C; faults %02x %02x, TS %x",
             p.have_charger ? "yes" : "no", p.have_charger && !p.charger_ok ? " (NOT SET UP)" : "",
             p.have_monitor ? "yes" : "no", p.have_expander ? "yes" : "no", p.docked ? "docked" : "not docked",
             p.pack_mv, p.pack_pct, p.ibat_ma, p.vbus_mv, p.ibus_ma, bq_charge_state_name((chg_state_t)p.chg_state),
             p.light_mv, p.light_ma, p.light_mw, p.efuse_pg ? "ok" : "off", p.lights_off ? ", LIGHTS OFF" : "",
             p.cell_c10 / 10, abs(p.cell_c10 % 10), p.die_c10 / 10, abs(p.die_c10 % 10), p.fault0, p.fault1, p.ts_flags);
}

// "leds on": print the key LED colours whenever they change, as one line,
// "LEDS rrggbb,rrggbb,..." in ctl_key_t order from KEY_NUM1, so the simulator
// can light its keys like the real ones while it drives this base.
static volatile bool leds_echo;

// Site survey (the survey page, or "survey" over USB): on its own task, as
// it keeps the radio for several seconds.
static TaskHandle_t survey_task_handle;

static void survey_task(void *arg)
{
    static nl_survey_t sv;
    for (;;) {
        ulTaskNotifyTake(pdTRUE, portMAX_DELAY);
        display_survey(NULL, true);
        display_event("Surveying the channels...");
        const int64_t t0 = esp_timer_get_time();
        const esp_err_t err = nl_espnow_survey(&sv, SURVEY_DWELL_MS);
        if (err != ESP_OK) {
            display_survey(NULL, false);
            display_event("Survey failed (%s)", esp_err_to_name(err));
            continue;
        }
        nl_survey_score(&sv, BASE_MAX_CHANNEL);
        display_survey(&sv, false);
        ESP_LOGI(TAG, "survey (%d ms off the network), on channel %d:", (int)((esp_timer_get_time() - t0) / 1000), sv.current);
        for (int c = NL_CHANNEL_MIN; c <= NL_CHANNEL_MAX; c++) {
            const nl_survey_chan_t *ch = &sv.ch[c];
            ESP_LOGI(TAG, "  ch %2d: load %4u | %3u APs, strongest %4d dBm | %4u frames/s, %3u.%u%% airtime%s%s", c, ch->load,
                     ch->aps, ch->aps ? ch->strongest : 0, ch->frames, ch->busy_pml / 10, ch->busy_pml % 10,
                     c == sv.current ? " <- now" : "", c == sv.best && sv.worth_moving ? " <- best" : "");
        }
        if (sv.worth_moving) display_event("Survey: ch %d is better (%u vs %u)", sv.best, sv.ch[sv.best].load, sv.ch[sv.current].load);
        else display_event("Survey: ch %d is as good as any", sv.current);
    }
}

static void survey_start(void)
{
    if (!survey_task_handle) xTaskCreate(survey_task, "survey", 4096, NULL, 3, &survey_task_handle);
    if (survey_task_handle) xTaskNotifyGive(survey_task_handle);
}

// Move the whole network (brains, eyes, preview, us) to another channel.
static void radio_move(int ch)
{
    const esp_err_t err = nl_espnow_move((uint8_t)ch, MOVE_DELAY_MS);
    if (err == ESP_OK) display_event("Moving everyone to channel %d", ch);
    else display_event("Can't move to %d: %s", ch, err == ESP_ERR_INVALID_STATE ? "no brain heard, or already there" : esp_err_to_name(err));
    ESP_LOGI(TAG, "radio move %d: %s", ch, esp_err_to_name(err));
}

// Screenshots print from their own task (~20 KB to 300 KB of text), so the
// console keeps reading keys meanwhile. Notified with 1 (raw) or 2 (rle).
static TaskHandle_t shot_task_handle;

static void shot_task(void *arg)
{
    for (;;) display_screenshot(ulTaskNotifyTake(pdTRUE, portMAX_DELAY) == 2);
}

static void console_reply(void *ctx, const char *line) { printf("%s\n", line); }

static void console_task(void *arg)
{
    usb_serial_jtag_driver_config_t cfg = USB_SERIAL_JTAG_DRIVER_CONFIG_DEFAULT();
    cfg.rx_buffer_size = 4096;   // whole "ota data" lines (about 1 KB) without dropping bytes
    if (usb_serial_jtag_driver_install(&cfg) != ESP_OK) vTaskDelete(NULL);
    usb_serial_jtag_vfs_use_driver();
    static char line[OTA_LINE_MAX + 64];   // "ota data" lines are about 1 KB
    size_t n = 0;
    for (;;) {
        uint8_t c;
        if (usb_serial_jtag_read_bytes(&c, 1, portMAX_DELAY) != 1) continue;
        if (c != '\n' && c != '\r') {
            if (n < sizeof(line) - 1) line[n++] = (char)c;
            continue;
        }
        line[n] = 0;
        n = 0;
        if (!strcmp(line, "ota wifi on") || !strcmp(line, "ota wifi off")) {
            if (!mirror_is_mirror()) ota_wifi_set(line[10] == 'n');
            continue;
        }
        if (ota_command(line, console_reply, NULL)) continue;
        if (!strcmp(line, "role mirror") || !strcmp(line, "role base")) {
            const bool m = line[5] == 'm';
            printf("ROLE %s%s\n", m ? "mirror" : "base", mirror_set_role(m) ? ", restarting" : ": could not save");
            vTaskDelay(pdMS_TO_TICKS(200));
            esp_restart();
        }
        if (!strcmp(line, "mirror")) {
            char text[96];
            mirror_link_text(text, sizeof(text));
            printf("MIRROR %s; build here %s\n", text, ota_build_id());
            continue;
        }
        if (mirror_is_mirror()) {   // the mirror board has none of the base's jobs
            if (!strcmp(line, "shot") || !strcmp(line, "shot rle")) {
                if (!shot_task_handle) xTaskCreate(shot_task, "shot", 4096, NULL, 2, &shot_task_handle);
                if (shot_task_handle) xTaskNotify(shot_task_handle, line[4] ? 2 : 1, eSetValueWithOverwrite);
            } else if (line[0]) printf("mirror board commands: ota ..., mirror, shot, role base|mirror\n");
            continue;
        }
        if (!strcmp(line, "mirror push")) { mirror_link_push(); printf("MIRROR sending at the next hello\n"); continue; }
        if (!strcmp(line, "mirror link on") || !strcmp(line, "mirror link off")) {
            const bool on = line[13] == 'n';
            printf("MIRROR link %s%s\n", on ? "on" : "off", mirror_link_enable(on) ? ", from the next restart" : ": could not save");
            continue;
        }
        if (!strncmp(line, "wifi set ", 9)) {   // "wifi set SSID PASSWORD" (the SSID has no spaces; the password is the rest)
            char ssid[33] = "";
            const char *pass = line + 9;
            const char *sp = strchr(pass, ' ');
            const size_t sl = sp ? (size_t)(sp - pass) : strlen(pass);
            if (sl && sl < sizeof(ssid)) { memcpy(ssid, pass, sl); pass = sp ? sp + 1 : ""; }
            printf("WIFI %s\n", ssid[0] && ota_wifi_save(ssid, pass) ? "saved" : "not saved (wifi set SSID PASSWORD)");
            continue;
        }
        if (!strcmp(line, "next")) send_preset(NL_OP_PRESET_NEXT);
        else if (!strcmp(line, "prev")) send_preset(NL_OP_PRESET_PREV);
        else if (!strncmp(line, "set ", 4)) send_preset_index(atoi(line + 4));
        else if (!strcmp(line, "shot") || !strcmp(line, "shot rle")) {
            if (!shot_task_handle) xTaskCreate(shot_task, "shot", 4096, NULL, 2, &shot_task_handle);
            if (shot_task_handle) xTaskNotify(shot_task_handle, line[4] ? 2 : 1, eSetValueWithOverwrite);
        }
        else if (!strncmp(line, "page ", 5)) display_show_page(atoi(line + 5));
        else if (!strcmp(line, "survey")) survey_start();
        else if (!strncmp(line, "radio move ", 11)) radio_move(atoi(line + 11));
        else if (!strncmp(line, "key ", 4)) console_key(line + 4);
        else if (!strcmp(line, "keys")) {
            for (int k = 1; k < KEY_COUNT; k++) printf("%s ", ctl_key_name((ctl_key_t)k));
            printf("\n");
        }
        else if (!strcmp(line, "lights on") || !strcmp(line, "lights off")) power_set_lights(line[8] == 'n');
        else if (!strcmp(line, "log")) {
            logger_status_t l;
            logger_get(&l);
            printf("LOG %s, %s, file L%05d, %lu rows, %lu dropped, slowest write %lu ms, card %lu MB, %lu MB free\n", l.enabled ? "on" : "off",
                   l.mounted ? "card ok" : "no card", l.file_number, (unsigned long)l.rows, (unsigned long)l.dropped,
                   (unsigned long)l.max_write_ms, (unsigned long)l.card_mb, (unsigned long)l.free_mb);
        }
        else if (!strcmp(line, "log list")) logger_print_list();
        else if (!strncmp(line, "log get ", 8)) logger_print_file(atoi(line + 8));
        else if (!strcmp(line, "ab")) {
            taskENTER_CRITICAL(&lock);
            const nl_ab_state_t st = ab_state;
            const int64_t age = ab_us ? esp_timer_get_time() - ab_us : -1;
            const int64_t stby_age = stby_wled_us ? esp_timer_get_time() - stby_wled_us : -1;
            taskEXIT_CRITICAL(&lock);
            if (age < 0 || age > 3000000) printf("AB controller not heard\n");
            else printf("AB %s Live, %s on the LEDs, right %s %d fps, left %s %d fps, %d takes, %d failovers, standby brain %s, %s\n",
                        st.live ? "left" : "right", st.showing ? "left" : "right",
                        st.flags & NL_AB_A_UP ? "up" : "down", st.fps[0], st.flags & NL_AB_B_UP ? "up" : "down", st.fps[1], st.takes, st.failovers,
                        stby_age >= 0 && stby_age < 2000000 ? "heard" : "not heard", ab_in_use ? "in use" : "not in use");
        }
        else if (!strcmp(line, "ab hold on")) slot_start(SLOT_AB, NL_BUMP_AB, 0, 255);
        else if (!strcmp(line, "ab hold off")) slot_stop(SLOT_AB);
        else if (!strncmp(line, "ab take", 7)) {   // as TAKE + LATCH, so Standby keeps Live as it was
            ctl_action_t acts[CTL_MAX_ACTIONS];
            xSemaphoreTake(ctl_mutex, portMAX_DELAY);
            const int n = ctl_ab_take(&ctl, acts);
            xSemaphoreGive(ctl_mutex);
            if (!n) ab_take(atoi(line + 7));
            for (int i = 0; i < n; i++) {
                if (acts[i].type == ACT_AB_TAKE) ab_take(atoi(line + 7));
                else run_ctl_actions(&acts[i], 1);
            }
        }
        // The controller joins the Nibbles network (web page, OTA) until it restarts; computer only, no key
        else if (!strcmp(line, "wled wifi on")) ab_cmd(NL_OP_CTL_WIFI, 1, false);
        else if (!strcmp(line, "wled wifi off")) ab_cmd(NL_OP_CTL_WIFI, 0, false);
        else if (!strcmp(line, "eyepic off")) display_eye_test(-1, 0);
        else if (!strncmp(line, "eyepic ", 7)) {
            int preset = 0, state = 0;
            sscanf(line + 7, "%d %d", &preset, &state);
            display_eye_test(preset, state);
        }
        else if (!strcmp(line, "time")) printf("TIME %lu%s\n", (unsigned long)rtc_now(), rtc_chip_found() ? "" : " no clock chip");
        else if (!strcmp(line, "time forget")) rtc_forget();
        else if (!strncmp(line, "time ", 5)) printf("TIME %s %lu\n", rtc_set(strtoul(line + 5, NULL, 10)) ? "set" : "failed", (unsigned long)rtc_now());
        else if (!strcmp(line, "log on") || !strcmp(line, "log off")) logger_enable(line[5] == 'n');
        else if (!strcmp(line, "log tail")) logger_print_tail(8);
        else if (!strcmp(line, "pole on") || !strcmp(line, "pole off")) {
            if (!power_set_pole(line[6] == 'f')) ESP_LOGW(TAG, "pole stays on: no USB-C supply");
        }
        else if (!strcmp(line, "power")) log_power();
        else if (!strcmp(line, "leds on") || !strcmp(line, "leds off")) leds_echo = line[6] == 'n';
        else if (!strncmp(line, "react ", 6))
            send_cmd_to(NL_TARGET_EYES, NL_OP_REACTIVITY,
                        !strcmp(line + 6, "beats") ? NL_REACT_BEATS : !strcmp(line + 6, "peaks") ? NL_REACT_PEAKS : NL_REACT_PRESET);
        else if (!strncmp(line, "preset ", 7)) send_preset_both(atoi(line + 7));
        else if (!strcmp(line, "fins on") || !strcmp(line, "fins off") || !strcmp(line, "fins toggle"))
            send_cmd_to(NL_TARGET_WLED, NL_OP_FIN_FOLLOW, line[6] == 'n' ? 1 : line[6] == 'f' ? 0 : 2);
        else if (!strcmp(line, "auto on") || !strcmp(line, "auto off")) send_cmd_to(NL_TARGET_EYES, NL_OP_AUTO_CYCLE, line[6] == 'n');
        else if (!strncmp(line, "bri ", 4))  // the eyes follow WLED's brightness: same as "wled bri"
            send_cmd_to(NL_TARGET_WLED, line[4] == '+' || line[4] == '-' ? NL_OP_BRIGHTNESS_STEP : NL_OP_BRIGHTNESS_SET, atoi(line + 4));
        else if (!strncmp(line, "wled bri ", 9)) send_cmd_to(NL_TARGET_WLED, line[9] == '+' || line[9] == '-' ? NL_OP_BRIGHTNESS_STEP : NL_OP_BRIGHTNESS_SET, atoi(line + 9));
        else if (!strcmp(line, "wled next")) send_cmd_to(NL_TARGET_WLED, NL_OP_PRESET_NEXT, 0);
        else if (!strncmp(line, "wled set ", 9)) send_cmd_to(NL_TARGET_WLED, NL_OP_PRESET_SET, atoi(line + 9));
        else if (!strncmp(line, "wled slot look ", 15) || !strncmp(line, "wled slot pal ", 14)) {   // "wled slot look S N", "wled slot pal S N"
            const bool look = line[10] == 'l';
            int sl = 0, v = 0;
            if (sscanf(line + (look ? 15 : 14), "%d %d", &sl, &v) == 2)
                send_cmd_to(NL_TARGET_WLED, look ? NL_OP_SLOT_LOOK : NL_OP_SLOT_PALETTE, nl_slot_arg((uint8_t)sl, (uint8_t)v));
        }
        else if (strstr(line, "bump ")) {
            const char *b = strstr(line, "bump ") + 5;
            uint8_t target = !strncmp(line, "eyes ", 5) ? NL_TARGET_EYES
                           : !strncmp(line, "wled ", 5) ? NL_TARGET_WLED : NL_TARGET_EYES | NL_TARGET_WLED;
            int preset = 0, ms = 0;
            if (!strncmp(b, "flash ", 6)) bump_for(target, NL_BUMP_FLASH, 0, atoi(b + 6));
            else if (!strncmp(b, "black ", 6)) bump_for(target, NL_BUMP_BLACKOUT, 0, atoi(b + 6));
            else if (!strncmp(b, "preset ", 7) && sscanf(b + 7, "%d %d", &preset, &ms) == 2) {
                bump_for(target, NL_BUMP_PRESET, preset, ms);
            }
        } else if (line[0]) ESP_LOGW(TAG, "commands: survey, radio move N, next, prev, set N, wled next, wled set N, [wled] bri N|+N|-N, auto on|off, react preset|beats|peaks, preset N, fins on|off|toggle, page N, shot, [eyes|wled] bump flash|black MS, [eyes|wled] bump preset N MS, wled slot look|pal S N, key NAME [down|up], keys, leds on|off, lights on|off, power");
    }
}

static const char *state_name(uint8_t s)
{
    static const char *names[] = { "awake", "drowsy", "asleep", "waking" };
    return s < 4 ? names[s] : "?";
}

// Preset names as they turn up in telemetry, for showing what Standby holds.
static char wled_names[256][NL_NAME_LEN];
static char eye_names[64][NL_NAME_LEN];

static void name_of(char out[NL_NAME_LEN], char cache[][NL_NAME_LEN], int count, int preset)
{
    out[0] = 0;
    if (preset > 0 && preset < count) memcpy(out, cache[preset], NL_NAME_LEN);
    out[NL_NAME_LEN - 1] = 0;
}

// The mirror board: the screen and the cable to the main board, nothing else
// (no radio, power board, keypads or logger).
static void mirror_touch(display_action_t a, bool pressed, int value) {}

static void mirror_main(void)
{
    ESP_LOGI(TAG, "role: mirror (\"role base\" over USB to change)");
    if (display_start(mirror_touch) != ESP_OK) ESP_LOGE(TAG, "no display");
    mirror_link_side_start();
    xTaskCreate(console_task, "console", 4096, NULL, 4, NULL);
    char shown[64] = "", text[64];
    for (;;) {
        const display_status_t ds = { 0 };
        display_update(&ds);
        ota_progress_text(text, sizeof(text));
        if (!text[0]) snprintf(text, sizeof(text), "MIRROR %s, main %s", ota_build_id(), mirror_main_heard() ? "heard" : "not heard");
        if (strcmp(text, shown)) {
            display_event("%s", text);
            memcpy(shown, text, sizeof(shown));
        }
        vTaskDelay(pdMS_TO_TICKS(250));
    }
}

void app_main(void)
{
    esp_err_t err = nvs_flash_init();
    if (err == ESP_ERR_NVS_NO_FREE_PAGES || err == ESP_ERR_NVS_NEW_VERSION_FOUND) {
        nvs_flash_erase();
        nvs_flash_init();
    }
    ota_start();
    if (mirror_is_mirror()) {
        mirror_main();
        return;
    }
    const nl_espnow_config_t cfg = {
        .role = NL_ROLE_BASE,
        .side = NL_SIDE_NONE,
        .fw = BASE_FW_BUILD,
        .anchor = BASE_IS_ANCHOR,
        .anchor_channel = BASE_ANCHOR_CHANNEL,
        .anchor_fallback_ms = BASE_ANCHOR_FALLBACK_MS,
        .handler = on_packet,
        .core = 0,
    };
    bump_mutex = xSemaphoreCreateMutex();
    ctl_mutex = xSemaphoreCreateMutex();
    ctl_init(&ctl, KEYPAD_AUTOLOCK_MS);
    actions = xQueueCreate(16, sizeof(action_t));
    timed_bumps = xQueueCreate(1, sizeof(timed_bump_t));
    if (display_start(on_touch) != ESP_OK) ESP_LOGE(TAG, "no display; carrying on without it");
    ota_wifi_init();   // the Wi-Fi netif before the radio starts Wi-Fi
    ESP_ERROR_CHECK(nl_espnow_start(&cfg));
    if (power_start() != ESP_OK) ESP_LOGE(TAG, "no power board bus");
    rtc_start();
    if (logger_start() != ESP_OK) ESP_LOGE(TAG, "no logger");
    if (keypad_start(on_key) != ESP_OK) ESP_LOGE(TAG, "no keypad task");
    xTaskCreate(buttons_task, "buttons", 4096, NULL, 4, NULL);
    xTaskCreate(actions_task, "actions", 4096, NULL, 4, NULL);
    xTaskCreate(timed_bump_task, "timed_bump", 3072, NULL, 4, NULL);
    xTaskCreate(console_task, "console", 4096, NULL, 4, NULL);
    mirror_link_main_start();

    int64_t next_battery = 0;
    char update_shown[100] = "";
    for (int n = 0;; n++) {
        vTaskDelay(pdMS_TO_TICKS(50));
        const int64_t now = esp_timer_get_time();
        taskENTER_CRITICAL(&lock);
        const bool fresh = have_eyes && now - eyes_us < 2000000;
        const nl_eye_telemetry_t e = eyes;
        const nl_wled_telemetry_t w = wled;
        const bool wfresh = have_wled && now - wled_us < 2000000;
        const nl_wled_stream_t ws = wled_stream;
        const bool sfresh = wled_stream_us && now - wled_stream_us < 3000000 && ws.active;
        const nl_fin_state_t fs = fin_state;
        const bool ffresh = have_fins && now - fins_us < 2000000;
        const nl_wled_layers_t wl = wled_layers;
        const bool lfresh = wled_layers_us && now - wled_layers_us < 2000000 && wl.count >= NL_SLOT_COUNT;
        taskEXIT_CRITICAL(&lock);
        // The layers' palettes and looks, for the keys' LEDs and the screen (-1: not known)
        ctl_layers_t layers = { -1, -1, -1, -1 };
        if (lfresh) layers_from(&wl, &layers);

        // What the shark shows, for Live; remember the names that come with it.
        const ctl_scene_t live = { .body = wfresh ? w.preset : 0, .eyes = fresh ? e.preset + 1 : 0,
                                   .fins = ffresh ? fs.fin_preset : -1 };
        if (wfresh && w.preset && w.name[0]) memcpy(wled_names[w.preset], w.name, NL_NAME_LEN);
        if (fresh && e.preset + 1 < 64 && e.name[0]) memcpy(eye_names[e.preset + 1], e.name, NL_NAME_LEN);
        // Two brains, while both are up and the Standby one is heard.
        taskENTER_CRITICAL(&lock);
        const nl_ab_state_t abs = ab_state;
        const bool ab_fresh = ab_us && now - ab_us < 2000000;
        const bool stby_fresh = stby_wled_us && now - stby_wled_us < 2000000;
        const nl_wled_telemetry_t sw = stby_wled;
        const bool stby_all = stby_fresh && stby_fin_us && now - stby_fin_us < 2000000 && stby_layers_us && now - stby_layers_us < 2000000;
        const nl_fin_state_t sf = stby_fin;
        const nl_wled_layers_t sl = stby_layers;
        taskEXIT_CRITICAL(&lock);
        const bool ab_on = ab_fresh && stby_fresh && (abs.flags & NL_AB_ENABLED) && (abs.flags & NL_AB_A_UP) && (abs.flags & NL_AB_B_UP);
        if (stby_fresh && sw.preset && sw.name[0]) memcpy(wled_names[sw.preset], sw.name, NL_NAME_LEN);
        ctl_action_t ab_acts[CTL_MAX_ACTIONS];
        int nab = 0;
        ctl_action_t acts[CTL_MAX_ACTIONS];
        uint32_t rgb[KEY_COUNT];
        xSemaphoreTake(ctl_mutex, portMAX_DELAY);
        nab = ctl_set_ab(&ctl, ab_on, ab_acts);
        ab_in_use = ab_on;
        ctl_set_live(&ctl, &live, wfresh ? w.bri : 0, ffresh ? fs.follow : -1);
        ctl_set_layers(&ctl, &layers);
        const int nacts = ctl_tick(&ctl, now_ms(), acts);
        // Standby's looks onto the Standby brain, once a second (ctl_standby_sync).
        ctl_action_t sync_acts[CTL_MAX_ACTIONS];
        int nsync = 0;
        static int64_t next_sync;
        static ctl_standby_seen_t stby_seen;
        if (!(ab_on && stby_all) || now < stby_sync_after) stby_seen.have = false;   // a swap or a gap: start the record again
        if (ab_on && stby_all && now >= next_sync && now >= stby_sync_after) {
            next_sync = now + 1000000;
            const ctl_scene_t rep = { .body = sw.preset, .eyes = 0, .fins = sf.fin_preset };
            ctl_layers_t rl;
            layers_from(&sl, &rl);
            if (ctl_standby_adopt(&ctl, &rep, &rl, &stby_seen))
                ESP_LOGI(TAG, "standby brain changed by itself: Standby now preset %d, fins %d", ctl.standby.body, ctl.standby.fins);
            nsync = ctl_standby_sync(&ctl, &rep, &rl, sync_acts);
            if (wfresh && sw.bri != w.bri && nsync < CTL_MAX_ACTIONS)
                sync_acts[nsync++] = (ctl_action_t){ .type = ACT_BRIGHTNESS_STANDBY, .value = w.bri };
        }
        ctl_led_colors(&ctl, now_ms(), rgb);
        const ctl_t c = ctl;
        palettes_show(&c);   // also after a lock that came by itself
        xSemaphoreGive(ctl_mutex);
        run_ctl_actions(ab_acts, nab);
        run_ctl_actions(acts, nacts);
        run_ctl_actions(sync_acts, nsync);
        keypad_set_leds(rgb);
        static uint32_t echoed[KEY_COUNT];
        static bool echo_was;
        if (leds_echo && (!echo_was || memcmp(echoed, rgb, sizeof(echoed)))) {
            char text[8 * KEY_COUNT + 8];
            int len = snprintf(text, sizeof(text), "LEDS ");
            for (int k = 1; k < KEY_COUNT; k++) len += snprintf(text + len, sizeof(text) - len, "%s%06lx", k > 1 ? "," : "", (unsigned long)rgb[k]);
            printf("%s\n", text);
            memcpy(echoed, rgb, sizeof(echoed));
        }
        echo_was = leds_echo;

        // The time from the radio. A few seconds' difference isn't worth a write.
        const uint32_t heard = heard_time;
        if (heard) {
            heard_time = 0;
            const uint32_t have = rtc_now();
            if (!have || (have > heard ? have - heard : heard - have) > 5) {
                ESP_LOGI(TAG, "time from the radio: %lu", (unsigned long)heard);
                rtc_set(heard);
            }
        }
        power_status_t pw;
        power_get(&pw);
        // WLED's battery-aware current limit wants the voltage feeding the
        // pole and the lights' current.
        if (pw.have_monitor && now >= next_battery) {
            next_battery = now + BATTERY_BROADCAST_MS * 1000LL;
            const nl_battery_t b = { .pack_mv = (uint16_t)pw.light_mv, .current_ma = pw.light_ma, .flags = NL_BATT_CURRENT };
            nl_espnow_broadcast(NL_MSG_BATTERY, &b, sizeof(b));
        }

        // PAGE held under the lock: the Wi-Fi update on or off
        const int64_t pls = page_locked_since;
        if (pls > 0 && now - pls >= WIFI_KEY_HOLD_US) {
            page_locked_since = -1;
            ota_wifi_set(!ota_wifi_on());
        }

        if (n % 5) continue;  // the screen every 250 ms
        {   // updates on the event line: this board's, then the Wi-Fi's, then the mirror's
            char text[100], mt[96];
            ota_progress_text(text, sizeof(text));
            if (!text[0]) ota_wifi_text(text, sizeof(text));
            if (!text[0]) {
                mirror_link_text(mt, sizeof(mt));
                if (!strncmp(mt, "Mirror update", 13)) snprintf(text, sizeof(text), "%s", mt);
            }
            if (strcmp(text, update_shown)) {
                if (text[0]) display_event("%s", text);
                memcpy(update_shown, text, sizeof(update_shown));
            }
        }
        nl_espnow_stats_t st;
        nl_espnow_get_stats(&st);
        display_status_t ds = {
            .channel = st.channel,
            .locked = st.locked,
            .anchoring = st.anchoring,
            .leading = st.leading,
            .group = st.group,
            .rx = st.rx,
            .tx = st.tx,
            .tx_fail = st.tx_fail,
            .eyes_fresh = fresh,
            .eyes = e,
            .wled_fresh = wfresh,
            .wled = w,
            .stream_fresh = sfresh,
            .stream = ws,
            .bump_action = bump_showing(),
            .fins_fresh = ffresh,
            .fins = fs,
            .power = pw,
            .live = c.live,
            .standby = c.standby,
            .brightness = c.brightness,
            .target = c.target,
            .page = (uint8_t)ctl_mode(&c),
            .layers = c.layers,
            .diff = ctl_standby_diff(&c),
            .keys_locked = c.locked,
            .take_preview = c.take_preview,
            .latch = c.down[KEY_LATCH],
        };
        name_of(ds.live_body, wled_names, 256, c.live.body);
        name_of(ds.live_eyes, eye_names, 64, c.live.eyes);
        name_of(ds.stby_body, wled_names, 256, c.standby.body);
        name_of(ds.stby_eyes, eye_names, 64, c.standby.eyes);
        name_of(ds.live_fins, wled_names, 256, c.live.fins > 0 ? NL_FIN_PRESET_BASE + c.live.fins : 0);
        name_of(ds.stby_fins, wled_names, 256, c.standby.fins > 0 ? NL_FIN_PRESET_BASE + c.standby.fins : 0);
        ds.fin_sensor = c.fin_sensor;
        logger_set_show(wfresh ? w.preset : -1, wfresh ? w.bri : -1, wfresh ? w.fps : -1, c.fin_sensor);
        {
            const char *pn = ctl_palette_name(&c, c.layers.body_pal);
            snprintf(ds.live_pal_name, sizeof(ds.live_pal_name), "%s", pn ? pn : "");
            ctl_standby_layers(&c, &ds.stby_layers);
            pn = ctl_palette_name(&c, ds.stby_layers.body_pal);
            snprintf(ds.stby_pal_name, sizeof(ds.stby_pal_name), "%s", pn ? pn : "");
        }
        const uint8_t found = keypad_boards_found();
        ds.keypads_found = __builtin_popcount(found);
        ds.keypads_total = keypad_board_count();
        {
            logger_status_t l;
            logger_get(&l);
            if (!l.enabled) snprintf(ds.log_text, sizeof(ds.log_text), "Log off");
            else if (!l.mounted) snprintf(ds.log_text, sizeof(ds.log_text), "No TF card");
            else snprintf(ds.log_text, sizeof(ds.log_text), "Log L%05d%s", l.file_number, rtc_time_known() ? "" : " no clock");
        }
        ds.ab_live = ab_on ? abs.live : -1;
        display_update(&ds);
        if (n % 40) continue;  // log every 2 s
        char eyes_s[160] = "no eyes heard", wled_s[200] = "no WLED heard";
        if (fresh)
            snprintf(eyes_s, sizeof(eyes_s), "eyes: preset %d/%d, %s, %s, fps %.1f / %.1f, late %d / %d, %.0f bpm, hype %.2f",
                     e.preset, e.preset_count, state_name(e.state), e.linked ? "linked" : "NOT linked",
                     e.fps_x10[0] / 10.0f, e.fps_x10[1] / 10.0f, e.late_frames[0], e.late_frames[1], e.tempo_bpm, e.hype);
        if (wfresh)
            snprintf(wled_s, sizeof(wled_s), "wled: %s bri %d, preset %d, fx %d, %u fps, %u LEDs", w.on ? "on" : "off",
                     w.bri, w.preset, w.fx, w.fps, w.leds);
        if (wfresh && sfresh) {
            const size_t len = strlen(wled_s);
            snprintf(wled_s + len, sizeof(wled_s) - len, ", stream from %u.%u.%u.%u: %u stalls/min (%u slow), longest %u ms, %lu stalls total",
                     ws.source_ip[0], ws.source_ip[1], ws.source_ip[2], ws.source_ip[3], ws.stalls, ws.slow, ws.max_gap_ms,
                     (unsigned long)ws.stalls_total);
        }
        ESP_LOGI(TAG, "ch %d%s | %s | %s | radio rx %lu tx %lu fail %lu | live %d/%d standby %d/%d %s%s | keypads %d",
                 st.channel, st.anchoring ? " (anchor)" : st.leading ? " (searching, leading)" : st.group ? " (searching with a leader)"
                 : st.locked ? "" : " (scanning)", eyes_s, wled_s,
                 (unsigned long)st.rx, (unsigned long)st.tx, (unsigned long)st.tx_fail, c.live.body, c.live.eyes,
                 c.standby.body, c.standby.eyes, ctl_target_name(c.target), c.locked ? " LOCKED" : "", ds.keypads_found);
        if (pw.have_charger || pw.have_monitor) log_power();
    }
}
