snowyfox/Nibbles/firmware/eyes/main/main.c

// Nibbles: a neon eye for a festival shark totem.
#include <stdio.h>
#include <string.h>
#include "driver/gpio.h"
#include "esp_log.h"
#include "esp_random.h"
#include "esp_timer.h"
#include "freertos/FreeRTOS.h"
#include "freertos/task.h"
#include "nvs.h"
#include "nvs_flash.h"
#include "config.h"
#include "board.h"
#include "eye.h"
#include "link.h"
#include "esp_heap_caps.h"
#include "freertos/queue.h"
#include "nibbles_espnow.h"
#include "presets.h"
#include "render.h"
#include "sensors.h"

static const char *TAG = "nibbles";


// Preset commands, bumps and looks (from WLED presets) from the radio, handed to the eye task.
static QueueHandle_t radio_cmds, radio_bumps, radio_looks;

typedef struct {
    nl_bump_t bump;
    int64_t rx_us;  // when it arrived, to measure how soon it shows
} bump_item_t;

static void on_radio(const uint8_t mac[6], const nl_radio_hdr_t *h, const uint8_t *pl, size_t len)
{
    if (h->type == NL_MSG_AUDIO && len == sizeof(nl_audio_t) && h->role == NL_ROLE_WLED) {
        nl_audio_t a;
        memcpy(&a, pl, sizeof(a));
        audio_set_radio(&a);
        return;
    }
    if (h->type == NL_MSG_BUMP && len == sizeof(nl_bump_t)) {
        bump_item_t it = { .rx_us = esp_timer_get_time() };
        memcpy(&it.bump, pl, sizeof(it.bump));
        if (it.bump.target & NL_TARGET_EYES) xQueueSend(radio_bumps, &it, 0);
        return;
    }
    if (h->type == NL_MSG_EYE_LOOK && len == sizeof(nl_eye_look_t) && h->role == NL_ROLE_WLED) {
        nl_eye_look_t l;
        memcpy(&l, pl, sizeof(l));
        xQueueOverwrite(radio_looks, &l);   // only the newest matters
        return;
    }
    if (h->type != NL_MSG_CMD || len != sizeof(nl_cmd_t)) return;
    nl_cmd_t cmd;
    memcpy(&cmd, pl, sizeof(cmd));
    // Retries reuse the id: acknowledge again, but apply once.
    static uint16_t last_id;
    static uint8_t last_mac[6];
    const bool repeat = cmd.id == last_id && memcmp(mac, last_mac, 6) == 0;
    uint8_t status = NL_ACK_OK;
    if (cmd.target != NL_TARGET_EYES) status = NL_ACK_UNSUPPORTED;
    else if (cmd.op == NL_OP_PRESET_SET && !preset_valid(cmd.arg)) status = NL_ACK_BAD_ARG;  // a look slot once filled
    else if (cmd.op == NL_OP_BRIGHTNESS_SET || cmd.op == NL_OP_BRIGHTNESS_STEP) status = NL_ACK_UNSUPPORTED;  // follows WLED
    else if (cmd.op == NL_OP_REACTIVITY && (cmd.arg < NL_REACT_PRESET || cmd.arg > NL_REACT_PEAKS)) status = NL_ACK_BAD_ARG;
    else if (cmd.op < NL_OP_PRESET_SET || cmd.op > NL_OP_REACTIVITY) status = NL_ACK_UNSUPPORTED;
    else if (!repeat) xQueueSend(radio_cmds, &cmd, 0);
    last_id = cmd.id;
    memcpy(last_mac, mac, 6);
    nl_espnow_ack(mac, cmd.id, status);
}

static void eye_task(void *arg)
{
    static eye_t eye;
    eye_init(&eye, esp_random());

    const int bright_pct = EYE_BRIGHTNESS_PCT;   // always; WLED's brightness doesn't change it (2026-11-09)
    render_set_brightness(bright_pct);

    int64_t last = esp_timer_get_time();
    int64_t last_log = last;
    int preset_index = 0, next_preset = 0;
    int rendered = 0, bump_preset = -1;  // a preset bump shows bump_preset while held
    nl_bump_rx_t bumps;
    nl_bump_rx_init(&bumps);
    int64_t bump_rx_us = 0;
    // Presets change every PRESET_CYCLE_S after boot; choosing one from the base
    // stops that (the base can turn it back on).
    bool auto_cycle = true;
    nl_react_t react = NL_REACT_PRESET;  // sound reactivity override from the base
    int64_t next_swap = last + (int64_t)PRESET_CYCLE_S * 1000000;
    render_set_preset(0);
    ESP_LOGI(TAG, "preset 0: %s", presets[0].name);
    nl_eye_look_t last_look;   // the leader's newest look, passed on again now and then
    bool have_look = false;
    int64_t next_look_send = 0;
    int frames = 0, late_total = 0;
    const nl_role_t role = board_role();
    const nl_side_t side = board_side();
    bool was_linked = false;
    int64_t last_link_log = last, next_telemetry = last;
    uint16_t fps_x10 = 0, late_second = 0;
    for (;;) {
        const int64_t now = esp_timer_get_time();
        float dt = (now - last) / 1e6f;
        if (dt > 0.1f) dt = 0.1f;
        last = now;

        // The port eye follows the leader while its shared state arrives;
        // otherwise (no cable, or the leader stopped) it runs on its own.
        nl_eye_state_t shared;
        const bool following = role == NL_ROLE_EYE_EARS && link_get_eye_state(&shared, LINK_STATE_MAX_AGE_MS);
        if (following != was_linked) {
            ESP_LOGI(TAG, "%s", following ? "following the leader eye" : "running standalone");
            was_linked = following;
            next_swap = now + (int64_t)PRESET_CYCLE_S * 1000000;
        }


        // A command from the radio. A preset chosen this way holds for a full cycle.
        nl_cmd_t cmd;
        if (!following && radio_cmds && xQueueReceive(radio_cmds, &cmd, 0) == pdTRUE) {
            if (cmd.op == NL_OP_REACTIVITY) {
                react = (nl_react_t)cmd.arg;
                ESP_LOGI(TAG, "radio command: react to %s", react == NL_REACT_BEATS ? "beats" : react == NL_REACT_PEAKS ? "peaks" : "each preset's choice");
            } else if (cmd.op == NL_OP_AUTO_CYCLE) {
                auto_cycle = cmd.arg != 0;
                next_swap = now + (int64_t)PRESET_CYCLE_S * 1000000;
                ESP_LOGI(TAG, "radio command: presets %s", auto_cycle ? "cycle" : "held");
            } else {
                int base = eye.swap_pending ? next_preset : preset_index;
                if (base >= preset_count) base = 0;   // stepping from a look: back to the built-in ones
                if (cmd.op == NL_OP_PRESET_SET) next_preset = cmd.arg;
                else if (cmd.op == NL_OP_PRESET_NEXT) next_preset = (base + 1) % preset_count;
                else next_preset = (base + preset_count - 1) % preset_count;
                eye_request_swap(&eye);
                next_swap = now + (int64_t)PRESET_CYCLE_S * 1000000;
                if (auto_cycle) ESP_LOGI(TAG, "presets held (chosen from the base)");
                auto_cycle = false;  // a preset picked by hand stays until the next pick
                ESP_LOGI(TAG, "radio command: preset %d next", next_preset);
            }
        }

        // A look from a WLED preset: into the slot not on screen, then blink to
        // it like any other preset change; the port eye gets it over the cable.
        nl_eye_look_t look;
        if (!following && radio_looks && xQueueReceive(radio_looks, &look, 0) == pdTRUE) {
            const int idx = preset_set_look(&look, rendered);
            if (idx >= 0) {
                last_look = look;
                have_look = true;
                link_send_look(&look);
                next_look_send = now + 2000000;
                next_preset = idx;
                eye_request_swap(&eye);
                auto_cycle = false;
                next_swap = now + (int64_t)PRESET_CYCLE_S * 1000000;
                ESP_LOGI(TAG, "look \"%.*s\" from WLED preset %d (preset index %d)", NL_NAME_LEN, look.name, look.id, idx);
            }
        }
        if (have_look && role == NL_ROLE_EYE_LEADER && now >= next_look_send) {
            next_look_send = now + 2000000;   // again for a port eye that restarted
            link_send_look(&last_look);
        }
        if (role == NL_ROLE_EYE_EARS && link_take_look(&look)) preset_set_look(&look, rendered);

        // Bumps: flash and blackout are drawn by the eye at once; a preset bump
        // blinks to its preset and blinks back on release (see swap_now below).
        bump_item_t bmsg;
        const uint32_t now_ms = (uint32_t)(now / 1000);
        nl_bump_event_t ev = NL_BUMP_EV_NONE;
        if (radio_bumps && xQueueReceive(radio_bumps, &bmsg, 0) == pdTRUE) ev = nl_bump_rx_message(&bumps, &bmsg.bump, now_ms);
        if (ev == NL_BUMP_EV_BEGIN || ev == NL_BUMP_EV_REPLACE) bump_rx_us = bmsg.rx_us;
        if (ev == NL_BUMP_EV_NONE) ev = nl_bump_rx_tick(&bumps, now_ms);
        if (ev == NL_BUMP_EV_END || ev == NL_BUMP_EV_REPLACE) {
            eye_set_bump(&eye, 0);
            bump_preset = -1;
        }
        if (ev == NL_BUMP_EV_BEGIN || ev == NL_BUMP_EV_REPLACE) {
            eye_set_bump(&eye, bumps.bump.action);
            // Preset bumps are 1-based (the same number means the same on WLED).
            if (bumps.bump.action == NL_BUMP_PRESET && bumps.bump.arg >= 1 && preset_valid(bumps.bump.arg - 1))
                bump_preset = bumps.bump.arg - 1;
        }
        if (ev != NL_BUMP_EV_NONE) ESP_LOGI(TAG, "bump %s (action %d)", ev == NL_BUMP_EV_END ? "end" : "begin", bumps.bump.action);

        // Cycle through the visual presets; the eye blinks to hide each change.
        if (!following && auto_cycle && now >= next_swap) {
            next_swap += (int64_t)PRESET_CYCLE_S * 1000000;
            next_preset = preset_index >= preset_count ? 0 : (preset_index + 1) % preset_count;
            eye_request_swap(&eye);
        }

        audio_features_t a;
        motion_features_t m;
        const audio_source_t audio_src = audio_get(&a);
        motion_get(&m);
        eye_update(&eye, &a, &m, dt);
        if (following) {
            eye_apply_shared(&eye, &shared, side, &m);
            if (shared.preset != preset_index && preset_valid(shared.preset)) {
                preset_index = shared.preset;
                ESP_LOGI(TAG, "preset %d: %s (from the leader)", preset_index, preset_get(preset_index)->name);
            }
            if (preset_index != rendered) {  // the leader's lids are shut for it
                rendered = preset_index;
                render_set_preset(rendered);
            }
        } else {
            // What the eye should show: a held preset bump, else its own preset.
            // Every change hides behind a swap blink and happens while the lids
            // are shut.
            const int wanted = bump_preset >= 0 ? bump_preset : next_preset;
            if (wanted != rendered && !eye.swap_pending && !eye.p.swap_now) eye_request_swap(&eye);
            if (eye.p.swap_now) {
                if (next_preset != preset_index) {
                    preset_index = next_preset;
                    ESP_LOGI(TAG, "preset %d: %s", preset_index, preset_get(preset_index)->name);
                }
                const int show = bump_preset >= 0 ? bump_preset : preset_index;
                if (show != rendered) {
                    rendered = show;
                    render_set_preset(rendered);
                    if (bump_preset >= 0) ESP_LOGI(TAG, "bump preset %d: %s", rendered, preset_get(rendered)->name);
                }
            }
        }
        const bool peaks = react == NL_REACT_PRESET ? preset_get(rendered)->peak_beats : react == NL_REACT_PEAKS;
        eye_set_peak_beats(&eye, peaks);  // the preset on screen decides, unless the base overrides
        if (role == NL_ROLE_EYE_LEADER) {
            eye_export_shared(&eye, rendered, side, &shared);
            shared.brightness = (uint8_t)bright_pct;
            link_send_eye_state(&shared);
        }
        render_frame(&eye.p);
        frames++;
        if (bump_rx_us && (bumps.bump.action != NL_BUMP_PRESET || bump_preset < 0 || rendered == bump_preset)) {
            ESP_LOGI(TAG, "bump shown %.1f ms after it arrived", (esp_timer_get_time() - bump_rx_us) / 1000.0f);
            bump_rx_us = 0;
        }

        if (radio_cmds && now >= next_telemetry) {
            next_telemetry = now + TELEMETRY_MS * 1000LL;
            link_stats_t ls;
            link_get_stats(&ls);
            nl_eye_telemetry_t t = {
                .preset = (uint8_t)preset_index,
                .preset_count = (uint8_t)preset_count,
                .state = (uint8_t)eye.state,
                .linked = ls.peer_up,
                .fps_x10 = { fps_x10, ls.peer_up ? ls.peer_fps_x10 : 0 },
                .late_frames = { late_second, ls.peer_up ? ls.peer_late : 0 },
                .tempo_bpm = eye.p.tempo_bpm,
                .level_db = a.level_db,
                .hype = eye.p.hype,
                .brightness = (uint8_t)bright_pct,
                .flags = (uint8_t)((auto_cycle ? NL_EYE_AUTO_CYCLE : 0) | NL_EYE_REACT_FLAGS(react) |
                                   (eye.peak_beats ? NL_EYE_PEAKS_NOW : 0)),
            };
            strlcpy(t.name, preset_get(rendered)->name, sizeof(t.name));
            nl_espnow_broadcast(NL_MSG_EYE_TELEMETRY, &t, sizeof(t));
        }

        if (now - last_log >= 1000000) {
            float secs = (now - last_log) / 1e6f;
            int late;
            float worst_ms, prep_ms;
            render_take_stats(&late, &worst_ms, &prep_ms);
            fps_x10 = (uint16_t)(frames / secs * 10.0f + 0.5f);
            late_second = (uint16_t)late;
            link_set_status(fps_x10, late_second);
            if (radio_cmds) nl_espnow_set_status(fps_x10, late_second);
            late_total += late;
            ESP_LOGI(TAG, "%.1f fps (prep %.1f, send %.1f ms max, %d late) | %.1f dB (floor %.1f, gain %.0f) loud %.2f warm %.2f beats %lu bpm %.0f rhythm %.2f | "
                     "look %+.2f,%+.2f twist %+.0f/s (%.2f) jolt %.2fg dance %.2f (%.2fs) act %.2f | %s lid %.2f hype %.2f",
                     frames / secs, prep_ms, worst_ms, late, a.level_db, a.noise_floor_db, a.gain_db, a.loudness, a.warmth, (unsigned long)a.beat_count,
                     a.beat_period_s > 0 ? 60.0f / a.beat_period_s : 0.0f, a.beat_confidence,
                     m.look_x, m.look_y, m.twist_dps, m.twist_dominance, m.jolt_g, eye.dance, m.dance_period_s, m.activity,
                     eye_state_name(eye.state), eye.p.lid_open, eye.p.hype);
            frames = 0;
            last_log = now;
        }
        if (now - last_link_log >= 5000000) {
            link_stats_t ls;
            link_get_stats(&ls);
            ESP_LOGI(TAG, "link: %s eye (%s), peer %s%s, rx %lu tx %lu frames, crc %lu bad %lu, own echo %lu, audio from %s, late total %d",
                     side == NL_SIDE_PORT ? "port" : "starboard", role == NL_ROLE_EYE_LEADER ? "leader" : "ears",
                     ls.peer_up ? "up" : "down", following ? " (following)" : "",
                     (unsigned long)ls.rx_frames, (unsigned long)ls.tx_frames, (unsigned long)ls.crc_errors,
                     (unsigned long)ls.bad_frames, (unsigned long)ls.own_frames, audio_source_name(audio_src), late_total);
            if (radio_cmds) {
                nl_espnow_stats_t rs;
                nl_espnow_get_stats(&rs);
                ESP_LOGI(TAG, "radio: channel %d %s, rx %lu tx %lu fail %lu dropped %lu, %lu locks, internal heap free %u",
                         rs.channel, rs.locked ? "locked" : "scanning", (unsigned long)rs.rx, (unsigned long)rs.tx,
                         (unsigned long)rs.tx_fail, (unsigned long)rs.dropped, (unsigned long)rs.locks,
                         (unsigned)heap_caps_get_free_size(MALLOC_CAP_INTERNAL));
            }
            last_link_log = now;
        }
        vTaskDelay(1);  // let the idle task run
    }
}

void app_main(void)
{
    esp_err_t err = nvs_flash_init();
    if (err == ESP_ERR_NVS_NO_FREE_PAGES || err == ESP_ERR_NVS_NEW_VERSION_FOUND) {
        nvs_flash_erase();
        nvs_flash_init();
    }

    ESP_ERROR_CHECK(render_init());
    if (link_start() != ESP_OK) ESP_LOGE(TAG, "eye link unavailable; running standalone");
    if (EYES_RADIO && board_role() == NL_ROLE_EYE_LEADER) {
        radio_cmds = xQueueCreate(4, sizeof(nl_cmd_t));
        radio_bumps = xQueueCreate(8, sizeof(bump_item_t));
        radio_looks = xQueueCreate(1, sizeof(nl_eye_look_t));
        const nl_espnow_config_t rcfg = {
            .role = NL_ROLE_EYE_LEADER,
            .side = board_side(),
            .fw = NIBBLES_FW_BUILD,
            .anchor = false,
            .anchor_channel = RADIO_START_CHANNEL,
            .handler = on_radio,
            .core = 0,
        };
        if (nl_espnow_start(&rcfg) != ESP_OK) {
            ESP_LOGE(TAG, "radio unavailable");
            radio_cmds = NULL;
        }
    }
    if (audio_start() != ESP_OK) ESP_LOGE(TAG, "audio unavailable; eye will not react to sound");
    if (motion_start() != ESP_OK) ESP_LOGE(TAG, "IMU unavailable; eye will not react to motion");

    xTaskCreatePinnedToCore(eye_task, "eye", 6144, NULL, 5, NULL, 1);
}
