snowyfox/Nibbles/firmware/base/main/controls.h

// The keypad's logic: Live / Standby like a video switcher, targets, number
// keys, modifiers, bumps and the keys' LED colours. Everything is a bump until
// it's latched: hold a number (or TAKE) to show it, tap LATCH while holding to keep it.
// What the numbers 1-16 do (2026-11-03): presets 1-16, or, with a modifier held
// (as hotkeys on a computer), PALETTE: the palettes in the palette viewer's
// list (all of WLED's, wled_palettes.h, CTL_PALETTE_ROWS on the screen at a
// time; UP/DOWN scroll it by one, repeating while held, PAGEUP/PAGEDOWN and
// LEFT/RIGHT by a screenful, round and round), LAYER: layer looks 1-16
// (WLED presets NL_LAYER_PRESET_BASE + n on the target's overlay; LATCH on the
// one that's live switches it off), BRIGHT (or PAGE): brightness in eighths
// (1-8). PAGE tapped still cycles what the numbers do with no modifier held
// (presets, palettes, layer looks), for a keypad without the modifier keys.
// Every one of those also has a key of its own that does it whatever is held
// (PRESET1-16, PALETTE1-8, LAYER1-16, BRIGHT1-8), for a keyboard mapping.
// Standby holds palettes and layer looks too: LATCH held first, then a number,
// cues one (a layer look already in Standby is cued off); TAKE previews and
// takes them with Standby's presets. Plain C with no ESP-IDF calls, so it runs
// in the host tests (test/host); main.c feeds it key events and telemetry and
// carries out the actions it returns.
#pragma once

#include <stdbool.h>
#include <stdint.h>

#define CTL_NUMBERS  16    // number keys
#define CTL_PRESETS  16    // presets the keys reach (WLED preset id; eye preset index + 1; fin preset)
#define CTL_PALETTES 8     // favourite palettes, PALETTE1-8 (palettes[])
// Palettes on the viewer's screen at a time, picked by numbers 1..this with
// PALETTE held (the arrows step through sets of this many). The one setting
// to change: the screen's rows and the keys follow it (1-16). 8 for picking
// one-handed (user, 2026-11-03).
#define CTL_PALETTE_ROWS 8
#define CTL_SCROLL_DELAY_MS  400   // UP/DOWN held this long scrolls by itself...
#define CTL_SCROLL_REPEAT_MS 150   // ...one palette this often...
#define CTL_SCROLL_FAST_MS   2000  // ...and after this long held,
#define CTL_SCROLL_FAST_REPEAT_MS 80   // this often
#define CTL_LAYERS   16    // layer looks (NL_LAYER_PRESET_COUNT)
#define CTL_BRIGHTS  8     // brightness steps (eighths)

// Logical keys (where each physical key lands is set in config.h, KEYPAD_MAP).
typedef enum {
    KEY_NONE = 0,
    KEY_NUM1, KEY_NUM2, KEY_NUM3, KEY_NUM4, KEY_NUM5, KEY_NUM6, KEY_NUM7, KEY_NUM8,
    KEY_ALL, KEY_BODY, KEY_EYES, KEY_FINS,  // target selectors
    KEY_PAGE,        // tap: next page (presets, palettes, layers); hold + number: brightness
    KEY_LATCH,       // tap while a number or TAKE is held: keep it (it becomes Live);
                     // held first, then a number: cue that preset (palette, layer look) in Standby;
                     // + TAKE: Standby = Live
    KEY_BLACKOUT,    // bump while held; with PAGE held: toggle the pole's power, on a USB-C supply
    KEY_FIN_SENSOR,  // tap: fin LEDs follow the fins' real angle, or stay at the modelled angle (live)
    KEY_TAKE,        // held: show Standby while held; + a tap of LATCH: swap Standby and Live
    KEY_FLASH,       // bump while held
    KEY_UNLOCK,      // hold: lock or unlock the keypad
    // Added 2026-11-03, after the first keys so their order (the LED list) stays.
    KEY_NUM9, KEY_NUM10, KEY_NUM11, KEY_NUM12, KEY_NUM13, KEY_NUM14, KEY_NUM15, KEY_NUM16,
    KEY_MOD_PALETTE, // held: the numbers are palettes
    KEY_MOD_LAYER,   // held: the numbers are layer looks
    KEY_MOD_BRIGHT,  // held: the numbers 1-8 set the brightness in eighths (as PAGE held)
    // Keys that do one thing whatever the page or the modifiers (bump while
    // held and LATCH, or cue with LATCH held first, as the numbers do)
    KEY_PRESET1, KEY_PRESET_LAST = KEY_PRESET1 + CTL_PRESETS - 1,
    KEY_PALETTE1, KEY_PALETTE_LAST = KEY_PALETTE1 + CTL_PALETTES - 1,
    KEY_LAYER1, KEY_LAYER_LAST = KEY_LAYER1 + CTL_LAYERS - 1,
    KEY_BRIGHT1, KEY_BRIGHT_LAST = KEY_BRIGHT1 + CTL_BRIGHTS - 1,
    KEY_POLE_POWER,  // toggle the pole's power, on a USB-C supply (as PAGE + BLACKOUT)
    KEY_LEFT, KEY_RIGHT, KEY_UP, KEY_DOWN,   // palettes showing: LEFT/RIGHT a screenful back/on, UP/DOWN one
                                             // (held: on by itself, CTL_SCROLL_*)
    KEY_PAGE_UP, KEY_PAGE_DOWN,              // palettes showing: a screenful back / on
    KEY_COUNT
} ctl_key_t;

typedef enum {
    TGT_ALL = 0,     // the whole shark: body and eyes on one preset, the fins following the body
    TGT_BODY,        // WLED's body segment
    TGT_EYES,
    TGT_FINS,        // WLED's fin segment (fin presets)
} ctl_target_t;

// What the shark shows (Live) or will show (Standby). Presets are 1-based on
// both sides (WLED preset id; eye preset index + 1); 0 = not known / not set.
typedef struct {
    int16_t body;
    int16_t eyes;
    int8_t fins;     // fin preset 1..16 (WLED preset NL_FIN_PRESET_BASE + n), 0 following the body, -1 not known
} ctl_scene_t;

typedef enum {
    ACT_PRESET,      // target (TGT_BODY, TGT_EYES or TGT_FINS), value = preset (1-based; fins: 0 = follow the body);
                     // body: bump = 1 lets the WLED preset's eye settings through (ALL), 0 body only
    ACT_FINS,        // the fins' angle sensor: value = 0 locked at the model angle, 1 follow, 2 toggle
    ACT_BRIGHTNESS,  // value = 0..255 (WLED; the eyes follow it)
    ACT_BUMP,        // slot (TGT_BODY, TGT_EYES or TGT_FINS), bump = NL_BUMP_* action, value = arg
                     // (fin preset bumps: the fin preset; palette and layer bumps: nl_slot_arg(WLED slot, value);
                     // scene bumps: nl_scene_arg(WLED preset id, layer) and extra = palette + 1)
    ACT_BUMP_END,    // slot
    ACT_SLOT_LOOK,   // target = WLED layer slot (nl_slot_t), value = layer preset (0: switch the slot off)
    ACT_SLOT_PALETTE, // target = WLED layer slot, value = palette
    ACT_POLE_POWER,  // PAGE + BLACKOUT or POLEPOWER: toggle the pole's power (main checks there's a USB-C supply)
    ACT_AB_HOLD,     // two brains: value 1 show the Standby brain on the LEDs while held, 0 back
    ACT_AB_TAKE,     // two brains: swap Live and Standby on the controller
    ACT_BRIGHTNESS_STANDBY, // two brains: value = 0..255, the Standby brain only (from main)
} ctl_act_type_t;

typedef struct {
    ctl_act_type_t type;
    uint8_t target;
    uint8_t bump;
    int16_t value;
    uint8_t extra;   // NL_BUMP_SCENE: palette + 1 (0: leave it), the bump's intensity
    bool standby;    // two brains: for the Standby brain, not the Live one
} ctl_action_t;

#define CTL_MAX_ACTIONS      8
#define CTL_BUMP_STACK       12      // bump keys held at once that are remembered (the oldest drop off)
#define CTL_LOCK_HOLD_MS     1000    // UNLOCK held this long locks or unlocks

// What the numbers do: PAGE cycles the first PAGE_COUNT; ctl_mode also gives
// PAGE_BRIGHT while BRIGHT is held.
typedef enum {
    PAGE_PRESETS = 0,    // presets 1-16
    PAGE_PALETTES,
    PAGE_LAYERS,
    PAGE_COUNT,
    PAGE_BRIGHT = PAGE_COUNT,
} ctl_page_t;

// WLED palettes on palette keys 1-8 (main can change them before use).
#define CTL_DEFAULT_PALETTES { 6, 8, 9, 11, 36, 40, 44, 51 }  // Party, Lava, Ocean, Rainbow, Icefire, Magenta, Orange & Teal, Atlantica
#define CTL_DEFAULT_PALETTE_NAMES { "Party", "Lava", "Ocean", "Rainbow", "Icefire", "Magenta", "Orange & Teal", "Atlantica" }

// WLED's layer slots as last reported (NL_MSG_WLED_LAYERS); -1 = not known.
typedef struct {
    int16_t body_pal, fins_pal;      // palette of the body's and the fins' own layer
    int16_t body_layer, fins_layer;  // layer preset showing over the body / fins (0: none)
} ctl_layers_t;

typedef struct {
    ctl_scene_t live, standby;
    ctl_layers_t standby_layers;     // palettes and layer looks cued in Standby (layer 0: off); -1: none cued,
                                     // Standby leaves it as it is, or as its new preset sets it
    bool have_live, standby_set;     // standby_set: Standby has been filled from Live once
    uint8_t brightness;              // WLED's, from telemetry
    int8_t fin_sensor;               // the fins follow their angle sensor: 1, 0, -1 not known
    ctl_target_t target;             // latched target
    ctl_target_t target_before;      // to go back to after a held target key
    ctl_key_t target_key;            // target key being held, or KEY_NONE
    bool target_used;                // a number was pressed while it was held: momentary
    int page;                        // ctl_page_t
    uint8_t palettes[CTL_PALETTES];   // WLED palette on each of PALETTE1-8
    int pal_first;                   // the palette viewer's top row: number n is WLED palette (pal_first + n - 1) round the list
    uint32_t scroll_next_ms;         // UP/DOWN held: when it next scrolls by itself
    ctl_layers_t layers;
    bool page_used;                  // a number was pressed while PAGE was held: brightness, no page flip
    bool locked;
    bool lock_toggled;               // this UNLOCK press already toggled
    uint32_t autolock_ms;            // lock after this long without a key (0: never)
    uint32_t last_key_ms;
    bool down[KEY_COUNT];
    uint32_t down_ms[KEY_COUNT];
    ctl_key_t num_bump;              // number key held (bumping its preset), or KEY_NONE
    int num_preset;                  // what it shows: preset, palette or layer preset
    int num_kind;                    // what kind of thing that is (controls.c, FN_*)
    ctl_layers_t num_layers;         // the layers before it (WLED reports a layer bump as live)
    ctl_target_t num_target;         // the target it was pressed on
    // Bump keys held, in the order they went down (2026-11-09, the user's
    // design): the newest shows; letting it go shows the one under it, letting
    // go of any other just takes it out; the last one up goes back to how it
    // was. Numbers, keys of their own, FLASH and BLACKOUT. LATCH empties it.
    struct { ctl_key_t key; int8_t kind; int8_t target; int16_t value; } held[CTL_BUMP_STACK];
    int nheld;
    ctl_layers_t held_layers;        // the layers before the first of them
    bool take_preview;               // TAKE is down and the Standby bumps are on
    ctl_layers_t take_layers;        // the layers when TAKE went down (WLED reports its preview as live)
    uint8_t bump_slots;              // bit per slot (1 << TGT_BODY, TGT_EYES, TGT_FINS) with a bump on
    bool ab;                         // two brains up: Standby runs on the other brain, TAKE switches to it
    bool ab_holding;                 // TAKE is showing the Standby brain
} ctl_t;

void ctl_init(ctl_t *c, uint32_t autolock_ms);

// Telemetry: what the shark shows now (fields 0 / -1 where not known yet).
// The first complete picture also fills Standby.
void ctl_set_live(ctl_t *c, const ctl_scene_t *live, uint8_t brightness, int fin_sensor);

// Two brains are up (ctl_set_ab true): Standby's body and fins run on the Standby
// brain, which ctl_standby_sync keeps in step, and TAKE just switches to it. Eyes
// have no second brain, so they work as ever. Returns any actions for letting go.
int ctl_set_ab(ctl_t *c, bool on, ctl_action_t *out);
// What it takes to make the Standby brain match Standby, given what it reports:
// actions with standby set. A preset first, its palette and looks once it's reported
// (a new preset brings its own), so call again after the next report.
int ctl_standby_sync(const ctl_t *c, const ctl_scene_t *reported, const ctl_layers_t *reported_layers, ctl_action_t *out);
// The Standby brain changed by itself (from its own web page, not the base): take that as
// Standby's cue instead of putting it back (user, 2026-11-02, while the base has no keys).
// *last holds the previous report; with *have_last false this one only starts the record.
// Call before ctl_standby_sync, only while what the Standby brain reports is current.
// True if it took something.
typedef struct {
    ctl_scene_t scene;
    ctl_layers_t layers;
    bool have;
} ctl_standby_seen_t;
bool ctl_standby_adopt(ctl_t *c, const ctl_scene_t *reported, const ctl_layers_t *reported_layers, ctl_standby_seen_t *last);

// TAKE + LATCH without the keys (USB serial "ab take"): Live and Standby trade places as
// the controller swaps the brains. Returns the actions (ACT_AB_TAKE among them); none
// with one brain.
int ctl_ab_take(ctl_t *c, ctl_action_t *out);

// A key went down or up. Returns how many actions it wrote to out (at most CTL_MAX_ACTIONS).
int ctl_key(ctl_t *c, ctl_key_t key, bool down, uint32_t now_ms, ctl_action_t *out);

// Call every ~10-50 ms: locking by holding UNLOCK, auto-lock.
int ctl_tick(ctl_t *c, uint32_t now_ms, ctl_action_t *out);

// WLED's layer slots (from NL_MSG_WLED_LAYERS; fields -1 where not known).
void ctl_set_layers(ctl_t *c, const ctl_layers_t *layers);

// Which parts of Standby differ from Live (bit per target: 1 << TGT_BODY etc.;
// a cued palette or layer look counts for the body or the fins).
uint8_t ctl_standby_diff(const ctl_t *c);

// Standby's palettes and layer looks as TAKE would leave them: the cued one,
// else Live's where Standby keeps Live's preset; else -1 for the palette (the
// new preset's own) and 0 for the layer (a new preset clears it).
void ctl_standby_layers(const ctl_t *c, ctl_layers_t *out);

// Each key's LED colour now (0xRRGGBB, full scale; the LED driver dims it).
void ctl_led_colors(const ctl_t *c, uint32_t now_ms, uint32_t rgb[KEY_COUNT]);

const char *ctl_key_name(ctl_key_t key);
ctl_key_t ctl_key_by_name(const char *name);
const char *ctl_target_name(ctl_target_t t);
const char *ctl_page_name(int page);
// What the numbers do now: the page, or what the modifier held makes them (for the screen).
int ctl_mode(const ctl_t *c);
// The WLED palette number n (1-16) picks in palette mode now, or -1 (not on the screen).
int ctl_set_palette(const ctl_t *c, int n);
// A WLED palette's name (wled_palettes.h), else NULL.
const char *ctl_palette_name(const ctl_t *c, int palette);
