snowyfox/Nibbles/(commit log)

2026-09-24 Neon shark eye firmware for Waveshare ESP32-S3-Touch-AMOLED-1.75
    Animated neon eye for a festival totem. Reacts to music from the onboard
    microphone (loudness, beats, bass/treble colour, sleep on silence) and to
    pole motion from the QMI8658 (springy look with inertia, dance detection
    with a happy squint).
    - Custom strip renderer driving the CO5300 directly (no LVGL), using
    precomputed distance maps in PSRAM and both cores: ~31 fps
    - Pure-C audio, motion and eye-behaviour modules with host tests
    - BOOT button cycles brightness, saved to NVS
    - bsp_extra copied from Waveshare's 05_Spec_Analyzer, plus a mic gain setter
    [partitions.csv]
2026-09-24 Replace happy squint with hype mode; default to full brightness
    Dancing now makes the eye more energetic instead of squinting: rings flow
    outward from the pupil (one ring per beat when the tempo is known), colours
    cycle faster, rings wobble and glow harder, and beat thumps are bigger.
    Hype tuning lives in config.h.
    Brightness now defaults to 100% and is logged at boot. The BOOT button
    still cycles 30/60/100%.
    [config.h, eye.c, eye.h, main.c, render.c, test_main.c]
2026-09-24 Automatic mic gain and environment-adaptive silence detection
    - ES7210 gain now adjusts itself (0-36 dB in 3 dB steps): drops fast near
    clipping, rises slowly while peaks stay quiet. Analysis runs on
    gain-removed levels and skips the frames buffered across a change, so
    loudness, colour and beats are unaffected.
    - The fixed SILENCE_DB threshold is replaced by a tracked background noise
    floor; "sound" means clearly above it, and detected beats count too. The
    floor learns the room quickly after boot, starting below the first
    reading so booting into music works.
    - Host tests now run audio through a simulated mic with delayed gain and
    clipping, plus crowd-noise and end-to-end sleep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
    [audio.c, audio_analysis.c, audio_analysis.h, config.h, eye.c, main.c, test_main.c]
2026-09-24 Draw eyelid edges with the same neon line as the eye outline
    Lid edges now use the outline ring's glow profile, colour and brightness,
    measured perpendicular to the lid curve so the line keeps its thickness
    near the corners. Fully open lids now sit clear of the display by more
    than the glow width, so no lid glow leaks in and the lid path is skipped.
    [render.c]
2026-09-24 Sync frames to the panel's TE signal to stop tearing
    The CO5300 refreshes from its own memory at ~59 Hz while frames were being
    written strip by strip, so parts of the screen could show different frames.
    Each frame now starts on the TE falling edge (GPIO13, start of scan); since a
    frame takes between one and two refreshes to send, the first refresh shows
    the whole old frame and the second the whole new one. Frame rate locks to
    29.5 fps.
    To keep every frame inside that ~33 ms window, lid rendering is split per
    row into black / clear / lid-edge spans so only pixels near a lid edge run
    the lid maths (half-closed lids went from 39 ms to 27 ms per frame). The
    render helper task now outranks the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
2026-09-24 Sleep only in a genuinely quiet room; wake easily; faster gain control
    The floor-relative silence test let the noise floor climb up to quiet
    background music, so the eye fell asleep while music played. Sleep now
    needs the 1.5 s average level (mic gain removed) to stay below QUIET_DB
    (-86.5 dB, set from on-board measurements: silent room -89 dB, faint music
    -74 to -84 dB) with no steady beat. Any sound 3 dB above that for 0.15 s,
    the average rising above it, a steady beat or a bump wakes the eye. Single
    beats no longer count, since near-silence produces false ones. The noise
    floor is capped at QUIET_DB so music is never treated as background.
    Mic gain now raises every 0.5 s with a faster pea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
    [audio_analysis.c, audio_analysis.h, config.h, eye.c, test_main.c]
2026-09-24 More sensitive beat detection, tuned for EDM, trance, dubstep and DnB
    The old detector listened only to 40-160 Hz, which this board's small mic
    barely hears at normal volumes: on a 15 s recording of real music it found
    no beats at all. Beats are now onsets measured across five bands (40 Hz to
    8 kHz), each relative to its own recent level so it works at any volume,
    weighted toward the highs. The threshold is lower (1.0 sigma, no fixed
    minimum), and beats only fire while the last ~4 s of onsets are rhythmic,
    which keeps crowd noise, held chords and talking from producing beats.
    The reported tempo folds beat gaps into 100-200 bpm so the target genres
    read at their natural tempo (EDM 128, tranc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
    [audio_analysis.c, audio_analysis.h, config.h, main.c, test_main.c]
2026-09-24 Twist about the vertical: look into the turn when motion is mostly twist
    Rotation is split into twist about the vertical (from gravity) and tilt.
    Twist pushes the pupil sideways like other motion, but when it dominates
    the left/right response reverses and the twist steers the pupil straight
    into the turn, bypassing the pupil spring so it keeps up with fast twisting.
    Tuned from a recording of real twisting on the mount:
    - A new twist is recognised within ~50 ms (fades over 0.3 s) and reversal
    spans a 0.45-0.60 twist share, so the eye no longer swings the wrong way
    first. Hand twisting scores ~0.6-0.8.
    - The eye's sideways swing from twisting 120 mm off the axis is removed from
    the acce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
    [config.h, main.c, motion.c, motion_analysis.c, motion_analysis.h, test_main.c]
2026-09-24 Visual presets with blink transitions; tempo-locked spiral; motion hype
    Presets (main/presets.c) change how the eye is drawn while all behaviour
    stays shared: palette (rainbow or cyclic 4-colour), ring count, width,
    glow or hard-edged bands, iris fill, flow, pupil size, ripple and outline
    colours, and optional spiral arms. Five presets: Neon (the original),
    Inferno, Abyss, Synthwave and Hypno (spinning spiral). The eye cycles to
    the next every PRESET_CYCLE_S, hiding each change behind a deliberate
    blink (a sleeping eye briefly closes its slit too).
    Hypno's spin is locked to the music's tempo (one arm per beat, doubled in
    hype, calm spin without a steady beat), eased over about a second. The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
2026-09-24 Ten presets; full-brightness outline; spiral speed fixes
    - Five new presets: Toxic (acid bands pulled inward), Aurora (soft
    billowing glows), Vortex (tight five-armed spiral), Frost (thin icy
    rings) and Prism (rainbow stripes). Each spiral preset gets its own
    spiral map built at boot, shared when settings match.
    - The outline ring and eyelid lines are always at full brightness in
    every preset; the per-preset outline_amp setting is gone.
    - Vortex turns as fast as Hypno (a third of a turn per beat). Tests check
    each spiral against its own turns per beat.
    - Switching to a spiral preset now starts it at its own spin speed instead
    of carrying over the last spiral's (possibly hype-doub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
    [presets.c, presets.h, render.c, test_main.c]
2026-09-24 Add CLAUDE.md with project guide and session summary
    Covers the hardware and mount, build/flash/test commands, code layout, the
    design decisions behind rendering, audio, motion, eye behaviour and presets,
    the recording-and-replay debugging workflow, known limits, and the history of
    this session's work.
2026-09-24 Support two eyes mounted back to back; correct twist offset geometry
    A twisting recording showed the twist acceleration appears through the
    screen (R^2 0.92): the eyes sit forward of the pole with screens facing
    out to each side, not outward along the screen's facing direction as
    first assumed. The swing correction now removes the centripetal pull
    (-w^2 * x along the screen's horizontal) and ignores the tangential push,
    which goes through the screen. On the recording, fast twists keep the eye
    on the turn side 88% of the time (was 72%), dominance 0.94 (was 0.76).
    The offset mirrors between eyes (starboard screen +x points to the nose,
    port to the tail). One firmware serves both: the port boa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
    [config.h, motion.c, motion_analysis.c, motion_analysis.h, test_main.c]
2026-09-24 Restructure into a monorepo for the whole Nibbles system
    The eye firmware moves to firmware/eyes/ (history kept) so the repo can
    hold the other parts of the shark system: a shared link protocol, the base
    station firmware and a WLED usermod. The root CLAUDE.md now gives the
    system overview and conventions, the eye guide moves to
    firmware/eyes/CLAUDE.md, and docs/architecture.md records the agreed
    design and roadmap.
    [partitions.csv]
2026-09-25 Link the two eyes over a wired UART (Phase 1)
    shared/nibbles_link: the first piece of the shared protocol. Message
    structs (heartbeat, audio features, eye state), COBS framing with CRC-16
    and sequence numbers, a byte-wise parser that resyncs after noise. Host
    tests cover round trips for every payload length, single-byte corruption
    and resync. Built as an ESP-IDF component; pure C for reuse by the base
    station and the WLED usermod.
    Eye firmware: UART1 at 1 Mbaud on header GPIO 17/18 (crossed) plus GND.
    Roles by MAC: the port eye is the ears (runs the mic, sends audio features
    every 32 ms); the starboard eye leads (uses the port eye's audio while it
    arrives and pauses its own analysis, and se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
    [audio.c, board.c, board.h, config.h, eye.c, eye.h, link.c, link.h]
2026-09-25 ESP-NOW radio: leader eye telemetry and preset commands (Phase 2)
    shared/nibbles_link gains radio packets (magic, network id, version,
    sender role/side), eye telemetry, commands with acks, anchor heartbeats
    and a pure-C channel scanner (finds an anchor within one sweep, relocks
    when it moves), all host tested. Protocol version 2 (the wired heartbeat
    grew too, so both eyes need this build).
    shared/nibbles_espnow: ESP-IDF ESP-NOW transport for the eyes and base:
    Wi-Fi in station mode without a network, anchor or scan-and-lock,
    broadcast, and commands with ack and retries (applied once).
    Leader eye: locks onto the anchor, broadcasts telemetry every 500 ms,
    takes set/next/prev preset commands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
2026-09-25 WLED usermod: channel anchor, commands and telemetry (Phase 3, part 1)
    wled/usermod_nibbles builds into stock WLED 16.0.1 through custom_usermods
    (no fork), using shared/nibbles_link as a PlatformIO library. It switches
    ESP-NOW on, anchors the radio channel with 4 Hz heartbeats, takes preset
    commands aimed at WLED (acked, applied once), broadcasts WLED telemetry,
    and shows the eyes' telemetry on WLED's Info page. Other ESP-NOW traffic
    is left to WLED. wled/platformio_override.ini adds a dev env for a
    Waveshare ESP32-S3-Touch-LCD-3.49; wled/README.md has the build steps.
    Tested on the dev node: WLED anchors, the leader eye locks on and its
    telemetry reaches WLED, eyes keep 0 late frames. Tha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
2026-09-25 Eyes play bumps: flash, blackout and preset while held (Phase 5)
    - Leader eye takes bumps aimed at the eyes; the port eye follows over the cable
    - nl_eye_state_t gains a master level (81 B) so blackouts dim the outline too
    - Base: [eyes|wled] bump commands; the bump key flashes eyes and WLED
    - Fallback anchor stays home while sending, so held bumps don't drop out
2026-09-25 Base status screen on the 3.49's panel (Phase 4)
    LVGL 9.2 + esp_lcd_axs15231b, landscape 640x172: eyes, WLED and radio cards,
    event line, bump outline. A 'shot' serial command dumps the frame as base64
    RGB565 for checking the layout without seeing the panel.
2026-09-25 Root CLAUDE.md: current status of each piece and the base's test commands
2026-09-25 Measure bump latency on the leader eye (median 54 ms to the frame)
2026-09-25 Architecture doc: radio message table, current link timeout and base status
2026-09-25 WLED: target the real controller (WT32-ETH01, 0.15.1 ESP32_Ethernet); names-only preset parse
    The controller's 87 KB presets.json overflowed the JSON buffer (NoMemory), so
    every WLED preset command would have been refused; a filter needs 3.3 KB.
2026-09-25 WLED README: controller's LED pins match its silkscreen
2026-09-25 WLED README: USB connection blanks LED channel 3 on the controller
2026-09-25 WLED usermod: send ESP-NOW with esp_now_send, not quickEspNow.send (fixes boot hang)
    WLED starts QuickEspNow in synchronous mode, where send() busy-waits in the
    main loop for the 'sent' callback. A send that fails (as it does while Wi-Fi
    is still connecting in station mode) never gets one, so the loop spun forever:
    no web server, LEDs frozen. This is what hung the shark's controller.
    Reproduced on a bench ESP32 with the controller's config and storage; stock
    WLED 16 and the usermod-disabled build ran fine; with this fix it runs, anchors
    channel 11 and the leader eye locks on. Adds a nibbles_shark_debug env (UDP log).
    [usermod_nibbles.cpp]
2026-09-25 WLED README: GPIO 0 button toggled the controller's lights under WLED 16; removed
2026-09-25 WLED README: flash bumps browned out the controller; current limit set to 5000 mA
2026-09-25 Base screen: portrait layout (default), smaller wrapping preset names; random command ids
    - DISPLAY_ROTATION 0/180 stacks the cards down the 172x640 panel with big pads
    - Preset names at 20 px, wrapped in portrait, '...' in landscape; no scrolling
    - nibbles_espnow starts command ids at a random value each boot: a rebooted
    base reused id 1, which WLED took as a retry and didn't apply
    [config.h, display.c]
2026-09-25 Base: swipe-left preset page (tap = preset 1-10, hold = bump 11-20 on WLED and eyes)
    - Tileview with the status page and a 2x5 grid of square preset buttons
    - Preset bumps are 1-based on every receiver (eyes subtract 1), so one bump
    means the same preset on WLED and the eyes
    - Serial: preset N, page N. Larger single-app partition (app passed 1 MB)
2026-09-25 Base: AUTO switch and Preset/Beats/Peaks selector; picking a preset stops the eyes' timer
    - Eyes: any preset command turns auto-cycling off; NL_OP_REACTIVITY overrides
    each preset's sound reactivity (beats or every peak)
    - Eye telemetry's auto_cycle byte becomes flags (auto, reactivity mode, peaks now)
    - Base preset page gets the two controls; EYES card shows auto/held and peaks
2026-09-26 Eyes: split pure drawing into render_core; mirror the port eye's spirals
    render.c keeps the panel, TE and strip pipeline; render_core.c holds the
    picture itself (maps, colour tables, rows) with no ESP-IDF dependencies, so
    the lighting simulator can run the same code in the browser.
    The port eye builds its spiral maps mirrored left to right, so the two eyes,
    which face opposite ways, twist and spin as mirror images on the shark.
    Both eyes verified at 29.6 fps with 0 late frames.
2026-09-26 Add the lighting simulator and the Fusion 360 LED geometry export
    tools/fusion/NibblesLEDExport: Fusion script that traces the diffuser tube
    centre lines and exports geometry.json and the shark mesh.
    tools/sim: browser simulator for WLED and the eyes. Sound from the mic or a
    file runs through a WebAssembly port of WLED AudioReactive's processing;
    server.py relays the sync packets to a bench WLED and streams its LEDs back
    over DDP. make_layout.py places every LED from the Fusion geometry (wiring
    confirmed on the shark). The page shows a 3D view (three.js, with a
    WebGL-free fallback drawn in depth order), flat views, an axis indicator and
    a dim boost; the eyes run the eye firmware's own analy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
    [shark.obj]
2026-09-26 Docs: add the power system design and link it from the architecture
2026-09-26 Sim: new default view, fix the canvas 3D depth direction, dim LEDs behind the body
    - Default 3D view: level with the shark from the starboard front quarter
    (X left, Y right, both 45 degrees towards the viewer), in both renderers.
    - The WebGL-free 3D view treated depth backwards (perspective, layering of
    tubes, LEDs and eye screens, and which screen is seen from behind); fixed.
    - LEDs seen through the body sheet (the far fin, mostly) are drawn at 20%.
2026-09-26 Sim: draw the translucent body before the LEDs in the WebGL view
    three.js orders see-through objects by distance, so from about half the
    camera angles the body was drawn after the LEDs and darkened ones in front
    of it (to ~40%). LEDs behind the body are still dimmed by shadeLeds.
2026-09-26 WLED usermod: mirror the lights to the simulator on request
    A JSON state post {"nibbles":{"mirror":{"ip","port","s"}}} starts a stream
    for s seconds (renewed by tools/sim/server.py): every shown frame as DDP
    (gamma and brightness applied) to ip:port, and a JSON packet to port + 1
    with WLED's brightness and preset, the audio features sent to the eyes and
    the eyes' telemetry. Works with the usermod disabled; idle otherwise.
    Bench: identical to the bench's network LED output, 44 frames/s, WLED fps
    unchanged, 10-minute soak clean. On the shark's controller since 2026-09-26.
2026-09-26 Eyes follow WLED's master brightness
    The leader eye reads WLED's telemetry (0..255 -> percent, dark while WLED is
    off) and shares it with the port eye; 100% at power-on and when WLED hasn't
    been heard for 30 s. The eyes' own 30/60/100 levels, the saved setting, the
    BOOT button and eye brightness commands are gone. The base's eye brightness
    slider and "bri" command now set WLED's brightness. Verified on both eyes
    (WLED 128 -> 50%, 255 -> 100%); 29.6 fps, 0 late frames.
2026-09-26 Sim: live shark mirror, eyes follow WLED brightness, LED size, no pole
    - Lights: "The shark, live" mirrors the real controller (server.py asks its
    usermod to stream); the eyes then follow the real eyes' preset and
    reactivity and use the shark's own audio features.
    - The simulated eyes' brightness follows the shown WLED's master brightness
    (as on the shark), applied as light output (value * pct^(1/2.2)).
    - LED size slider (default 1.5x) and a stronger glow; the grey pole is gone.
2026-09-27 WLED: 2D map of the shark with partner copies; lean build
    - tools/sim/make_ledmap.py builds wled/ledmap/ledmap.json: a 70x35 matrix
    seen from starboard. Only the outward strip and the starboard fin are
    mapped (90% within one 9 mm cell); the inward strip and the port fin sit
    in spare cells and the usermod copies each from its partner after every
    frame (the file's "copy" list). The old eye rings aren't mapped.
    - Usermod: the partner copies (handleOverlayDraw), and the simulator mirror
    now sends LEDs in physical order (through the LED map), so it is right in
    2D. Bench: copies exact (0 of 531 differ), most 2D effects at 43 fps.
    - nibbles_shark is now a lean build on esp32dev: no Ethe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
2026-09-27 Shark WLED outputs: fins on 4/5, old eye lights removed
    The port and starboard fins moved from outputs 3/4 to 4/5 (GPIO 4, 5) and
    last year's eye lights (130 LEDs, behind the eye screens) were removed:
    1064 LEDs, same LED numbers, so presets, the 2D map (regenerated, byte for
    byte the same) and the simulator still match. Output 3 stays empty because
    the board's USB chip drives GPIO 3, so the controller's USB can stay
    connected. Controller config changed on 2026-09-27 (backup in
    wled/backup/, local). make_layout.py and make_ledmap.py follow the new
    numbering; the simulator layout no longer has the old eye rings.
    [make_layout.py, make_ledmap.py]
2026-09-27 Docs: top-of-pole wiring plan and ideas for later
    - Top-of-pole wiring: a USB hub in the controller box (powered from the
    box) reaching both eyes through 4-wire harnesses into their sealed domes
    and the WLED controller's own USB; a separate 5 V feed for the eyes;
    off-the-shelf hub module first, custom box PCB later.
    - Ideas for later: over-the-air updates for the eyes; fins with their own
    2D panels per preset and following their real hinge angle.
2026-10-02 Power: measured full-white draw, 100 W converter, WLED limits
    Full white with the limiter off drew about 100 W into the converter
    (about 16.5-18 A at 5 V, 15.5-17 mA per LED). The converter is rated
    100 W (20 A), not 50 W. WLED on the shark now estimates 17 mA per LED
    with a 17000 mA limit (full white at ~95%). The earlier brownouts were a
    weak USB-PD source, not the 5 A trigger: a 100 W PD V-mount battery runs
    full white fine; match the limit to the source. power.md updated for the
    100 W load: dock worst case ~160 W, runtimes, BMS margin, charge cap.
2026-10-02 Docs: fin hinge range and angle sensor choice
    The fins swing about 180 degrees about a tilted hinge and may reach below
    the 2D grid; AS5600 vs MT6701 for sensing the hinge angle, mounting and
    calibration notes.
2026-10-22 Protocol: battery message and power limit, fin hinge angles
    - NL_MSG_BATTERY: pack voltage (and current) at the pole base.
    - nl_power_limit_ma / nl_power_limiter_*: WLED's current limit for a pack
    reading, the most power that keeps the 5 V converter's input above a floor
    after the pack's sag and the pole wiring's drop; down at once, up at 2 A/s,
    holds without readings. Host tests.
    - NL_MSG_FIN_POSE and NL_ROLE_FINS: each fin's calibrated hinge angle
    (+90 deg at the up limit, -90 at the down limit) and raw sensor reading.
2026-10-22 WLED usermod: battery-aware current limit, fin angles
    - The global current limit follows the pack voltage from the base
    (NL_MSG_BATTERY), ceiling power_max_ma (17000); until a reading arrives it
    holds the ceiling. Test readings over JSON. Bench-tested logic.
    - Shows the fins' hinge angles (NL_MSG_FIN_POSE) on the Info page and sends
    them to the simulator with the mirror state.
    - Installed on the shark's controller 2026-10-21 (backup in wled/backup/,
    local); it hears the fin sensor node.
    - power.md: the dynamic limit is the plan for now; the 9-36 V converter is a
    later improvement.
2026-10-22 Fin sensor node firmware (first prototype)
    ESP-IDF firmware for a Waveshare ESP32-S3-AMOLED-1.91 reading an MT6701
    magnetic angle sensor on its analog output (the breakout's I2C doesn't
    answer). Averages and smooths the reading, maps it to the calibrated hinge
    angle (cal up / cal down / side port|starboard over USB serial, stored in
    NVS), follows WLED's radio channel and broadcasts NL_MSG_FIN_POSE at 50 Hz.
    Tested with the port fin: limits at raw 1651 and 2992, about +-0.3 deg of
    jitter; WLED shows the angle.
2026-10-22 Sim server: drop dead page connections; new bench board address
    Writing to closed connections made asyncio log a warning on every frame
    (about 150 GB of log over 5 days); dead connections are now dropped, more
    error types are caught, and slow pages skip frames instead of queueing. The
    bench WLED is now a different board at 10.7.200.154.
2026-10-22 Sim: fins swing about their real hinges, following the live fin sensor
    make_layout.py writes each fin's hinge line (the FinMount axis) and modelled
    angle (about -34 deg on the calibrated scale: +90 up, -90 down) into the
    layout. The page turns a fin's LEDs, tube outline and (WebGL) mesh parts
    about it: Port fin / Starboard fin sliders, or, in live mode, the real fin's
    angle from the fin sensor node via the controller's mirror.
2026-10-22 2D: fins follow their real angle
    make_ledmap.py adds the fins' geometry to ledmap.json ("fingeo": rest
    positions, hinge lines, modelled angle, the grid's scale) and six empty rows
    at the bottom (70 x 41) so a fin swung straight down stays on the grid;
    existing cells are unchanged. The usermod turns a fin with a live angle
    about its hinge and gives each of its LEDs the side view's colour at the
    spot it is over (gathered before the partner copies, written after them).
    On the shark's controller: 112 of 114 port fin LEDs showed exactly the
    colour of the cell they were over.
2026-10-22 Fin following: read empty cells directly (they came out black)
    Most matrix cells have no LED of their own, and getPixelColor() returns
    black for those, so fin LEDs over such cells went dark (47 of 114 under a
    solid colour). Read the cell with getPixelColorNoMap() instead: 0 dark on
    the shark's controller. The earlier check only compared cells that have an
    LED, which is why it missed this.
2026-10-22 Fin sweep test: the controller swings a fin through its range on request
    The usermod takes {"nibbles":{"finsweep":{"port":period_s,"starboard":
    period_s,"s":seconds}}} and, until it runs out, swings that fin's angle
    through -90..+90 deg (a sine) in place of the sensor; the fin LEDs follow
    and the mirror state reports the angle. The simulator has a sweep speed
    slider per fin (swings a minute): with the live shark it drives the
    controller's sweep, otherwise it animates the fin. On the shark: a 4 s
    sweep covered -90..+90 on time.
2026-10-22 FINS switch: turn fin following on/off from the base station
    - Protocol: NL_OP_FIN_FOLLOW (WLED; 0 off, 1 on, 2 toggle) and
    NL_MSG_FIN_STATE (WLED -> radio, 2 Hz: on/off, the angle in use per fin
    and its source: sensor, sweep, or locked at the modelled angle).
    - Usermod: with following off the fins stay at their modelled angle,
    ignoring the sensor and sweeps; saved in the config; also over JSON.
    - Base: a FINS switch on the preset page (follows WLED's state) with the
    angles in use underneath; "fins on|off|toggle" on the serial port.
    - Simulator: shows the fins locked when following is off.
    On the shark: off/on/toggle acked in 9-34 ms and took effect each time.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
2026-10-24 Stream stall counter, ES7210 mic for the 3.49 WLED, main/display test
    - shared: NL_MSG_WLED_STREAM and nl_stream_gaps (slow >= 50 ms and stalls
    >= 100 ms between streamed packets over the last minute; restarts of 2 s
    or more not counted), with host tests.
    - usermod: times the gaps while WLED shows a realtime stream; Info page line
    and a 1 Hz broadcast. NIBBLES_ES7210 sets up the 3.49 board's ES7210 mic
    over I2C for AudioReactive ("Generic I2S with MCLK"); that build also sets
    I2S_USE_RIGHT_CHANNEL so AudioReactive reads the mic's channel on the S3.
    - base: the WLED card shows "Streamed", the source and stalls per minute.
    - platformio: nibbles_shark_eth (Ethernet build, not installe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
2026-10-26 Pole-base power and charger boards (KiCad), plan B, power doc updates
    Two boards generated from one design description (tools/hardware):
    - Power board (hardware/power_board, 2 layers): LEMO input with an ideal
    diode right after it (no backfeed to the dock), dock and pack OR diodes,
    eFuse with the bulk caps behind it (gentle hot plugging), INA226, 5 V buck
    from the light bus, TCA9534, dock LED header, charger port (2x XT30 +
    JST-GH 6 I2C) and keypad port (same I2C pinout).
    - Charger board (hardware/charger_board, 4 layers): BQ25798 placed after
    its datasheet layout, 2 A input limit at power-up (ILIM_HIZ divider) to
    stay under a VB99 D-Tap's 10 A.
    Both as KiCad projects (roughly pl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
2026-10-26 Power board: one-sheet schematic drawn as wired blocks, net classes, layout in progress
    - KiCad schematic merged into one page; the ideal diodes (U9/Q9, U3/Q5,
    U4/Q6), the eFuse path (U5, bulk caps, shunt R29 and INA226, J3/F1, J5)
    and the 5 V buck (U7) are now wired pin to pin instead of label to
    label. Same netlist; ITIMER, ILIM, IMON and RETRY_DLY now use KiCad's
    automatic net names (renamed to match in the board).
    - The KiCad files are now the master copy for the power board; the
    generator refuses a board with tracks.
    - Net classes for both boards (Power 5 mm / 3 mm, Supply 1 mm) and
    pre-defined track and via sizes in the generator.
    - Placement, routing and pours on the power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
2026-10-26 Combined power + charger project, charger schematic wired, 30 mm charger board
    - hardware/power_charger_board: a copy of the power board with the charger
    added, for laying both out as one board. One schematic sheet (charger as
    section 4), charger parts on their own 22 x 30 mm outline beside the
    power board, the XT30s that linked the boards (J10, J11, J21, J22)
    removed, 4 copper layers, a Charger net class (3 mm) on PMID, SYS, SW1
    and SW2.
    - Charger schematic (standalone and combined) redrawn with the parts wired
    to the BQ25798's pins; short two-pin nets now use KiCad's automatic
    names, renamed to match in the boards.
    - Standalone charger board: 54 x 30 mm outline for the narrow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
2026-10-28 Power + charger board: KXUSBC2 charger layout, test points, J6 fix, layout routed
    - Charger section copied from KXUSBC2's BQ25792 layout (placement, tracks,
    vias, zones), KX-only parts dropped; R10-R13/C28 to 0402; dock input
    snubber R39/C49/C50; minimums relaxed to JLCPCB/KX values
    - J6 footprint corrected (board top faces the 3.49's battery side, screen
    up), its holes on User.Drawings, 3D model 11 mm up; D5 to A11 and
    DOCK_DET to A6, R3 to B6
    - Connectors all vertical JST-GH; J12/J23 removed; J10 (GH8 cable to the
    3.49) and J11 (second I2C port) added; H1-H3 M2.5 holes; connector
    labels and board name
    - Test points TP3-TP24 on the bottom; CHG_ILIM and EFUSE_IMON named
    - Schemat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
2026-10-28 Power + charger board: review fixes and more routing
    - Mechanical fixes from the layout review: Solid zone connections on the
    pack XT30, F1 and the eFuse input pins and on starved ground pads;
    ground vias for floating ground pads; test pads moved off other nets
    and wired; ground vias nudged clear; dangling stubs removed
    - Further routing by hand in KiCad
    Claude-Session: https://claude.ai/code/session_01UUhpevE9ZSCJvyu3edQmf9
2026-10-28 Power + charger board: routing finished, DRC clean (silkscreen aside)
    - Ground vias, PACK_F pours and vias, LIGHT_BUS and DOCK_VIN pours on In2,
    charger feed, test points wired (by hand in KiCad)
    - Review fixes: vias slid off other nets' copper, PACK_F vias on the CE
    track replaced with clear ones, stray stitching vias dropped, +5V into
    D5 widened to 0.8 mm, STAT track clear of C11
    - ERC clean, schematic parity 0, DRC 0 errors besides silkscreen, 0 unrouted
    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
2026-10-28 Power + charger board: silkscreen laid out, shark LED outline logo
    - Silkscreen: every reference beside its own part (1.0 mm, 0.8 mm where
    tight), clear of pads, other silk, the edge and part bodies; XT30
    references and job labels on the bottom by their pins; the 31 dense
    0402/0603 parts that have no room keep their references on Fab only
    - Logo: the shark's blue LED tube traced from a side render of the totem
    model, with the eye; nibbles:Nibbles_Shark_Logo_12mm/15mm/20mm
    footprints (filled F.Silkscreen polygons, board-only) and SVG/PNG in
    logo/; the 12 mm one placed on the board
    Claude-Session: https://claude.ai/code/sessi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
2026-10-28 Power + charger board: 20 mm shark logo on the bottom, current eye
    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
2026-10-28 Power + charger board: JLCPCB fab files, LCSC and DigiKey orders
    - fab/export.sh: gerbers, drills, JLCPCB BOM/CPL after ERC, DRC and parity
    checks, plus LCSC and DigiKey order lists (DigiKey parts from
    digikey_map.csv; what DigiKey can't supply goes to an LCSC gaps list)
    - LCSC fields on every part, picked to be in stock at LCSC for a hand build
    - eFuse timing caps set: C35 ITIMER 22n, C36 RETRY_DLY 22n, C37 dVdt 47n;
    R27 IMON 1k
    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
2026-10-28 Keypad boards: key column, upper keypad and hub (placed, not routed)
    Generated by tools/hardware/make_keypad_kicad.py with KiCad's own symbols
    and footprints (plus a hotswap socket footprint):
    - key_column: 8 Kailh Box (MX pin) keys in hotswap sockets, 16 mm pitch,
    SK6812MINI-E under each, TCA9534A at 0x38-0x3F, one JST-GH 8
    - key_upper: the same with 3 keys
    - key_hub: power board keypad port + GPIO 43 LED data in, 5 V data
    buffer, 4 ports with skip jumpers
    ERC clean, schematic and board match.
    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
2026-10-28 Base: keypad logic (Live / Standby) and power arithmetic, with host tests
    controls.c: targets (ALL/BODY/EYES/FINS, tap latches, hold is momentary),
    number keys stage presets in Standby (two pages), TAKE swaps Standby and
    Live (held: shows Standby as bumps until released), SHIFT + number bumps,
    FLASH/BLACKOUT, PAGE + number sets brightness, FIN SENSOR, lock on a held
    UNLOCK, and each key's LED colour. power_math.c: pack percentage, runtime,
    INA226 and BQ25798 conversions. make -C firmware/base/test/host.
    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
2026-10-28 Base v2: power board drivers, keypads, Live / Standby, portrait main screen
    - power.c: BQ25798 (set up and read back; charging off if the settings
    don't stick), INA226 on the lights, TCA9534 (LIGHT_OFF, PACK_OFF only
    while docked, EFUSE_PG), dock detect; pack %, runtime; NL_MSG_BATTERY to
    WLED from real readings only. "sim on" makes up readings for the screen.
    - keypad.c: TCA9534A key boards at 0x38-0x3F, debounced, re-found when
    plugged in; SK6812 key LEDs on GPIO 43 (KEYPAD_BOARDS in config.h).
    - main.c: keys drive controls.c; bumps get a slot per receiver so the eyes
    and WLED can preview different presets at once; serial key/sim/power/
    lights commands.
    - display.c: new main pa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
2026-10-28 Base: PCF8574 modules as keypad boards, for a breadboard prototype
    KEYPAD_BOARDS entries name their chip. A PCF8574 has no registers: it's
    read with a plain one-byte read (the TCA9534's register write would drive
    its pins low) and has no LEDs on the chain. A prototype at 0x27 is listed.
    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
2026-10-28 Simulator: the base station's keypad and screen, driving WLED and the eyes
    A BASE STATION card: the keypad (numbers, functions, the pole's upper keys;
    click or computer keyboard, held like the real keys) with each key's LED, and
    the base's main screen. The keys run through the base firmware's own
    controls.c, built by server.py with the computer's C compiler and called
    through ctypes (no Emscripten needed). Presets, brightness and fin following
    go to the WLED card's address over its JSON API, the eyes' to the simulated
    eyes; WLED bumps are imitated over JSON. Tested against the bench simulator
    WLED: TAKE, TAKE back, held preview, SHIFT bumps, FLASH, PAGE brightness.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
2026-10-28 Base keypad: everything is a bump until it's latched; SHIFT becomes LATCH
    Holding a number shows that preset on the target and goes back on release;
    tapping LATCH while it's held keeps it (commands, then the bumps let go;
    the old Live drops into Standby). TAKE is the same: Standby while held,
    LATCH while holding keeps the swap. LATCH held first, then a number, cues a
    preset in Standby unseen; LATCH + TAKE copies Live to Standby. Host tests
    rewritten for it; the simulator's keypad follows (Shift or L for LATCH),
    tested against the bench WLED; flashed to the base prototype.
    Claude-Session: https://claude.ai/code/session_01UUhpevE9ZSCJvyu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
2026-10-28 Fin presets: the fins' own WLED segment, side or top projection, FINS on the keypad
    - make_ledmap.py: a 25 x 34 fin panel (10 mm cells) right of the side view;
    "finpanel" gives the usermod both projections (side, top). ledmap.json
    regenerated (95 x 41).
    - shared: NL_FIN_PRESET_BASE (fin preset n = WLED preset 100 + n, 100 =
    follow the body), NL_TARGET_FINS bumps, fin_preset and fin_proj in
    NL_MSG_FIN_STATE (9 bytes; only the base reads it). WLED telemetry is
    unchanged, so the eyes need no update.
    - usermod: while a segment is on in the panel, fin LEDs show the panel at
    their hinge-angle position (side or top, {"nibbles":{"finproj":..}} in
    the fin preset); body and fin presets t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
2026-10-28 Eye settings in WLED presets: picks (level 1) and whole eye looks (level 2)
    - shared: NL_MSG_EYE_LOOK with nl_eye_look_t (every eye preset setting,
    108 bytes); NL_PRESET_NO_EYES for body-only preset commands.
    - eyes: two look slots after the 18 built-in presets (indices 18, 19,
    alternating, so a new look is an index change the port eye already
    follows); the leader takes looks from the radio, blinks to them and passes
    them over the cable (again every 2 s); spirals snap to a built-in spiral
    map. Host tests for the look slots; `make -C test/host looks` prints the
    built-in presets as look JSON. Builds; not yet run on the eyes.
    - usermod: a preset's "nibbles":{"eyes":{...}} goes to th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
2026-10-29 Fin presets tested on the bench: moved to 80-96, fin preset tracking fixed
    - NL_FIN_PRESET_BASE 100 -> 80 (fin presets 81-96, 80 = follow the body):
    the shark's own presets use 115.
    - usermod: record the fins' preset when a fin preset command is accepted and
    when a fin bump hands back (re-applying the preset under the bump didn't
    change currentPreset, so it was lost); debug lines for fin bumps, the
    preset queue and eye settings.
    - Tested on the bench 3.49 (WLED 16 main board, new 95 x 41 map, presets
    80-82): side and top projections behave as designed; from the base
    keypad over the radio: fin bumps, LATCH, TAKE previews and swaps, ALL.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
2026-10-29 Usermod: the last preset's eye settings on WLED's Info page; tested on the bench
    "Nibbles eye settings" on the Info page says what the last preset did with
    its eye settings (look sent, commands, or skipped as body only). Tested on
    the bench 3.49 with a preset carrying the Inferno look: applied from WLED
    and with ALL + number the look goes out; BODY + number and bump presets skip
    it. (The note can show the previous preset's number for presets applied
    from WLED's UI: WLED updates currentPreset after the usermod reads them.)
    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
2026-10-29 Simulator: fin preset picker, eye settings from presets, eye looks in the sim eyes (source)
    - WLED card: a fin preset picker (80-96) with the projection in use.
    - A body preset picked on the WLED card, or applied by the base card's ALL
    + number, sends its "nibbles":{"eyes":{...}} to the simulated eyes, as the
    usermod does on the shark.
    - eyes_wasm.c: eyes_look() takes a packed look into the eyes' look slots
    like the leader eye; preset indices past the built-ins accepted. Checked
    by compiling natively; sim.wasm is NOT rebuilt (needs Emscripten), and the
    page skips looks until it is.
    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
2026-10-29 Main board / display: the brain renders and owns the radio, the controller displays
    - usermod: a "display" setting for the controller of a main board /
    display pair: it only takes the base's battery readings (its current
    limit protects the LEDs it drives) and reports the stream; no anchoring,
    telemetry, commands or bumps, so the base, eyes and fin node see only the
    main board, which runs everything else (fin presets, eye looks, bumps).
    - base: the WLED card keeps the main board's preset while the display
    reports a stream; the stream's stalls go on its second line.
    - Set up and tested: the bench 3.49 as main board (usermod on, 95 x 41
    map, DDP to 4.3.2.1) and the controller update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
2026-10-29 Simulator drives the real base over USB from the computer's keyboard
    - server.py: a "realbase" mode: the page's keys go to the base prototype's
    serial console (found by its USB serial number, or --base), it reports
    its key LEDs ("leds on") and a screenshot about once a second; standard
    library only (termios).
    - page: "Keys drive: the real base, on USB" on the base card shows the
    base's own screen and LED colours while the keys drive it.
    - base: "leds on|off" prints the key LED colours when they change.
    Tested: number pad BODY + hold 5 / 3 bumped the main board's preset over
    the radio and released back.
    Claude-Session: https://c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
2026-10-29 Simulator: the real base's screen keeps updating
    A screenshot cut short (a log line landing on its last line) left the
    server waiting for it forever, so the page showed a stale screen. It now
    gives up on one after 4 s and asks again, drops screenshots that arrive
    incomplete, and handles "SHOT failed".
    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
2026-10-29 Real base from the simulator: keys don't wait, Live follows LATCH
    - usermod: record the body preset as soon as a preset command is accepted,
    also when it comes during a bump: LATCH while holding a number re-applies
    the preset the bump already shows, which doesn't change currentPreset,
    so the telemetry (and the base's Live) kept the old preset.
    - base: screenshots print from their own task, so keys typed meanwhile are
    read at once instead of after ~300 KB of base64 (they came in bursts,
    LATCH landing in the same instant as the number's release); "shot rle"
    sends them run-length encoded, a few KB.
    - simulator: asks for "shot rle" every second and just after each key,
    decodes it;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
2026-10-29 Fin presets keep their palettes: map one fin panel cell to a real LED
    WLED works out a segment's capabilities from the LEDs under it. The fin
    panel had no LEDs mapped, so the fin segment was on/off only: palettes
    ignored ("lc":0, palette stuck at 0) and palette effects such as Plasma
    black on the fins. make_ledmap.py now maps the panel's first cell to the
    LED whose own cell is last (LED 866, cell 3278); WLED writes cells to LEDs
    in order, so that LED still shows its own cell. Tested on the brain: fin
    presets 81 and 82 keep palettes 8 and 9 and light the fins after body
    presets 3, 4, 5, 7 and 230.
    Claude-Session: https://claude.ai/code/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
2026-10-29 Base: the power card becomes a phone-style status bar
    The top of the main screen is now a power status bar: where the power comes
    from on the left, the charge and a battery icon on the right (filled to the
    charge, coloured by level, a bolt while charging), and the other readings
    in 12 px lines below (charging or time left, pack volts and amps, lights'
    watts and amps, temperatures or the worst problem in red). It's 88 px
    instead of 168; LIVE, STANDBY and the target box move up. Montserrat 12 is
    added. The simulator's copy of the screen matches.
    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
2026-10-29 Base status bar: an iOS-style battery, and the LEMO input's voltage
    - The battery icon follows iOS: a thin translucent outline with round
    corners and a small cap, the fill inset, white normally, iOS green with a
    bolt while charging, iOS red at 20 % or less; the percentage stays white.
    - A new line shows the LEMO input (the external battery, or the dock) as
    the charger measures it: "In 16.60 V 2.0 A", or "nothing connected".
    The bar is 15 px taller; the panels below move down by as much.
    The simulator's copy of the screen matches.
    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
2026-10-29 Base status bar: a second battery for the LEMO input
    The DOCK / BATTERY label gives way to the LEMO input, told apart by its
    voltage (input_kind, host-tested): up to 17.5 V an external 4S battery,
    shown as an iOS-style battery with its charge (the same 4S curve on VBUS
    and IBUS); above it a USB-C PD supply (20 V trigger board), shown as the
    USB symbol and its voltage; nothing connected, a dim empty outline. The
    internal pack keeps the right-hand battery. "SIM:" now starts the first
    line for made-up readings, and "sim on" alternates an external battery and
    a USB-C supply. The simulator's base card gets a LEMO input choice and an
    external battery slider.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
2026-10-29 Base status bar: time left as hhHmmM, the top row in the small font
    - The time left on the pack reads hhHmmM with leading zeros (00H00M up to
    99H59M), with no other words.
    - The batteries' percentages and the USB supply's voltage use the same
    12 px font as the lines below.
    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
2026-10-29 Base status bar: the flow line, LEMO and lights readings, fixed-width digits
    - A 2 px flow line under the batteries: the LEMO's current, green for the
    charger's share (to the pack), blue for the light bus's; grey and
    pulsing when the pack is starved (plugged in and not full, but charging
    under 100 mA, or the LEMO so far below the pack that the pack feeds the
    lights); dim grey with nothing plugged in.
    - Row 2: the LEMO's ##.#V #.#A on the left, the lights' ##W #.#A on the
    right; the In and Lights lines go.
    - power_flow() (host-tested) works out the LEMO's and the pack's whole
    currents: the light bus bypasses the charger, so IBUS and IBAT alone
    miss the lights. The Pack line and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
2026-10-29 Base status bar: time left in row 2, temperatures and pack voltage in row 3
    - Row 2 left: with nothing on the LEMO, the time left on the pack
    (hhHmmM) replaces the LEMO's volts and amps. Row 2 right: the lights'
    amps first, then watts.
    - Row 3: the cells' and charger's temperatures (##°C / ##°C) left, the
    pack's voltage (##.##V, grey) right. Temperatures turn orange near their
    limit and bold red past it: cells 45 / 55 °C (and below 5 °C / at 0 °C),
    charger die 85 / 105 °C (cell_temp_level, die_temp_level, host-tested).
    - Below: one status line (charging, pack starved, pack full, or on the
    pack what it gives) and a red line only for problems.
    - sim on sweeps both temperature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
2026-10-29 Base status bar: three rows only; problems take row 3's place
    - The status and problem lines go; the power card is just its three rows
    (62 px instead of 94), and LIVE, STANDBY and the rest move up 30 px.
    - A problem (power board not found, charger not set up, lights switched
    off, eFuse tripped, charger fault, cells too hot or cold to charge) now
    replaces row 3 with its message in red, and the card gets a red border.
    Made-up readings (sim on) give the card a thin magenta border instead of
    the "SIM:" text.
    - With nothing on the LEMO, its battery shows as a dim outline with no
    "--" beside it.
    The simulator's copy of the screen matches.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
2026-10-30 Pole notes: K-Tek K-123 and the modified KFT foot, with STEP exports
    docs/pole.md has the dimensions measured from the Fusion 360 exports:
    section diameters, the 551 mm bottom section, the KFT's slot and the cut
    halves with their tapped holes.
    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
2026-10-30 Upper keypad board laid out and routed
    The user's layout and routing, with review fixes: the KEY1 hop via moved
    clear of KEY2 and KEY5, stray stubs removed, J1's ground pin given its own
    via, +3V3 necked past the SDA pin, and the silkscreen tidied. DRC is clean
    apart from the hotswap socket outlines over their holes. The LED window is
    opposite the switch's metal pins, which matches the footprints.
    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
2026-10-30 Keypad boards: JLCPCB export script, files for the upper keypad
    hardware/keypad/fab/export.sh <board> checks ERC and DRC, then writes the
    Gerbers and drills, the JLCPCB BOM and CPL, and an LCSC order list. The
    switch lines are named as the hotswap sockets they really are, on the back.
    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
2026-10-30 WLED benchmarks: every effect's cost and spin-up, and segment layer costs
    Measured on the bench brain with the frame cap lifted: wled/bench/effects.csv
    (cost tier and spin-up from black for all 220 effects), layers.jsonl (layer
    stacks, off and frozen layers, blend modes), the scripts and a README with the
    findings: a full-size layer costs about 4.7 ms to combine, a layer that's off
    still renders unless it's frozen.
    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
2026-10-30 WLED benchmarks: layer size, internal RAM and a coarser 60x28 grid
    Layer cost scales with the cells it covers (about 1.1 us per cell); moving
    the pixel buffers to internal RAM changed nothing; a 60x28 ledmap roughly
    doubles the frame rate for every layer stack tested.
    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
2026-10-30 2D map: 68 x 33 grid, presets converted; benchmarks for the middle grid
    The shark's map goes from 95 x 41 (8.9 mm cells) to 68 x 33 (11.3 mm; body
    55 x 33, fin panel 13 x 18 of 20 mm), about 1.5x cheaper for every effect and
    layer. make_ledmap.py defaults to it. The brain's 2D presets were converted
    (body 0-55 x 0-33, fins 55-68 x 0-18), and one-segment body presets now also
    remove segments 2-8. wled/bench has the 68 x 33 layer and effect results, the
    three-grid comparison and the DreamState Clouds preset.
    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
2026-10-30 Usermod: segment layer slots, flash and blackout bumps in the bump slot
    Five fixed segments stacked as layers (0 body, 1 fins, 2 body+, 3 fins+,
    4 bump), set with {"nibbles":{"slot":{...}}}: a preset's look, or effect,
    palette and colours directly, plus blend mode, opacity and on/off. A slot
    that's off is frozen unless asked to stay warm; missing slots below are
    created off so slot n stays segment n. The state and Info page report them.
    Flash and blackout bumps now switch the bump slot on and off instead of
    saving and restoring the whole state; a flash still lifts the master
    brightness while held. Tested on the bench brain, bumps from the real base.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
2026-10-30 Layer slots from the base: palette and layer pages, slot commands and bumps
    Protocol: NL_OP_SLOT_LOOK / NL_OP_SLOT_PALETTE, NL_BUMP_PALETTE /
    NL_BUMP_LAYER (nl_slot_arg(slot, value)), NL_MSG_WLED_LAYERS (2 Hz), layer
    looks as WLED presets 101-116. Usermod: carries them out; slot bumps
    (flash, blackout, palette, layer) store how to put their slot back exactly,
    and a slot command for a held slot becomes what it goes back to (LATCH).
    Base: PAGE cycles presets 1-8, 9-16, palettes and layers; hold bumps, LATCH
    keeps, LATCH on the live layer switches it off; the Live panel's new LOOK
    row shows the body's palette and layer. Simulator: the same pages, slot
    actions and screen. Host tests for both; te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
2026-10-30 Wire link brain -> controller, brain board env, two-brain plan
    - shared/nibbles_link: nl_pix_* chunks (256 LEDs, COBS + CRC-16) for
    sending every LED over a UART; table CRC-16 (same values, ~2x faster
    encode); host tests.
    - Usermod: wire_pin / wire_baud. The brain sends what its network LED
    output would send, every shown frame (keepalive 200 ms); the display
    receives into WLED's realtime path like DDP. Receiver empties the UART
    FIFO from 32 bytes (the default 120 lost ~1 chunk in 1500 on a bench
    loopback; 0 in 7,200 frames at 32). Sending costs 1.0 ms a frame.
    - nibbles_brain_s3 env for the Waveshare ESP32-S3-DEV-KIT-N16R8.
    - docs: two brains in the controller's box, Standby prev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
2026-10-30 Standby and TAKE for palettes and layer looks
    - Base keypad: LATCH held first, then a number on the palette or layer
    page, cues it in Standby (a layer look Standby already has is cued
    off); a new preset in Standby clears its side's cues. TAKE previews
    and takes them with Standby's presets; Standby then holds Live as it
    was. Latching a palette or look live drops the old one into Standby.
    Keys show the Standby one green, both amber. Host tests.
    - Protocol: NL_BUMP_SCENE (preset + palette + layer look in one bump,
    per side), nl_scene_arg.
    - Usermod: scene bumps for the body (saved like a preset bump, plus the
    overlay slot) and the fins (both slots captured); commands during them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
2026-10-30 Combined LCSC order for every board, with spares
    tools/hardware/combined_bom.py merges the power + charger board's BOM and
    the keypad boards' schematics, multiplies by builds (power 2, key column 4,
    upper 2, hub 2), adds spares (50% of sockets and LEDs, 30% of ICs) and
    side-entry JST-GH options, and checks LCSC stock, minimums and prices.
    Output in hardware/fab/; the README covers the side-entry GH pinout.
    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
2026-10-30 Combined parts order: 5 of every board, substitutes for three caps LCSC ran out of
    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
2026-11-01 Parts inventory, and the combined BOM as ordered from LCSC
    - hardware/inventory: every line of the 2026-11-01 LCSC order, with
    what's received, reserved for Nibbles and free for other projects.
    - hardware/fab: combined BOM refreshed against LCSC's stock that day.
    C1622 and C89632 are back to the originals; C77386 still stands in
    for C15849.
    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
2026-11-01 Preview picture on the base and a 1.91 screen, pole power switch, I2C crash fix
    - Preview stream: NL_MSG_PREVIEW (RGB332, 5 packets a frame; NL_MAX_PAYLOAD
    now 232), sent by the usermod with the preview setting or state. 12 fps with
    no frames lost once the brain holds one channel; it stays at 43 fps.
    - firmware/preview: a side view of the shark on the 1.91 AMOLED. The base's
    main page shows the same picture between the power bar and LIVE; the cards
    below move down 84 px. tools/sim/make_preview_map.py makes the LED tables.
    - Pole power: PAGE + BLACKOUT or "pole on|off" opens the lights' eFuse, only
    on a USB-C supply, and it comes back by itself when the supply goes.
    - I2C: ESP-IDF 5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
2026-11-01 Base main page: fins, padlock, charge graph; TF card data logger
    - Main page is now the power card (edge to edge, black, "???" with no power
    board) and the shark; Live, Standby and the keypad's state move to a new
    page after it.
    - Fins laid flat under the shark from the real LED positions, as a 4 px band
    with both strands side by side (fin_pos.h from make_preview_map.py), with a
    padlock between them. The band is a hidden touch key for FIN SENSOR; a card
    shows behind the fins while that key is down.
    - Charge graph at the bottom: the last hour, one pixel-wide column per 21 s,
    orange at 35% or less, red at 20% or less, at 25% opacity.
    - Data logger: one CSV row a second on the TF ca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
2026-11-01 Base logger: real time from the PCF85063, charge graph survives a restart, files over USB
    - rtc.c drives the 3.49's clock chip (GPIO 47/48, software I2C) and sets the
    system time at boot. Log rows gain a Unix time column, 0 if it isn't known.
    - At boot the last hour of the last five log files refills the charge graph;
    simulated rows and rows with no time or no reading stay out.
    - "log list", "log get N" and "time [UNIX]" over serial; tools/base_log.py sets
    the clock and fetches files, checked with a CRC.
    - The Live and Standby page shows the log's state.
    - Blanks instead of zeros in the log and graph before the first power reading.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
2026-11-01 The time over the radio: a phone sets WLED's clock, the base follows
    - NL_MSG_TIME: a main board that knows the real time broadcasts it every 10 s.
    - WLED's /time page sends a phone's time; any change in WLED's UI does too.
    - The base sets its clock from the packet if it differs by over 5 s, and refills
    the charge graph once the time is known, not only at boot.
    - Unlit and disconnected LEDs on the shark and fins share one grey.
    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
2026-11-01 Base: a build setting for simulated power data, fast or realistic
    - Kconfig "Simulated power board data": off (the default), realistic (festival
    nights in real time) or fast (every value and problem in 2 minutes).
    - A build's simulation is used as if real: logged as sim 2, and the charge graph
    refills from those rows. It still doesn't reach WLED, and three probes in a row
    answered by a real board turn it off until the next restart.
    - Serial "sim on|fast|real|off" runs the same simulators as a test (logged as
    sim 1, never in the graph). power_sim.c is host-tested.
    - The graph's refill waits for the first power status, 3 s after boot.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
2026-11-01 Base: charging gives way to the lights on a USB-C supply; base_shot retries
    The dongle's trigger board gives 5 A at 20 V. On a supply the charger's input
    limit is 5 A less a 400 mA margin less the lights' peak over 3 s, between 100 mA
    and the ILIM_HIZ pin's 2 A, re-written after a plug-in. Logged as chg_limit_ma.
    Tested in the host tests and with simulated readings, not on a real charger yet.
    base_shot.py tries again when a status line costs a line of the picture.
    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
2026-11-01 A/B handover between two brains: controller switch, Standby role, base logic
    - nl_ab_* (host-tested): the controller's switch between two wires: cut or
    crossfade on a take, Standby while TAKE is held, failover when the Live
    brain's stream stops for 500 ms. NL_MSG_AB reports it, 2 Hz and on a change.
    - Usermod: wire_pin_b on the display, ab_side on a brain. A brain not on the LEDs
    sends as NL_ROLE_WLED_STANDBY (the eyes filter it out), keeps its eye settings
    until it's taken, ignores bumps, sends the preview.
    - Base: when both are up, TAKE holds and swaps instead of bumping presets, and
    ctl_standby_sync keeps the Standby brain on Standby's scene. Panels read LIVE A
    and STANDBY B.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
2026-11-02 Two sharks on the base, audio sync to the brains, A/B on real wires
    Both brains now send the preview. The base sorts it by role: Live on the
    top shark, Standby on a second shark and fins under the eyes. The preview
    board shows Standby only.
    The controller makes its access point lwIP's default route, so AudioReactive's
    sound sync reaches the brains (controller send, brains receive).
    Docs: controller wire pins as wired (brain A GPIO 35, brain B GPIO 34), board
    MACs, A/B bench results, and the /json/cfg partial POST pitfall.
    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
2026-11-02 A/B: commands reach the controller through the brains' wires
    Each brain passes battery readings, A/B bumps and takes down its wire, between
    the picture's chunks (nl_relay_*). The base sends a take to the Live brain, then
    Standby, then the controller's radio, as "make that brain Live" so a second
    route can't undo the first. A late copy of a stopped bump no longer restarts it.
    The controller's radio_off setting ignores its radio input. First step towards
    running it with Wi-Fi off; it still sends NL_MSG_AB and hosts the network.
    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
2026-11-02 Return wire: controller GPIO 17 to both brains' GPIO 10 carries A/B state and sound
    Setting ret_pin (TX on the controller, on its first input's UART; RX on each
    brain). It carries NL_MSG_AB and NL_MSG_AR_SYNC, AudioReactive's own v2 sync
    packet built from the controller's analysis every 20 ms; a brain hands that to
    its AudioReactive over loopback UDP. Tested: both brains receive ~47 messages
    a second with 0 CRC errors, and AudioReactive reports receiving with the
    controller's Wi-Fi sync moved to an unused port.
    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
2026-11-02 Controller radio off; brain A hosts Nibbles, brain B stands in for it
    - Controller setting wifi_off: no network to join (hidden in RAM), ESP-NOW off,
    access point button-only, so the radio never starts after the boot scan.
    NL_OP_CTL_WIFI (base "wled wifi on|off", a brain's ctlwifi JSON or Info
    buttons, through a brain's wire) joins Nibbles until restart.
    - The A/B switch and the return wire run with the radio off.
    - Brains rebroadcast NL_MSG_AB from the return wire for the base.
    - Brain setting net_fallback: host Nibbles after 6 s without it, rejoin once
    the host's anchor heartbeat is back. No anchor flag while searching.
    Tested on the bench: take, hold, fade, failover with A paused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
2026-11-02 Inventory: JLCPCB boards shipped (DHL 9816452192)
    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
2026-11-02 Docs: antenna notes (3.49 IPEX via R22, patch antennas for base and brains)
    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
2026-11-02 Docs: the 3.49's U.FL socket is fitted
    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
2026-11-02 Docs: R22 identified on the real 3.49 board
    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
2026-11-02 MIDI keyboard plays the base's keys (tools/midi_keys)
    A status page in Chrome reads the MIDI keyboard (Web MIDI) and a small
    standard-library bridge writes key NAME down|up to the real base's USB
    console. Remappable keys, base found by its serial number via ioreg,
    LED colours and the base log on the page.
    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
2026-11-02 MIDI keys: drop single wild slider readings; pace sends by MIDI, not timers
    A hidden tab's slowed timers squashed a whole sweep into one late send.
    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
2026-11-03 MIDI keys: no yellow row highlight; status lines that change stay one line
    Held keys get their own fixed line instead of growing the base card, and
    the last-MIDI line is cut with an ellipsis, so playing keys no longer moves
    the page.
    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
2026-11-03 Base: firmware updates without USB (two slots, rollback, Wi-Fi, mirror cable)
    Two 6 MB app slots with rollback: a new image is kept once it has run 30 s.
    A line protocol (ota begin/data/end) works over the USB console and over a
    cable to a mirror 3.49 that runs the same firmware in 'role mirror'; the
    main board passes its own image on when the mirror's build differs. Over
    Wi-Fi the base joins a saved network on request (ota wifi on, or PAGE held
    5 s while locked) and takes a POST to /ota. tools/base_ota.py sends either.
    Tested on the base prototype: USB update, keep after 30 s, rollback on a
    reset during the trial, mirror role, the Wi-Fi key combo. Not tested: Wi-Fi
    upload on a real network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
2026-11-03 The bench 3.49 (80:45:6B:35:D0:14) is now the base
    Tools find the base by its new serial number; the first base prototype
    is a spare. The bench board's WLED flash is backed up.
    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
2026-11-03 Base keys: numbers 1-16, PALETTE/LAYER/BRIGHT modifiers, a key for everything; MIDI combinations
    Numbers 9-16 replace the 9-16 page. Held modifiers change what the numbers
    do, as hotkeys: PALETTE palettes, LAYER layer looks 1-16, BRIGHT brightness.
    Every preset, palette, layer look, brightness step and pole power also has
    a key of its own that ignores the page and the modifiers. The MIDI page maps
    rows to combinations (a MIDI key pressed while modifiers are held), in
    sections, and relabels its keyboard while a modifier is held.
    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
2026-11-03 Base: palette viewer scrolls (UP/DOWN by one, held repeats; PAGEUP/PAGEDOWN), animated; faster screen
    UP/DOWN move the palette list by one, round, and keep going while held
    (faster after 2 s); PAGEUP/PAGEDOWN (and LEFT/RIGHT) by a screenful. A
    one-row move slides: the list is one picture that flush_cb copies into each
    frame at the slide's position, ~28 frames a second.
    The screen as a whole: LVGL direct render mode (only what changed is drawn),
    frames sent straight from LVGL's buffer in alternating chunks (12 ms, was
    32), LVGL built -O2 with the C library's memcpy. Main screen ~11 -> ~20 fps.
    Claude-Session: https://claude.ai/code/ses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
2026-11-04 Keypad boards: key column and hub routed, fab files for both
    key_column takes key_upper's hand layout key by key, with the
    electronics 80 mm lower. KEY4-8 had no lanes on key_upper and only
    four fit past the socket pads on the back, so they run on the front in
    0.15 mm lanes (four squeeze between SW8's hole and D8's window), round
    the front +5V trace and back through vias under U1's KEY5-8 pins.
    key_hub (routed by hand): R1's GND pad joined to its via (the data
    line had no pull-down), C4's thermal fixed, reference labels moved
    off pads and the board edge, pours refilled.
    DRC clean on the hub; the key boards only show library silkscreen
    clipped by the mask, which the fab trims.
    Co-Authored-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
2026-11-04 Parts: solder paste ordered (Amazon), GH-2 housing sources
    NC191AX50 (Sn63/Pb37 T4) and SMDLTLFPT4 (Sn42/Bi57.6/Ag0.4 T4), one of
    each, move from the US order list to the inventory with their storage
    notes. GHR-02V-S is still out of stock at DigiKey: Mouser
    306-GHR-02V-S or LCSC C160416 instead.
2026-11-05 Antennas: pole movement barely misaligns the patches; beam of 40 degrees or more is fine
    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
2026-11-05 Antennas: generic 2.4 GHz printed Yagi as a candidate
    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
2026-11-05 Antennas: spacing two Yagis at the top; the pole is graphite, not aluminium
    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
2026-11-06 Power: internal pack likely 2x2, heat shrink size
    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
2026-11-07 Power + charger board: assembly and first power-up steps
    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
2026-11-07 Power + charger board assembly: ESD and bench supply notes
    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
2026-11-07 Power + charger board: step-by-step placement page, parts sorting, fuller assembly guide
    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
2026-11-07 Power + charger board assembly: Sopagre MN-1002 Sn63/Pb37 T4 paste
    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
2026-11-07 Placement page: map card stays put, step list scrolls on its own
    Map and buttons sit right under the step heading, details below.
    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
2026-11-07 grab_frame: still frames from the microscope camera via the capture card
    Builds with swiftc (no installs); photos go in the gitignored
    hardware/power_charger_board/photos/.
    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
2026-11-07 Placement page: board map upright, XT30 end at the top, like the microscope photos
    The map now stands vertically (KiCad's own orientation, which is how the
    board sits under the microscope), with the step details beside it; the
    bottom view is the board turned over side to side. Step labels are drawn
    after all highlight boxes so a neighbour never covers one. Also ignore
    assembly/notes/ (annotated working images).
    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
2026-11-08 Power board assembly: Chip Quik NC191AX50 datasheet reflow profile and stencil life
    Profile from the NC191AX50 datasheet (rev 1.1): soak 100-150 C, melt at
    183 C by about 150 s, peak 235 C, about 90 s above liquidus; with hot-plate
    settings for this heavy-copper board and a practice run on a spare board.
    Stencil life over 4 h at 50-70 % RH, over 8 h drier.
    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
2026-11-08 Power board assembly: I2C diode-mode check before power, J10 cable only unpowered, U8 under-body inspection
    The first board's I2C bus was held down by two bad chips (U8 shorted SDA to
    SCL, U6 leaked SCL to GND); found by removing one chip at a time.
    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
2026-11-08 Base: a power board chip or keypad board is lost only after three failed reads in a row
    One failed read used to drop the chip and blank its readings on the screen
    for 2 s; a probe that a glitch answered could invent a keypad board. Now the
    last readings stand through one or two failures, each failure is logged
    with its error, and a keypad board must answer a real read to count.
    On the first power board: about one charger read in 300 fails, all
    ESP_ERR_INVALID_STATE, never two in a row.
    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
2026-11-09 Keypads: daisy-chain boards (IN/OUT + LED buffer), new key_column_chain, key_dual (16 keys) in progress
    Each chain board has J1 in and J2 out (GH8, straight through: GND, 3V3,
    SDA, SCL, INT, 5V, LED data, unused) and its own 74AHCT1G125 buffer for
    the LED data in, so any board can be first and the hub isn't needed.
    - key_upper: chain parts added below J1, the user's routing kept (one
    LED_LAST corner moved to let LED_IN out of J1 pin 7); routed, DRC clean
    apart from silkscreen; fab files regenerated.
    - key_column_chain: a copy of key_column with the same change, routed the
    same way; fab files. key_column itself is unchanged.
    - key_dual: two columns of 8 at 16 mm, two TCA9534As, 36 x 16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
2026-11-09 Keypads: key_dual2, two key_column_chain columns side by side on one 36 x 168.2 mm board
    key_column_chain's routed board twice over: column B is the same layout
    18 mm to the right (16 mm would overlap the copper along the column
    edges), references + 100 and nets suffixed _B, GND shared. Each column
    keeps its own J1/J2 (B: J101/J102); chain A's J2 to B's J101. ERC clean,
    DRC clean apart from silkscreen, schematic and board match. Fab files.
    Generator: key_dual2 (schematic; the board is built from
    key_column_chain's) and PWR_FLAGs for label-named supplies.
    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
2026-11-09 US order list: GH 6- and 8-pin housings and pre-crimped GH wire on hand
    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
2026-11-09 US order list: GH 2-pin housings on hand
    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
2026-11-09 WLED usermod: a bump's look could stay after quick key changes (acts as if latched)
    - Preset bumps: the bump's preset could still be in the usermod's preset
    queue (or on its way: WLED applies it a loop later) when the bump ended,
    and landed over the restore. Bump presets are tagged in the queue and
    dropped at the end; one already on its way gets the restore applied
    again once it has landed (a held slot bump goes back over it).
    - Palette/layer bumps replacing one on the same slot captured the slot
    while it still showed the old bump (its restore still queued); they now
    take over that queued restore, and an apply that never showed is
    dropped.
    - A preset or scene bump replacing a s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
2026-11-09 WLED usermod: a flash or blackout could stay on after a number key took over
    Holding FLASH (or BLACKOUT), pressing a number, then letting go of FLASH and
    the number left the flash on: the flash's "off" wasn't marked as a pending
    slot restore, so the number's snapshot still held it and its release brought
    it back. It is now marked like palette and layer restores (applied before a
    preset bump saves the state), and a flash that never showed is dropped from
    the slot queue.
    Bench-tested on both brains with the new tools/bump_overlap_test.py (keys
    through the MIDI bridge, state over the brains' serial ports): 51 of 51
    overlap sequences came back to the starting state.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
2026-11-09 Radio: search together instead of anchoring channel 6; network moves and site survey in the transport
    The base's fallback anchor never left channel 6 once the brains came back
    elsewhere: every send it made reset the timer for its peeks at other
    channels. Fallback anchoring is replaced by searching together: with no
    brain heard for 12 s the base leads a sweep (0.8 s per channel, NL_HB_GROUP
    heartbeats, each move announced with NL_MSG_HOP), and the eyes and preview,
    sweeping twice as fast, catch up and move with it, so they keep talking
    while they look. Any anchor heard ends the search for the whole group.
    NL_HOP_MOVE moves the whole network to another channel at a named moment
    (sent 5 times)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
2026-11-10 Docs: shark 24-pin and LEMO wire colours, packing checklist; base: drop simulated power
    - wled/README.md: the shark's 24-pin connector pinout (8 channels of
    ground, data, +5 V; 8 wire colours repeating), which controller output
    feeds each cable channel; the LEMO cable uses the same colour order
    (hardware/power_board/README.md).
    - docs/packing-checklist.md: a first draft for the festival trip.
    - Base firmware: the simulated power board readings (power_sim.c, the
    menuconfig choice, `sim` serial commands) are gone now that the real
    power board works. The log keeps its sim column, always 0; older rows
    with made-up readings are still skipped by the charge graph.
    - CLAUDE.md: the base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
2026-11-10 Brains: wire link TX moves to GPIO 13, return wire to GPIO 14 (docs)
    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
2026-11-10 Brains renamed: brain A is the Right Brain, brain B the Left Brain
    Docs, comments, the brains' and controller's Info page, the base's
    LIVE R / STANDBY L panels and its ab log line. Settings and protocol names
    (ab_side 0/1, wire_pin_b, NL_OP_AB_TAKE_A/_B) are unchanged.
    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
